Gekkio/gb-schematics/AGS-CPU-11/AGS-CPU-11.jpg

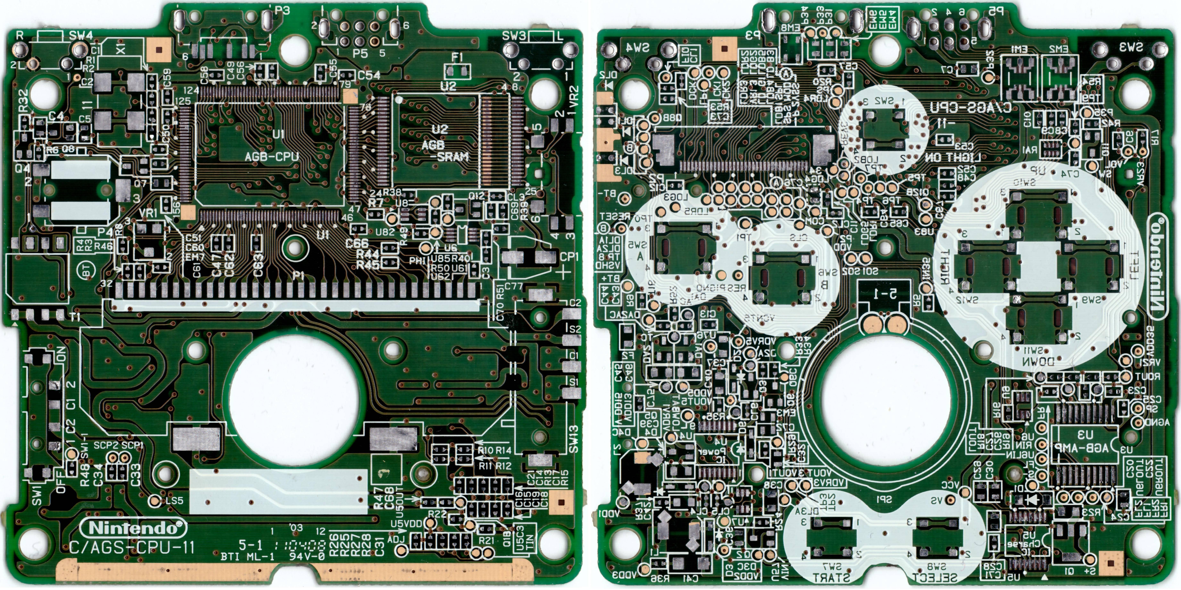
AGS-CPU-11/AGS-CPU-11.jpg
