Gekkio/gb-schematics/DC-CONV-DMG-AB.png

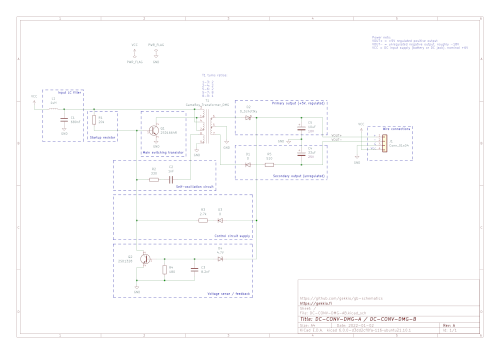
DC-CONV-DMG-AB.png
