Gekkio/gb-schematics/DMG-CPU-06/DMG-CPU-06.jpg

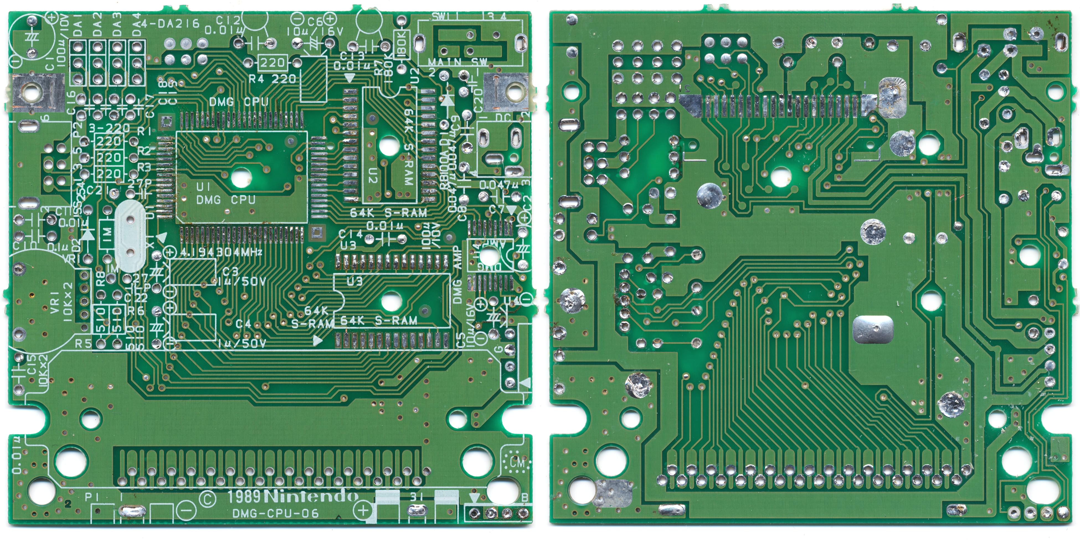
DMG-CPU-06/DMG-CPU-06.jpg
