Gekkio/gb-schematics/DMG-JACK/DMG-JACK-01.jpg

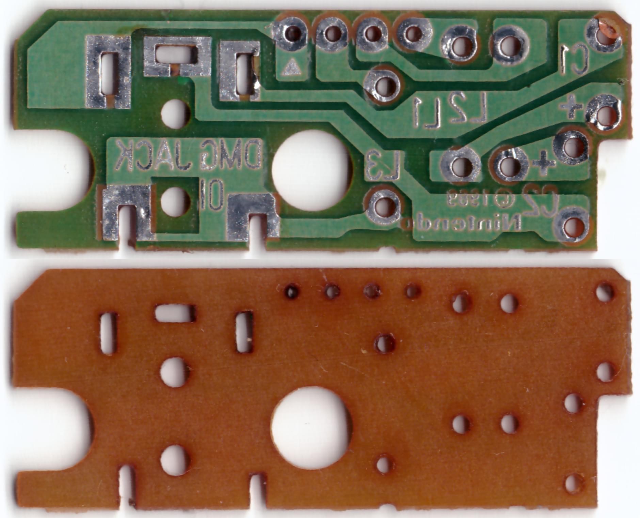
DMG-JACK/DMG-JACK-01.jpg
