Gekkio/gb-schematics/DMG-JACK/DMG-JACK-02.jpg

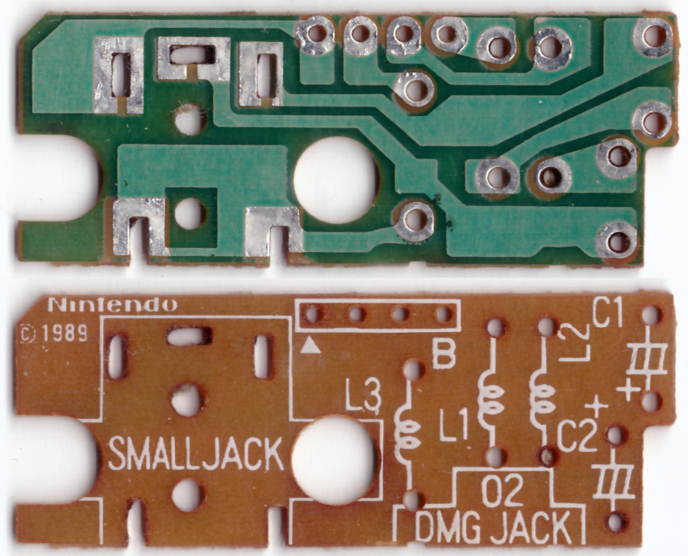
DMG-JACK/DMG-JACK-02.jpg
