Gekkio/gb-schematics/DMG-QLA-01/DMG-QLA-01.back.jpg

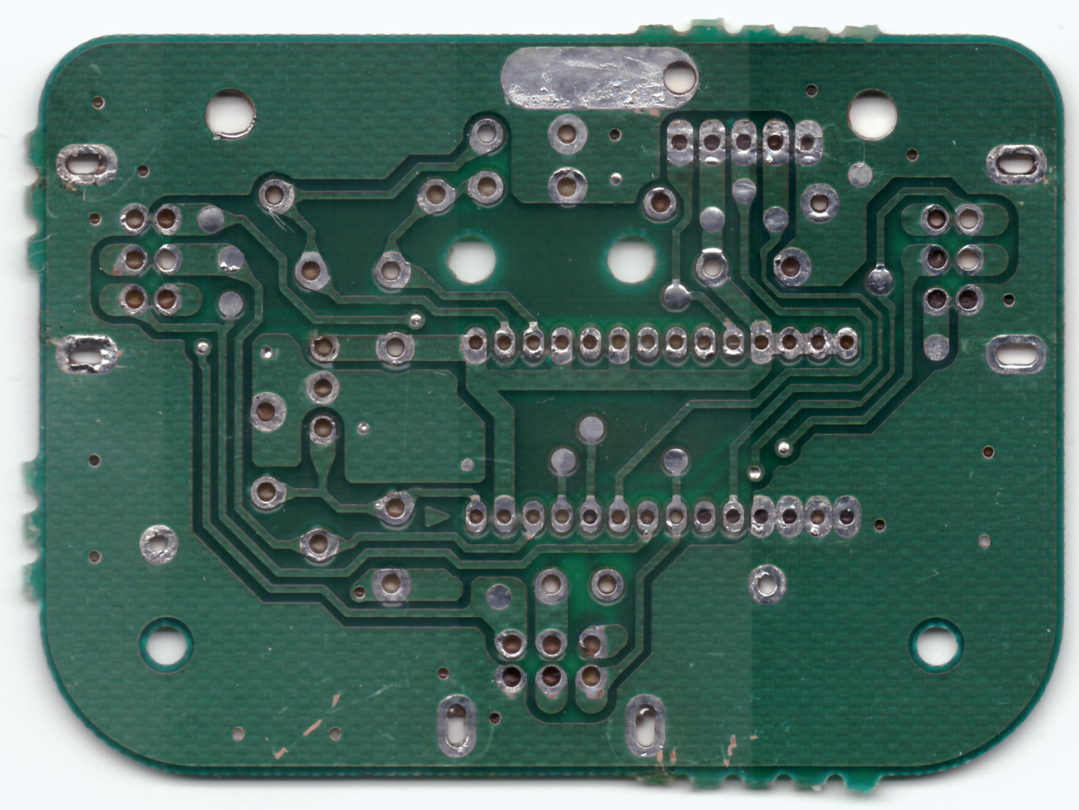
DMG-QLA-01/DMG-QLA-01.back.jpg
