Gekkio/gb-schematics/DMG-QLA-01/DMG-QLA-01.front.jpg

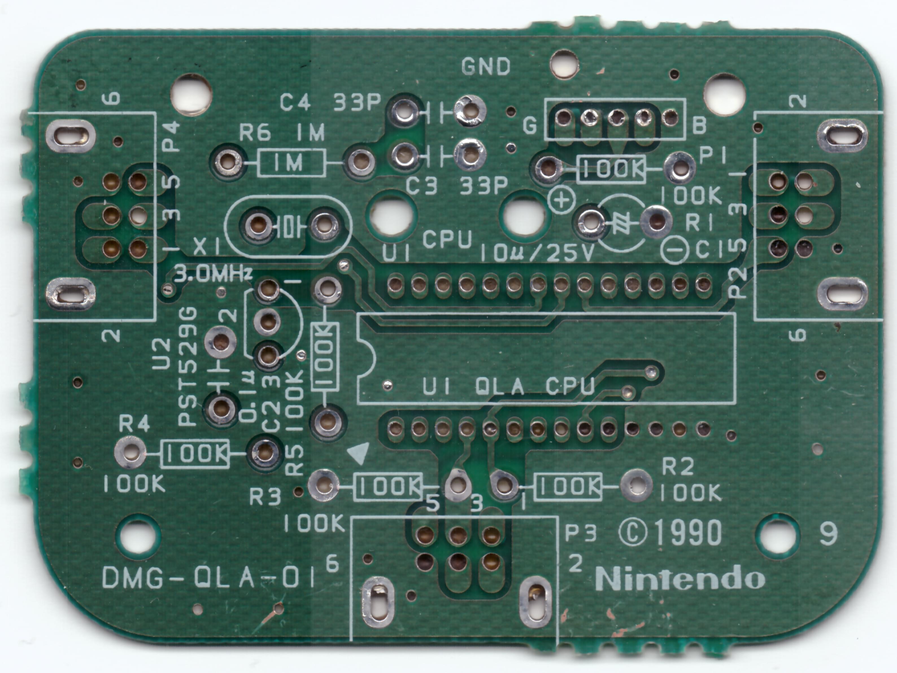
DMG-QLA-01/DMG-QLA-01.front.jpg
