Gekkio/gb-schematics/LSEP01088A1/LSEP01088A1.back_copper.jpg

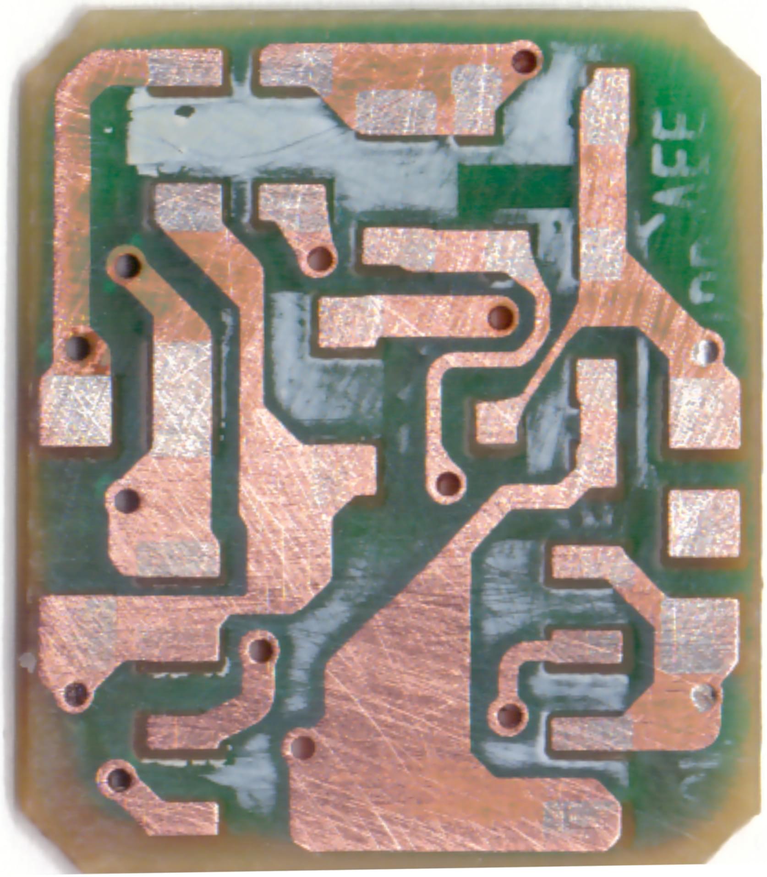
LSEP01088A1/LSEP01088A1.back_copper.jpg
