Gekkio/gb-schematics/LSEP01088A1/LSEP01088A1.front.jpg

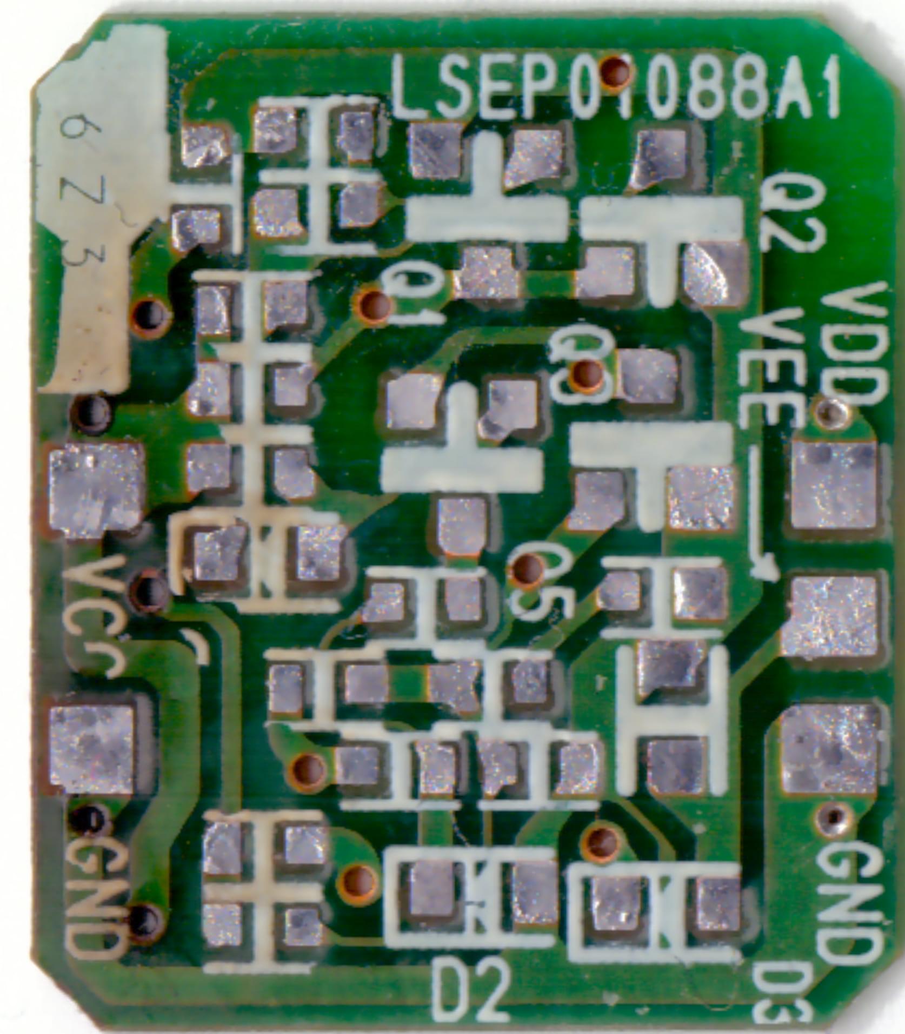
LSEP01088A1/LSEP01088A1.front.jpg
