Gekkio/gb-schematics/LSEP01120A1/LSEP01120A1.back.jpg

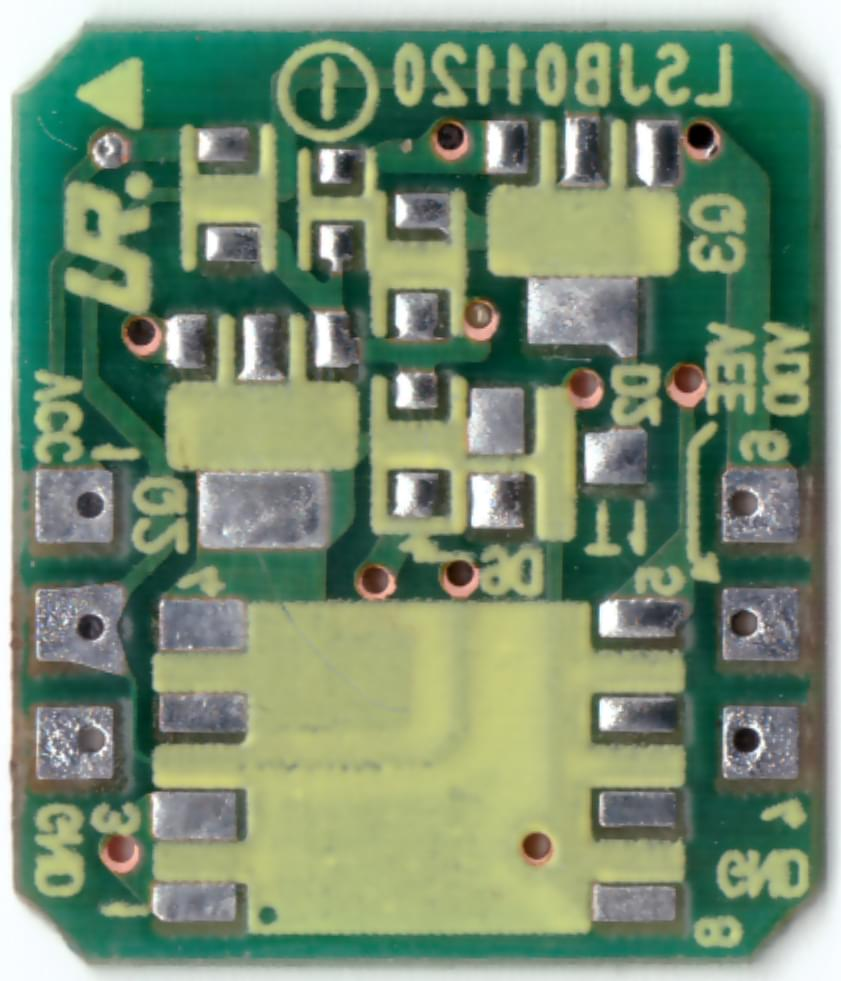
LSEP01120A1/LSEP01120A1.back.jpg
