Gekkio/gb-schematics/LSEP01120A1/LSEP01120A1.back_copper.jpg

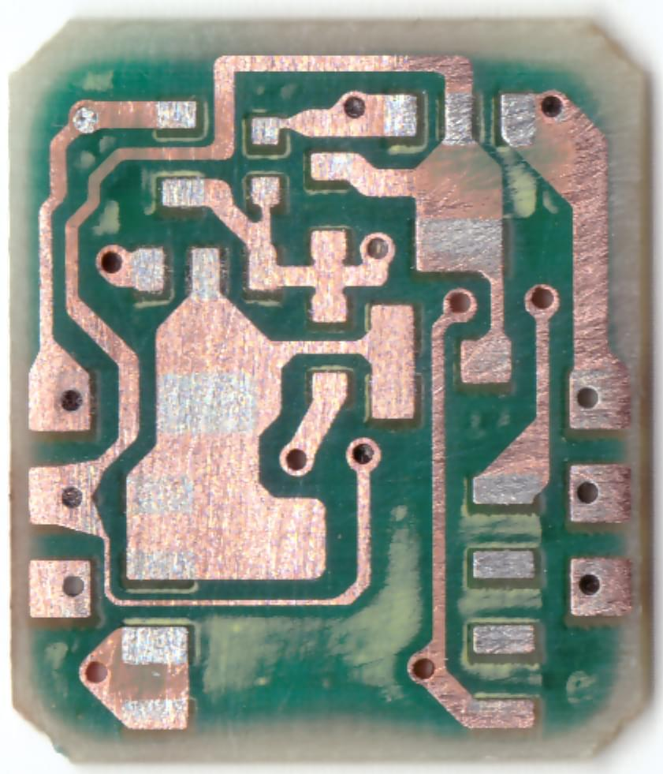
LSEP01120A1/LSEP01120A1.back_copper.jpg
