Gekkio/gb-schematics/LSEP01120A1/LSEP01120A1.front.jpg

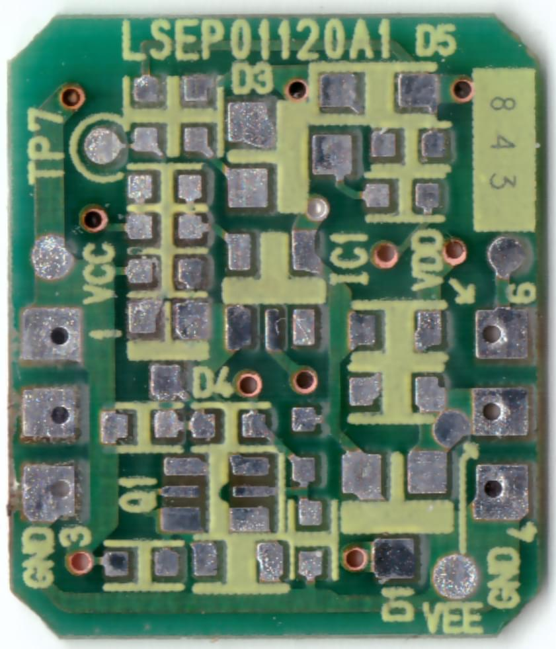
LSEP01120A1/LSEP01120A1.front.jpg
