Gekkio/gb-schematics/LSEP01120A1/LSEP01120A1.front_copper.jpg

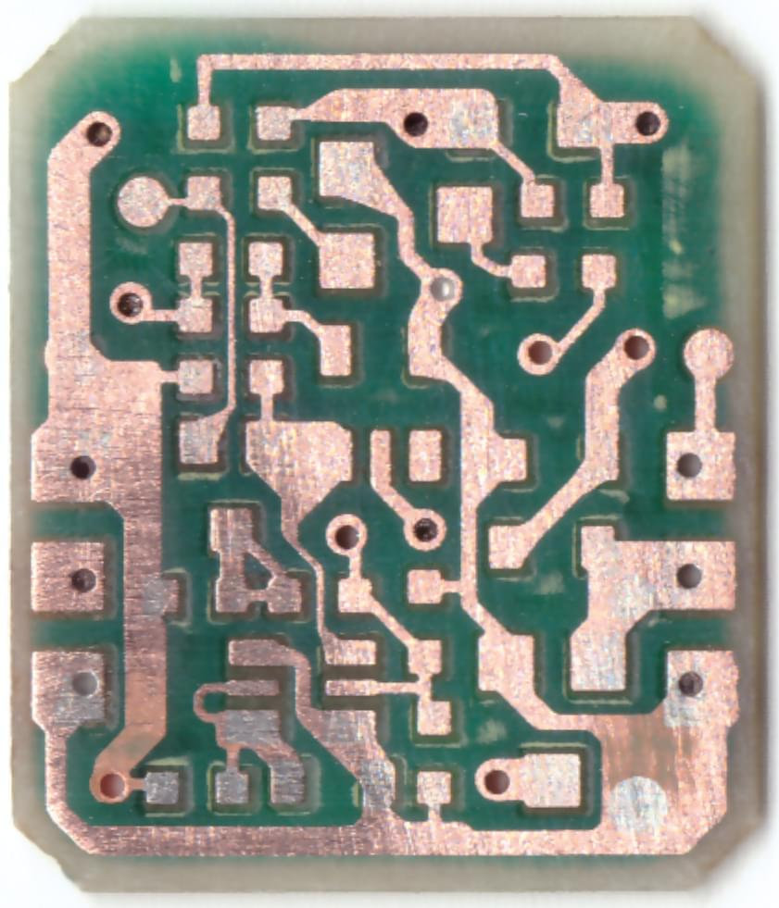
LSEP01120A1/LSEP01120A1.front_copper.jpg
