Gekkio/gb-schematics/MGB-DCDC-B/MGB-DCDC-B.back.jpg

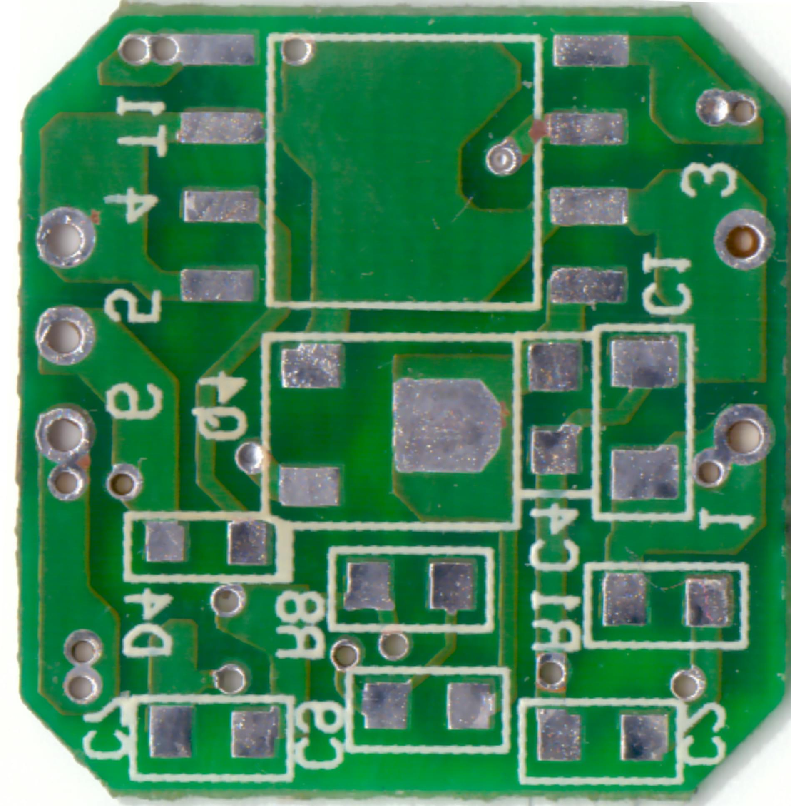
MGB-DCDC-B/MGB-DCDC-B.back.jpg
