Gekkio/gb-schematics/MGB-DCDC-B/MGB-DCDC-B.back_copper.jpg

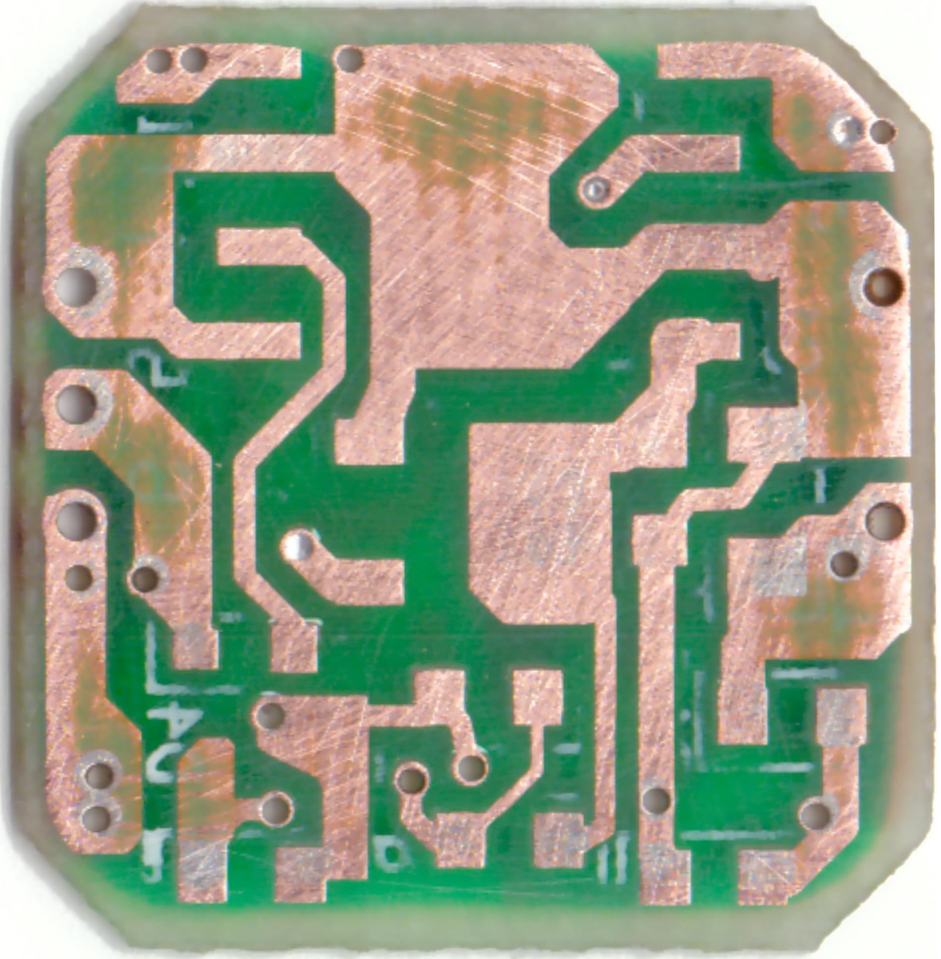
MGB-DCDC-B/MGB-DCDC-B.back_copper.jpg
