Gekkio/gb-schematics/MGB-DCDC-B/MGB-DCDC-B.front.jpg

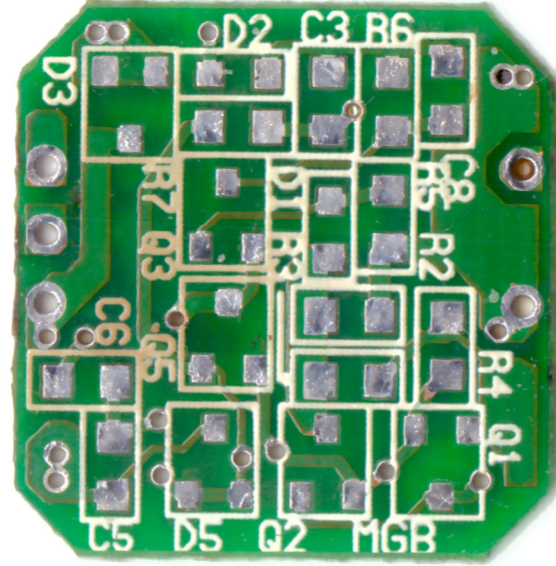
MGB-DCDC-B/MGB-DCDC-B.front.jpg
