Gekkio/gb-schematics/MGB-DCDC-B/MGB-DCDC-B.front_copper.jpg

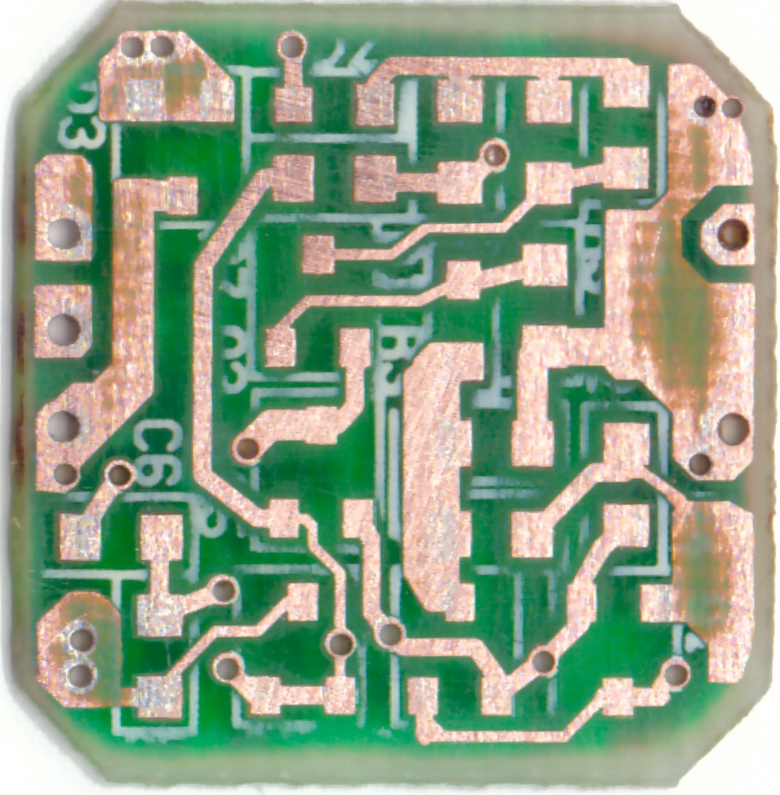
MGB-DCDC-B/MGB-DCDC-B.front_copper.jpg
