Gekkio/gb-schematics/MGB-xCPU/MGB-LCPU-02.jpg

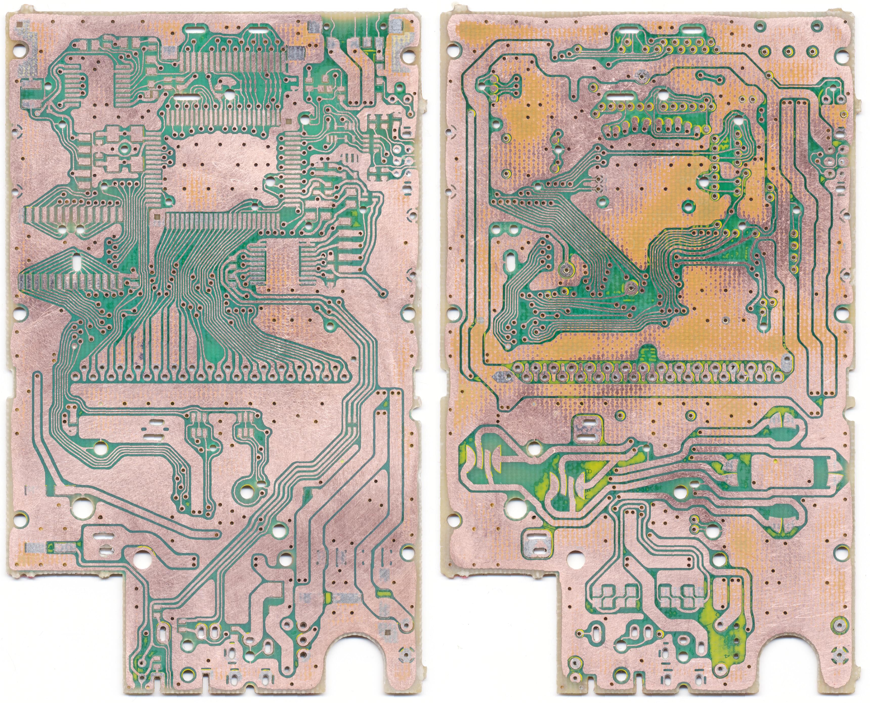
MGB-xCPU/MGB-LCPU-02.jpg
