Gekkio/gb-schematics/MGL-CPU-01/MGL-CPU-01.back.jpg

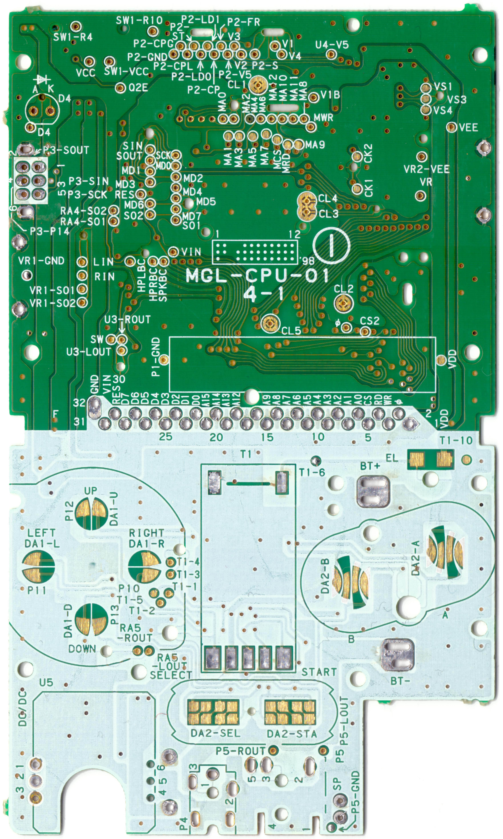
MGL-CPU-01/MGL-CPU-01.back.jpg
