Gekkio/gb-schematics/MGL-CPU-01/MGL-CPU-01.back_copper.jpg

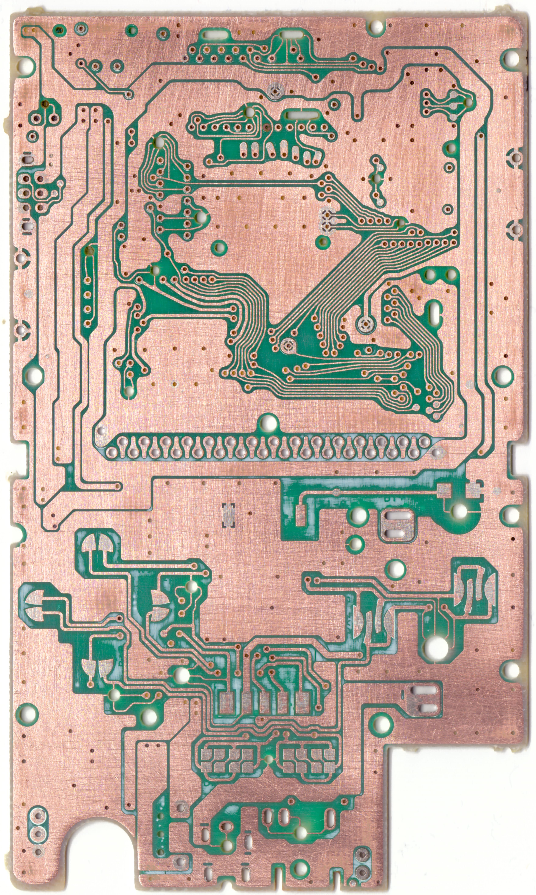
MGL-CPU-01/MGL-CPU-01.back_copper.jpg
