Gekkio/gb-schematics/MGL-CPU-01/MGL-CPU-01.front.jpg

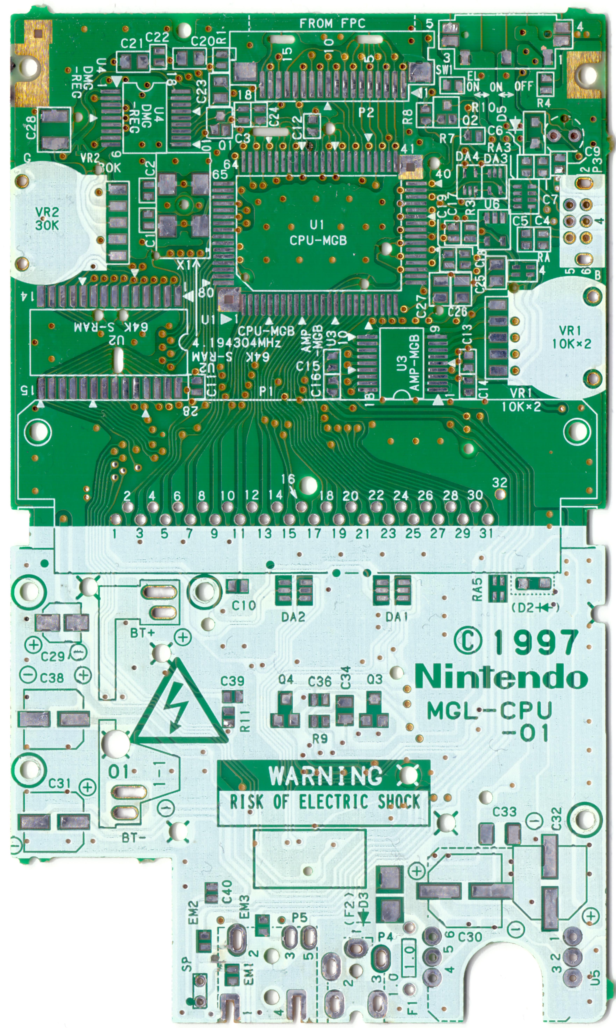
MGL-CPU-01/MGL-CPU-01.front.jpg
