Gekkio/gb-schematics/SGB-R-xx_SGB-N-xx/SGB-R-10.back.jpg

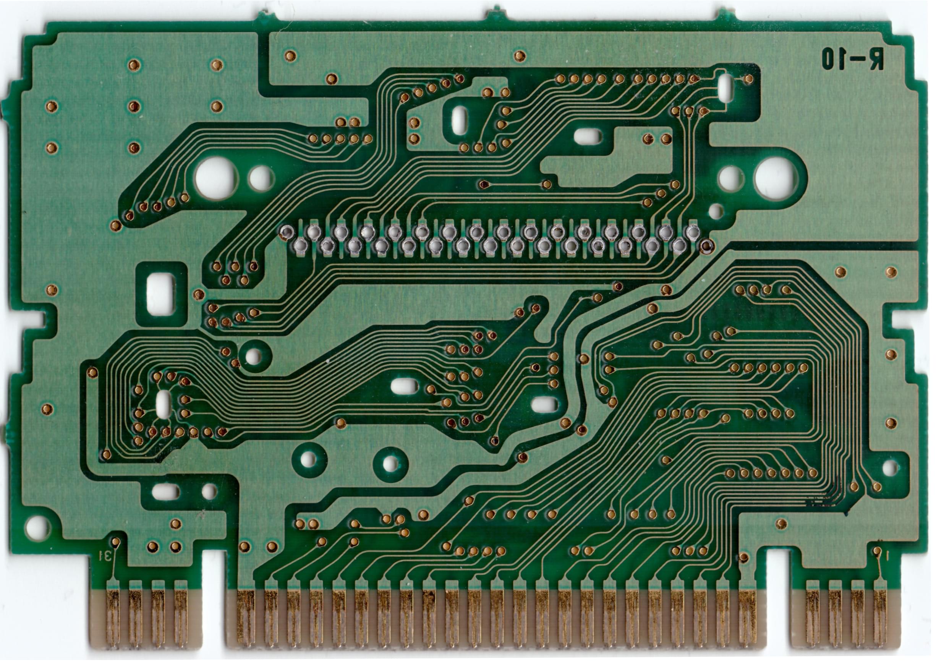
SGB-R-xx_SGB-N-xx/SGB-R-10.back.jpg
