Gekkio/gb-schematics/DC-CONV2-DMG-D/dc_conv2_dmg_d_components.jpg

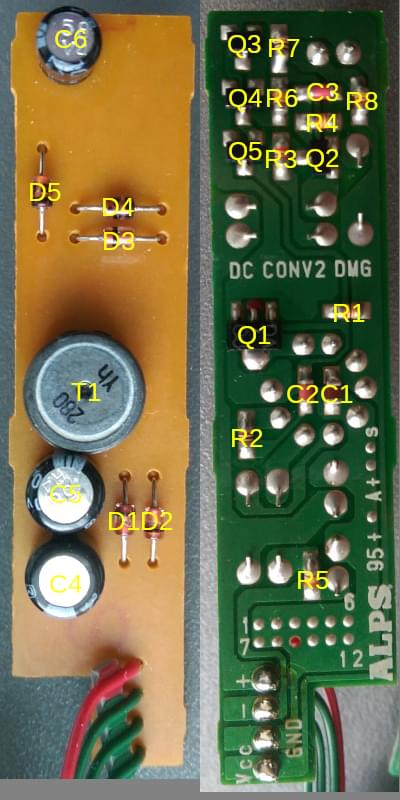
DC-CONV2-DMG-D/dc_conv2_dmg_d_components.jpg
