Gekkio/gb-schematics/DC-CONV-DMG-AB/dc_conv_dmg_b_components.jpg

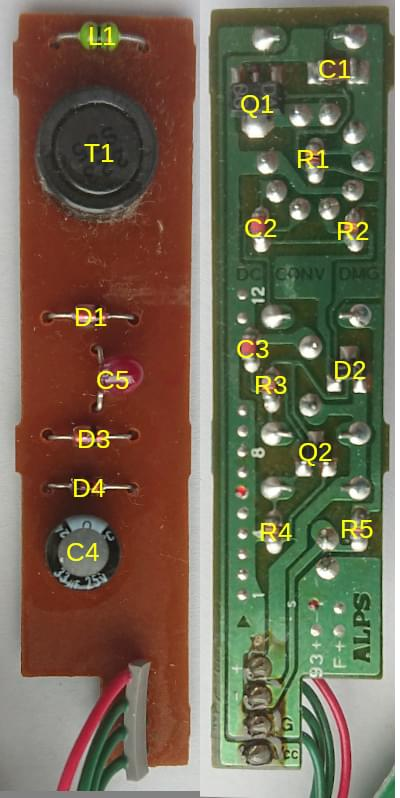
DC-CONV-DMG-AB/dc_conv_dmg_b_components.jpg
