Gekkio/gb-schematics/DC-CONV-DMG-C/dc_conv_dmg_c_components.jpg

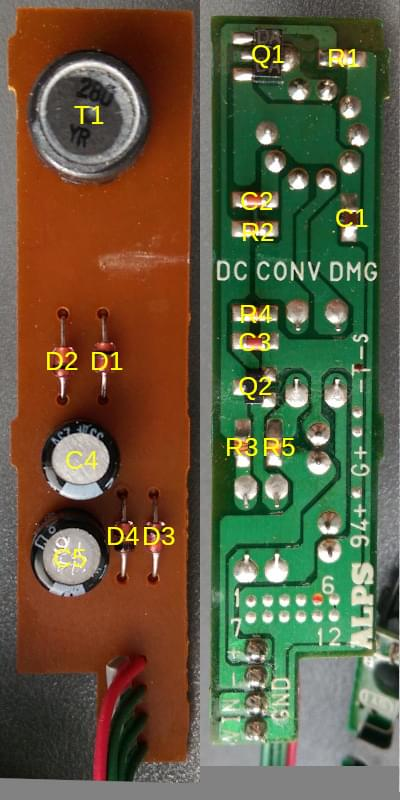
DC-CONV-DMG-C/dc_conv_dmg_c_components.jpg
