Gekkio/gb-schematics/LSEP01088A1/LSEP01088A1_components.jpg

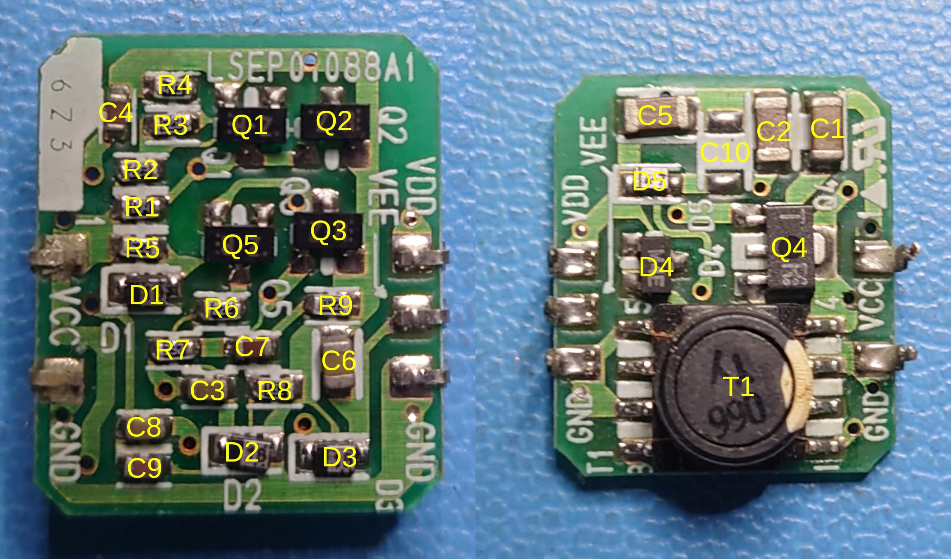
LSEP01088A1/LSEP01088A1_components.jpg
