Gekkio/gb-schematics/MGL-CPU-01/CHANGELOG.markdown

# Change Log

## Unreleased

## Rev B - 2023-08-22

### Changed

- Change power switch symbol slightly to (hopefully) better clarify connection is maintained between the two possible pin 2-3 connection states

## Rev B - 2023-07-18

### Added

- Information about DC jack, input power, battery type
- Proper symbol for VR2

### Changed

- Upgrade to KiCad 7.0 file formats
- Remove Farad units since it's obvious (e.g. 100nF -> 100n)
- Tiny fixes to potentiometer symbols

## Rev A - 2022-03-19

### Added

- Initial release
