Gekkio/gb-schematics/DMG-LCD-06/CHANGELOG.markdown

# Change Log

## [Unreleased]

## Rev C - 2023-07-18

### Added

- Proper symbol for VR1

### Changed

- Upgrade to KiCad 7.0 file formats
- Remove Farad units since it's obvious (e.g. 100nF -> 100n)
- Tiny fixes to potentiometer symbols

## Rev B - 2022-01-02

### Changed

- Upgraded to KiCad 6.0 file formats

## Rev A - 2021-09-01

### Added

- Initial release
