Gekkio/gb-schematics/LSEP01088A1/CHANGELOG.markdown

# Change Log

## [Unreleased]

## Rev B - 2023-07-18

### Changed

- Upgrade to KiCad 7.0 file formats
- Remove Farad units since it's obvious (e.g. 100nF -> 100n)

## Rev A - 2022-05-30

### Added

- Initial release
