Gekkio/gb-schematics/DC-CONV-DMG-AB/CHANGELOG.markdown

# Change Log

## [Unreleased]

## Rev C - 2023-07-18

### Changed

- Upgrade to KiCad 7.0 file formats
- Remove Farad/Henry units since it's obvious (e.g. 100nF -> 100n)

## Rev B - 2022-01-12

### Added

- Added value for transformer T1
- Added value for schottky D2

### Changed

- Tidied up wires around Q2

## Rev A - 2022-01-02

### Added

- Initial release
