Gekkio/gb-schematics/DMG-QLA-01/CHANGELOG.markdown

# Change Log

## Rev A - 2024-05-18

### Added

- Initial release
