Gekkio/gb-schematics/SGB-R-xx_SGB-N-xx/CHANGELOG.markdown

# Change Log

## [Unreleased]

## Rev A - 2023-11-21

### Added

- Initial release
