Gekkio/gb-schematics/DMG-CPU-06/CHANGELOG.markdown

# Change Log

## [Unreleased]

## Rev B - 2023-07-18

### Changed

- Tiny fixes to potentiometer symbols

## Rev A - 2023-07-11

### Added

- Initial release
