Gekkio/gb-schematics/(threads)

Thread 1 (2021-02-02):

Cant view

milo123milo, 2021-02-02:
Hi, when i open AGS-CPU-11.kicad_pcb i cant see anything. It is just blank. I tried opening it into different softwares but nothing. Am i doing smoethign wrong? Thanks!

Gekkio, 2021-02-24:
This repository only has schematics and no board layout files. The file you're trying to open is just a dummy empty board layout file generated by KiCad

Closed 2022-02-20.

Thread 2 (2021-07-18):

AGS-CPU-11 - R7 misplaced in schematic

Zekfoo, 2021-07-18:
On page 5 of the schematic, the R7 pullup resistor is shown to be connected to the SC line between RA1 and EM2.

However, the board scans show that R7 is placed right at the CPU pin.

The schematic should be corrected to have R7 placed on the CPU pin side of the SC line.

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

Closed 2021-07-26.

Thread 3 (2021-07-20):

MGB Contrast Wheel

George304, 2021-07-20:
Gekkio,

I was checking your schematic for the MGB. I’m new to this so I don’t understand that much. I have an MGB and the contrast wheel doesn’t work. It was working before but not anymore. I need your help trying to diagnose what could it be. I change the contrast wheel with a new one but the issue persist.

Respectfully,

George

Gekkio, 2022-02-20:
Hello,

This is not really the best place to ask for repair/modding/diagnostics help. I recommend the [/r/gameboy reddit](https://www.reddit.com/r/Gameboy/), or even better, its Discord server (https://discord.gg/gameboy). There are many knowledgeable people there (including me), and it's much easier to have a discussion there instead of here in a random Github issue very few people will read :slightly_smiling_face:

Closed 2022-02-20.
