Gekkio/gb-schematics/DMG-QLA-01/schematic/DMG-QLA-01.pdf

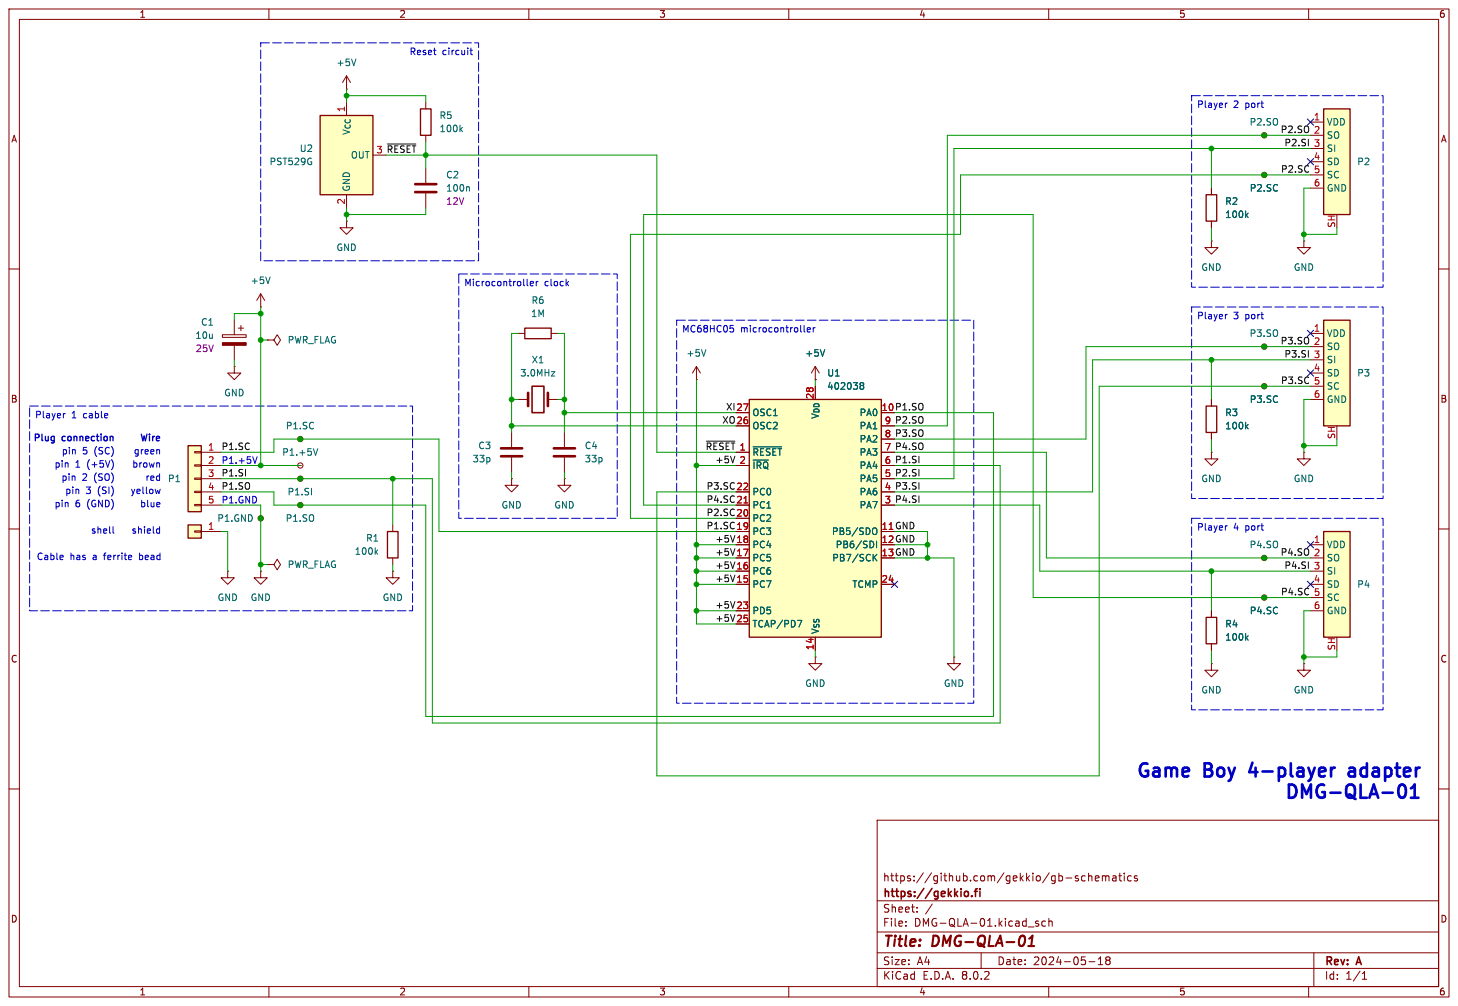
[picture p50: page 1]

shell Cable has a ferrite bead

https://github.com/gekkio/gb-schematics
File: DMG-QLA-01.kicad_sch Sheet: / https://gekkio.fi

Id: 1/1 Title: DMG-QLA-01
