Gekkio/gb-schematics/LSEP01120A1/schematic/LSEP01120A1.pdf

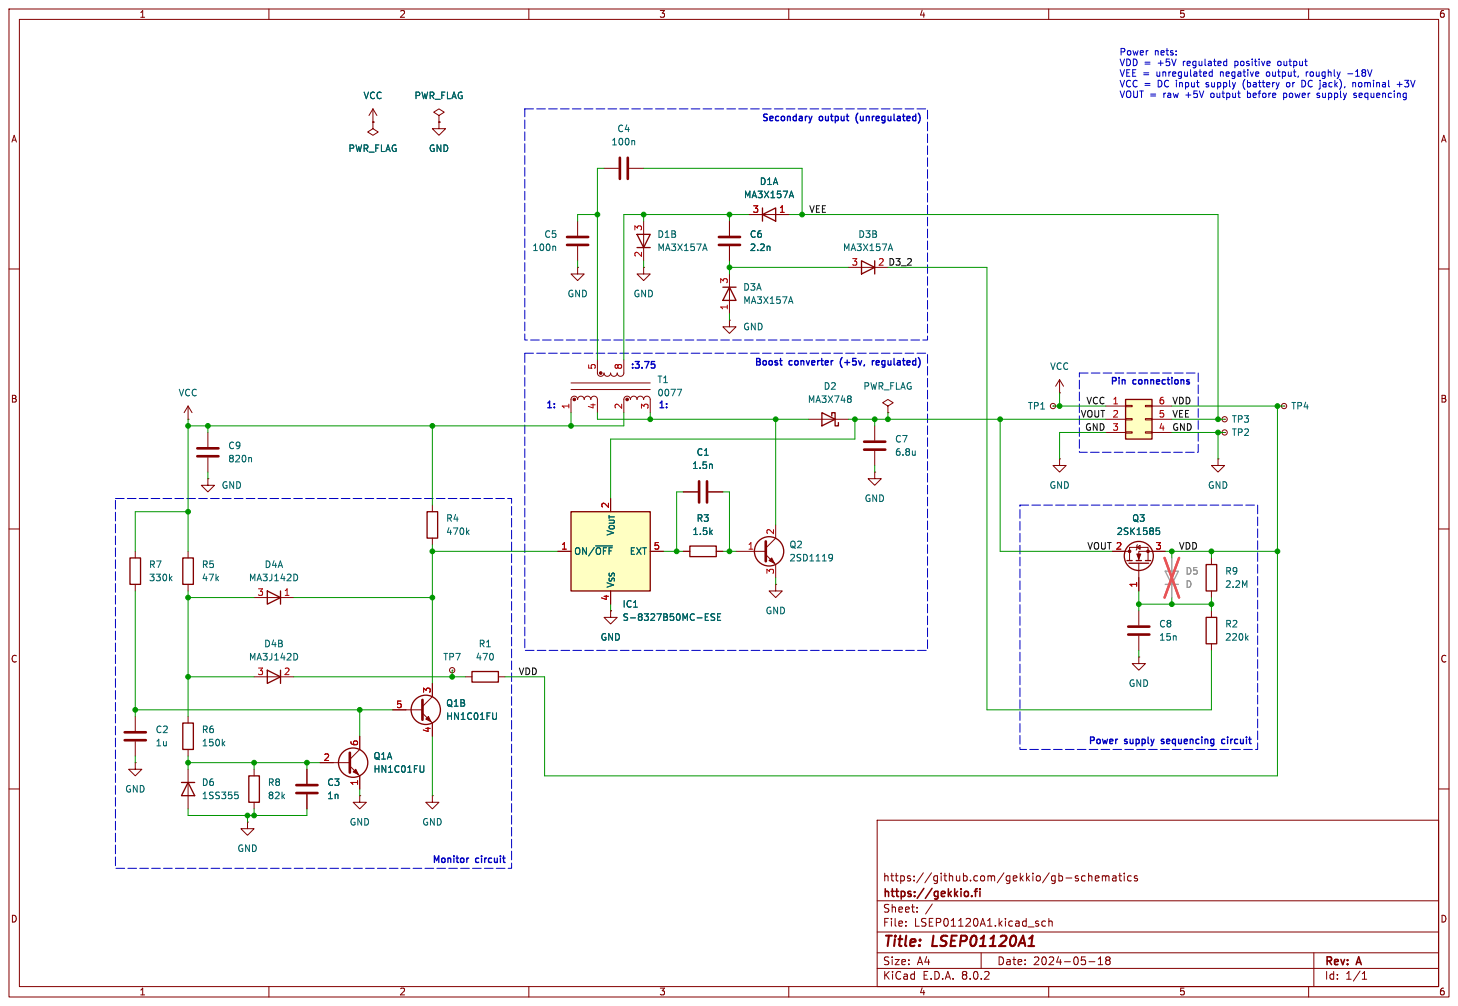
[picture p51: page 1]

VOUT = raw +5V output before power supply sequencing Pin connections

https://github.com/gekkio/gb-schematics R8

File: LSEP01120A1.kicad_sch Sheet: / https://gekkio.fi
