Gekkio/gb-schematics/SGB-R-xx_SGB-N-xx/schematic/SGB-R-xx_SGB-N-xx.pdf

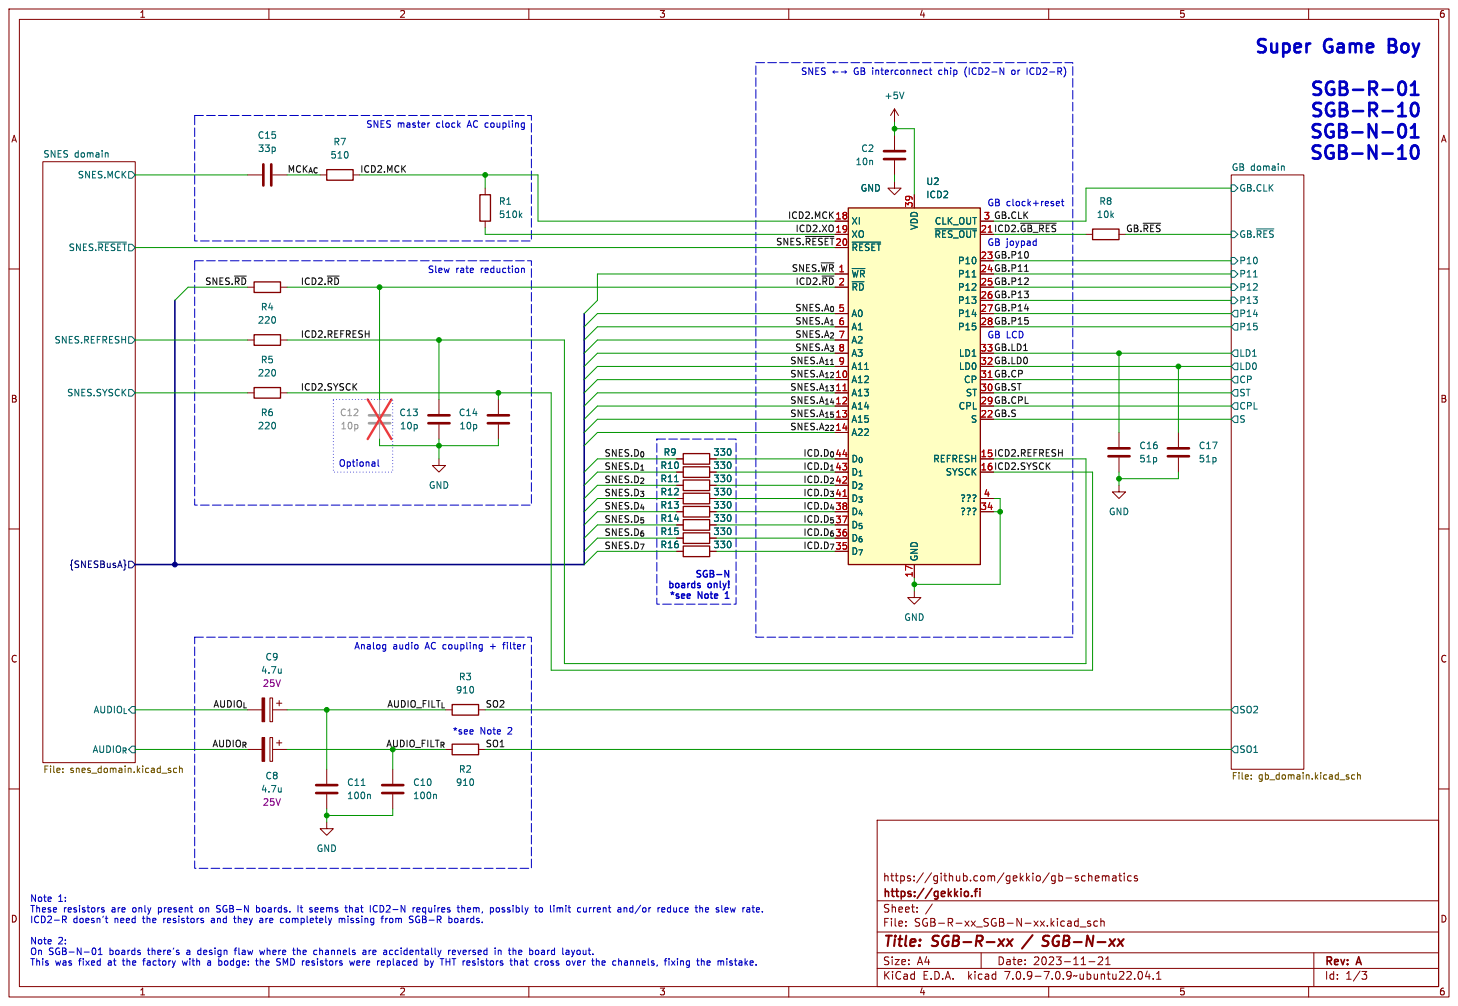
[picture p52: page 1]

{SNESBusA} SNES domain
SNES.~{RESET} SNES.SYSCK

SGB-R-01
SGB-R-10
SGB-N-01
SGB-N-10
GB.CLK GB.~{RES} CPL STCP

GB clock+reset SGB-N

ICD2.SYSCK GB.CP GB.S

boards only! *see Note 1

https://github.com/gekkio/gb-schematics
File: SGB-R-xx_SGB-N-xx.kicad_sch Sheet: / https://gekkio.fi

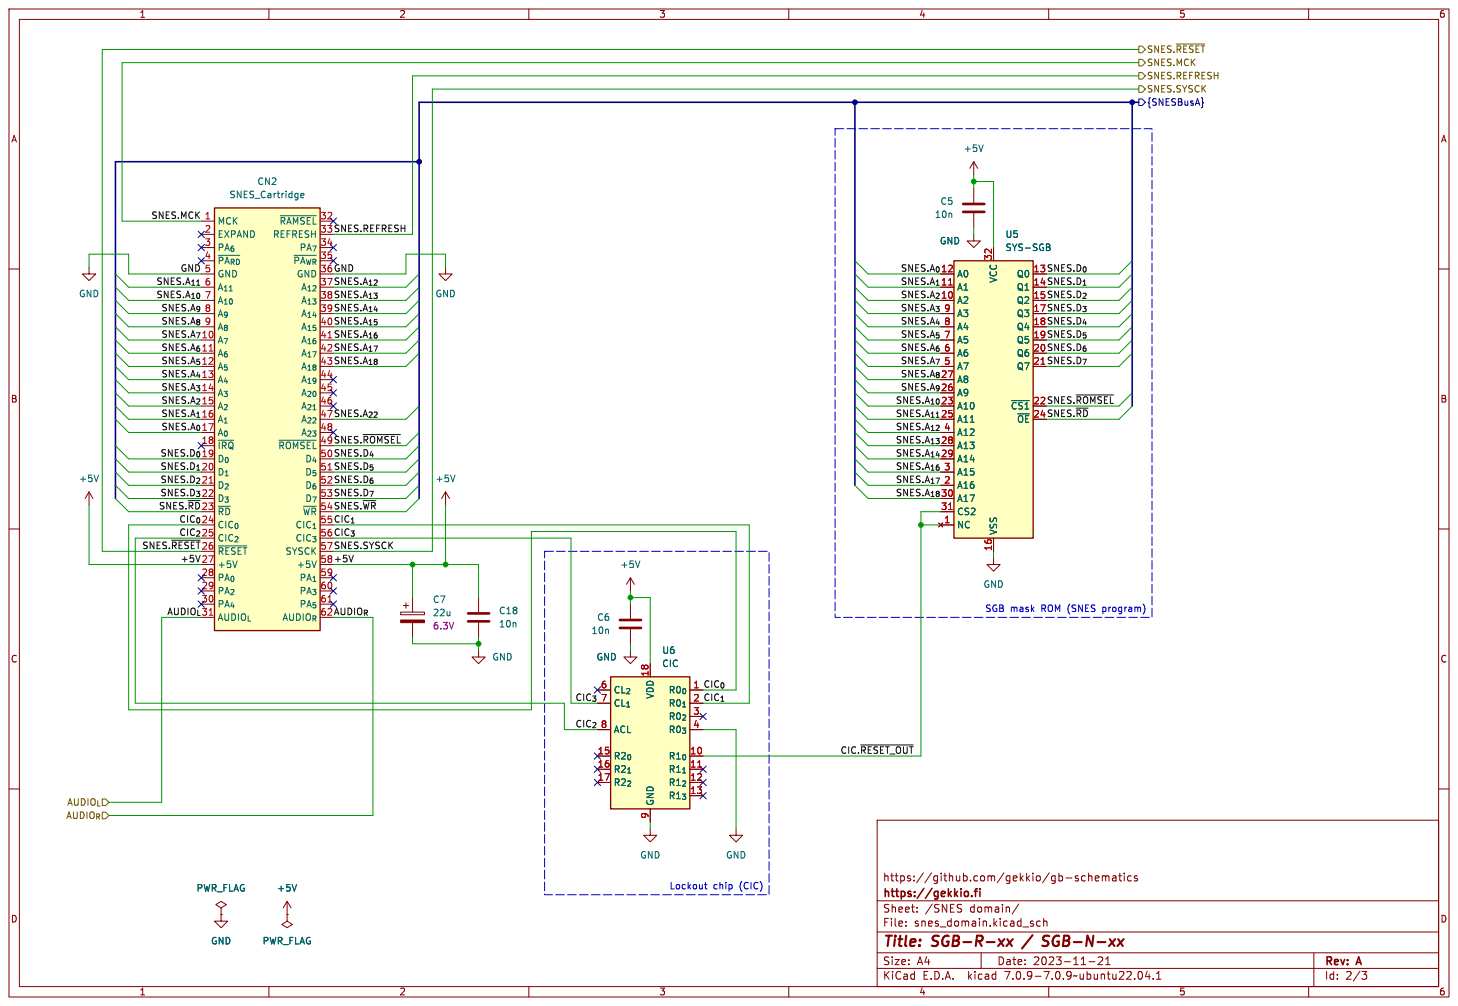
[picture p53: page 2]

https://github.com/gekkio/gb-schematics GND
CIC_{3}

File: snes_domain.kicad_sch Sheet: /SNES domain/ https://gekkio.fi

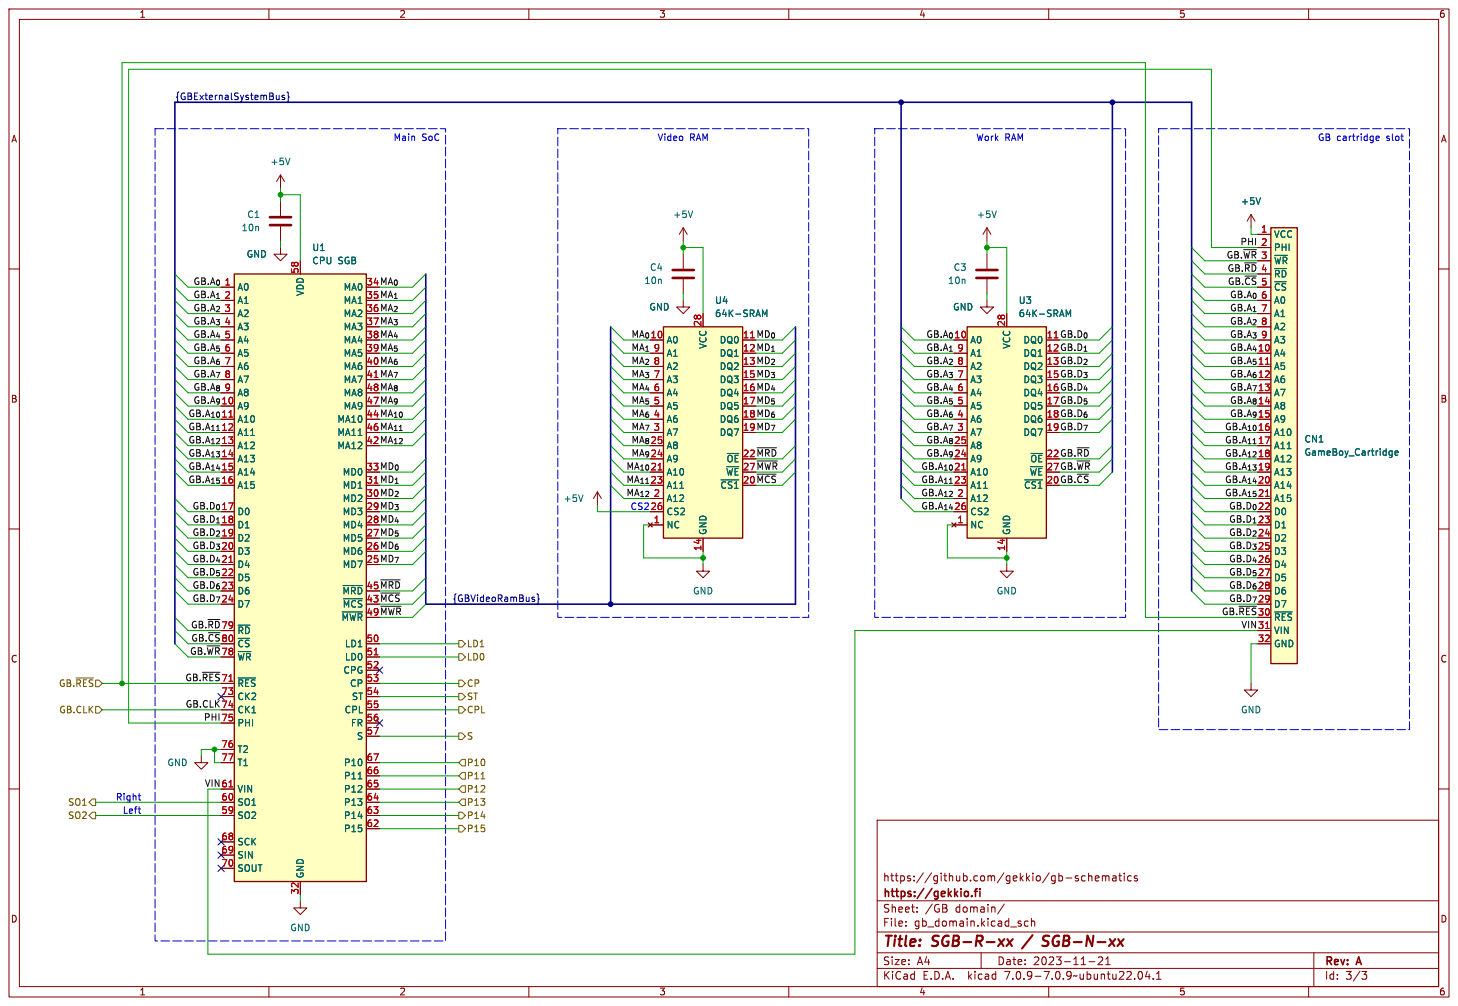
[picture p54: page 3]

GB.D_{3} PHI GB.D_{2}
GB.D_{7} GB.CLK GB.~{RD}

File: gb_domain.kicad_sch Sheet: /GB domain/ https://gekkio.fi
