Gekkio/gb-schematics/MGL-CPU-01/schematic/MGL-CPU-01.pdf

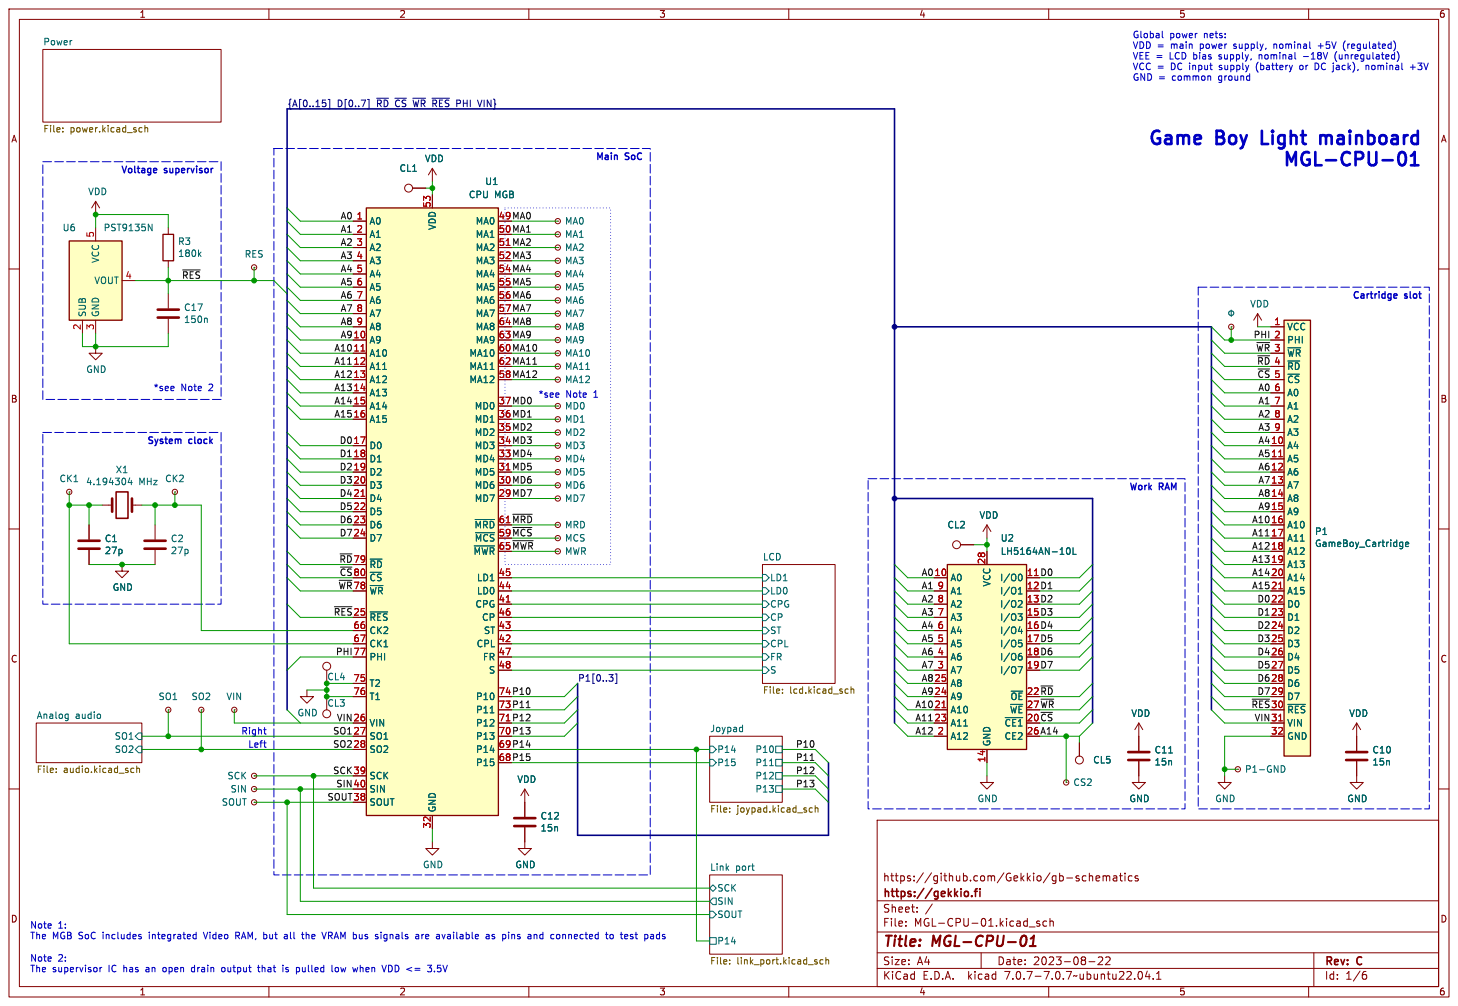
[picture p55: page 1]

Game Boy Light mainboard

P1[0..3] PHI ~{WR} D2 SO1 A15D4 D5 D6 D1 Voltage supervisor

File: MGL-CPU-01.kicad_sch Sheet: / https://gekkio.fi

Id: 1/6 Title: MGL-CPU-01

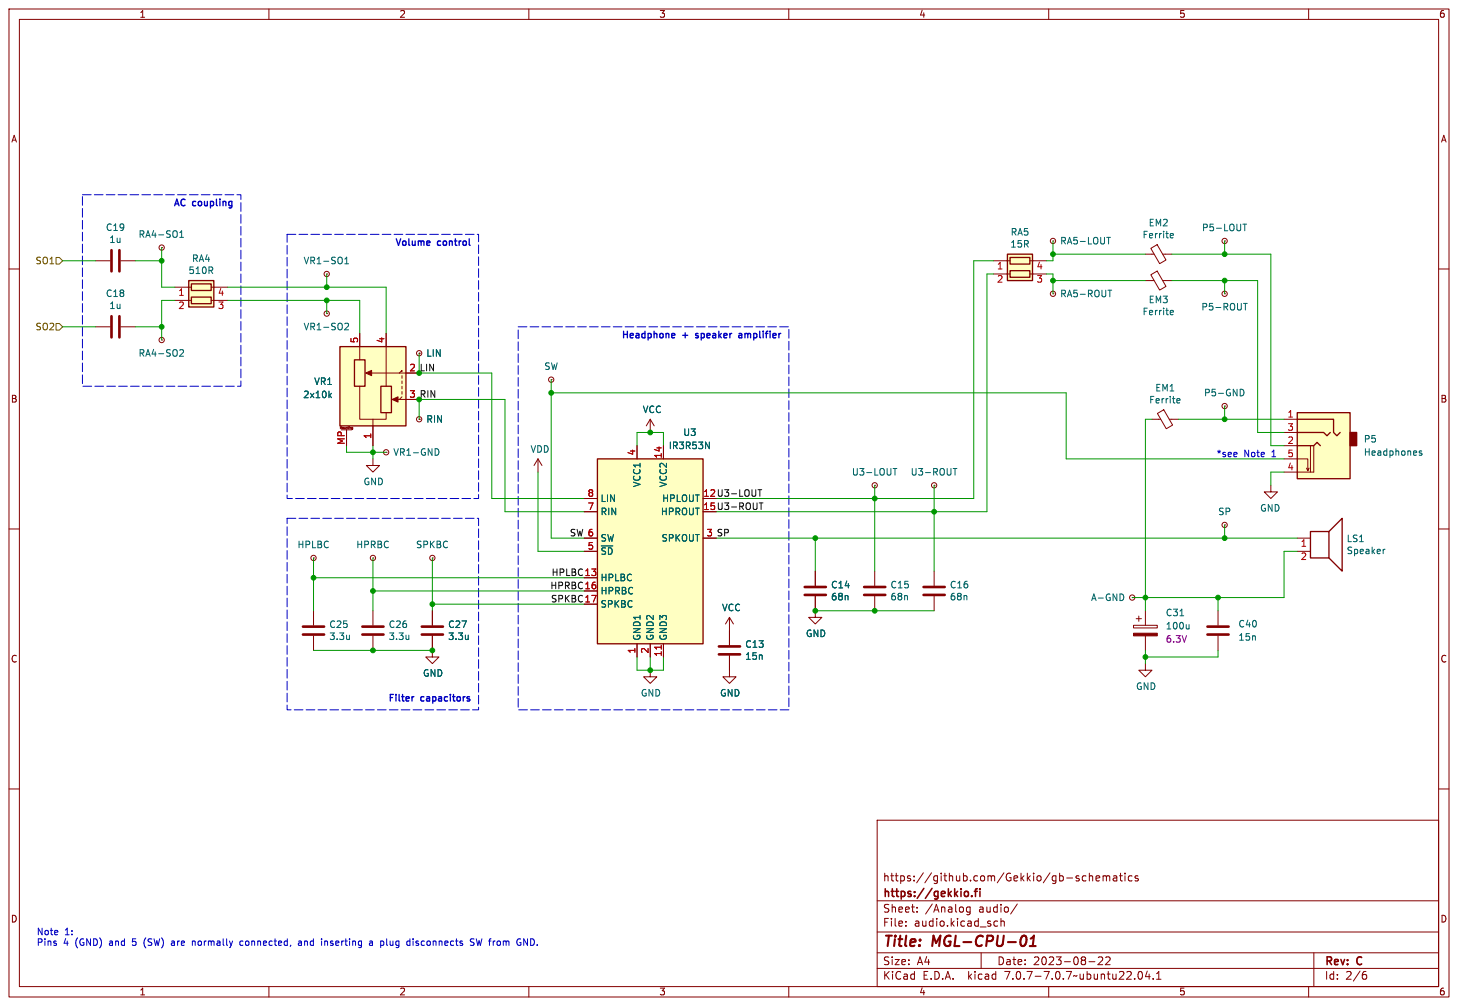
[picture p56: page 2]

AC coupling
Volume control Filter capacitors

1 GND3 11 HPLOUT 12 HPLBC 13 VCC2 14 HPROUT 15 HPRBC 16 SPKBC 17 GND2

Id: 2/6 Title: MGL-CPU-01

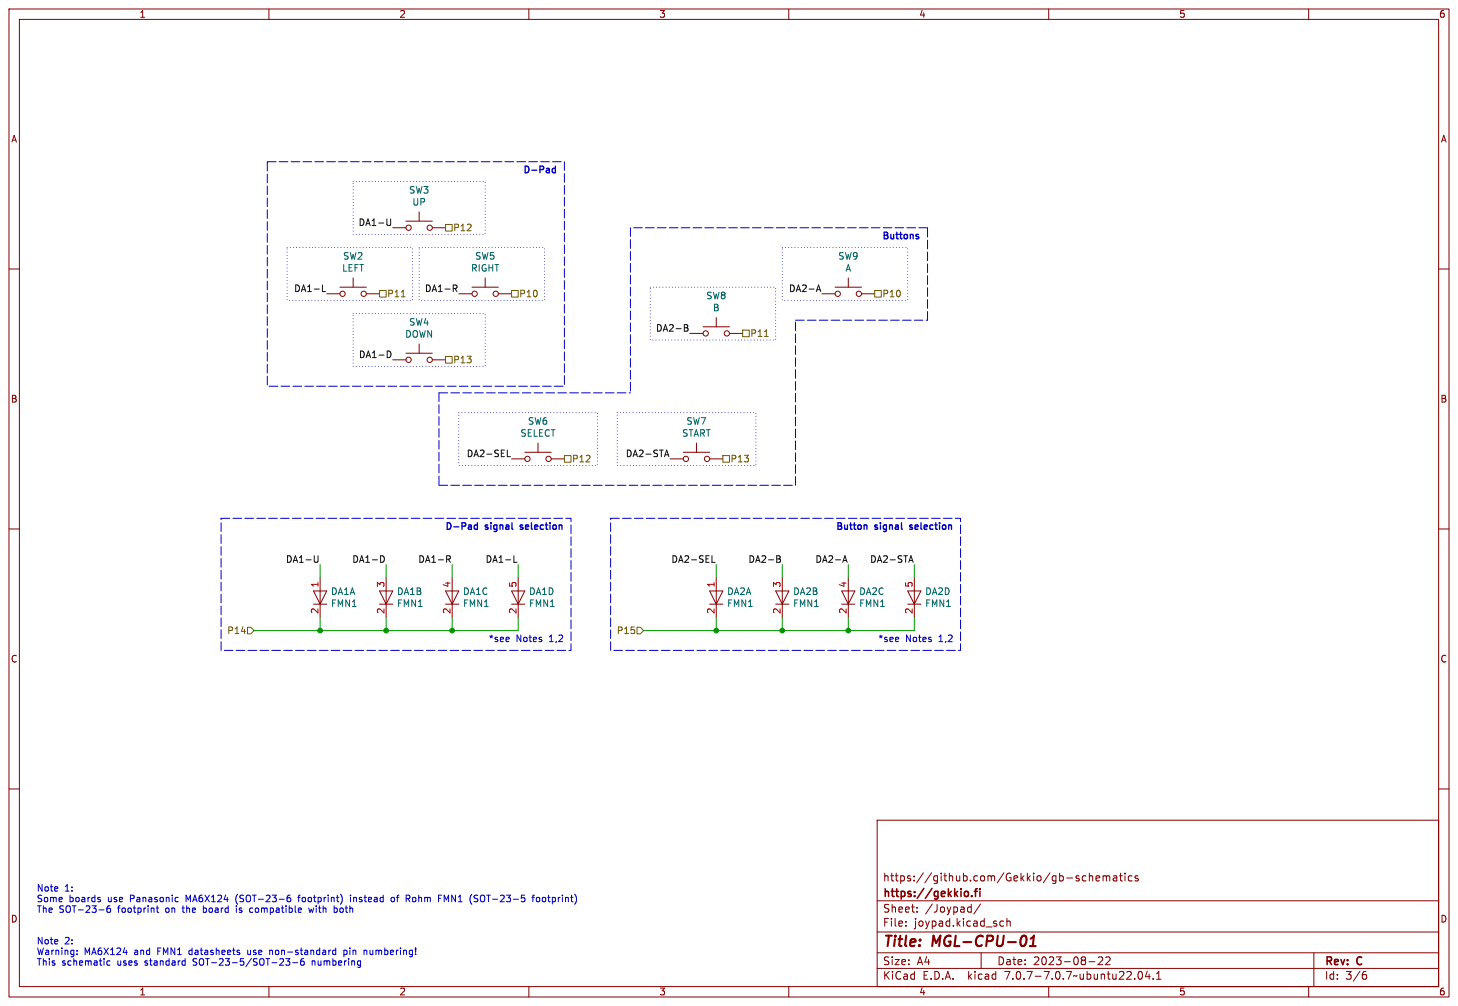
[picture p57: page 3]

*see Notes 1,2 Button signal selection D-Pad

https://github.com/Gekkio/gb-schematics
https://gekkio.fi
File: joypad.kicad_sch Sheet: /Joypad/
Id: 3/6 Title: MGL-CPU-01

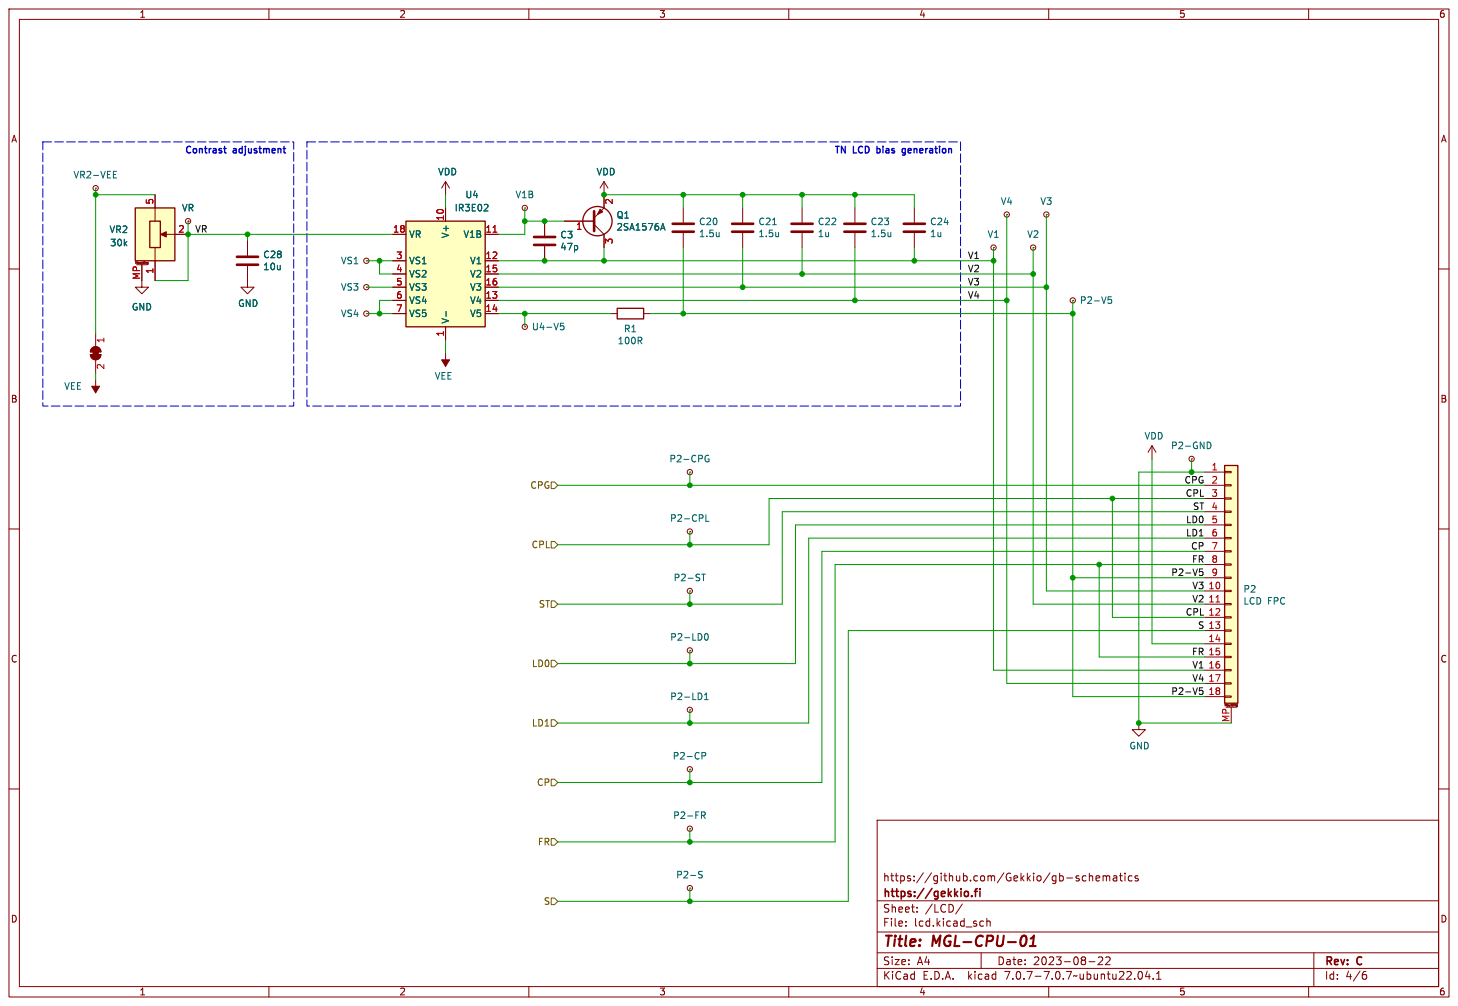
[picture p58: page 4]

V4ST CPG LD1V1 CPLFR 7 | Mounting 1
2 3

10
11
12
13
14

https://github.com/Gekkio/gb-schematics
File: lcd.kicad_sch Sheet: /LCD/ https://gekkio.fi

Id: 4/6 Title: MGL-CPU-01

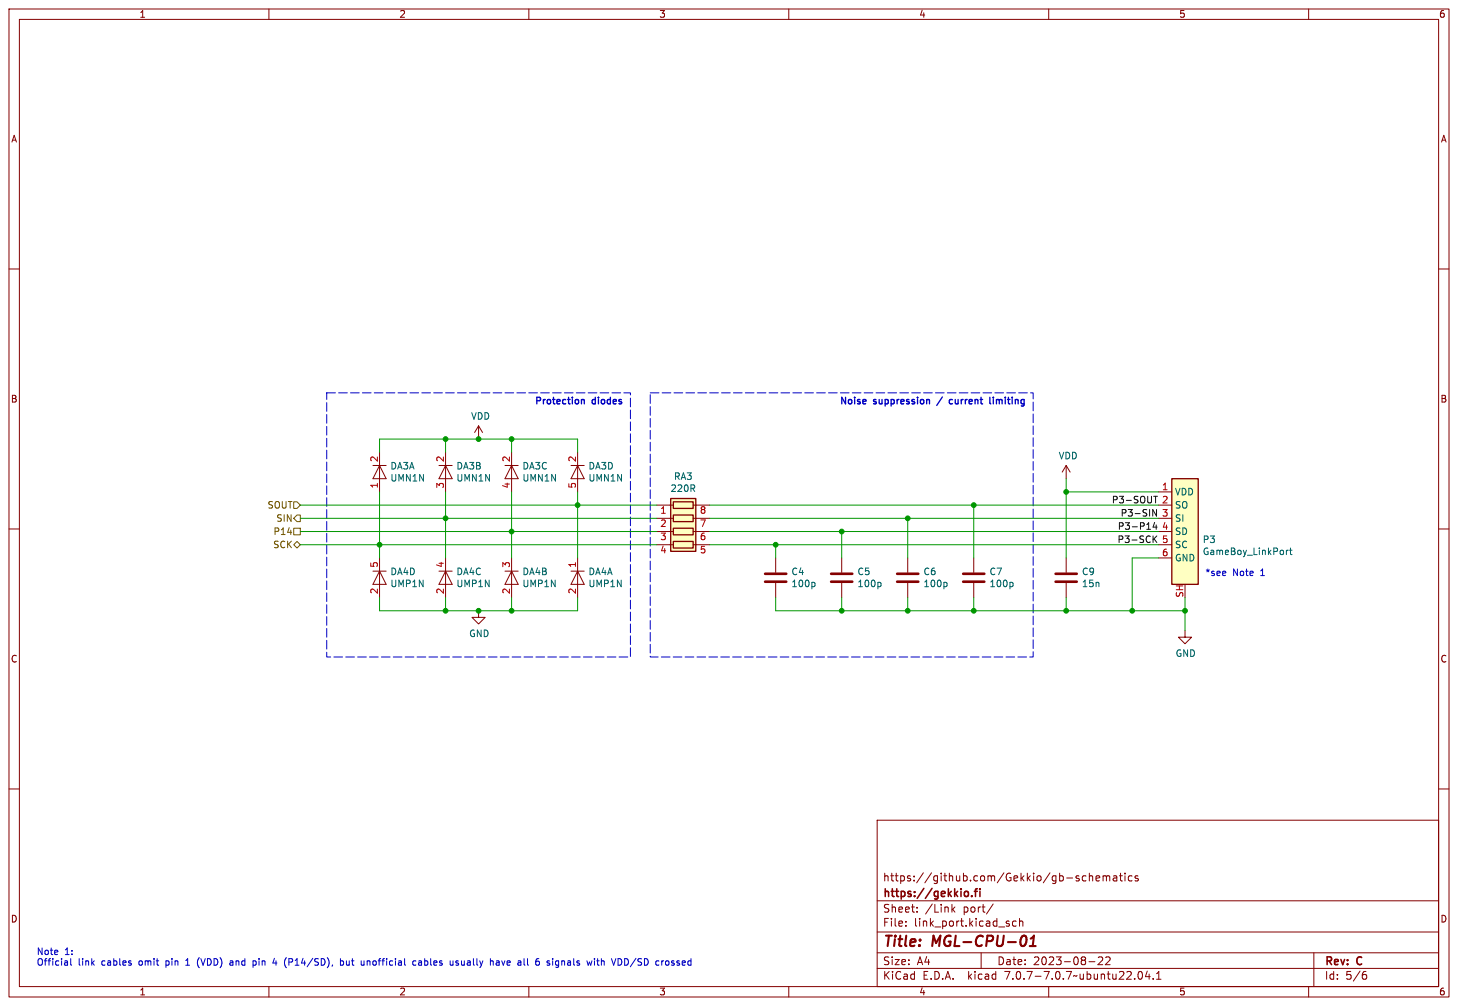
[picture p59: page 5]

*see Note 1 Noise suppression / current limiting

7 | P3GameBoy_LinkPort SIN

https://github.com/Gekkio/gb-schematics GND

https://gekkio.fi
Id: 5/6 Title: MGL-CPU-01

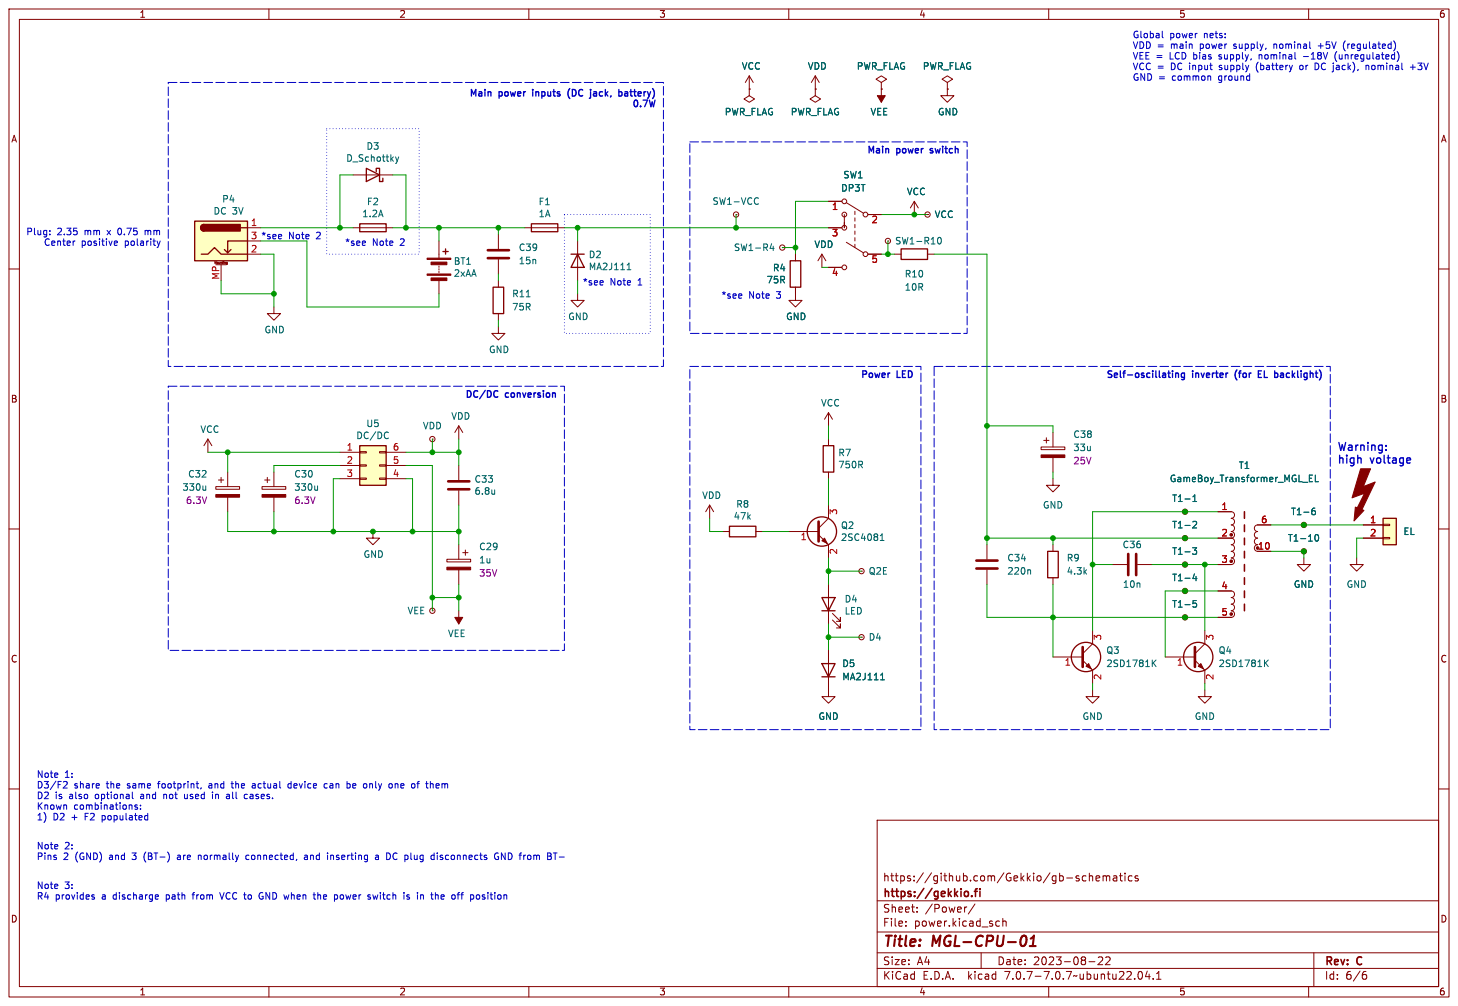
[picture p60: page 6]

https://github.com/Gekkio/gb-schematics
File: power.kicad_sch Sheet: /Power/ https://gekkio.fi

Id: 6/6 Title: MGL-CPU-01
