Gekkio/gb-schematics/MGB-DCDC-B/schematic/MGB-DCDC-B.pdf

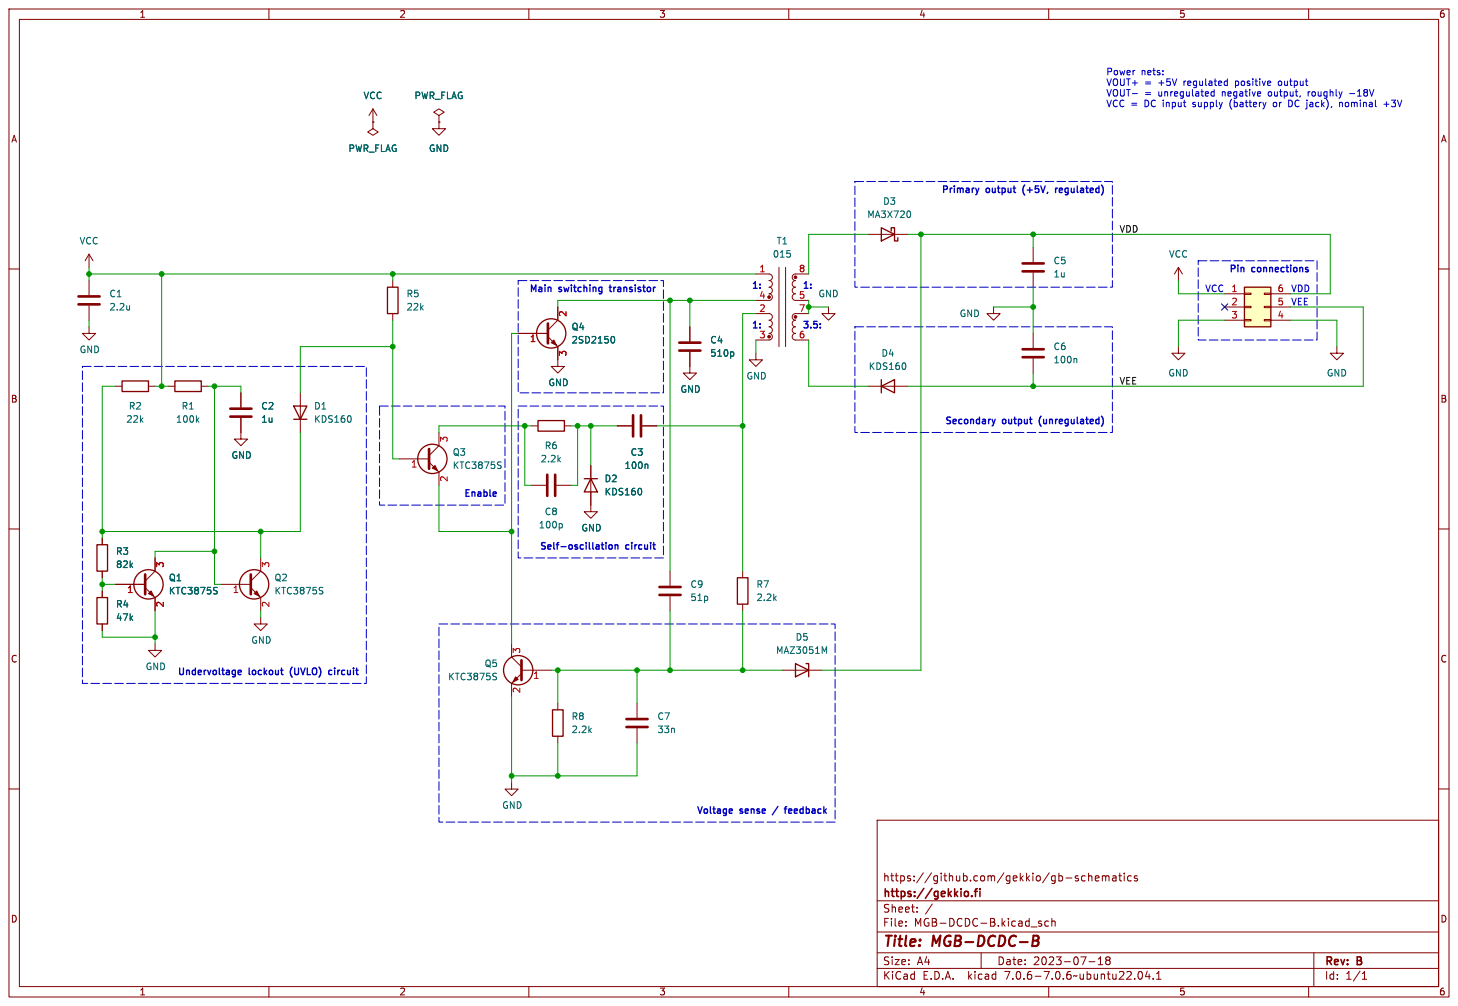
[picture p61: page 1]

https://github.com/gekkio/gb-schematics GND

File: MGB-DCDC-B.kicad_sch Sheet: / https://gekkio.fi

Id: 1/1 Title: MGB-DCDC-B
