Gekkio/gb-schematics/MGB-xCPU/schematic/MGB-xCPU.pdf

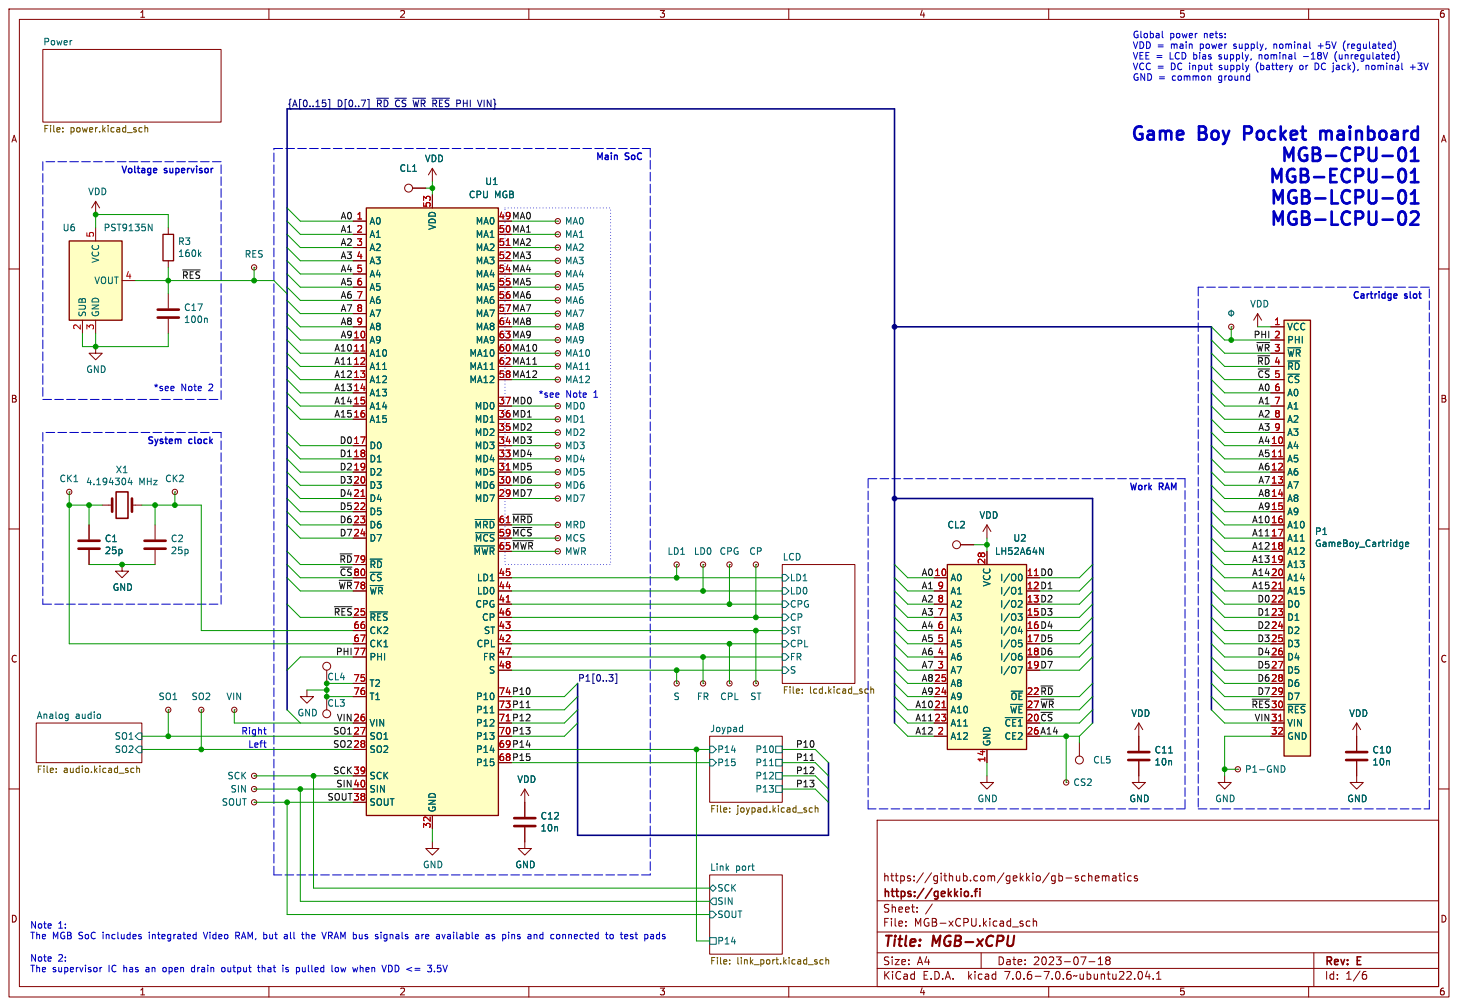
[picture p62: page 1]

Power File: power.kicad_sch SO1 SO2 Analog audio File: audio.kicad_sch

5U6 PST9135N MA7 MD4 MD3 VCC 1 A4 10 A5 11 A6 12 A7 13 A8 14 A9 15 A10 16 A11 17 A12 18 A13 19 PHI 2 A14 20 A15 21 D0 22 D1 23 D2 24 D3 25 D4 26 D5 27 D6 28 D7 29 ~{WR} 3 ~{RES} 30 VIN 31 GND 32 ~{RD} 4 ~{CS} 5 A0 6 A1 7 A2 8 A3 9 P1GameBoy_Cartridge MA2 MA3 MA4 SOUT SCK

FR CPL ST GND GND

https://github.com/gekkio/gb-schematics
File: MGB-xCPU.kicad_sch Sheet: / https://gekkio.fi

Id: 1/6 Title: MGB-xCPU

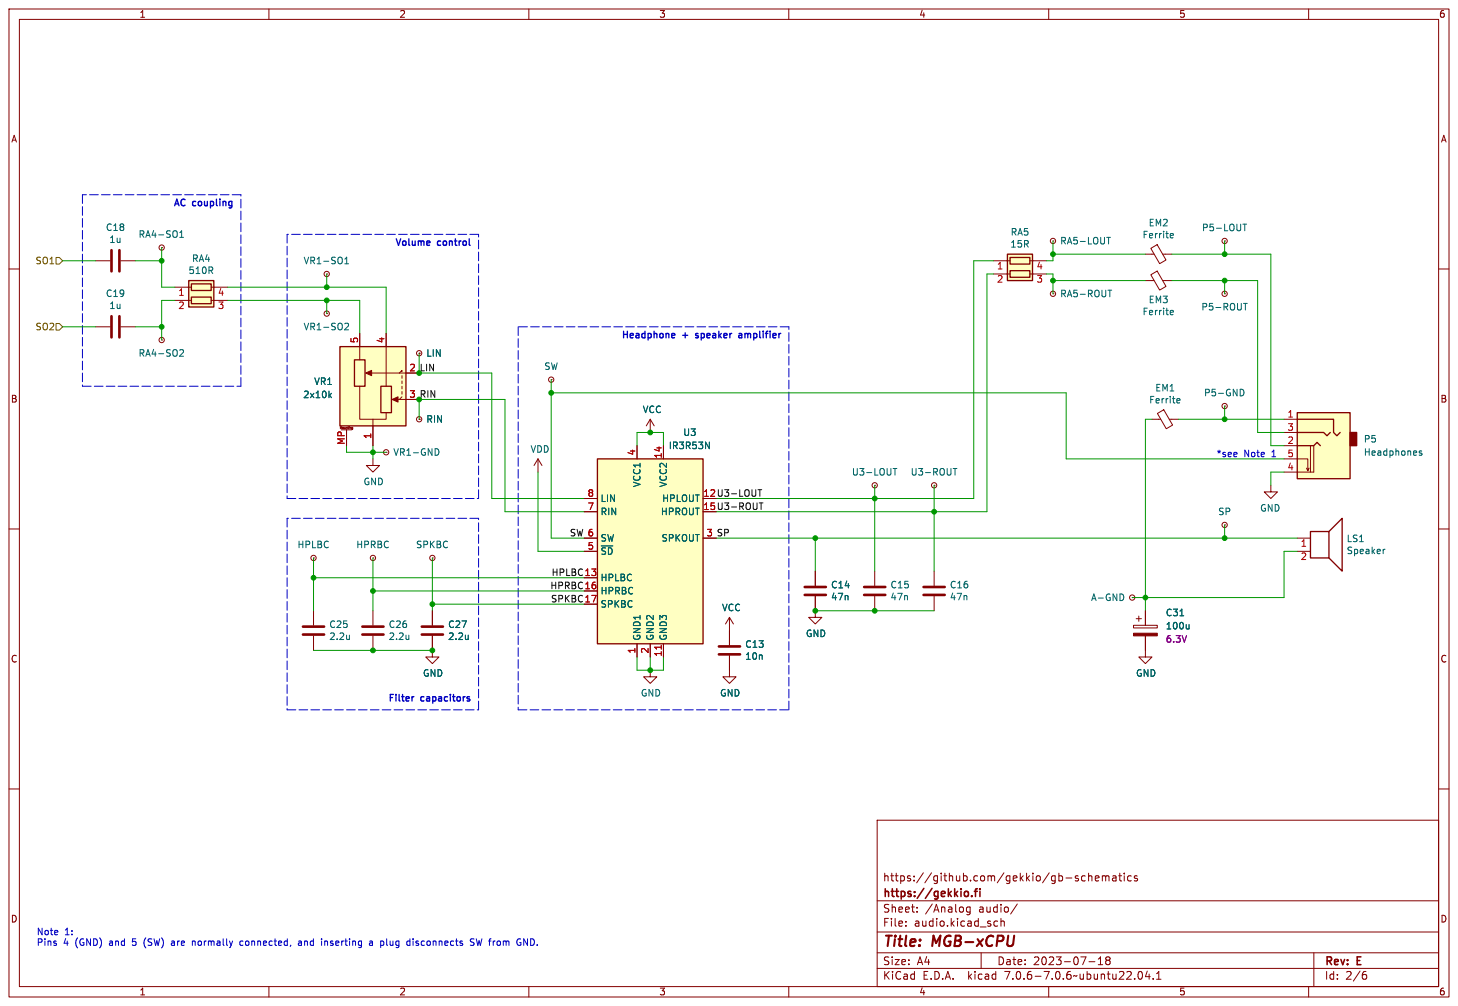
[picture p63: page 2]

1 GND3 11 HPLOUT 12 HPLBC 13 VCC2 14 HPROUT 15 HPRBC 16 SPKBC 17 GND2

https://github.com/gekkio/gb-schematics C13

Id: 2/6 Title: MGB-xCPU

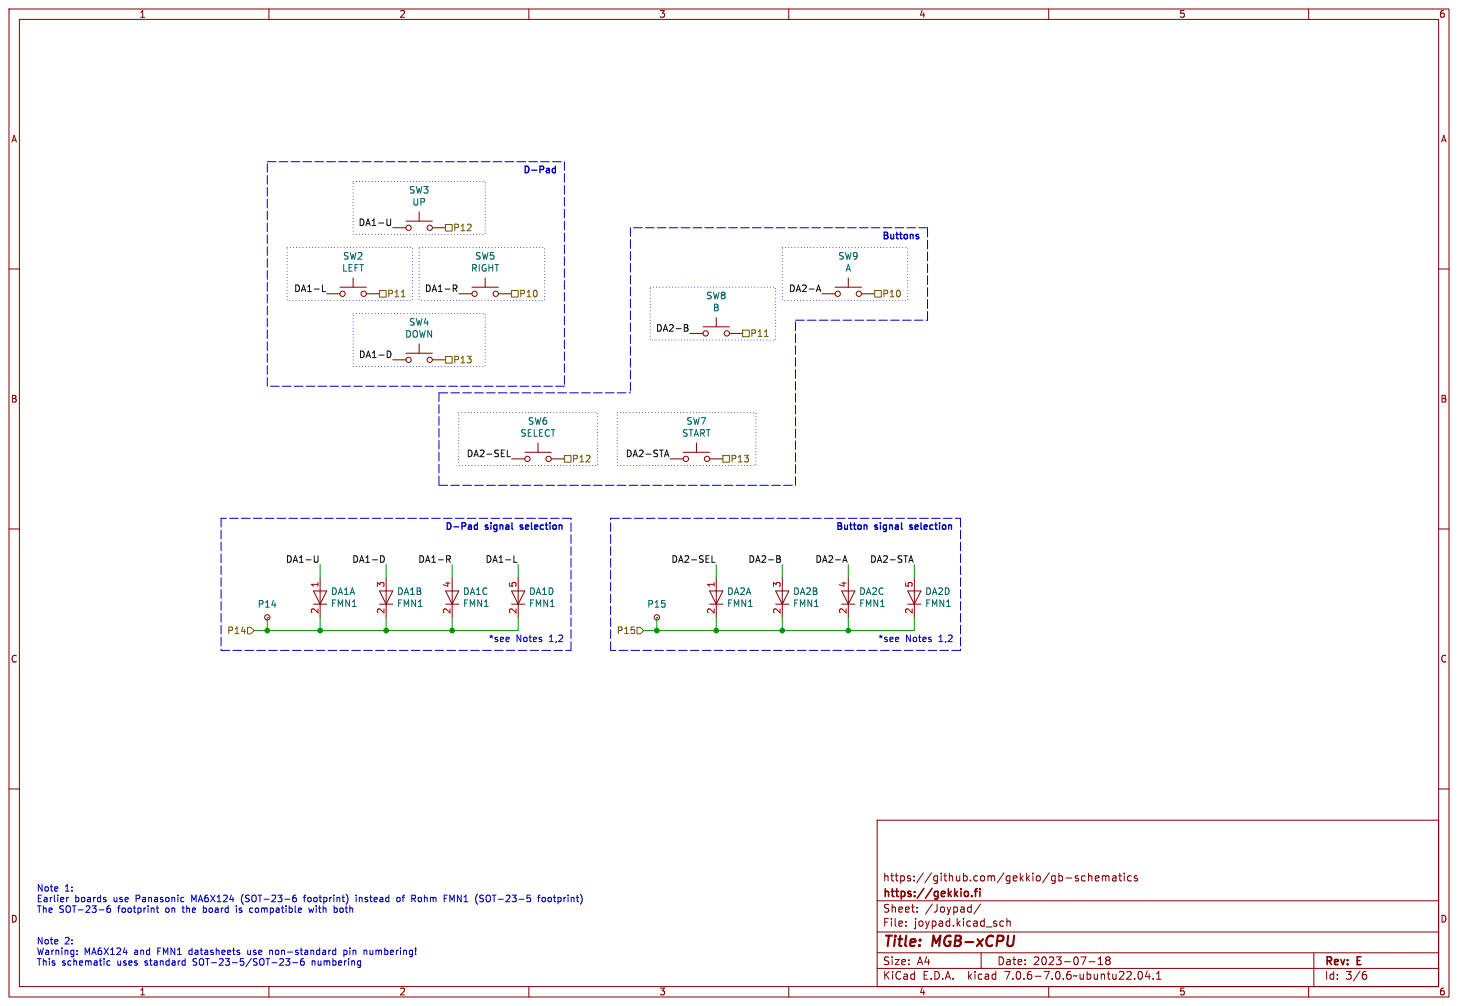
[picture p64: page 3]

https://github.com/gekkio/gb-schematics
https://gekkio.fi
File: joypad.kicad_sch Sheet: /Joypad/
Id: 3/6 Title: MGB-xCPU

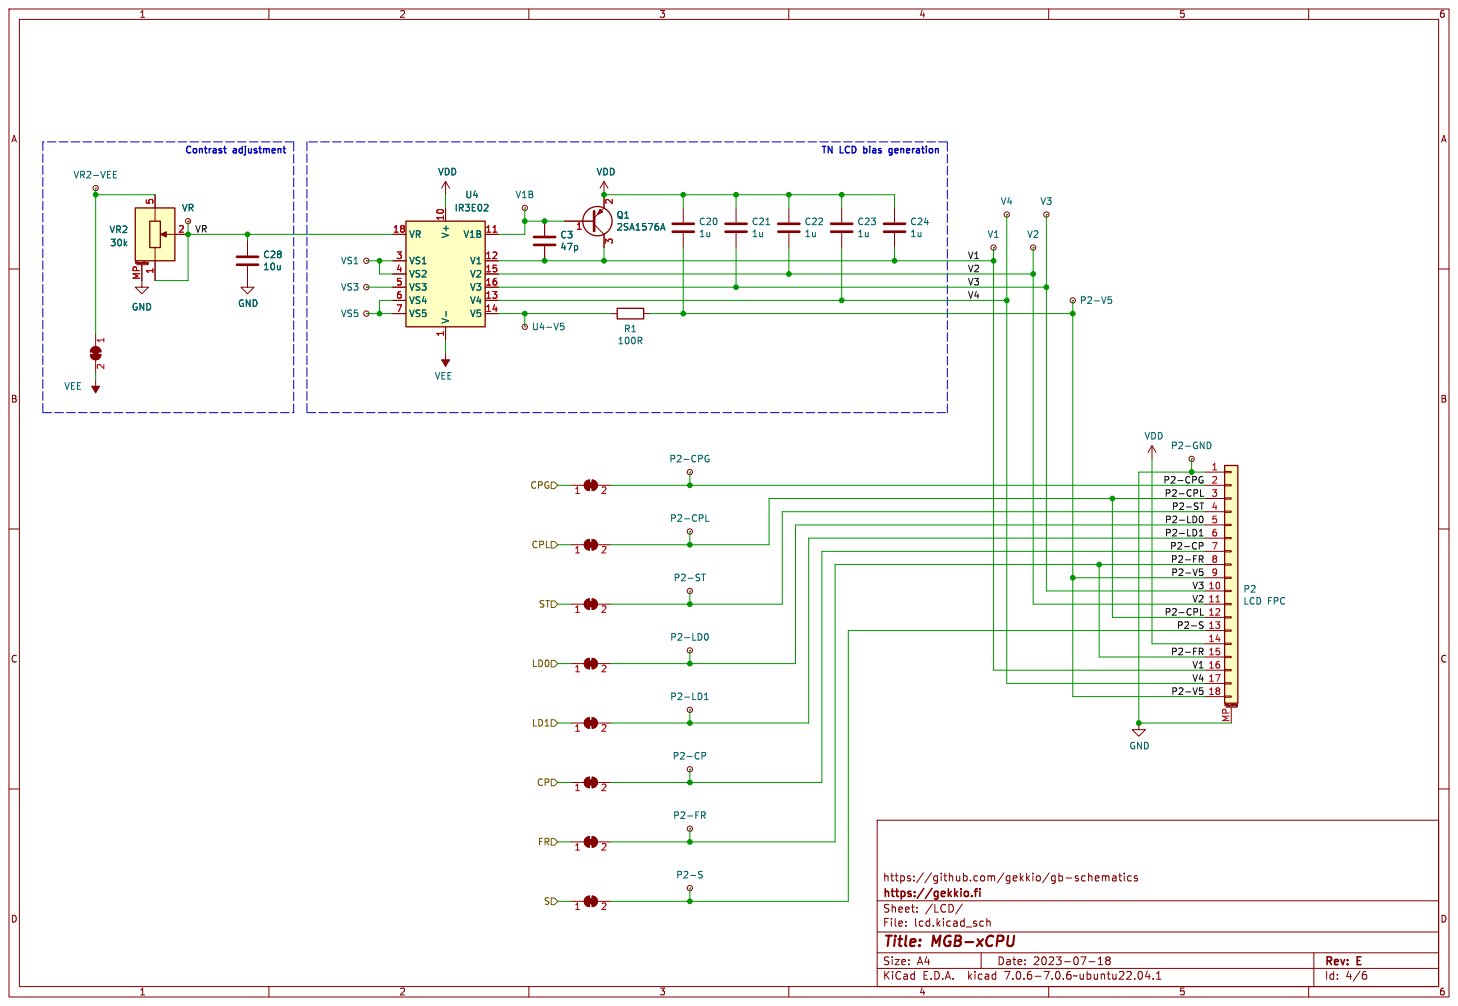
[picture p65: page 4]

https://github.com/gekkio/gb-schematics
File: lcd.kicad_sch Sheet: /LCD/ https://gekkio.fi

Id: 4/6 Title: MGB-xCPU

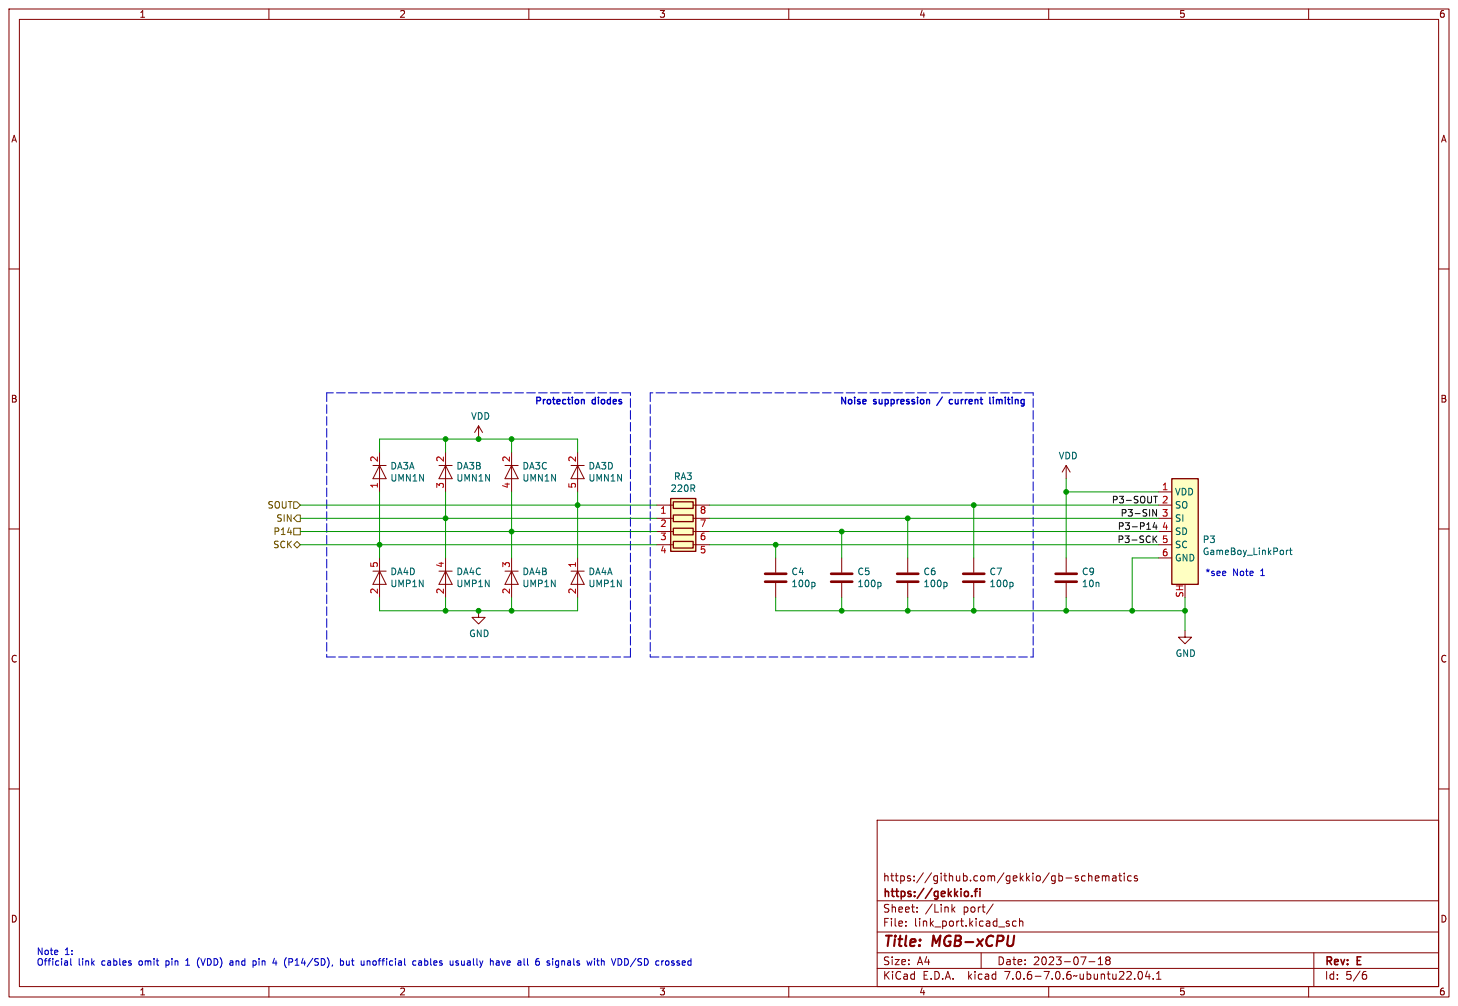
[picture p66: page 5]

P3-P14 P3-SOUT P3-SIN

https://github.com/gekkio/gb-schematics
https://gekkio.fi
Id: 5/6 Title: MGB-xCPU

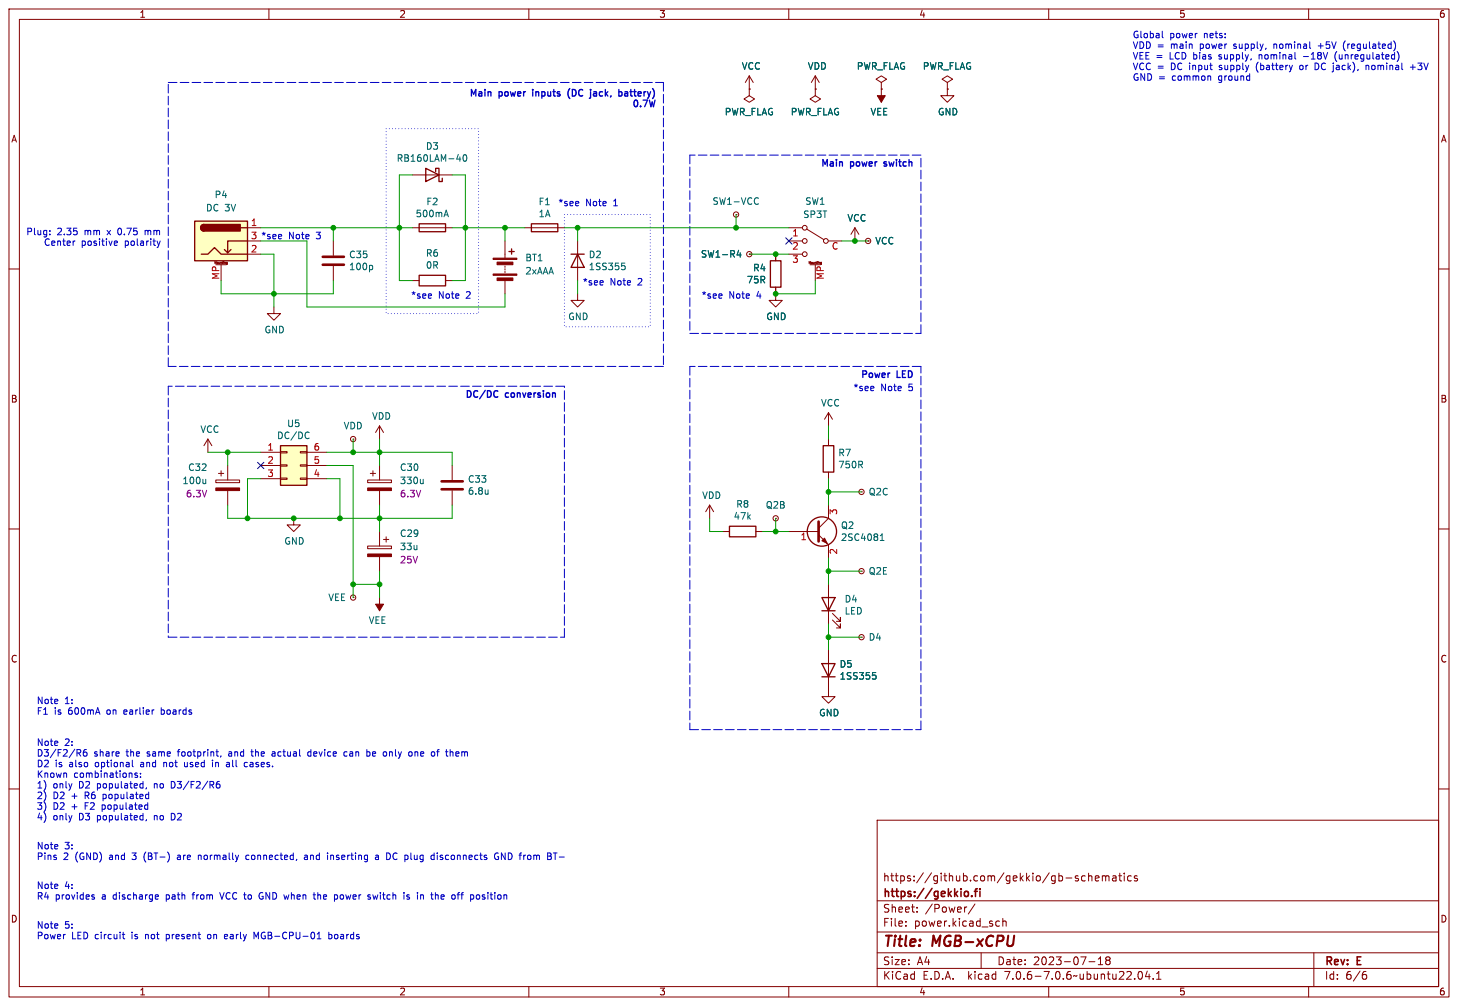
[picture p67: page 6]

*see Note 4 Main power inputs (DC jack, battery) 0.7W

*see Note 2 Plug: 2.35 mm x 0.75 mm

https://github.com/gekkio/gb-schematics R8

File: power.kicad_sch Sheet: /Power/ https://gekkio.fi

Id: 6/6 Title: MGB-xCPU
