Gekkio/gb-schematics/DMG-CPU-06/schematic/DMG-CPU-06.pdf

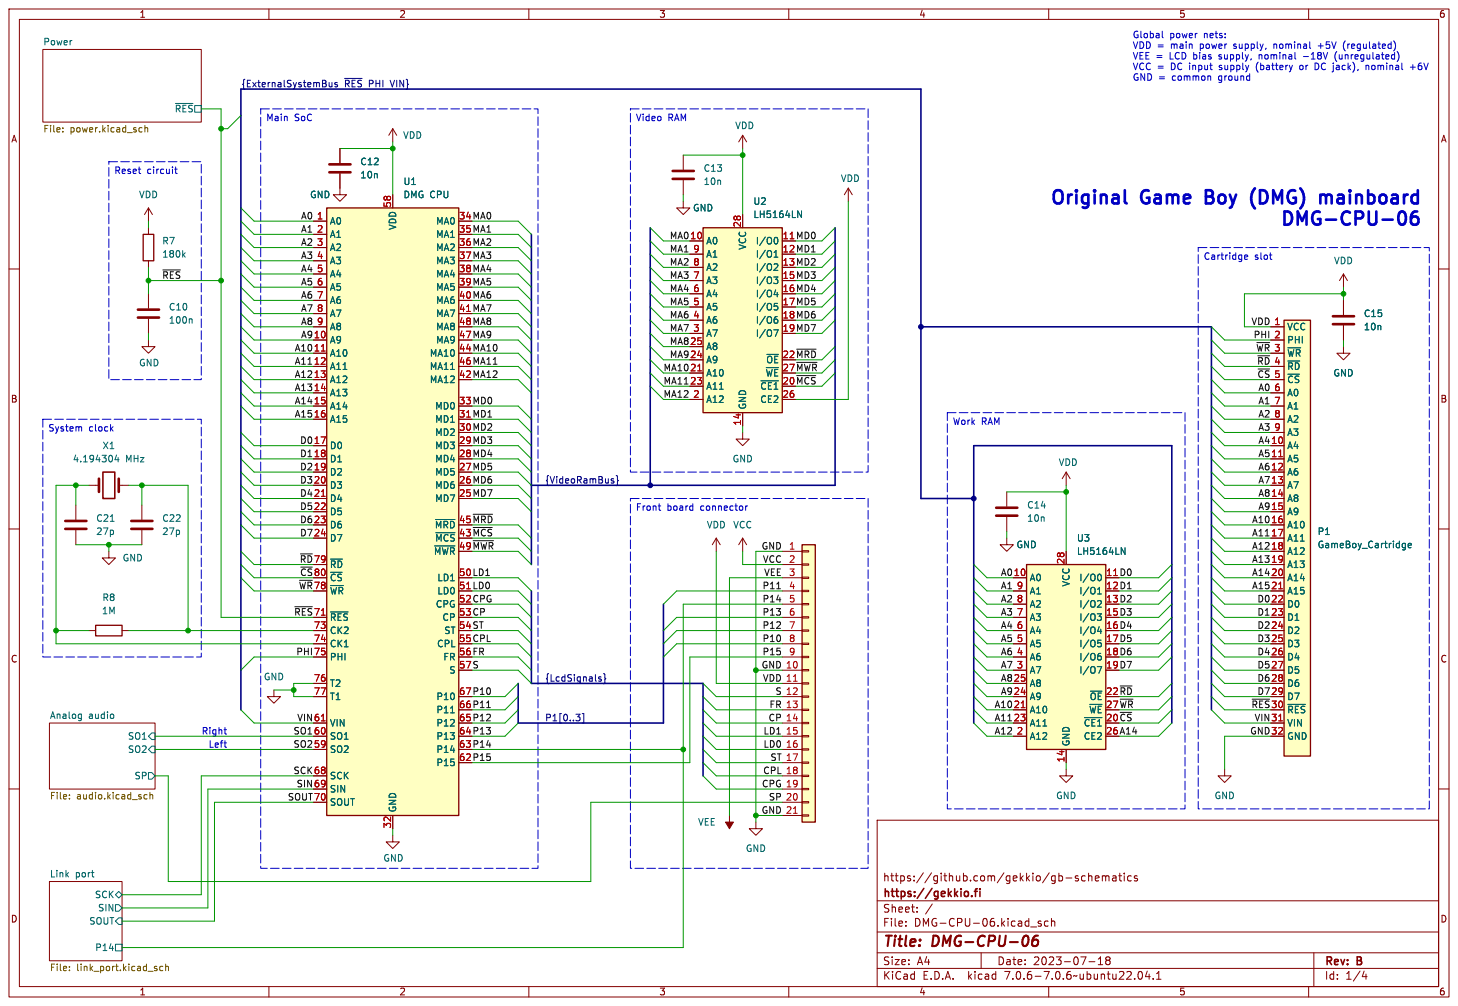
[picture p68: page 1]

9 GND GND
Analog audio File: audio.kicad_sch SCK

https://github.com/gekkio/gb-schematics
File: DMG-CPU-06.kicad_sch Sheet: / https://gekkio.fi

Id: 1/4 Title: DMG-CPU-06

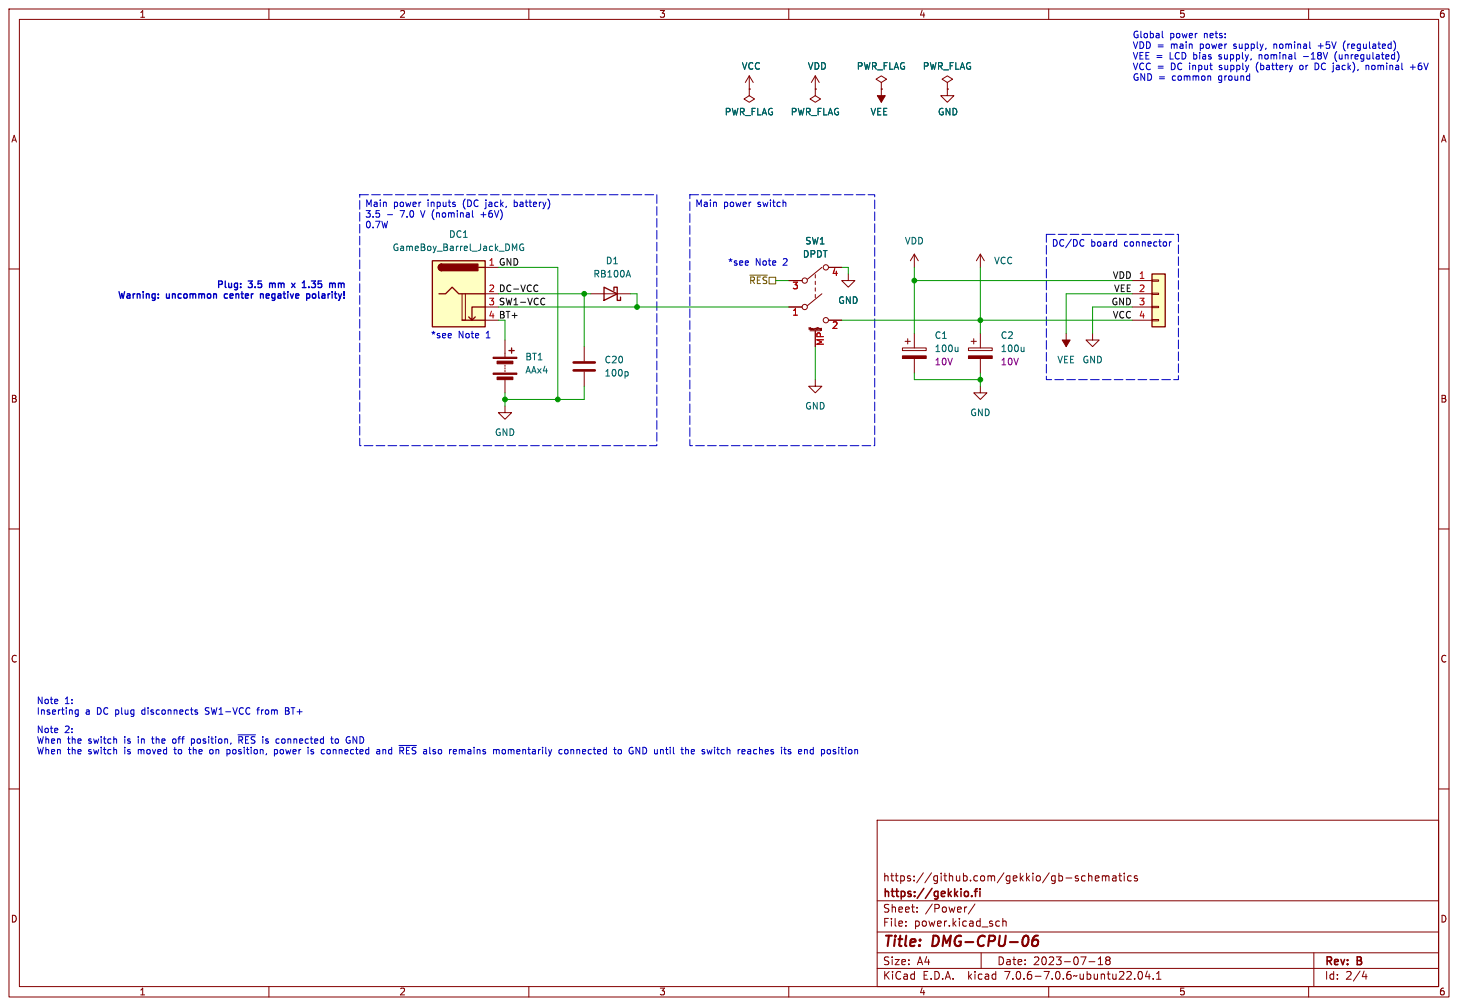
[picture p69: page 2]

https://github.com/gekkio/gb-schematics
File: power.kicad_sch Sheet: /Power/ https://gekkio.fi

Id: 2/4 Title: DMG-CPU-06

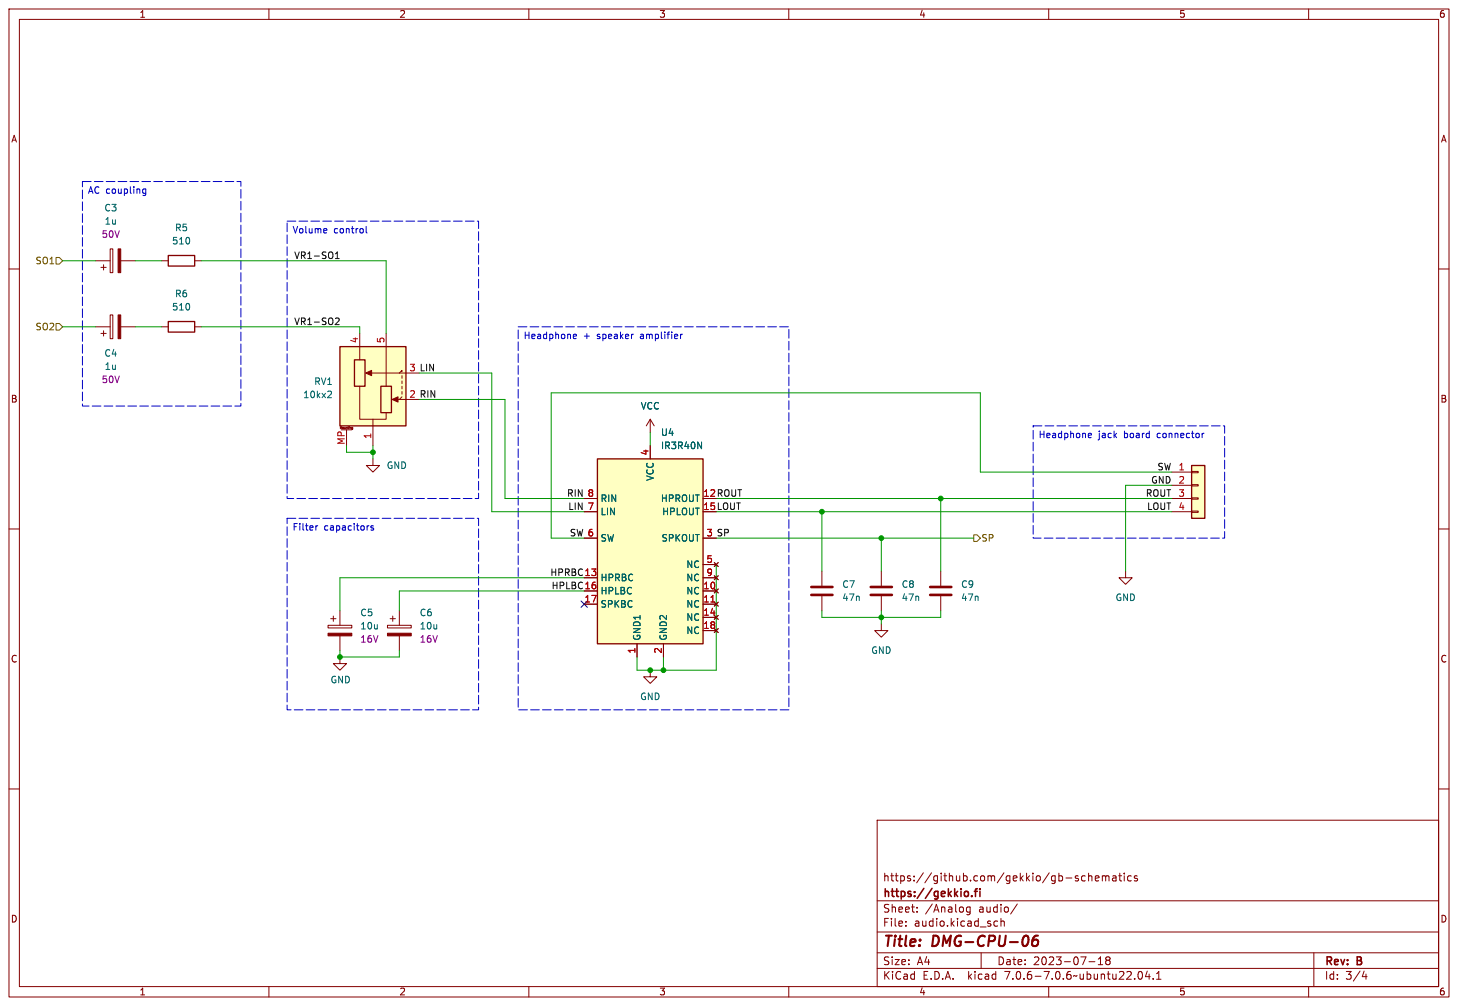
[picture p70: page 3]

1 NC 10 NC 11 HPROUT 12 HPRBC 13 NC 14 HPLOUT 15 HPLBC 16 SPKBC 17 NC 18 GND2

https://github.com/gekkio/gb-schematics C9

10u | HPLBC

Id: 3/4 Title: DMG-CPU-06

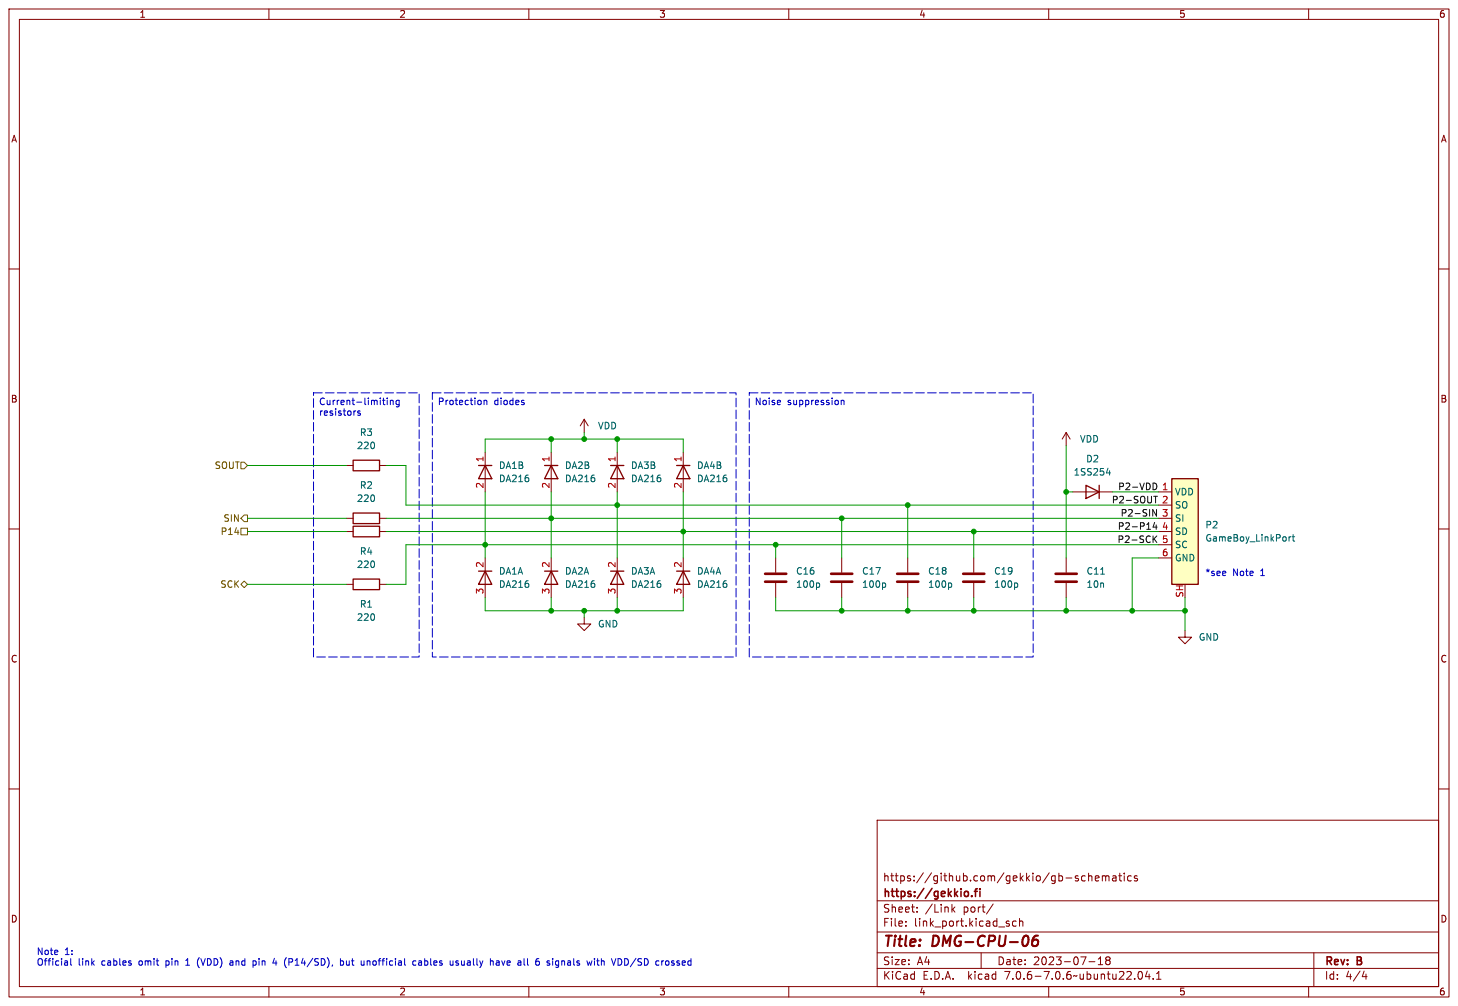
[picture p71: page 4]

https://github.com/gekkio/gb-schematics D2

*see Note 1 Current-limiting

https://gekkio.fi
Id: 4/4 Title: DMG-CPU-06
