Gekkio/gb-schematics/DMG-LCD-06/schematic/DMG-LCD-06.pdf

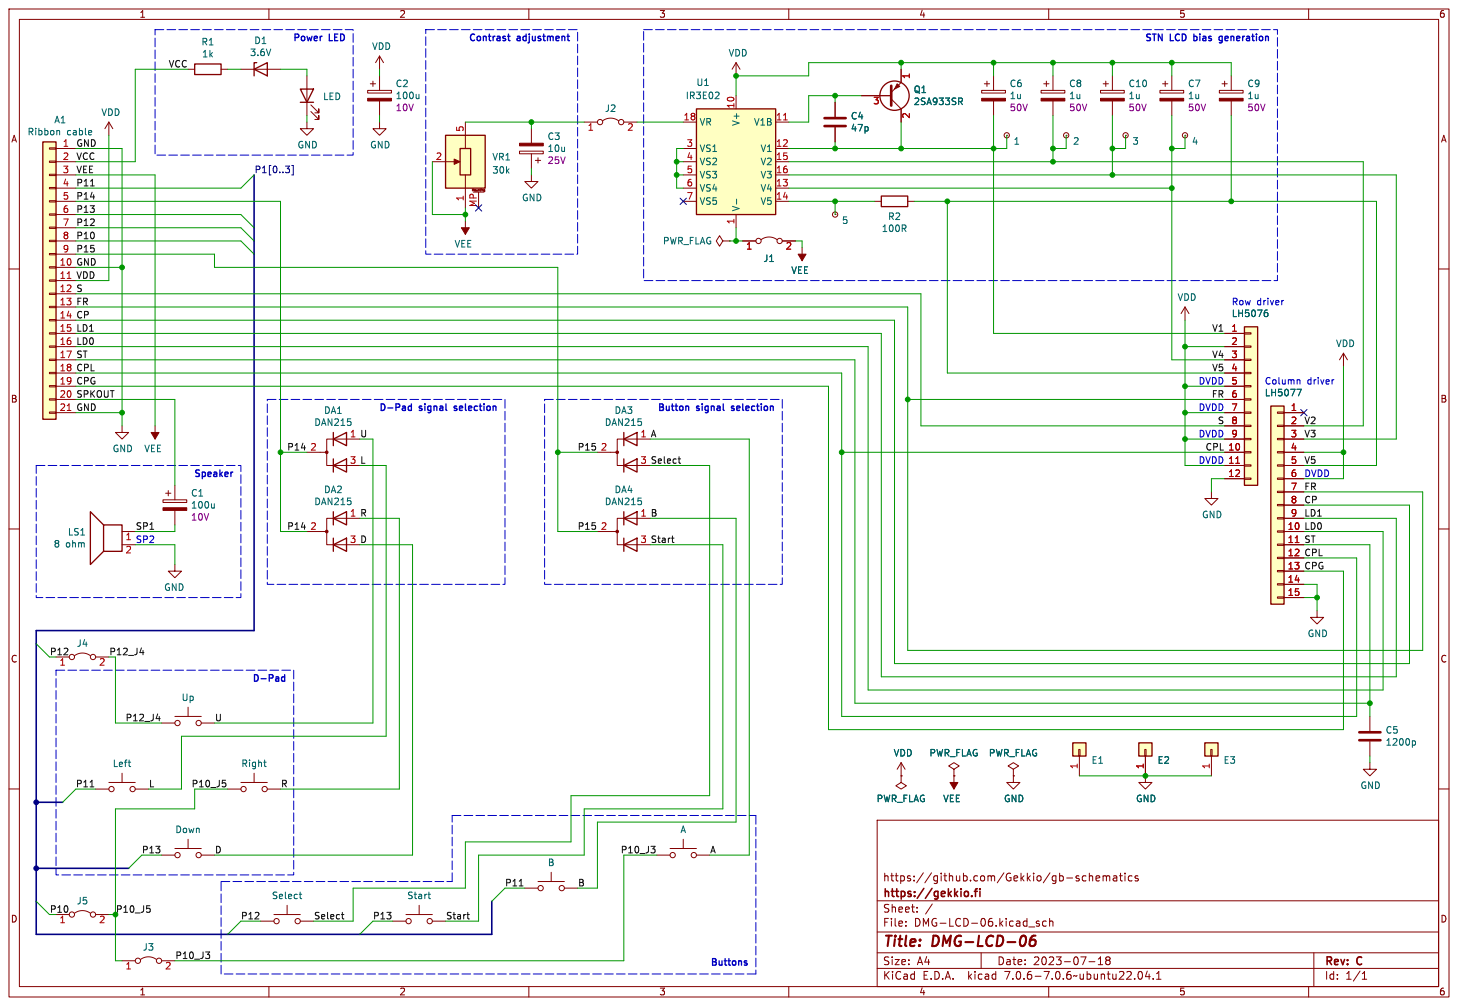
[picture p72: page 1]

Column driver STN LCD bias generation

https://github.com/Gekkio/gb-schematics
File: DMG-LCD-06.kicad_sch Sheet: / https://gekkio.fi

Id: 1/1 Title: DMG-LCD-06
