Gekkio/gb-schematics/LSEP01088A1/schematic/LSEP01088A1.pdf

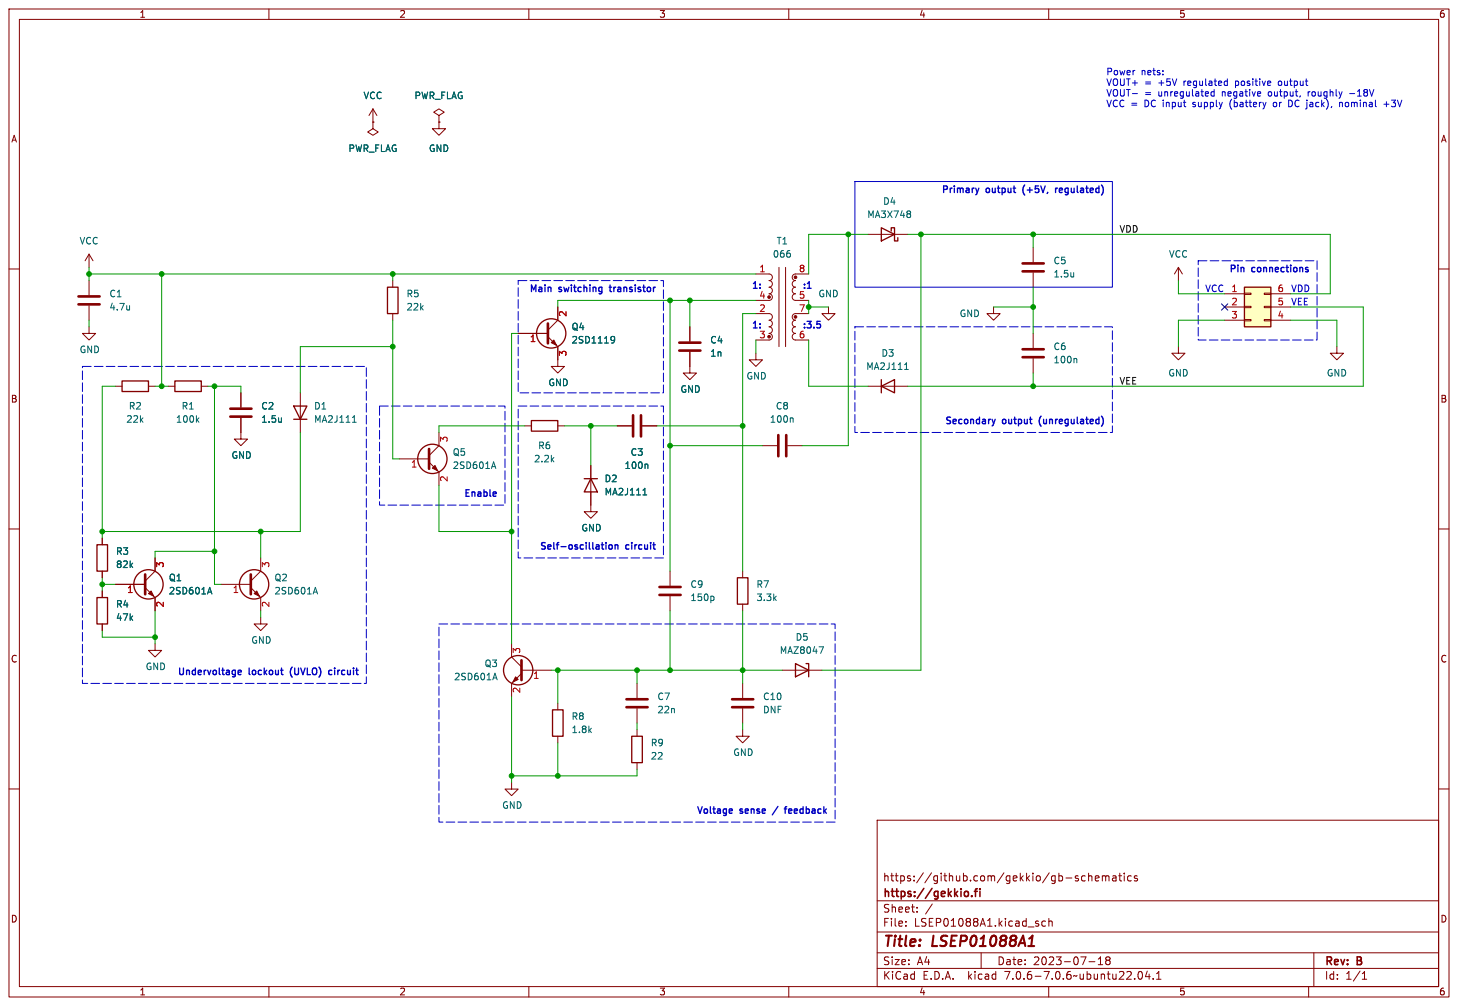
[picture p73: page 1]

https://github.com/gekkio/gb-schematics D5 MAZ8047 GND

File: LSEP01088A1.kicad_sch Sheet: / https://gekkio.fi
