Gekkio/gb-schematics/DC-CONV-DMG-AB/schematic/DC-CONV-DMG-AB.pdf

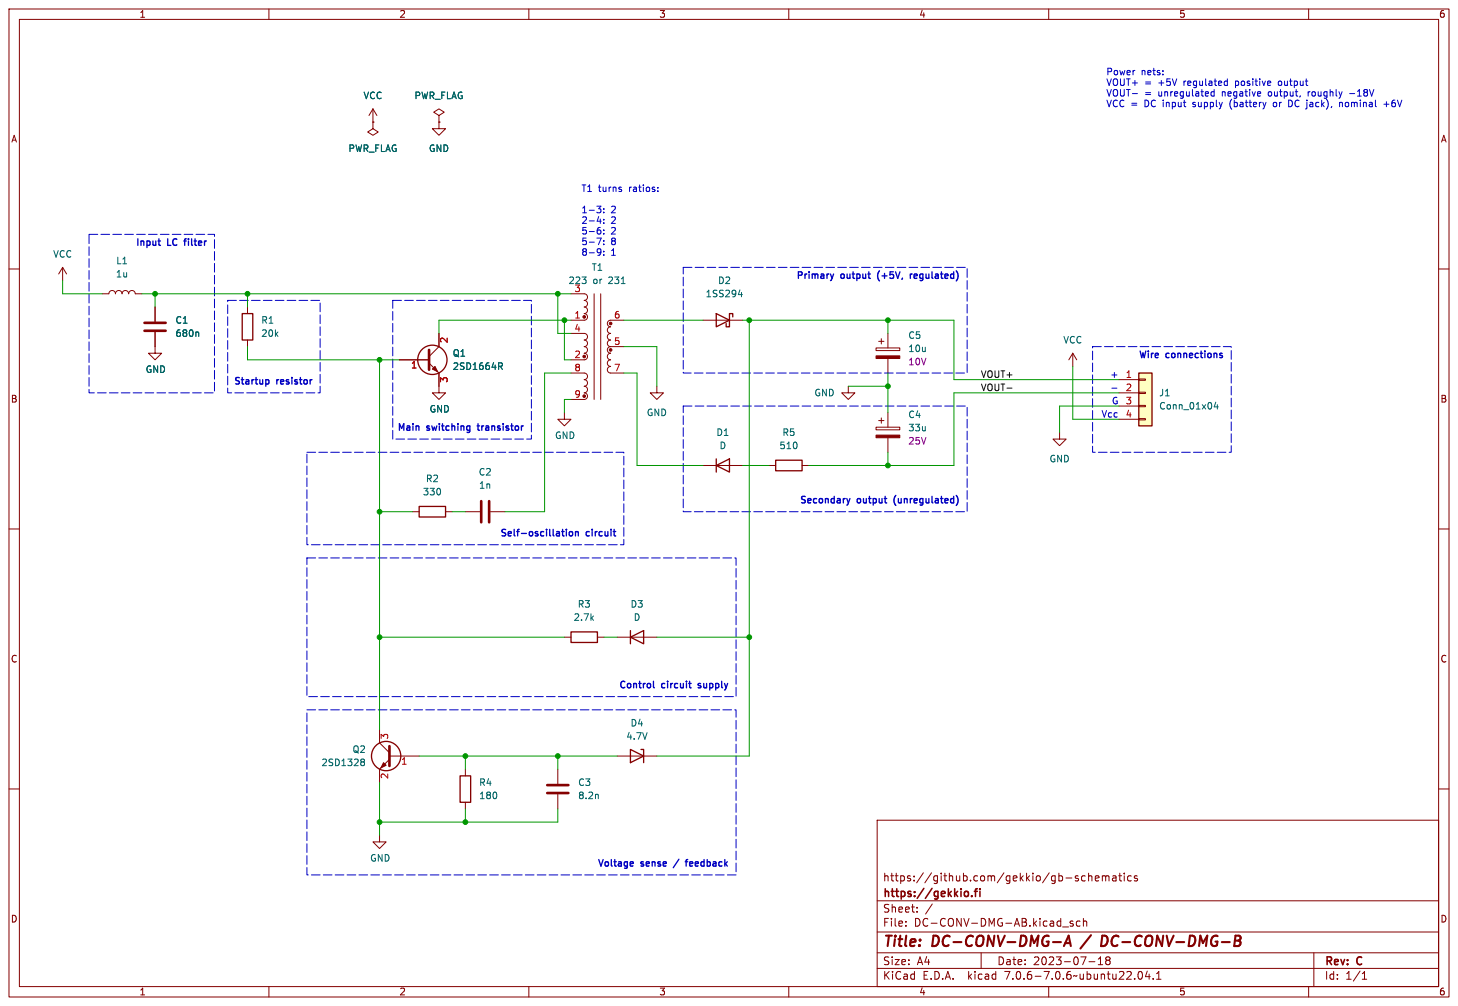
[picture p74: page 1]

https://github.com/gekkio/gb-schematics R2

File: DC-CONV-DMG-AB.kicad_sch Sheet: / https://gekkio.fi
