Gekkio/gb-schematics/DC-CONV-DMG-C/schematic/DC-CONV-DMG-C.pdf

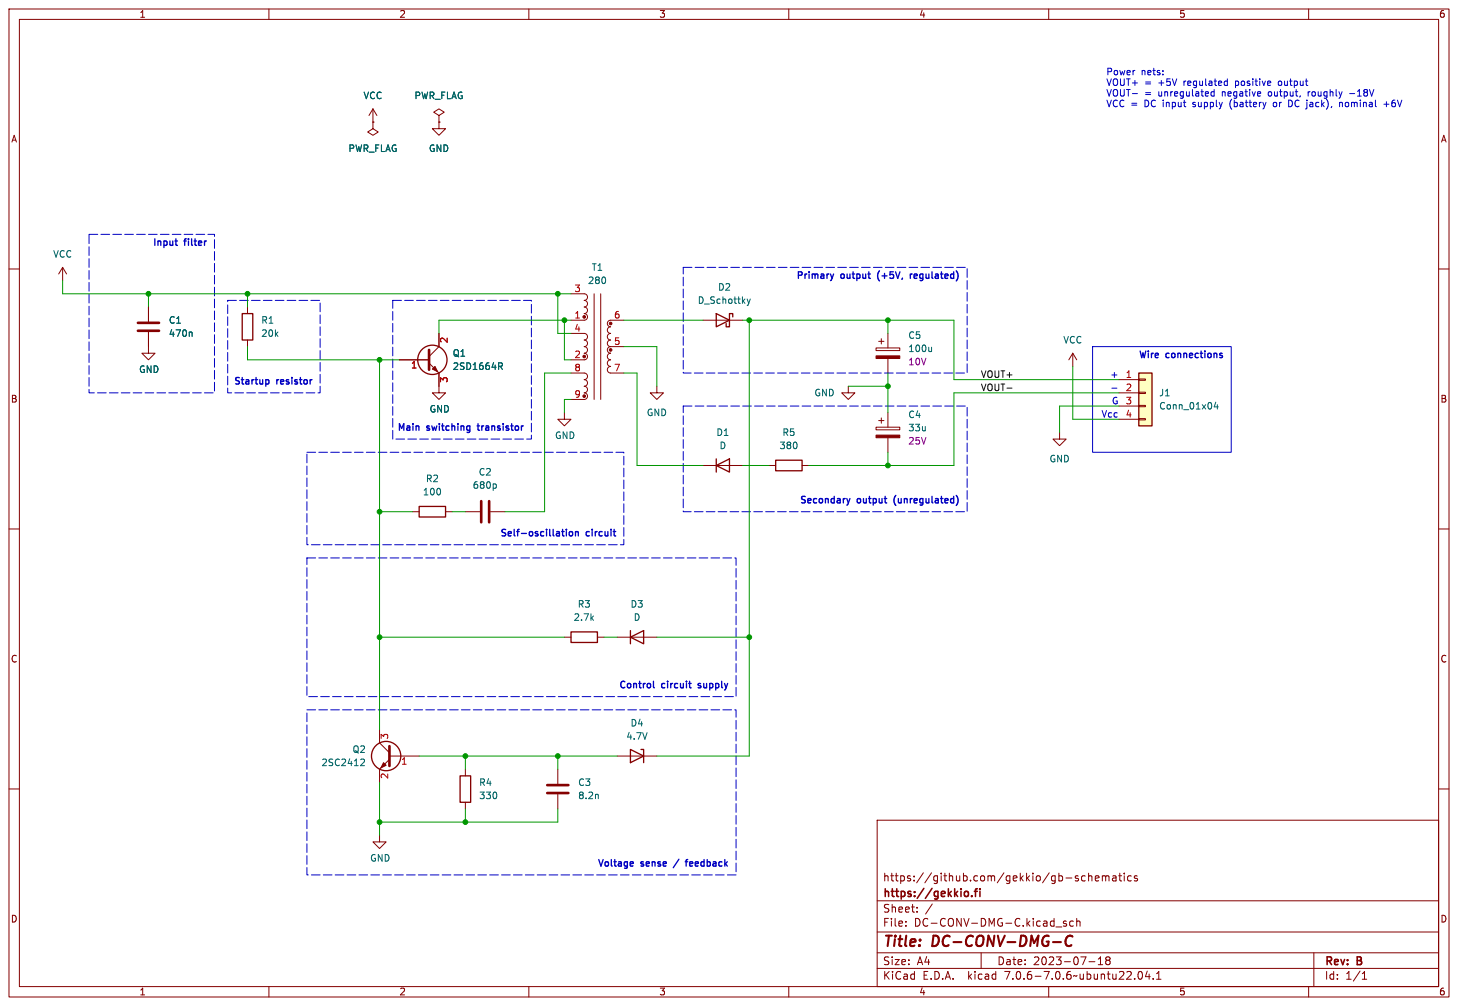
[picture p75: page 1]

https://github.com/gekkio/gb-schematics C3

File: DC-CONV-DMG-C.kicad_sch Sheet: / https://gekkio.fi

Id: 1/1 Title: DC-CONV-DMG-C
