Gekkio/gb-schematics/DC-CONV2-DMG-D/schematic/DC-CONV2-DMG-D.pdf

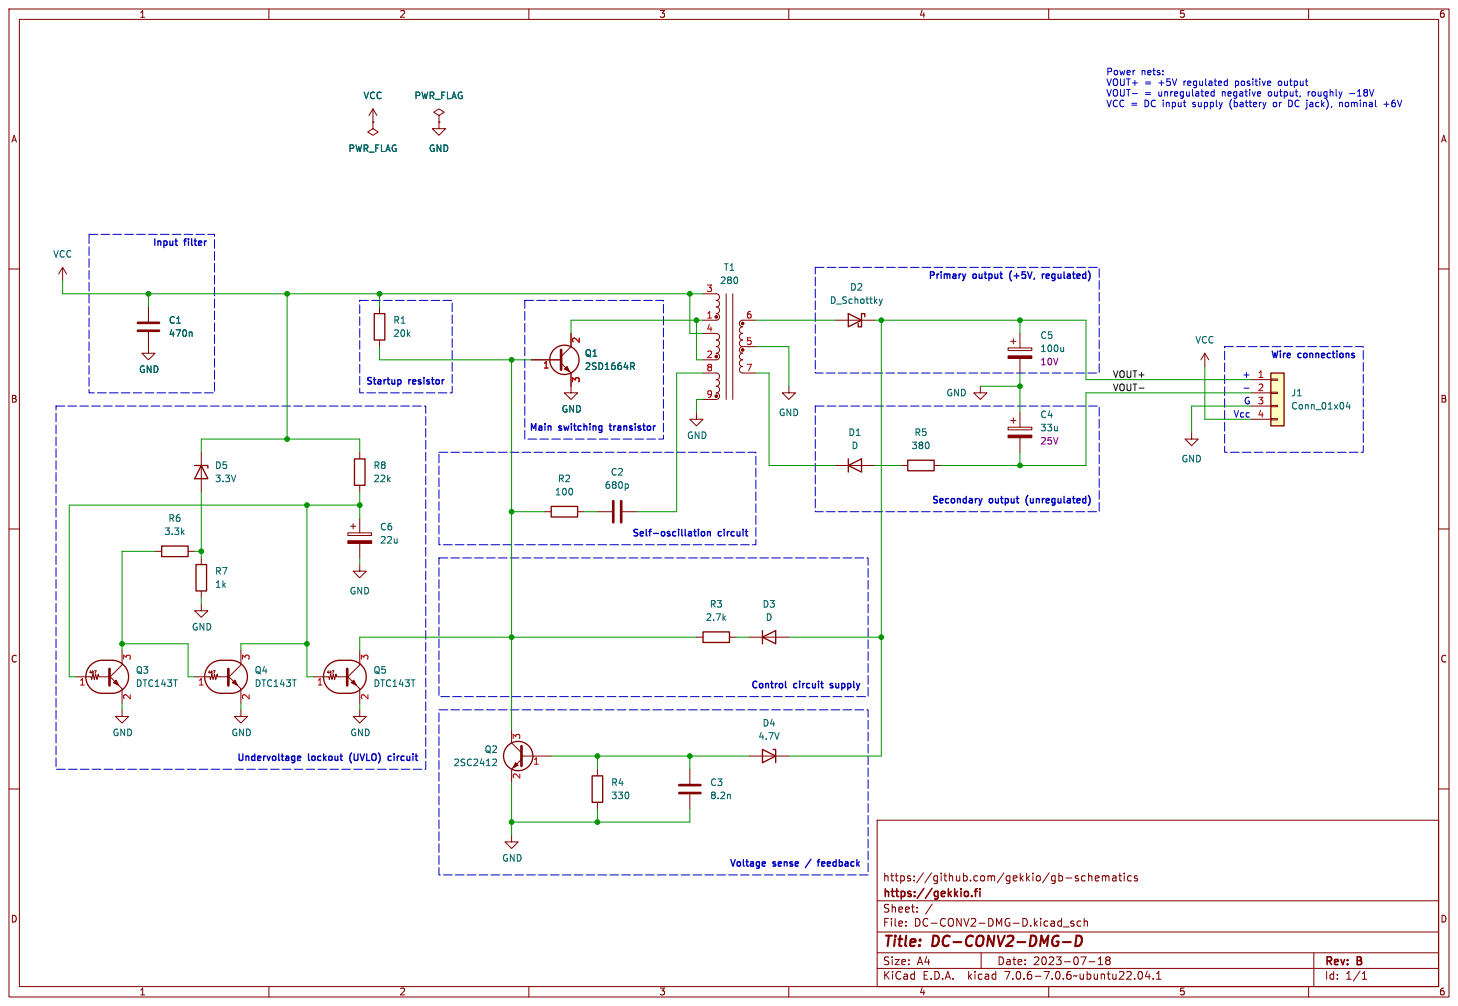
[picture p76: page 1]

- Primary output (+5V, regulated) Control circuit supply

File: DC-CONV2-DMG-D.kicad_sch Sheet: / https://gekkio.fi

Id: 1/1 Title: DC-CONV2-DMG-D
