Gekkio/gb-schematics/AGS-CPU-11/schematic/AGS-CPU-11.pdf

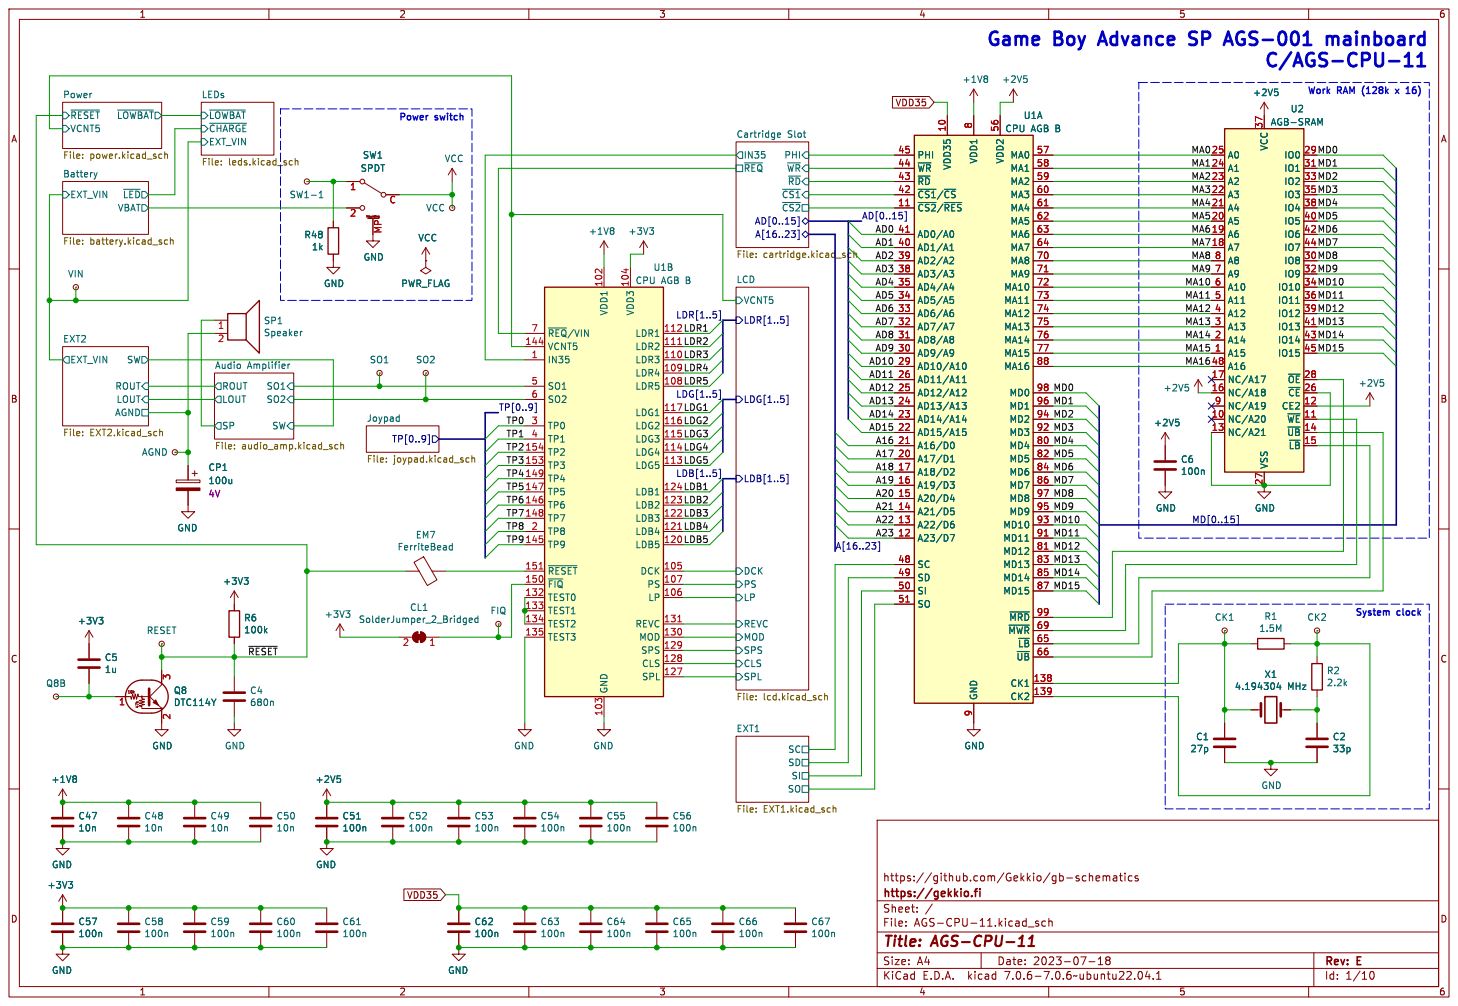
[picture p77: page 1]

Battery File: battery.kicad_sch SW

https://github.com/Gekkio/gb-schematics
File: AGS-CPU-11.kicad_sch Sheet: / https://gekkio.fi

Id: 1/10 Title: AGS-CPU-11

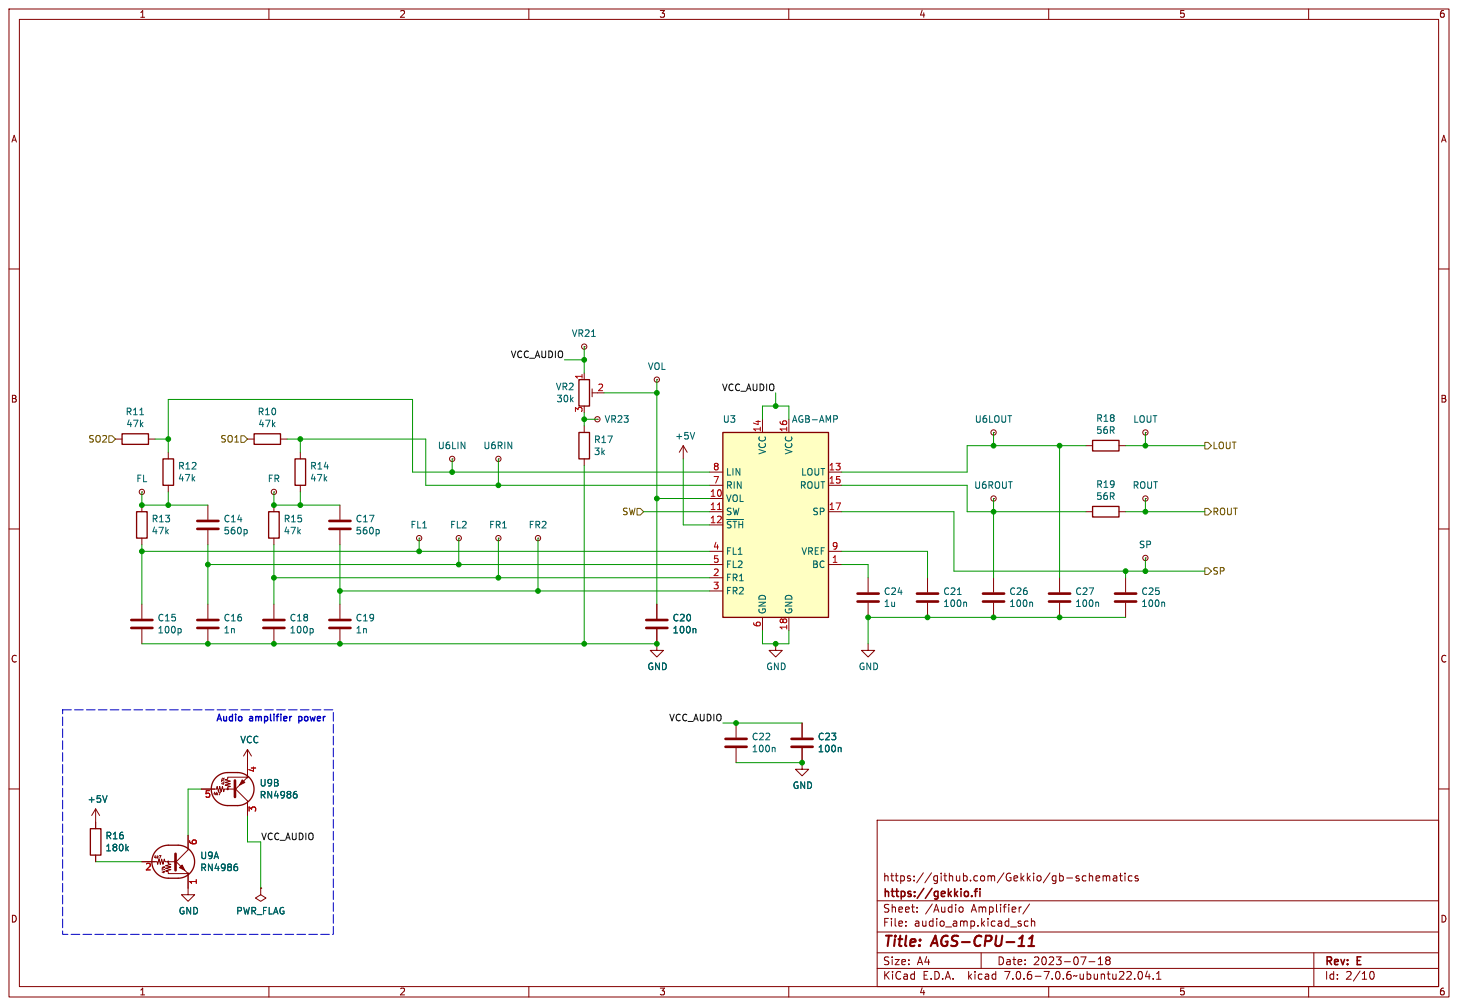
[picture p78: page 2]

https://github.com/Gekkio/gb-schematics C16

https://gekkio.fi
Id: 2/10 Title: AGS-CPU-11

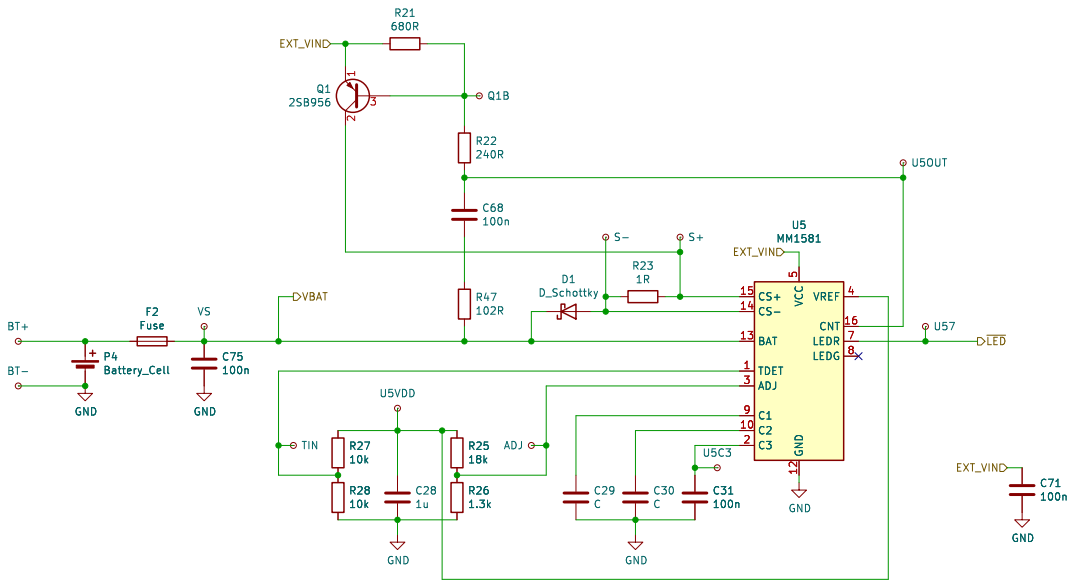
[picture p79: page 3]

https://github.com/Gekkio/gb-schematics R25

https://gekkio.fi
File: battery.kicad_sch Sheet: /Battery/
Id: 3/10 Title: AGS-CPU-11

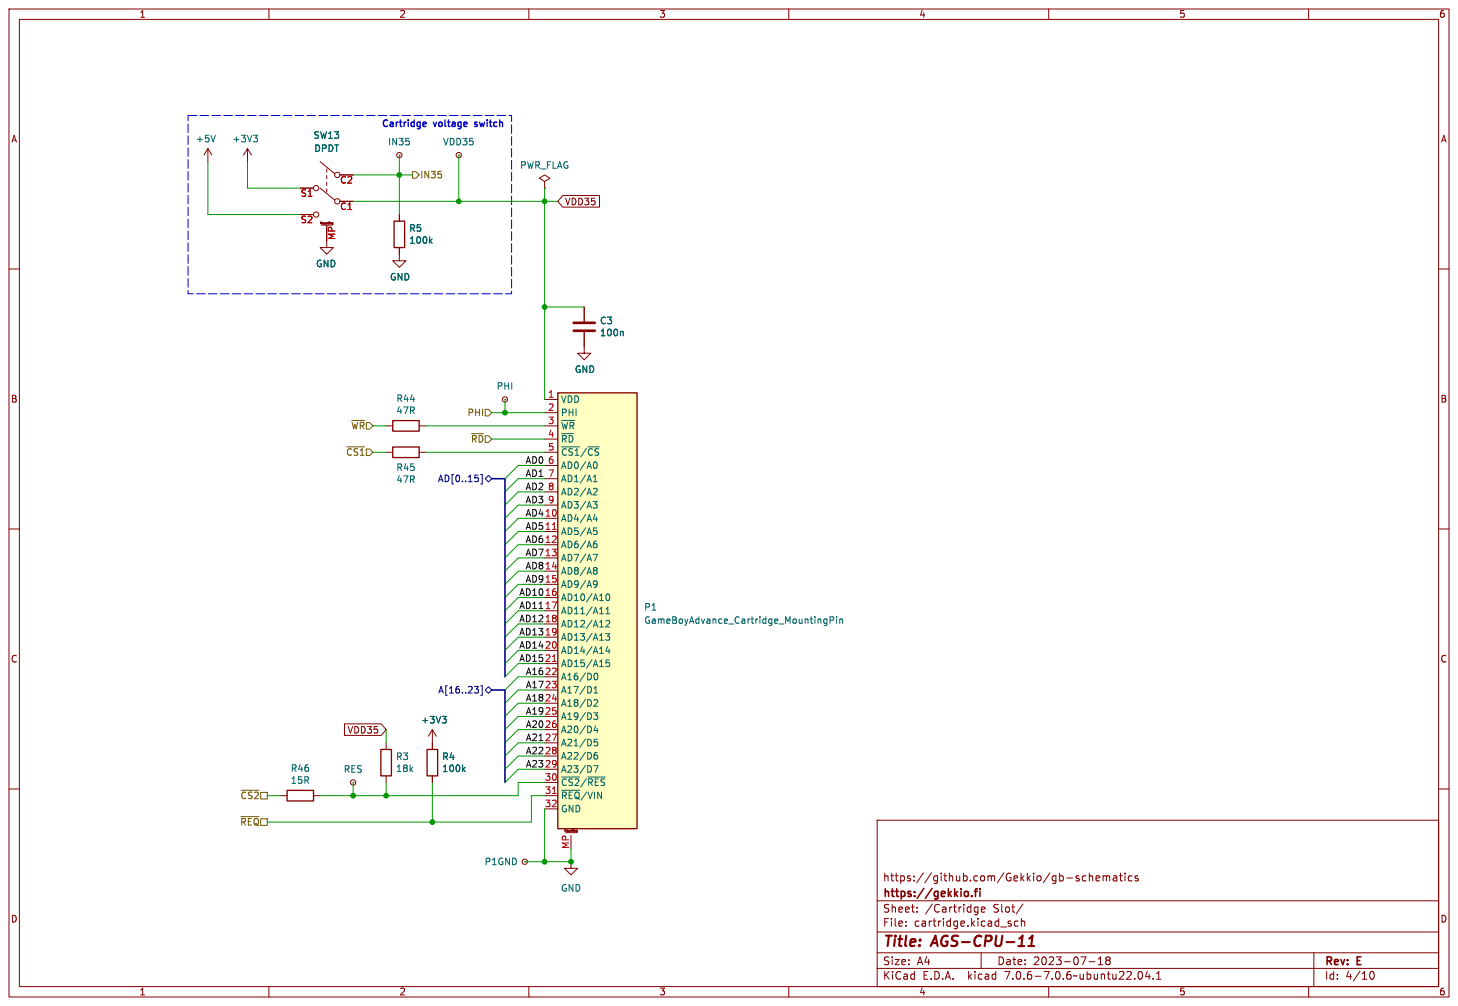
[picture p80: page 4]

https://github.com/Gekkio/gb-schematics

Id: 4/10 Title: AGS-CPU-11

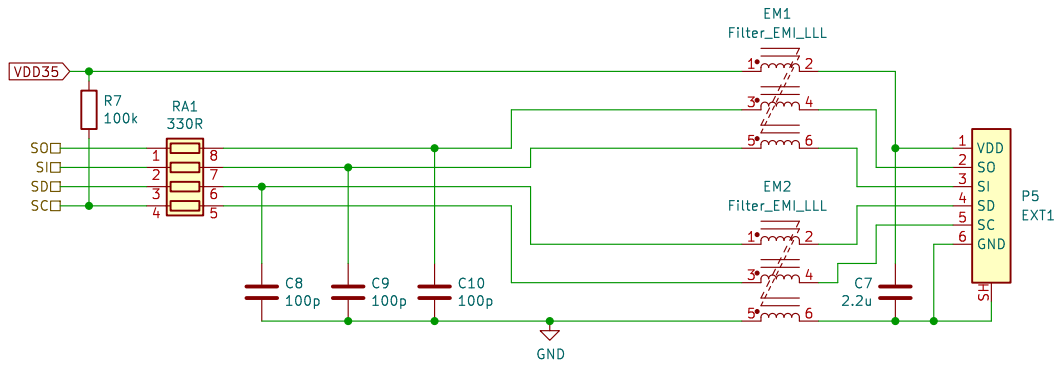
[picture p81: page 5]

https://github.com/Gekkio/gb-schematics
File: EXT1.kicad_sch Sheet: /EXT1/ https://gekkio.fi

Id: 5/10 Title: AGS-CPU-11

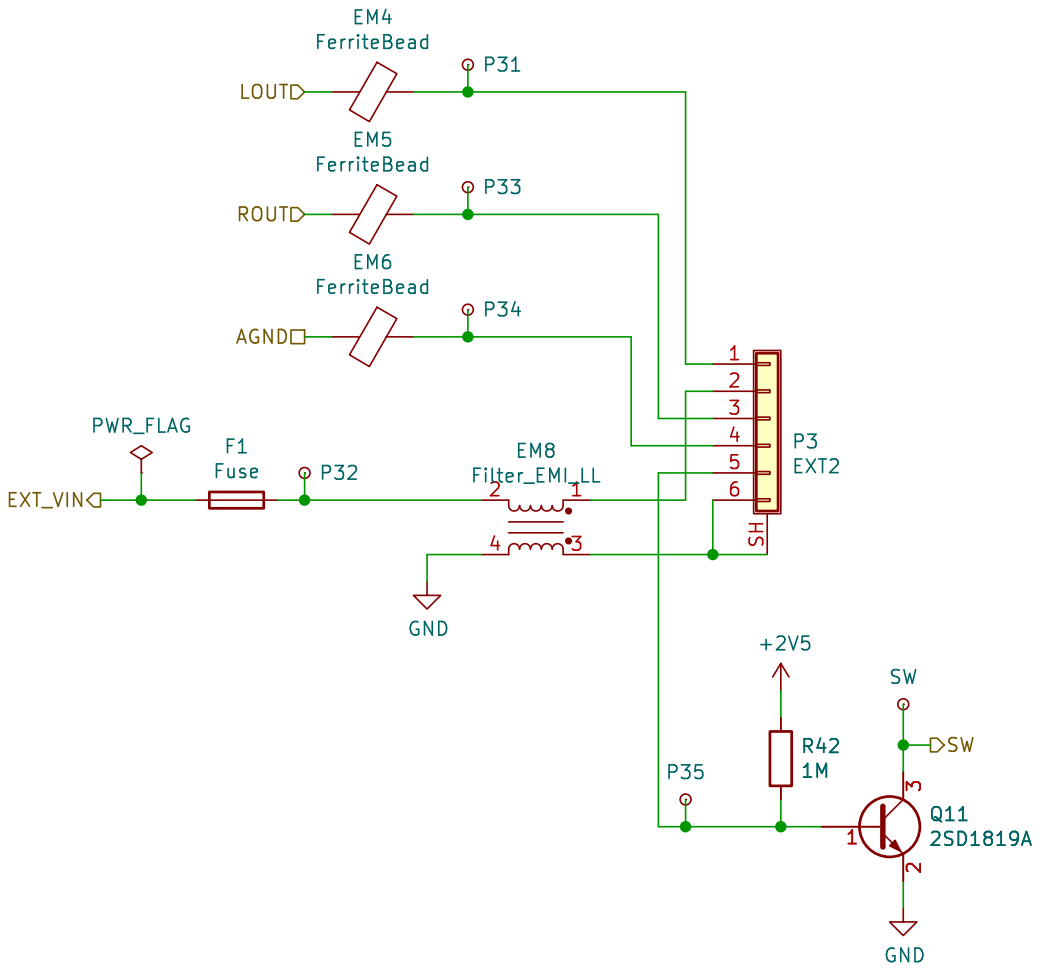
[picture p82: page 6]

https://github.com/Gekkio/gb-schematics GND

File: EXT2.kicad_sch Sheet: /EXT2/ https://gekkio.fi

Id: 6/10 Title: AGS-CPU-11

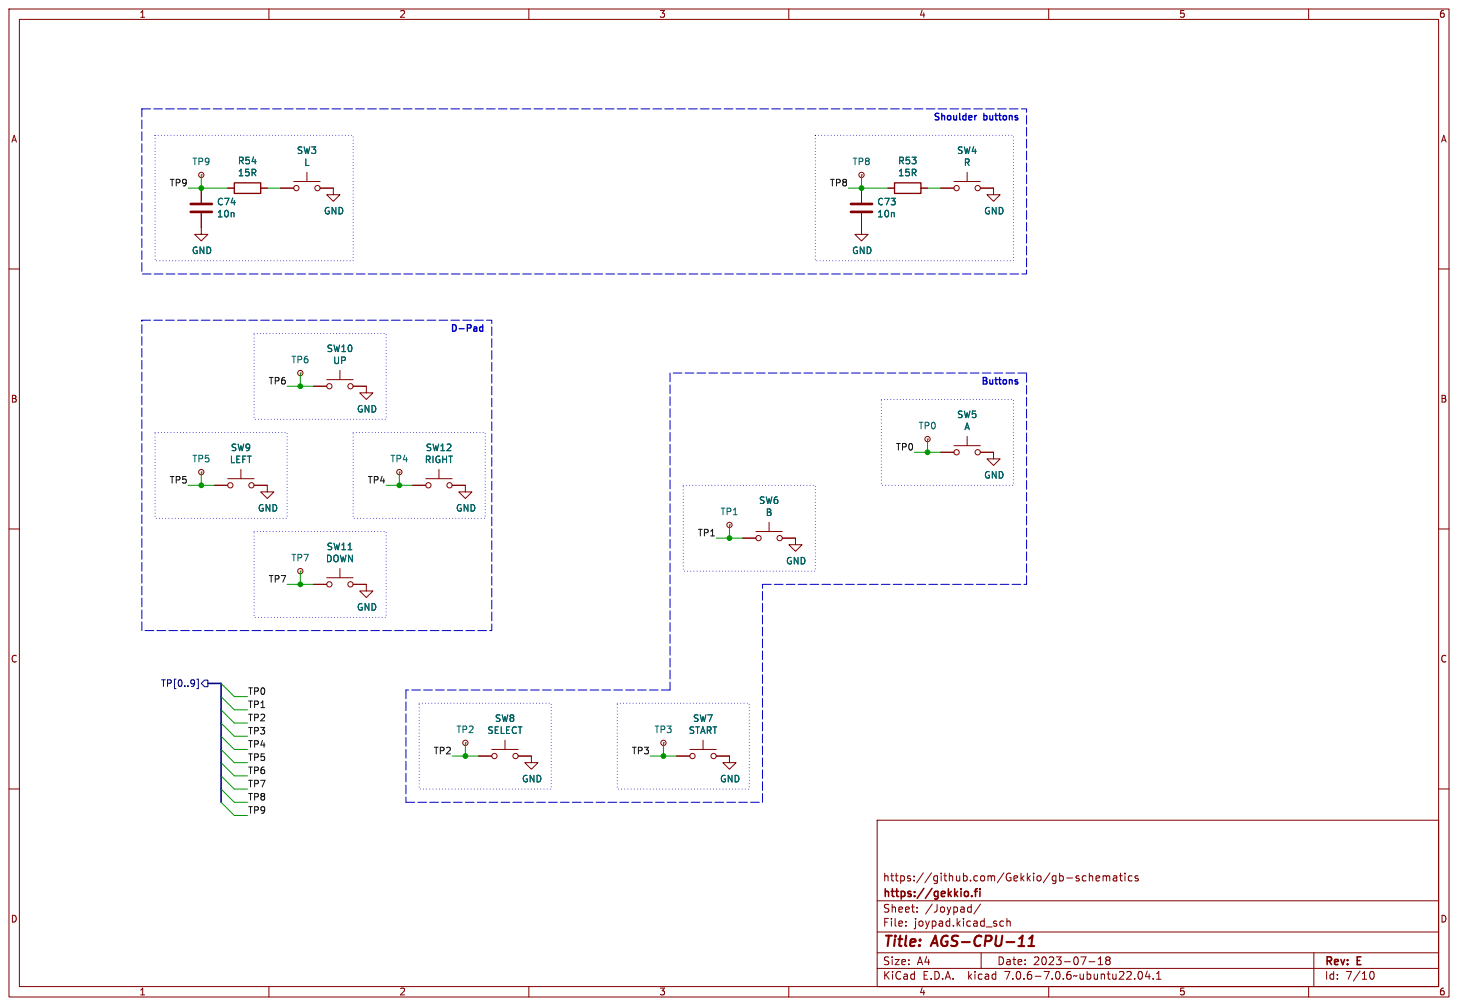
[picture p83: page 7]

https://github.com/Gekkio/gb-schematics
https://gekkio.fi
File: joypad.kicad_sch Sheet: /Joypad/
Id: 7/10 Title: AGS-CPU-11

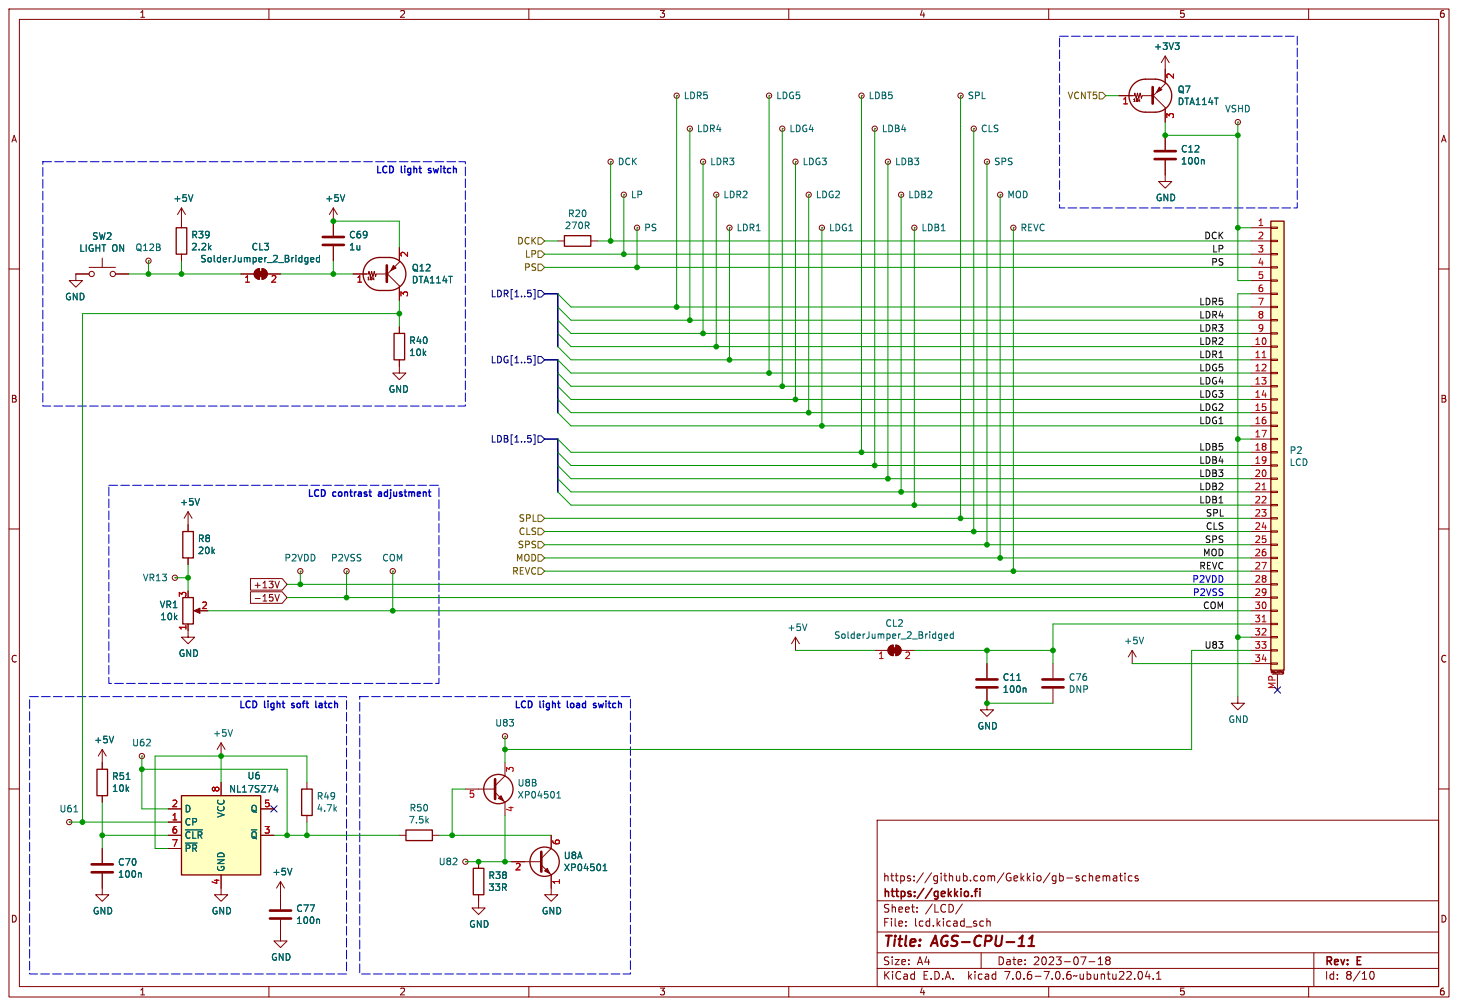
[picture p84: page 8]

LCD light soft latch

Id: 8/10 Title: AGS-CPU-11

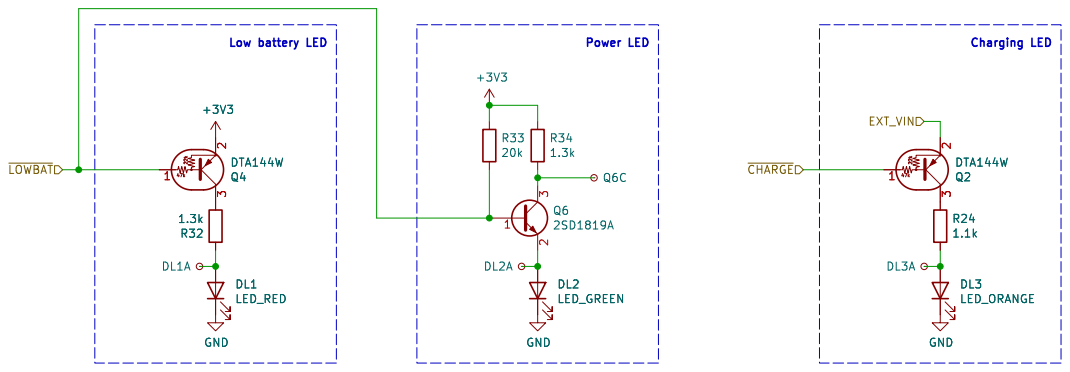
[picture p85: page 9]

https://github.com/Gekkio/gb-schematics DL1
LED_RED

File: leds.kicad_sch Sheet: /LEDs/ https://gekkio.fi

Id: 9/10 Title: AGS-CPU-11

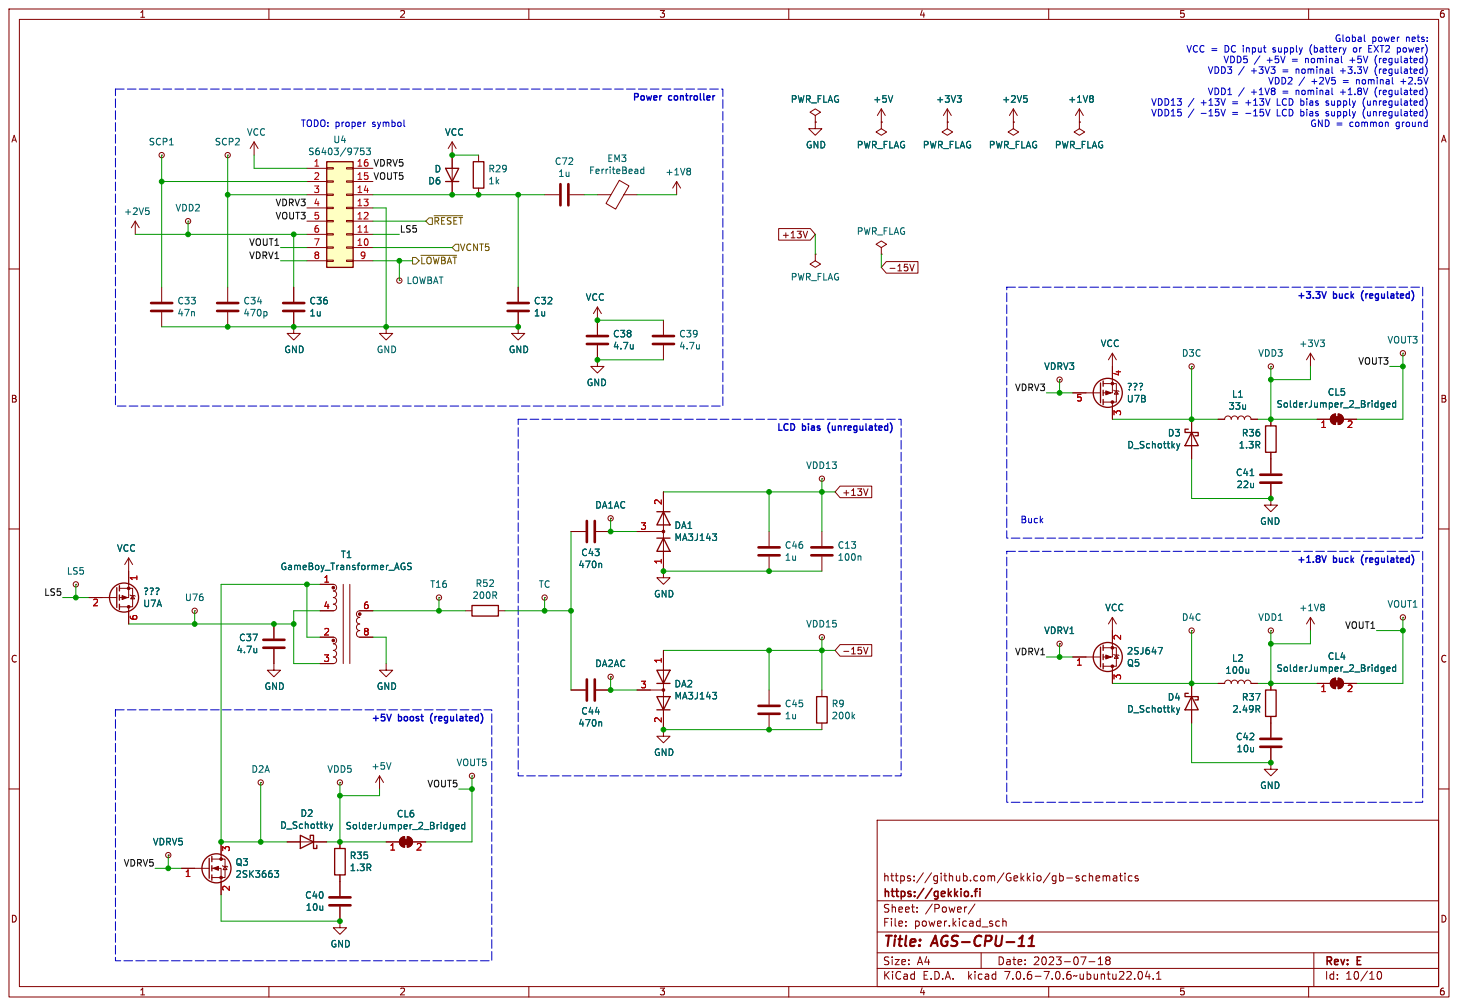
[picture p86: page 10]

https://github.com/Gekkio/gb-schematics GND

File: power.kicad_sch Sheet: /Power/ https://gekkio.fi

Id: 10/10 Title: AGS-CPU-11
