Gekkio/gb-schematics/DMG-JACK/schematic/DMG-JACK.pdf

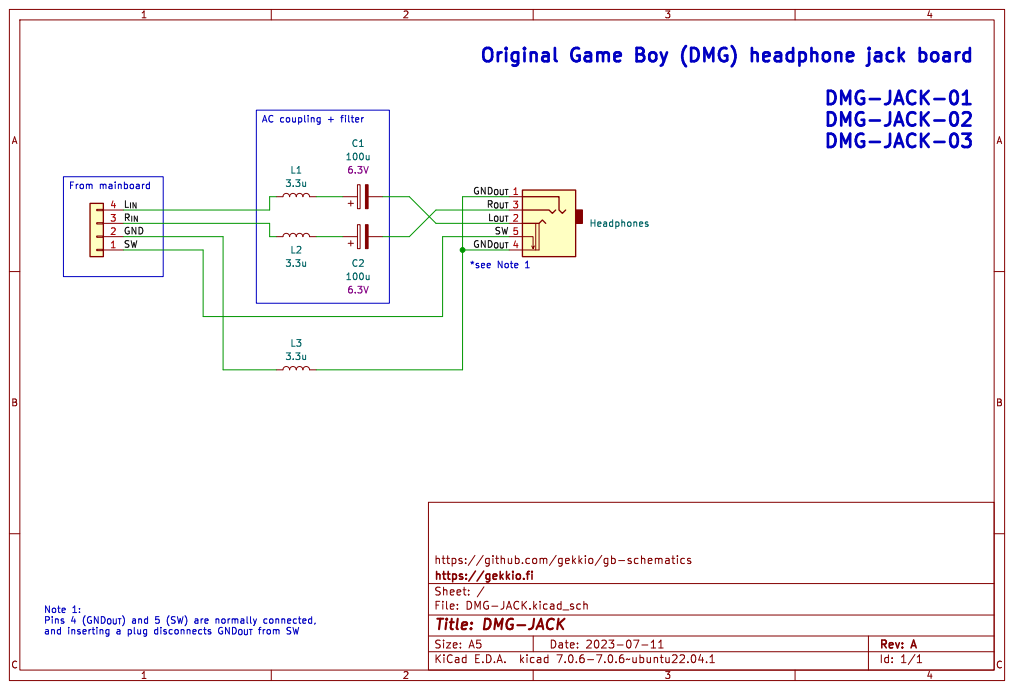
[picture p87: page 1]

https://github.com/gekkio/gb-schematics

Id: 1/1 Title: DMG-JACK
