Gekkio/gb-schematics/AGS-CPU-11/AGS-CPU-11.kicad_sch

## KiCad design AGS-CPU-11/AGS-CPU-11.kicad_sch (2023-07-18)

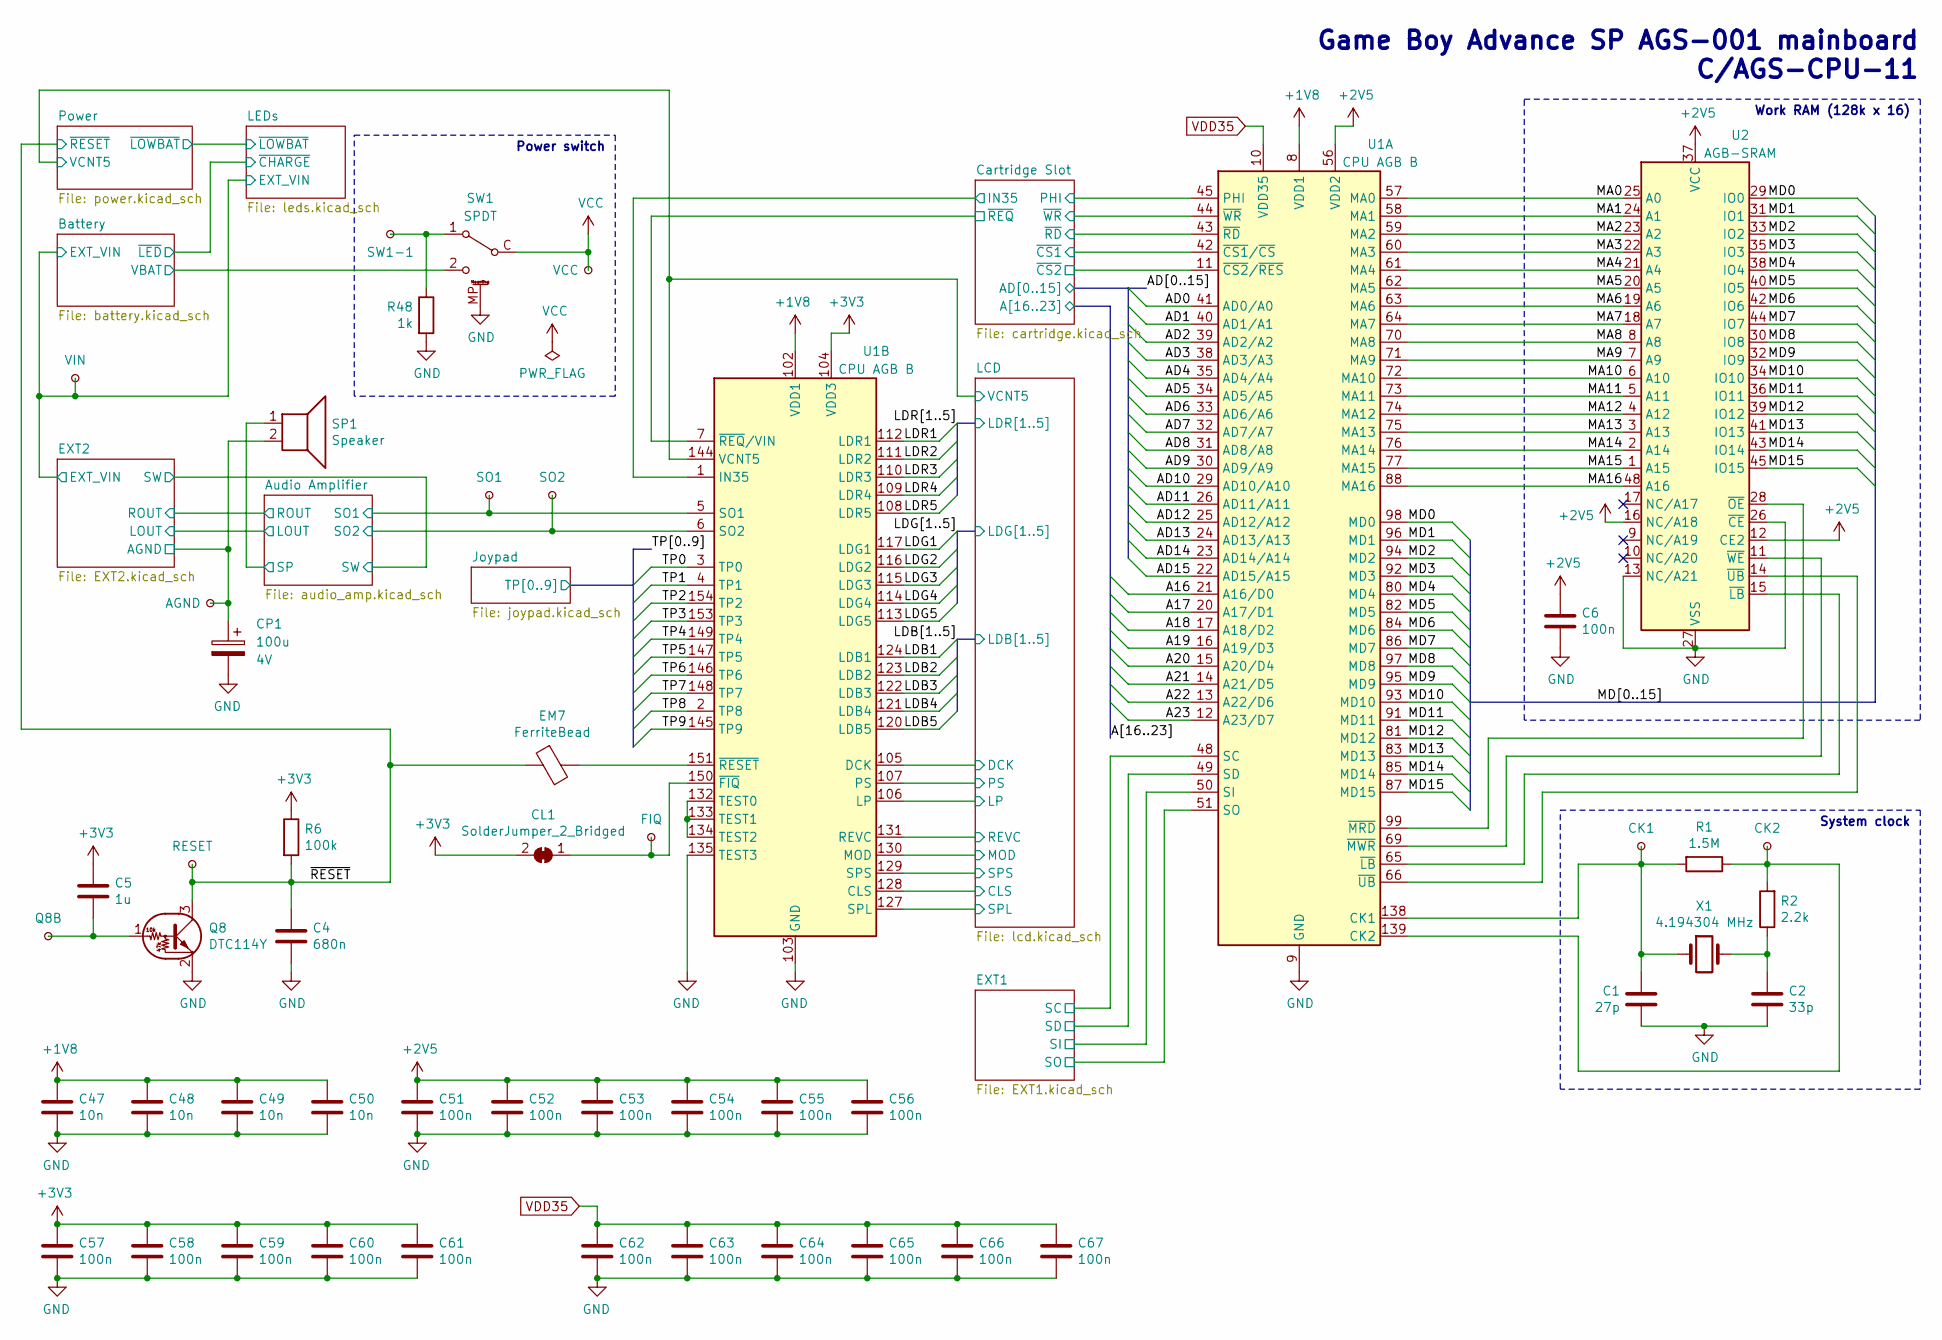
[picture p88: schematic AGS-CPU-11.kicad_sch]

Parts:
C1: 27p
C2: 33p
C4: 680n
C5: 1u
C6, C51, C52, C53, C54, C55, C56, C57, C58, C59, C60, C61, C62, C63, C64, C65, C66, C67: 100n
C47, C48, C49, C50: 10n
CL1: SolderJumper_2_Bridged
CP1: 100u; Rating 4V
EM7: FerriteBead
Q8: DTC114Y
R1: 1.5M
R2: 2.2k
R6: 100k
R48: 1k
SP1: Speaker
SW1: SPDT
TP1: Q8B
TP2: VIN
TP3: RESET
TP4: AGND
TP5: SW1-1
TP6: SO1
TP7: SO2
TP8: VCC
TP9: FIQ
TP10: CK1
TP11: CK2
U1: CPU AGB B; Sharp_QFP-156_14x20mm_P0.4mm
U2: AGB-SRAM
X1: 4.194304 MHz

Connections:
+1V8: C47.1, C48.1, C49.1, C50.1, U1.8 (VDD1), U1.54 (VDD1), U1.102 (VDD1), U1.136 (VDD1)
+2V5: C6.1, C51.1, C52.1, C53.1, C54.1, C55.1, C56.1, U1.56 (VDD2), U1.68 (VDD2), U1.79 (VDD2), U1.89 (VDD2), U1.100 (VDD2), U1.140 (VDD2), U2.12 (CE2), U2.16 (NC/A18), U2.37 (VCC)
+3V3: C5.1, C57.1, C58.1, C59.1, C60.1, C61.1, CL1.2 (B), R6.1, U1.104 (VDD3), U1.119 (VDD3), U1.126 (VDD3), U1.142 (VDD3), U1.155 (VDD3)
A16: U1.21 (A16/D0)
A17: U1.20 (A17/D1)
A18: U1.17 (A18/D2)
A19: U1.16 (A19/D3)
A20: U1.15 (A20/D4)
A21: U1.14 (A21/D5)
A22: U1.13 (A22/D6)
A23: U1.12 (A23/D7)
AD0: U1.41 (AD0/A0)
AD1: U1.40 (AD1/A1)
AD2: U1.39 (AD2/A2)
AD3: U1.38 (AD3/A3)
AD4: U1.35 (AD4/A4)
AD5: U1.34 (AD5/A5)
AD6: U1.33 (AD6/A6)
AD7: U1.32 (AD7/A7)
AD8: U1.31 (AD8/A8)
AD9: U1.30 (AD9/A9)
AD10: U1.29 (AD10/A10)
AD11: U1.26 (AD11/A11)
AD12: U1.25 (AD12/A12)
AD13: U1.24 (AD13/A13)
AD14: U1.23 (AD14/A14)
AD15: U1.22 (AD15/A15)
AGND: CP1.1, SP1.2, TP4.1
CLS: U1.128 (CLS)
DCK: U1.105 (DCK)
EXT_VIN: TP2.1
GND: C1.2, C2.2, C4.2, C6.2, C47.2, C48.2, C49.2, C50.2, C51.2, C52.2, C53.2, C54.2, C55.2, C56.2, C57.2, C58.2, C59.2, C60.2, C61.2, C62.2, C63.2, C64.2, C65.2, C66.2, C67.2, CP1.2, Q8.2 (E), R48.2, SW1.MP, U1.9 (GND), U1.18 (GND), U1.27 (GND), U1.36 (GND), U1.47 (GND), U1.53 (GND), U1.55 (GND), U1.67 (GND), U1.78 (GND), U1.90 (GND), U1.101 (GND), U1.103 (GND), U1.118 (GND), U1.125 (GND), U1.135 (TEST3), U1.137 (GND), U1.141 (GND), U1.143 (GND), U1.156 (GND), U2.13 (NC/A21), U2.26 (~CE), U2.27 (VSS), U2.46 (VSS)
IN35: U1.1 (IN35)
LDB1: U1.124 (LDB1)
LDB2: U1.123 (LDB2)
LDB3: U1.122 (LDB3)
LDB4: U1.121 (LDB4)
LDB5: U1.120 (LDB5)
LDG1: U1.117 (LDG1)
LDG2: U1.116 (LDG2)
LDG3: U1.115 (LDG3)
LDG4: U1.114 (LDG4)
LDG5: U1.113 (LDG5)
LDR1: U1.112 (LDR1)
LDR2: U1.111 (LDR2)
LDR3: U1.110 (LDR3)
LDR4: U1.109 (LDR4)
LDR5: U1.108 (LDR5)
LP: U1.106 (LP)
MA0: U1.57 (MA0), U2.25 (A0)
MA1: U1.58 (MA1), U2.24 (A1)
MA2: U1.59 (MA2), U2.23 (A2)
MA3: U1.60 (MA3), U2.22 (A3)
MA4: U1.61 (MA4), U2.21 (A4)
MA5: U1.62 (MA5), U2.20 (A5)
MA6: U1.63 (MA6), U2.19 (A6)
MA7: U1.64 (MA7), U2.18 (A7)
MA8: U1.70 (MA8), U2.8 (A8)
MA9: U1.71 (MA9), U2.7 (A9)
MA10: U1.72 (MA10), U2.6 (A10)
MA11: U1.73 (MA11), U2.5 (A11)
MA12: U1.74 (MA12), U2.4 (A12)
MA13: U1.75 (MA13), U2.3 (A13)
MA14: U1.76 (MA14), U2.2 (A14)
MA15: U1.77 (MA15), U2.1 (A15)
MA16: U1.88 (MA16), U2.48 (A16)
MD0: U1.98 (MD0), U2.29 (IO0)
MD1: U1.96 (MD1), U2.31 (IO1)
MD2: U1.94 (MD2), U2.33 (IO2)
MD3: U1.92 (MD3), U2.35 (IO3)
MD4: U1.80 (MD4), U2.38 (IO4)
MD5: U1.82 (MD5), U2.40 (IO5)
MD6: U1.84 (MD6), U2.42 (IO6)
MD7: U1.86 (MD7), U2.44 (IO7)
MD8: U1.97 (MD8), U2.30 (IO8)
MD9: U1.95 (MD9), U2.32 (IO9)
MD10: U1.93 (MD10), U2.34 (IO10)
MD11: U1.91 (MD11), U2.36 (IO11)
MD12: U1.81 (MD12), U2.39 (IO12)
MD13: U1.83 (MD13), U2.41 (IO13)
MD14: U1.85 (MD14), U2.43 (IO14)
MD15: U1.87 (MD15), U2.45 (IO15)
MOD: U1.130 (MOD)
unnamed: C1.1, R1.2, TP10.1, U1.138 (CK1), X1.1
unnamed: C2.1, R2.1, X1.2
unnamed: C5.2, Q8.1 (B), TP1.1
unnamed: CL1.1 (A), TP9.1, U1.150 (~FIQ)
unnamed: EM7.2, U1.151 (~RESET)
unnamed: R1.1, R2.2, TP11.1, U1.139 (CK2)
unnamed: R48.1, SW1.1, TP5.1
unnamed: U1.65 (~LB), U2.15 (~LB)
unnamed: U1.66 (~UB), U2.14 (~UB)
unnamed: U1.69 (~MWR), U2.11 (~WE)
unnamed: U1.99 (~MRD), U2.28 (~OE)
unnamed: U1.132 (TEST0), U1.133 (TEST1), U1.134 (TEST2)
PHI: U1.45 (PHI)
PS: U1.107 (PS)
REVC: U1.131 (REVC)
SC: U1.48 (SC)
SD: U1.49 (SD)
SI: U1.50 (SI)
SO: U1.51 (SO)
SO1: TP6.1, U1.5 (SO1)
SO2: TP7.1, U1.6 (SO2)
SP: SP1.1
SPL: U1.127 (SPL)
SPS: U1.129 (SPS)
TP0: U1.3 (TP0)
TP1: U1.4 (TP1)
TP2: U1.154 (TP2)
TP3: U1.153 (TP3)
TP4: U1.149 (TP4)
TP5: U1.147 (TP5)
TP6: U1.146 (TP6)
TP7: U1.148 (TP7)
TP8: U1.2 (TP8)
TP9: U1.145 (TP9)
VBAT: SW1.2
VCC: SW1.C, TP8.1
VCNT5: U1.144 (VCNT5)
VDD35: C62.1, C63.1, C64.1, C65.1, C66.1, C67.1, U1.10 (VDD35), U1.19 (VDD35), U1.28 (VDD35), U1.37 (VDD35), U1.46 (VDD35), U1.52 (VDD35)
~CS1: U1.42 (~CS1/~CS)
~CS2: U1.11 (~CS2/~RES)
~RD: U1.43 (~RD)
~REQ: U1.7 (~REQ/VIN)
~RESET: C4.1, EM7.1, Q8.3 (C), R6.2, TP3.1
~WR: U1.44 (~WR)

Notes on the sheet:
Game Boy Advance SP AGS-001 mainboard C/AGS-CPU-11
Power switch
System clock
Work RAM (128k x 16)
