Gekkio/gb-schematics/AGS-CPU-11/EXT1.kicad_sch

## KiCad design AGS-CPU-11/EXT1.kicad_sch (2023-07-18)

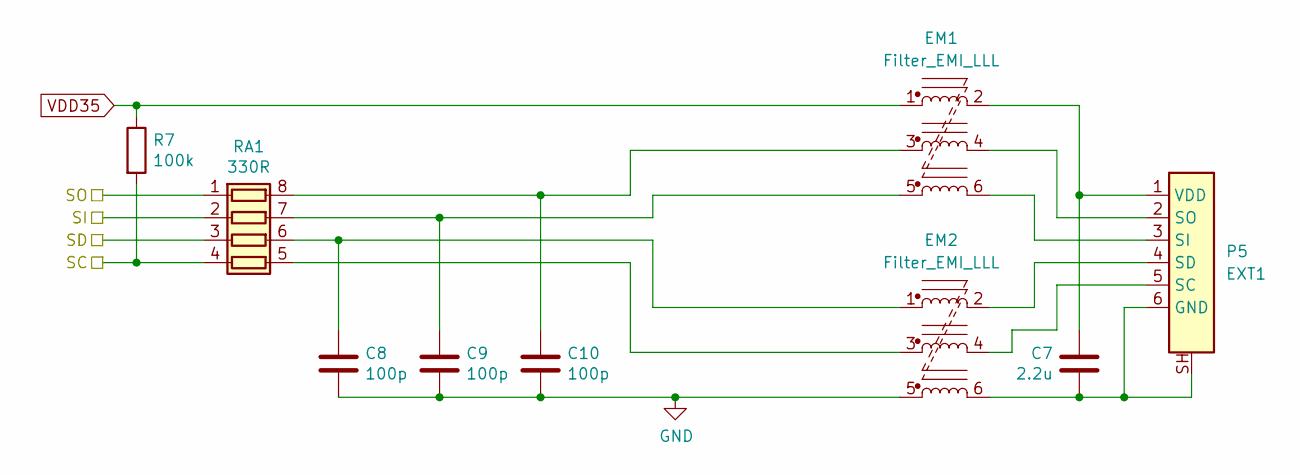
[picture p89: schematic EXT1.kicad_sch]

Parts:
C7: 2.2u
C8, C9, C10: 100p
EM1, EM2: Filter_EMI_LLL
P5: EXT1
R7: 100k
RA1: 330R

Connections:
GND: C8.2, C9.2, C10.2, EM2.5
unnamed: C7.1, EM1.2, P5.1 (VDD)
unnamed: C7.2, EM2.6, P5.6 (GND), P5.SH
unnamed: C8.1, EM2.1, RA1.6 (R3.2)
unnamed: C9.1, EM1.5, RA1.7 (R2.2)
unnamed: C10.1, EM1.3, RA1.8 (R1.2)
unnamed: EM1.4, P5.2 (SO)
unnamed: EM1.6, P5.3 (SI)
unnamed: EM2.2, P5.4 (SD)
unnamed: EM2.3, RA1.5 (R4.2)
unnamed: EM2.4, P5.5 (SC)
SC: R7.2, RA1.4 (R4.1)
SD: RA1.3 (R3.1)
SI: RA1.2 (R2.1)
SO: RA1.1 (R1.1)
VDD35: EM1.1, R7.1
