Gekkio/gb-schematics/AGS-CPU-11/EXT2.kicad_sch

## KiCad design AGS-CPU-11/EXT2.kicad_sch (2023-07-18)

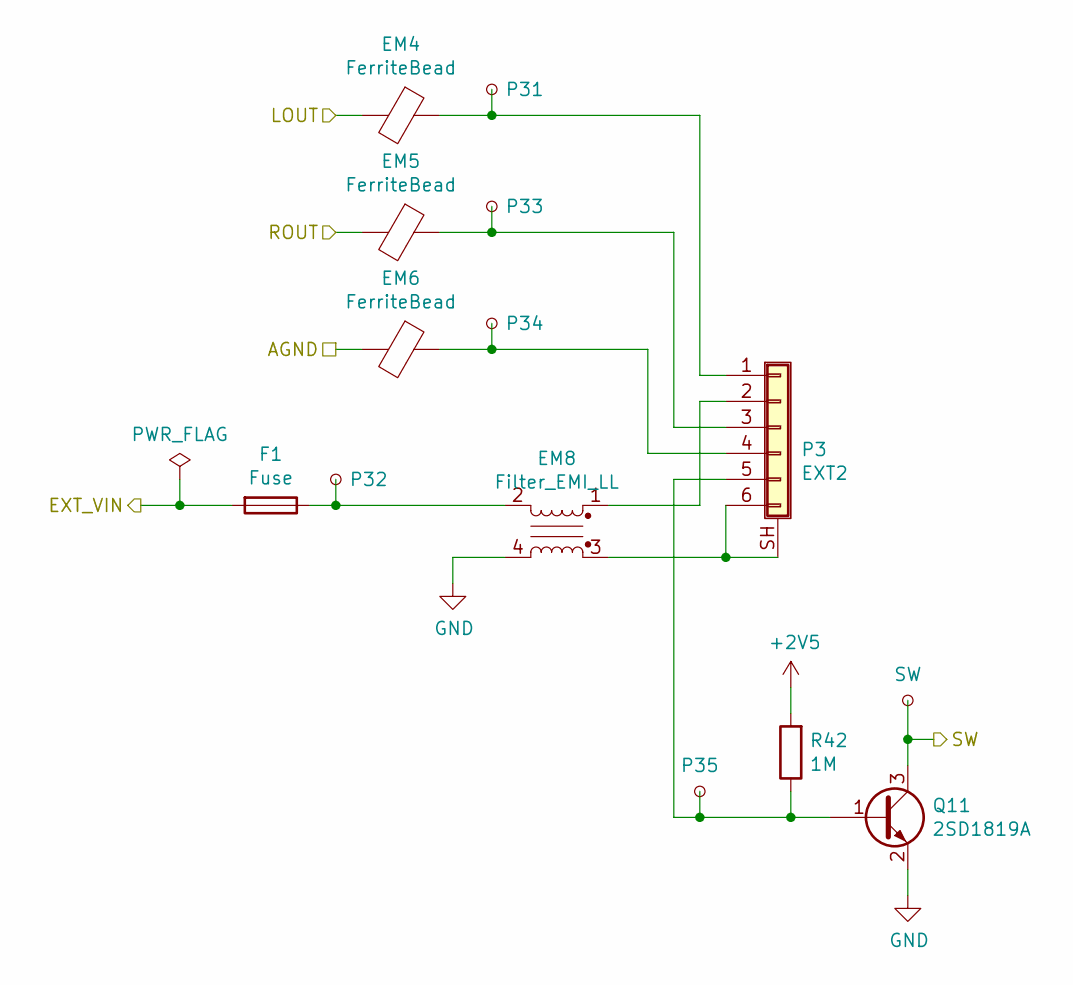
[picture p90: schematic EXT2.kicad_sch]

Parts:
EM4, EM5, EM6: FerriteBead
EM8: Filter_EMI_LL
F1: Fuse
P3: EXT2
Q11: 2SD1819A
R42: 1M
TP104: P32
TP105: P31
TP106: P33
TP107: P34
TP108: P35
TP109: SW

Connections:
+2V5: R42.2
AGND: EM6.2
EXT_VIN: F1.2
GND: EM8.4, Q11.2 (E)
LOUT: EM4.2
unnamed: EM4.1, P3.1, TP105.1
unnamed: EM5.1, P3.3, TP106.1
unnamed: EM6.1, P3.4, TP107.1
unnamed: EM8.1, P3.2
unnamed: EM8.2, F1.1, TP104.1
unnamed: EM8.3, P3.6, P3.SH (Shield)
unnamed: P3.5, Q11.1 (B), R42.1, TP108.1
ROUT: EM5.2
SW: Q11.3 (C), TP109.1
