Gekkio/gb-schematics/AGS-CPU-11/audio_amp.kicad_sch

## KiCad design AGS-CPU-11/audio_amp.kicad_sch (2023-07-18)

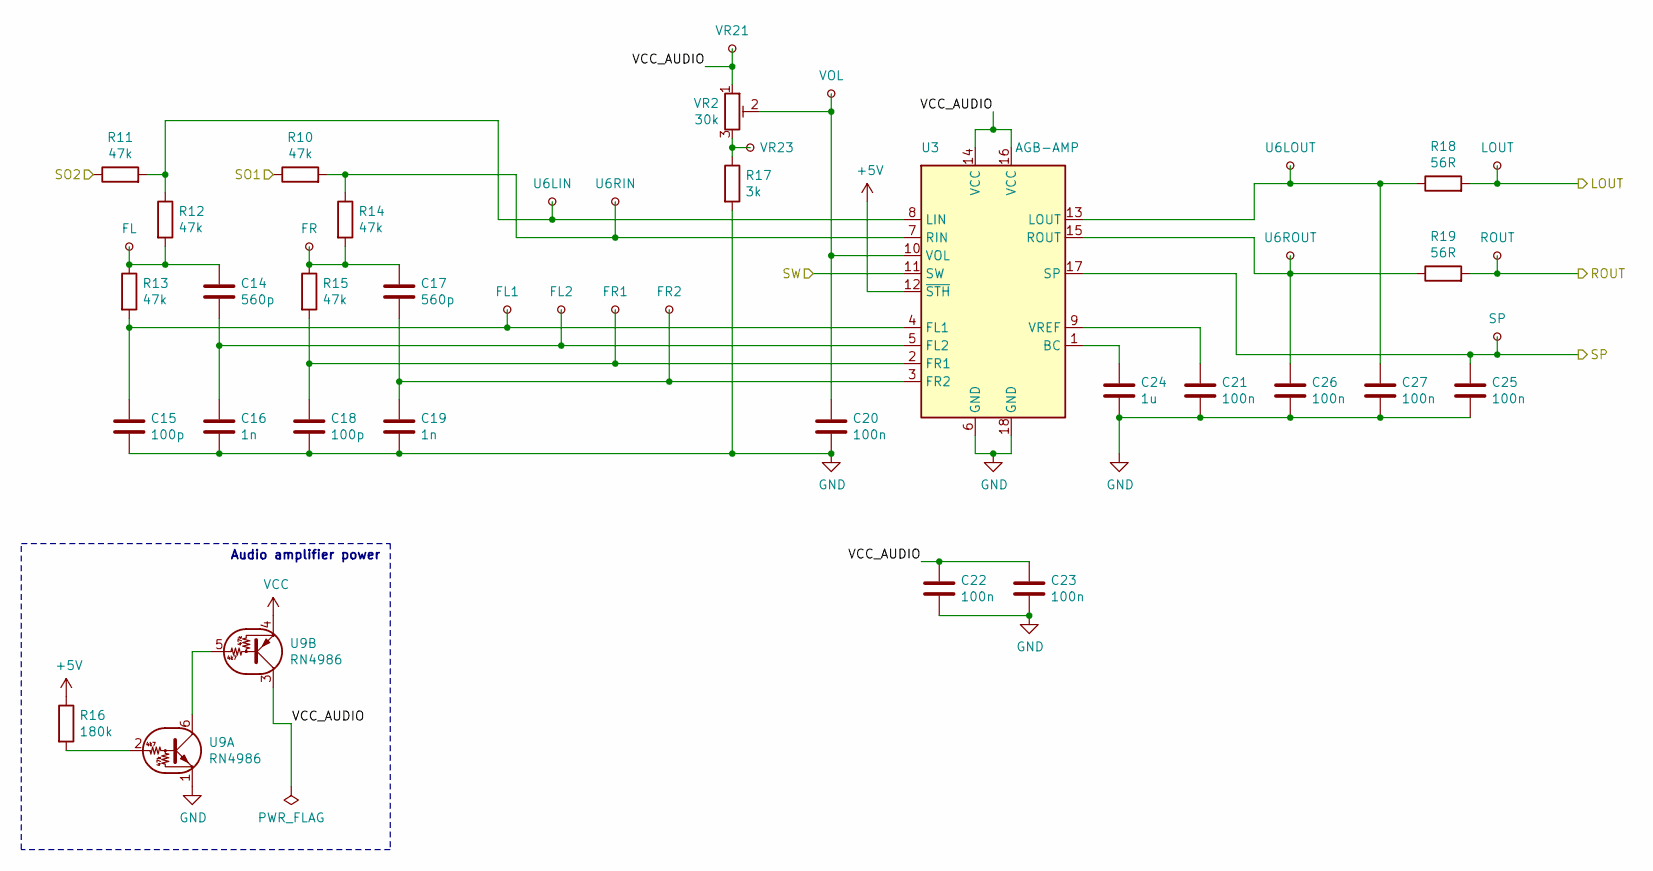
[picture p91: schematic audio_amp.kicad_sch]

Parts:
C14, C17: 560p
C15, C18: 100p
C16, C19: 1n
C20, C21, C22, C23, C25, C26, C27: 100n
C24: 1u
R10, R11, R12, R13, R14, R15: 47k
R16: 180k
R17: 3k
R18, R19: 56R
TP51: FL
TP52: FR
TP53: FL1
TP54: U6LIN
TP55: FL2
TP56: U6RIN
TP57: FR1
TP58: FR2
TP59: VR21
TP60: VR23
TP61: VOL
TP62: U6LOUT
TP63: U6ROUT
TP64: LOUT
TP65: ROUT
TP66: SP
U3: AGB-AMP; Sharp_SSOP-18_6x7.4mm_P0.8mm
U9: RN4986; SOT-363_SC-70-6
VR2: 30k

Connections:
+5V: R16.1, U3.12 (~STH)
GND: C15.2, C16.2, C18.2, C19.2, C20.2, C21.2, C22.2, C23.2, C24.2, C25.2, C26.2, C27.2, R17.2, U3.6 (GND), U3.18 (GND), U9.1 (E)
LOUT: R18.2, TP64.1
unnamed: C14.1, R12.2, R13.1, TP51.1
unnamed: C14.2, C16.1, TP55.1, U3.5 (FL2)
unnamed: C15.1, R13.2, TP53.1, U3.4 (FL1)
unnamed: C17.1, R14.2, R15.1, TP52.1
unnamed: C17.2, C19.1, TP58.1, U3.3 (FR2)
unnamed: C18.1, R15.2, TP57.1, U3.2 (FR1)
unnamed: C20.1, TP61.1, U3.10 (VOL), VR2.2
unnamed: C21.1, U3.9 (VREF)
unnamed: C24.1, U3.1 (BC)
unnamed: C26.1, R19.1, TP63.1, U3.15 (ROUT)
unnamed: C27.1, R18.1, TP62.1, U3.13 (LOUT)
unnamed: R10.2, R14.1, TP56.1, U3.7 (RIN)
unnamed: R11.2, R12.1, TP54.1, U3.8 (LIN)
unnamed: R16.2, U9.2 (B)
unnamed: R17.1, TP60.1, VR2.3
unnamed: U9.5 (B), U9.6 (C)
ROUT: R19.2, TP65.1
SO1: R10.1
SO2: R11.1
SP: C25.1, TP66.1, U3.17 (SP)
SW: U3.11 (SW)
VCC: U9.4 (E)
VCC_AUDIO: C22.1, C23.1, TP59.1, U3.14 (VCC), U3.16 (VCC), U9.3 (C), VR2.1

Notes on the sheet:
Audio amplifier power
