Gekkio/gb-schematics/AGS-CPU-11/battery.kicad_sch

## KiCad design AGS-CPU-11/battery.kicad_sch (2023-07-18)

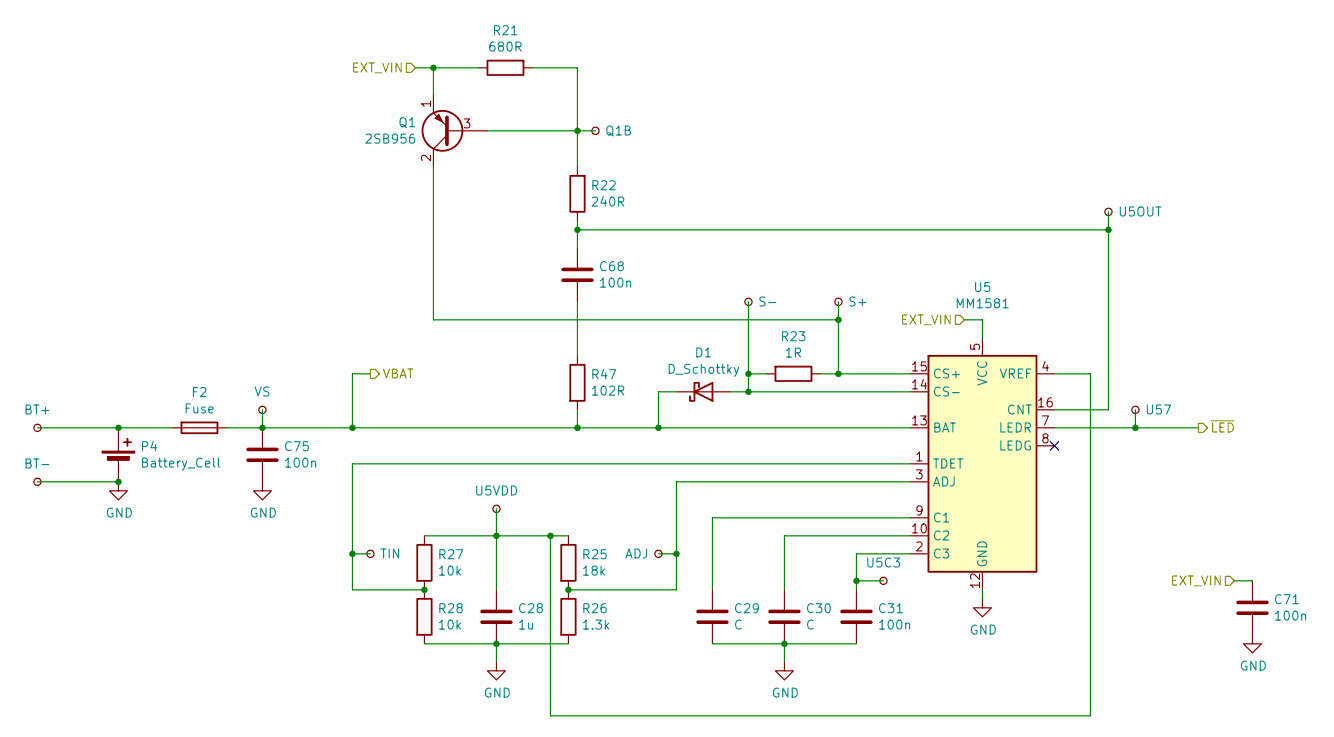
[picture p92: schematic battery.kicad_sch]

Parts:
C28: 1u
C29, C30: C
C31, C68, C71, C75: 100n
D1: D_Schottky
F2: Fuse
P4: Battery_Cell
Q1: 2SB956
R21: 680R
R22: 240R
R23: 1R
R25: 18k
R26: 1.3k
R27, R28: 10k
R47: 102R
TP110: BT+
TP111: BT-
TP112: VS
TP113: TIN
TP114: U5VDD
TP115: Q1B
TP116: ADJ
TP117: S-
TP118: S+
TP119: U5C3
TP120: U5OUT
TP121: U57
U5: MM1581; TSSOP-16_4.4x5mm_P0.65mm

Connections:
EXT_VIN: C71.1, Q1.1 (E), R21.1, U5.5 (VCC)
GND: C28.2, C29.2, C30.2, C31.2, C71.2, C75.2, P4.2 (-), R26.2, R28.2, TP111.1, U5.12 (GND)
unnamed: C28.1, R25.1, R27.1, TP114.1, U5.4 (VREF)
unnamed: C29.1, U5.9 (C1)
unnamed: C30.1, U5.10 (C2)
unnamed: C31.1, TP119.1, U5.2 (C3)
unnamed: C68.1, R22.1, TP120.1, U5.16 (CNT)
unnamed: C68.2, R47.1
unnamed: D1.2 (A), R23.2, TP117.1, U5.14 (CS-)
unnamed: F2.2, P4.1 (+), TP110.1
unnamed: Q1.2 (C), R23.1, TP118.1, U5.15 (CS+)
unnamed: Q1.3 (B), R21.2, R22.2, TP115.1
unnamed: R25.2, R26.1, TP116.1, U5.3 (ADJ)
unnamed: R27.2, R28.1, TP113.1, U5.1 (TDET)
VBAT: C75.1, D1.1 (K), F2.1, R47.2, TP112.1, U5.13 (BAT)
~LED: TP121.1, U5.7 (LEDR)
