Gekkio/gb-schematics/AGS-CPU-11/cartridge.kicad_sch

## KiCad design AGS-CPU-11/cartridge.kicad_sch (2023-07-18)

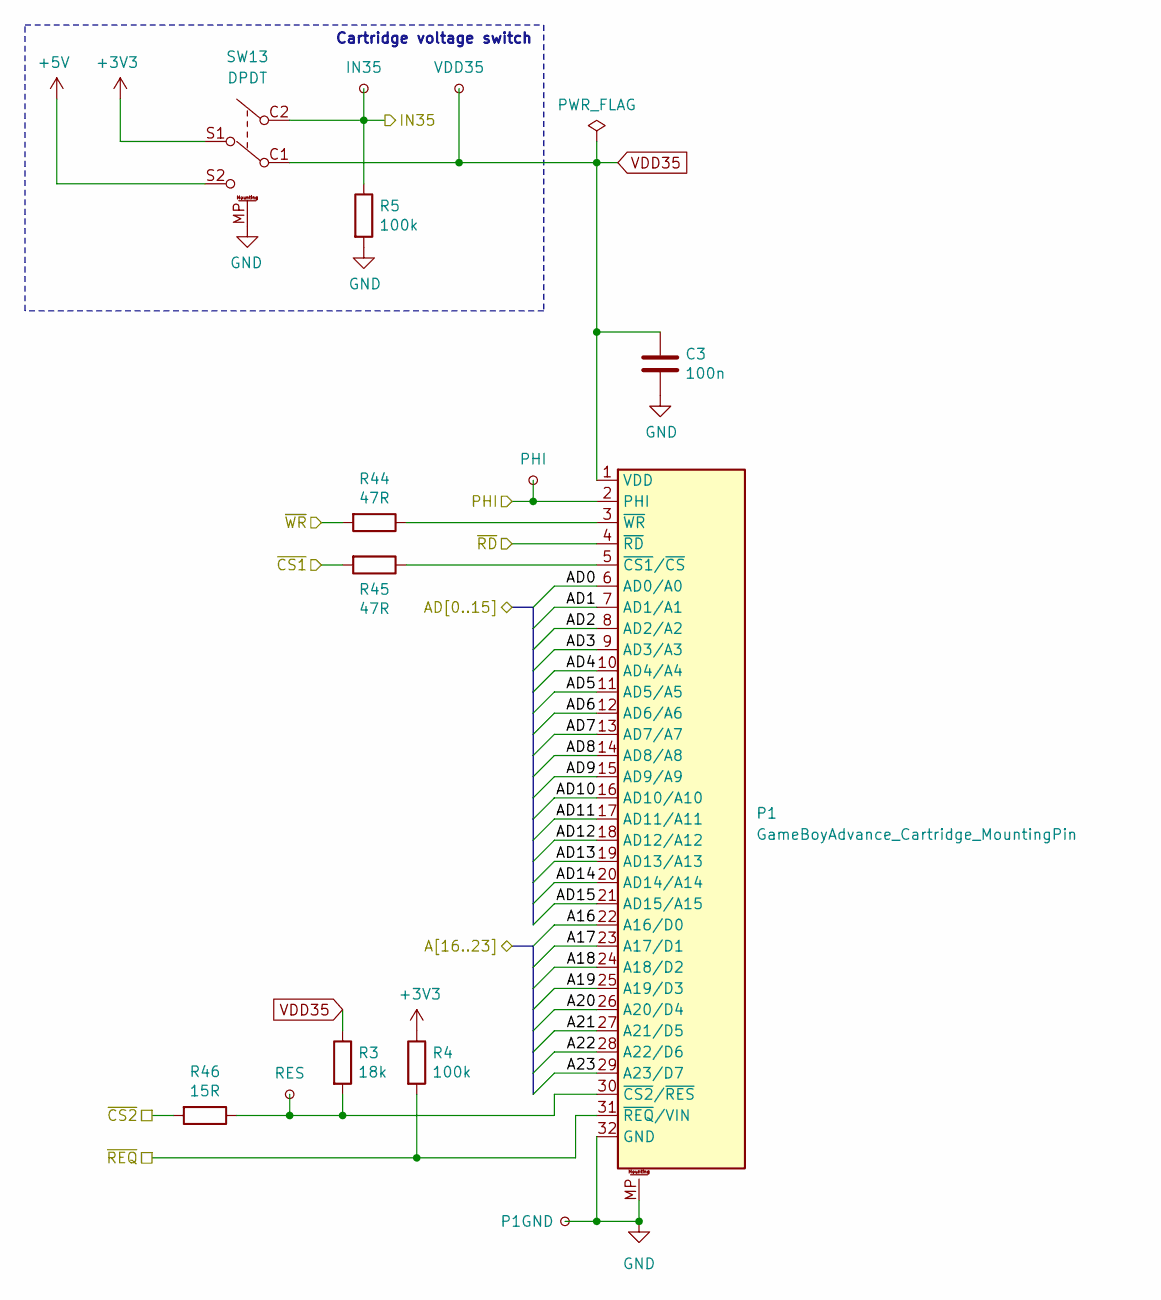
[picture p93: schematic cartridge.kicad_sch]

Parts:
C3: 100n
P1: GameBoyAdvance_Cartridge_MountingPin
R3: 18k
R4, R5: 100k
R44, R45: 47R
R46: 15R
SW13: DPDT
TP46: RES
TP47: IN35
TP48: VDD35
TP49: PHI
TP50: P1GND

Connections:
+3V3: R4.1, SW13.S1
+5V: SW13.S2
A16: P1.22 (A16/D0)
A17: P1.23 (A17/D1)
A18: P1.24 (A18/D2)
A19: P1.25 (A19/D3)
A20: P1.26 (A20/D4)
A21: P1.27 (A21/D5)
A22: P1.28 (A22/D6)
A23: P1.29 (A23/D7)
AD0: P1.6 (AD0/A0)
AD1: P1.7 (AD1/A1)
AD2: P1.8 (AD2/A2)
AD3: P1.9 (AD3/A3)
AD4: P1.10 (AD4/A4)
AD5: P1.11 (AD5/A5)
AD6: P1.12 (AD6/A6)
AD7: P1.13 (AD7/A7)
AD8: P1.14 (AD8/A8)
AD9: P1.15 (AD9/A9)
AD10: P1.16 (AD10/A10)
AD11: P1.17 (AD11/A11)
AD12: P1.18 (AD12/A12)
AD13: P1.19 (AD13/A13)
AD14: P1.20 (AD14/A14)
AD15: P1.21 (AD15/A15)
GND: C3.2, P1.32 (GND), P1.MP, R5.2, SW13.MP, TP50.1
IN35: R5.1, SW13.C2, TP47.1
unnamed: P1.3 (~WR), R44.1
unnamed: P1.5 (~CS1/~CS), R45.1
unnamed: P1.30 (~CS2/~RES), R3.2, R46.1, TP46.1
PHI: P1.2 (PHI), TP49.1
VDD35: C3.1, P1.1 (VDD), R3.1, SW13.C1, TP48.1
~CS1: R45.2
~CS2: R46.2
~RD: P1.4 (~RD)
~REQ: P1.31 (~REQ/VIN), R4.2
~WR: R44.2

Notes on the sheet:
Cartridge voltage switch
