Gekkio/gb-schematics/AGS-CPU-11/joypad.kicad_sch

## KiCad design AGS-CPU-11/joypad.kicad_sch (2023-07-18)

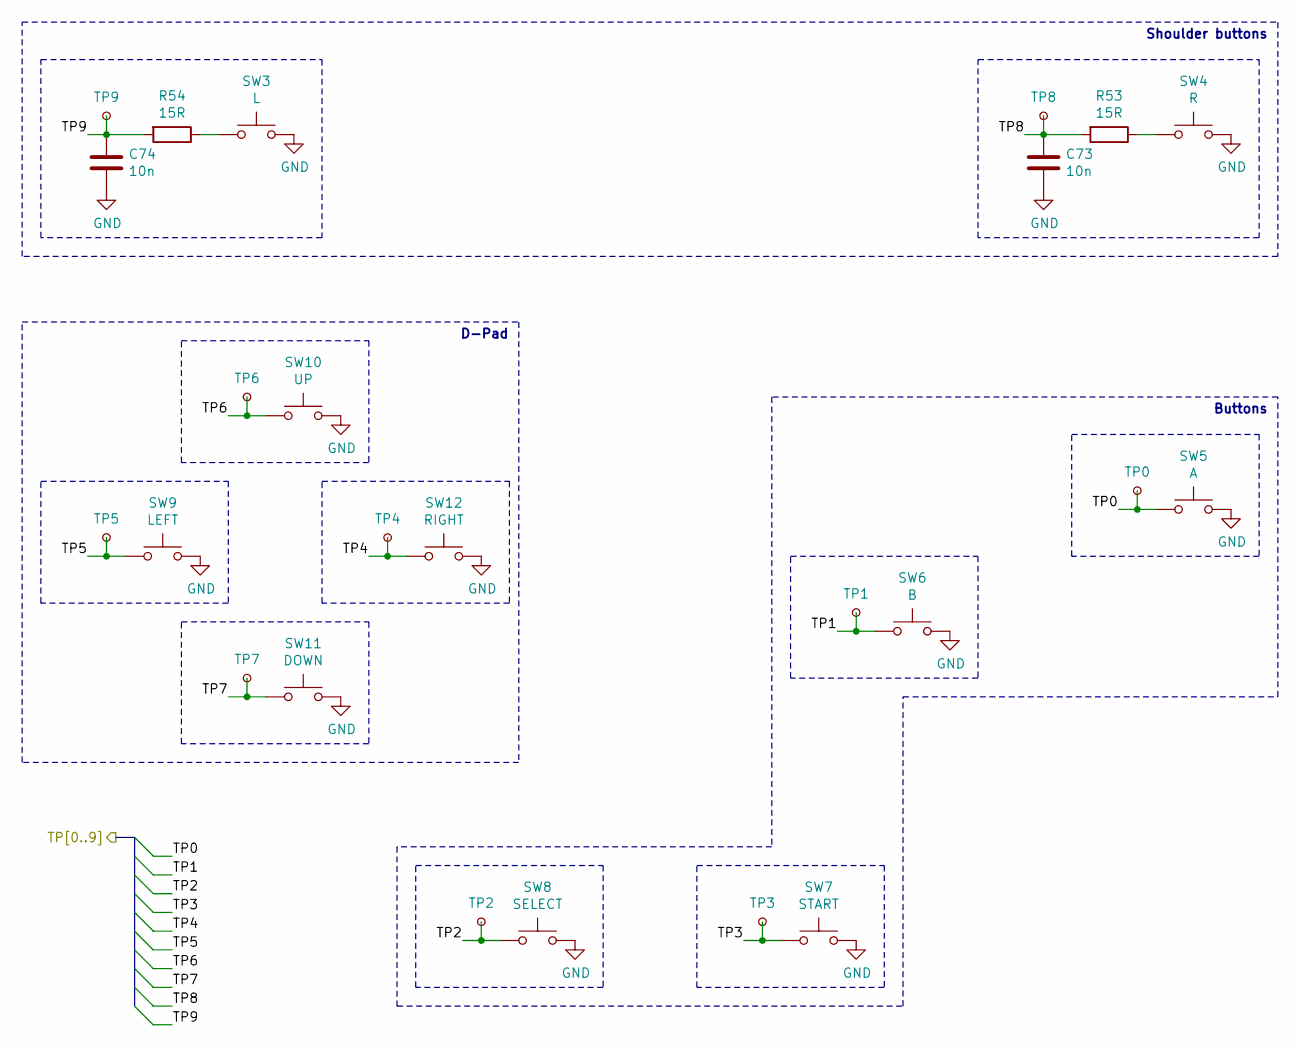
[picture p94: schematic joypad.kicad_sch]

Parts:
C73, C74: 10n
R53, R54: 15R
SW3: L
SW4: R
SW5: A
SW6: B
SW7: START
SW8: SELECT
SW9: LEFT
SW10: UP
SW11: DOWN
SW12: RIGHT
TP36: TP9
TP37: TP5
TP38: TP6
TP39: TP7
TP40: TP4
TP41: TP2
TP42: TP3
TP43: TP1
TP44: TP8
TP45: TP0

Connections:
GND: C73.2, C74.2, SW3.2, SW4.2, SW5.2, SW6.2, SW7.2, SW8.2, SW9.2, SW10.2, SW11.2, SW12.2
unnamed: R53.1, SW4.1
unnamed: R54.1, SW3.1
TP0: SW5.1, TP45.1
TP1: SW6.1, TP43.1
TP2: SW8.1, TP41.1
TP3: SW7.1, TP42.1
TP4: SW12.1, TP40.1
TP5: SW9.1, TP37.1
TP6: SW10.1, TP38.1
TP7: SW11.1, TP39.1
TP8: C73.1, R53.2, TP44.1
TP9: C74.1, R54.2, TP36.1

Notes on the sheet:
D-Pad
Shoulder buttons
Buttons
