Gekkio/gb-schematics/AGS-CPU-11/lcd.kicad_sch

## KiCad design AGS-CPU-11/lcd.kicad_sch (2023-07-18)

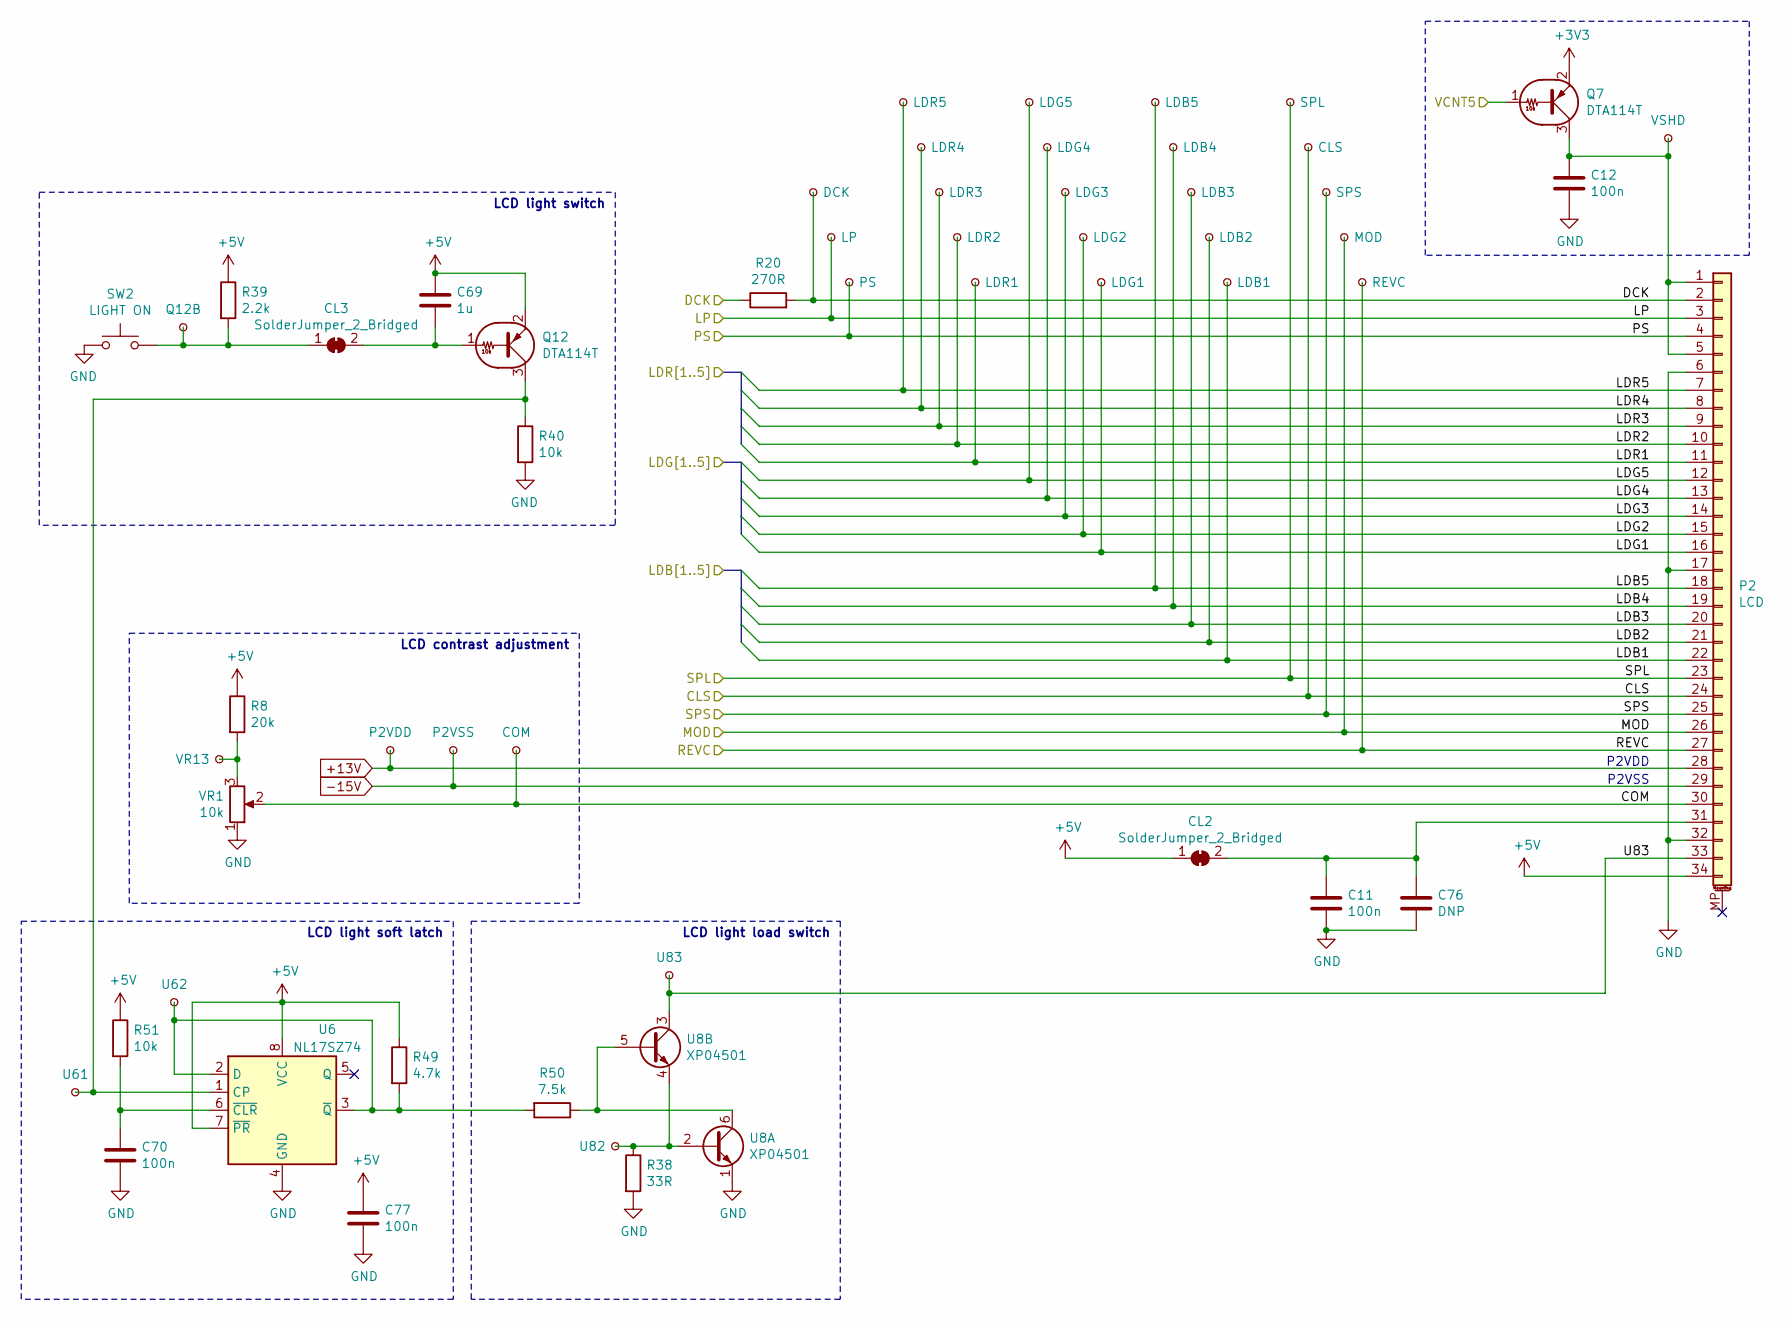
[picture p95: schematic lcd.kicad_sch]

Parts:
C11, C12, C70, C77: 100n
C69: 1u
C76: DNP
CL2, CL3: SolderJumper_2_Bridged
P2: LCD
Q7, Q12: DTA114T
R8: 20k
R20: 270R
R38: 33R
R39: 2.2k
R40, R51: 10k
R49: 4.7k
R50: 7.5k
SW2: LIGHT ON
TP67: U61
TP68: U62
TP69: Q12B
TP70: VR13
TP71: P2VDD
TP72: P2VSS
TP73: COM
TP74: U82
TP75: U83
TP76: DCK
TP77: LP
TP78: PS
TP79: LDR5
TP80: LDR4
TP81: LDR3
TP82: LDR2
TP83: LDR1
TP84: LDG5
TP85: LDG4
TP86: LDG3
TP87: LDG2
TP88: LDG1
TP89: LDB5
TP90: LDB4
TP91: LDB3
TP92: LDB2
TP93: LDB1
TP94: SPL
TP95: CLS
TP96: SPS
TP97: MOD
TP98: REVC
TP99: VSHD
U6: NL17SZ74
U8: XP04501
VR1: 10k

Connections:
+3V3: Q7.2 (E)
+5V: C69.1, C77.1, CL2.1 (A), P2.34, Q12.2 (E), R8.1, R39.1, R49.1, R51.1, U6.7 (~PR), U6.8 (VCC)
+13V: P2.28, TP71.1
-15V: P2.29, TP72.1
CLS: P2.24, TP95.1
COM: P2.30, TP73.1, VR1.2
DCK: P2.2, R20.1, R20.2, TP76.1
GND: C11.2, C12.2, C70.2, C76.2, C77.2, P2.6, P2.17, P2.32, R38.2, R40.2, SW2.2, U6.4 (GND), U8.1 (E1), VR1.1
LDB1: P2.22, TP93.1
LDB2: P2.21, TP92.1
LDB3: P2.20, TP91.1
LDB4: P2.19, TP90.1
LDB5: P2.18, TP89.1
LDG1: P2.16, TP88.1
LDG2: P2.15, TP87.1
LDG3: P2.14, TP86.1
LDG4: P2.13, TP85.1
LDG5: P2.12, TP84.1
LDR1: P2.11, TP83.1
LDR2: P2.10, TP82.1
LDR3: P2.9, TP81.1
LDR4: P2.8, TP80.1
LDR5: P2.7, TP79.1
LP: P2.3, TP77.1
MOD: P2.26, TP97.1
unnamed: C11.1, C76.1, CL2.2 (B), P2.31
unnamed: C12.1, P2.1, P2.5, Q7.3 (C), TP99.1
unnamed: C69.2, CL3.2 (B), Q12.1 (B)
unnamed: C70.1, R51.2, U6.6 (~CLR)
unnamed: CL3.1 (A), R39.2, SW2.1, TP69.1
unnamed: Q12.3 (C), R40.1, TP67.1, U6.1 (CP)
unnamed: R8.2, TP70.1, VR1.3
unnamed: R38.1, TP74.1, U8.2 (B1), U8.4 (E2)
unnamed: R49.2, R50.2, TP68.1, U6.2 (D), U6.3 (~Q)
unnamed: R50.1, U8.5 (B2), U8.6 (C1)
PS: P2.4, TP78.1
REVC: P2.27, TP98.1
SPL: P2.23, TP94.1
SPS: P2.25, TP96.1
U83: P2.33, TP75.1, U8.3 (C2)
VCNT5: Q7.1 (B)

Notes on the sheet:
LCD light switch
P2VDD
LCD light load switch
P2VSS
LCD contrast adjustment
LCD light soft latch
