Gekkio/gb-schematics/AGS-CPU-11/leds.kicad_sch

## KiCad design AGS-CPU-11/leds.kicad_sch (2023-07-18)

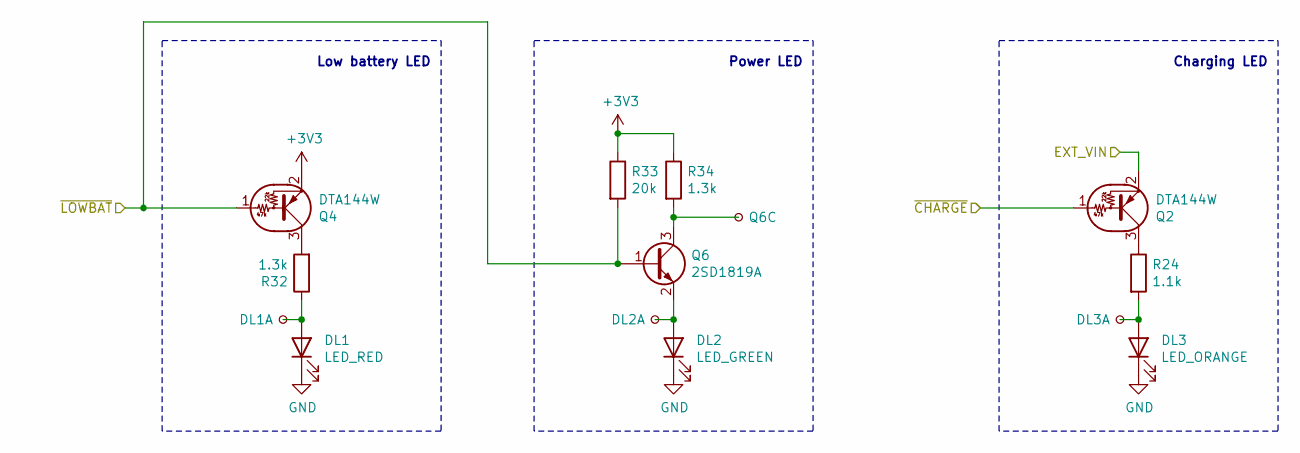
[picture p96: schematic leds.kicad_sch]

Parts:
DL1: LED_RED
DL2: LED_GREEN
DL3: LED_ORANGE
Q2, Q4: DTA144W
Q6: 2SD1819A
R24: 1.1k
R32, R34: 1.3k
R33: 20k
TP100: DL1A
TP101: DL2A
TP102: Q6C
TP103: DL3A

Connections:
+3V3: Q4.2 (E), R33.1, R34.1
EXT_VIN: Q2.2 (E)
GND: DL1.1 (K), DL2.1 (K), DL3.1 (K)
unnamed: DL1.2 (A), R32.1, TP100.1
unnamed: DL2.2 (A), Q6.2 (E), TP101.1
unnamed: DL3.2 (A), R24.2, TP103.1
unnamed: Q2.3 (C), R24.1
unnamed: Q4.3 (C), R32.2
unnamed: Q6.3 (C), R34.2, TP102.1
~CHARGE: Q2.1 (B)
~LOWBAT: Q4.1 (B), Q6.1 (B), R33.2

Notes on the sheet:
Charging LED
Power LED
Low battery LED
