Gekkio/gb-schematics/AGS-CPU-11/power.kicad_sch

## KiCad design AGS-CPU-11/power.kicad_sch (2023-07-18)

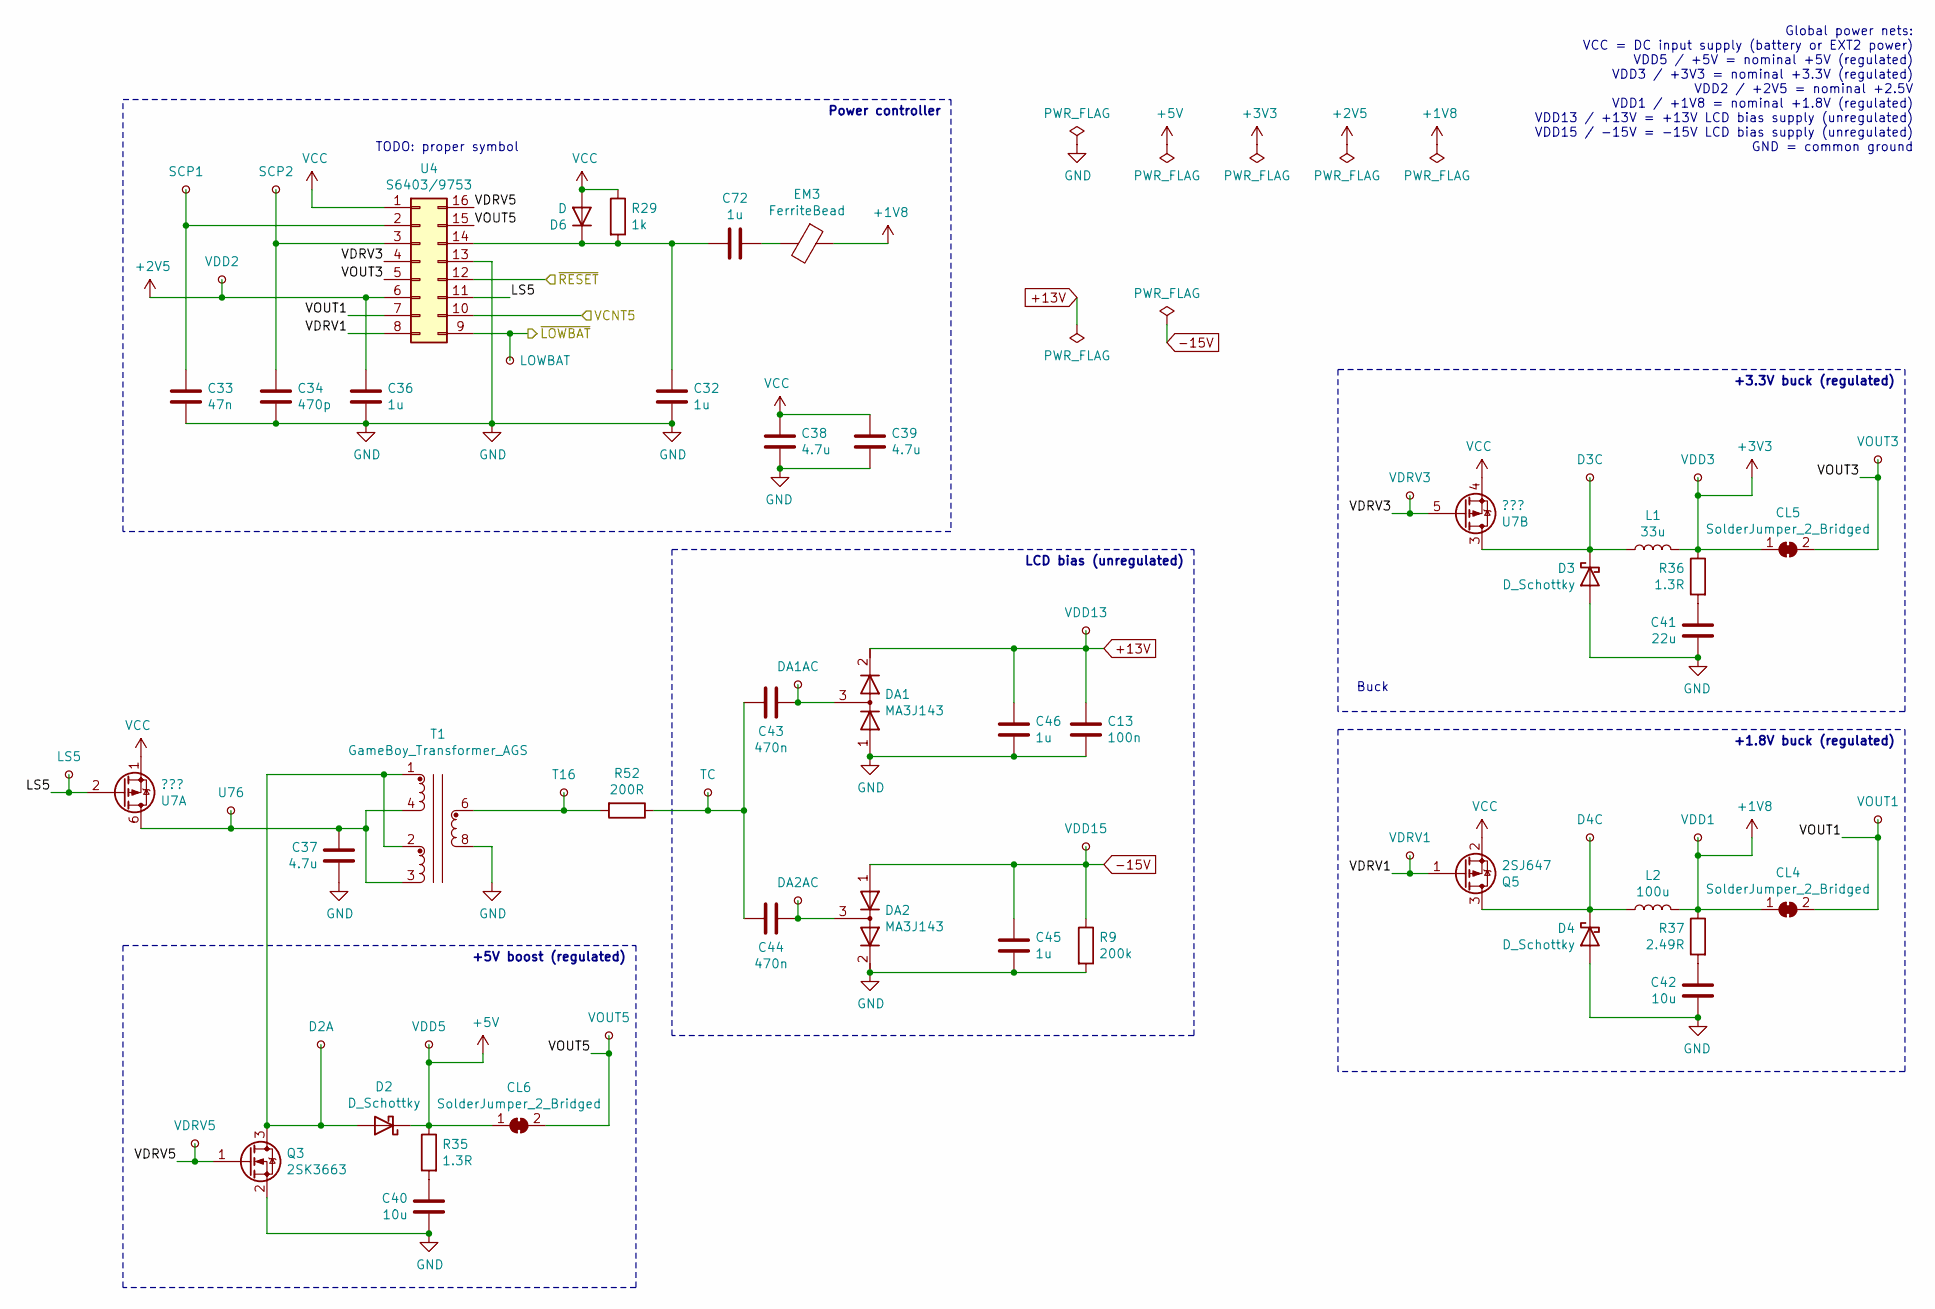
[picture p97: schematic power.kicad_sch]

Parts:
C13: 100n
C32, C36, C45, C46, C72: 1u
C33: 47n
C34: 470p
C37, C38, C39: 4.7u
C40, C42: 10u
C41: 22u
C43, C44: 470n
CL4, CL5, CL6: SolderJumper_2_Bridged
D2, D3, D4: D_Schottky
D6: D
DA1, DA2: MA3J143
EM3: FerriteBead
L1: 33u
L2: 100u
Q3: 2SK3663
Q5: 2SJ647
R9: 200k
R29: 1k
R35, R36: 1.3R
R37: 2.49R
R52: 200R
T1: GameBoy_Transformer_AGS
TP12: LS5
TP13: SCP1
TP14: VDRV5
TP15: VDD2
TP16: U76
TP17: SCP2
TP18: D2A
TP19: VDD5
TP20: LOWBAT
TP21: T16
TP22: VOUT5
TP23: TC
TP24: DA1AC
TP25: DA2AC
TP26: VDD13
TP27: VDD15
TP28: VDRV3
TP29: VDRV1
TP30: D3C
TP31: D4C
TP32: VDD3
TP33: VDD1
TP34: VOUT3
TP35: VOUT1
U4: S6403/9753
U7: ???

Connections:
+1V8: CL4.1 (A), EM3.1, L2.1, R37.1, TP33.1
+2V5: C36.1, TP15.1, U4.6
+3V3: CL5.1 (A), L1.1, R36.1, TP32.1
+5V: CL6.1 (A), D2.1 (K), R35.1, TP19.1
+13V: C13.1, C46.1, DA1.2 (K), TP26.1
-15V: C45.1, DA2.1 (A), R9.1, TP27.1
GND: C13.2, C32.2, C33.2, C34.2, C36.2, C37.2, C38.2, C39.2, C40.2, C41.2, C42.2, C45.2, C46.2, D3.2 (A), D4.2 (A), DA1.1 (A), DA2.2 (K), Q3.2 (S), R9.2, T1.8, U4.13
LS5: TP12.1, U4.11, U7.2 (G)
unnamed: C32.1, C72.2, D6.1 (K), R29.2, U4.14
unnamed: C33.1, TP13.1, U4.2
unnamed: C34.1, TP17.1, U4.3
unnamed: C37.1, T1.3, T1.4, TP16.1, U7.6 (D)
unnamed: C40.1, R35.2
unnamed: C41.1, R36.2
unnamed: C42.1, R37.2
unnamed: C43.1, DA1.3 (common), TP24.1
unnamed: C43.2, C44.2, R52.1, TP23.1
unnamed: C44.1, DA2.3 (common), TP25.1
unnamed: C72.1, EM3.2
unnamed: D2.2 (A), Q3.3 (D), T1.1, T1.2, TP18.1
unnamed: D3.1 (K), L1.2, TP30.1, U7.3 (D)
unnamed: D4.1 (K), L2.2, Q5.3 (D), TP31.1
unnamed: R52.2, T1.6, TP21.1
VCC: C38.1, C39.1, D6.2 (A), Q5.2 (S), R29.1, U4.1, U7.1 (S), U7.4 (S)
VCNT5: U4.10
VDRV1: Q5.1 (G), TP29.1, U4.8
VDRV3: TP28.1, U4.4, U7.5 (G)
VDRV5: Q3.1 (G), TP14.1, U4.16
VOUT1: CL4.2 (B), TP35.1, U4.7
VOUT3: CL5.2 (B), TP34.1, U4.5
VOUT5: CL6.2 (B), TP22.1, U4.15
~LOWBAT: TP20.1, U4.9
~RESET: U4.12

Notes on the sheet:
+3.3V buck (regulated)
+1.8V buck (regulated)
Buck
Power controller
+5V boost (regulated)
LCD bias (unregulated)
Global power nets: VCC = DC input supply (battery or EXT2 power) VDD5 / +5V = nominal +5V (regulated) VDD3 / +3V3 = nominal +3.3V (regulated) VDD2 / +2V5 = nominal +2.5V VDD1 / +1V8 = nominal +1.8V (regulated) VDD13 / +13V = +13V LCD bias supply (unregulated) VDD15 / -15V = -15V LCD bias supply (un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
TODO: proper symbol
