Gekkio/gb-schematics/DC-CONV-DMG-C/DC-CONV-DMG-C.kicad_sch

## KiCad design DC-CONV-DMG-C/DC-CONV-DMG-C.kicad_sch (2023-07-18)

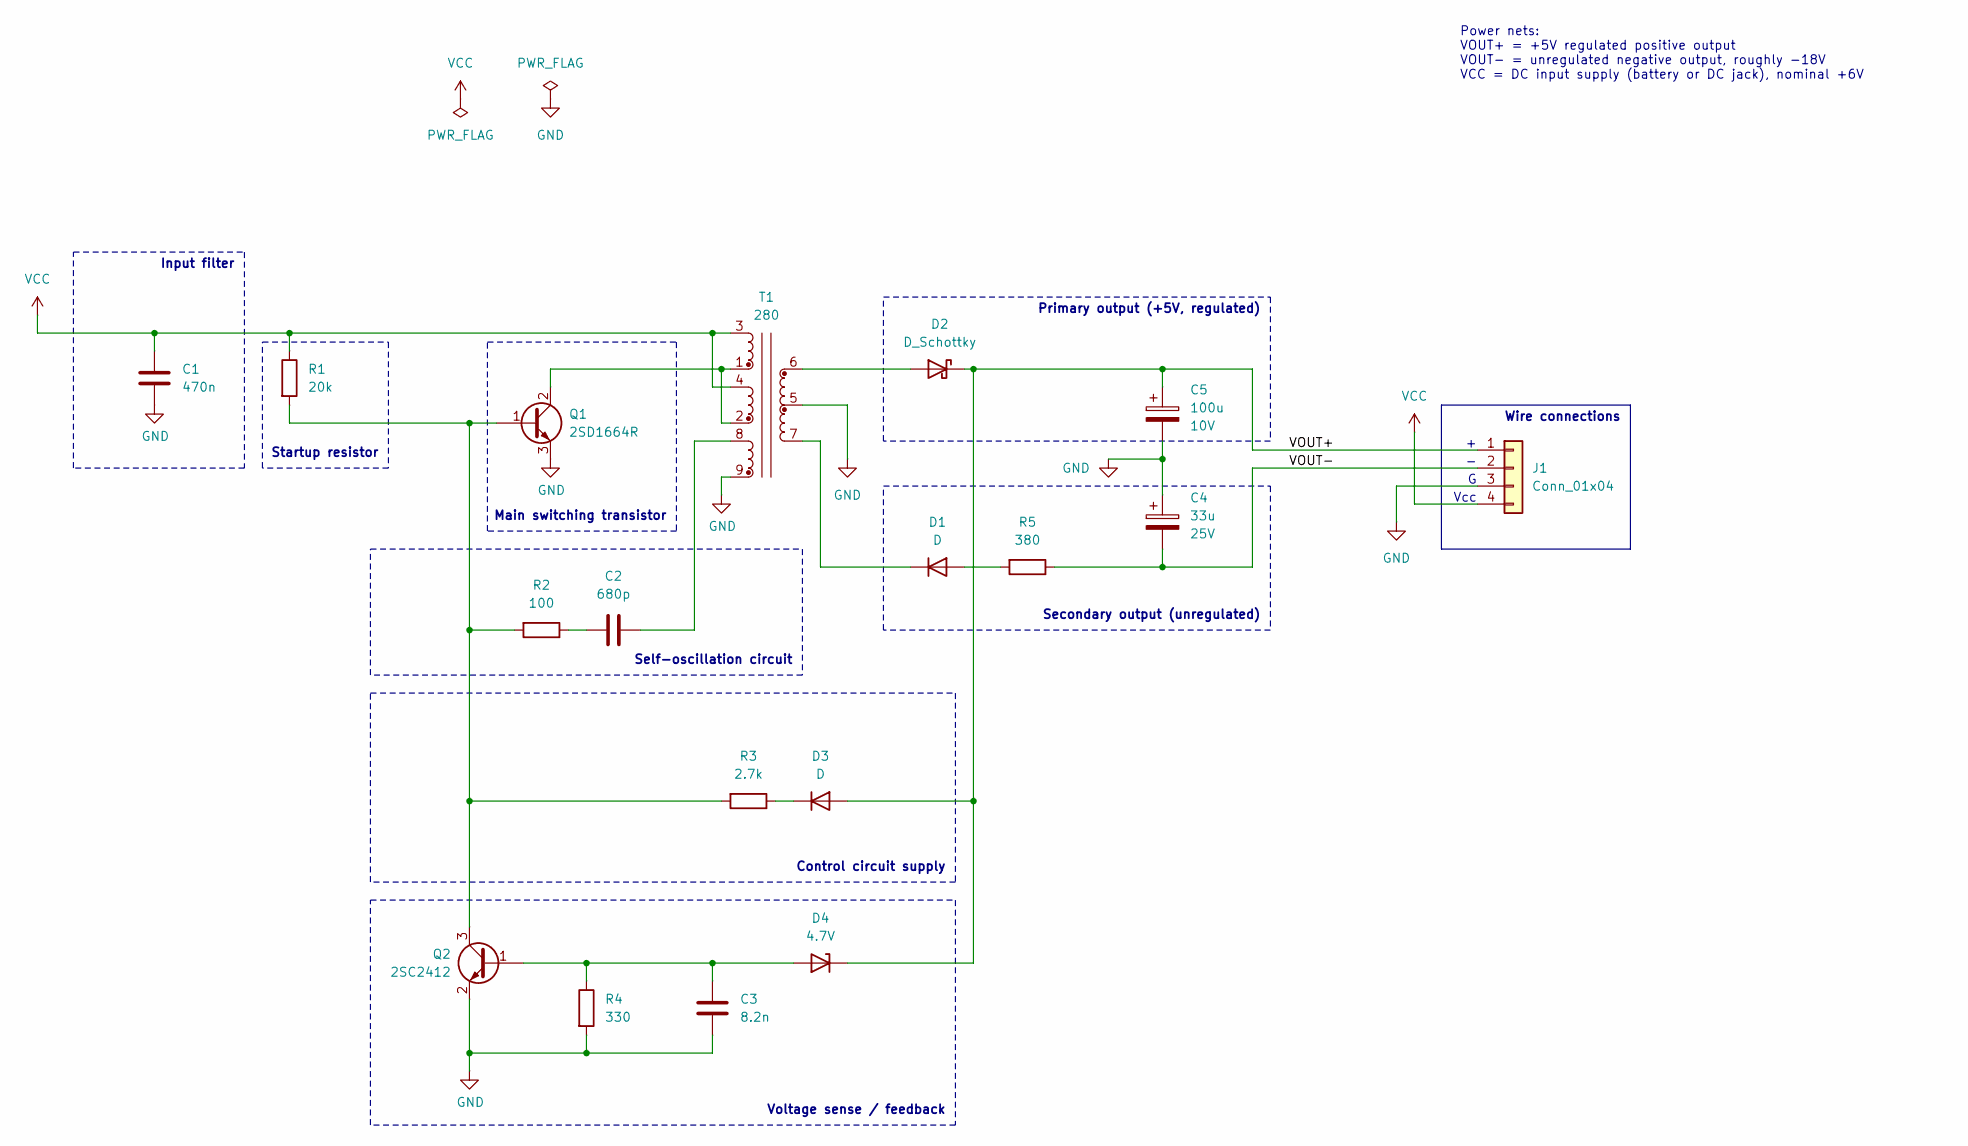
[picture p100: schematic DC-CONV-DMG-C.kicad_sch]

Parts:
C1: 470n
C2: 680p
C3: 8.2n
C4: 33u; Rating 25V
C5: 100u; Rating 10V
D1, D3: D
D2: D_Schottky; SOT-23
D4: 4.7V
J1: Conn_01x04
Q1: 2SD1664R
Q2: 2SC2412
R1: 20k
R2: 100
R3: 2.7k
R4: 330
R5: 380
T1: 280; Transformer_GameBoy_DMG

Connections:
GND: C1.2, C3.2, C4.1, C5.2, J1.3, Q1.3 (E), Q2.2 (E), R4.2, T1.5, T1.9
unnamed: C2.1, T1.8
unnamed: C2.2, R2.1
unnamed: C3.1, D4.2 (A), Q2.1 (B), R4.1
unnamed: D1.1 (K), T1.7
unnamed: D1.2 (A), R5.2
unnamed: D2.2 (A), T1.6
unnamed: D3.1 (K), R3.1
unnamed: Q1.1 (B), Q2.3 (C), R1.2, R2.2, R3.2
unnamed: Q1.2 (C), T1.1, T1.2
VCC: C1.1, J1.4, R1.1, T1.3, T1.4
VOUT+: C5.1, D2.1 (K), D3.2 (A), D4.1 (K), J1.1
VOUT-: C4.2, J1.2, R5.1

Notes on the sheet:
Wire connections
Power nets: VOUT+ = +5V regulated positive output VOUT- = unregulated negative output, roughly -18V VCC = DC input supply (battery or DC jack), nominal +6V
Input filter
Startup resistor
Self-oscillation circuit
Secondary output (unregulated)
Main switching transistor
Voltage sense / feedback
Primary output (+5V, regulated)
Control circuit supply
Vcc
