Gekkio/gb-schematics/DMG-CPU-06/DMG-CPU-06.kicad_sch

## KiCad design DMG-CPU-06/DMG-CPU-06.kicad_sch (2023-07-18)

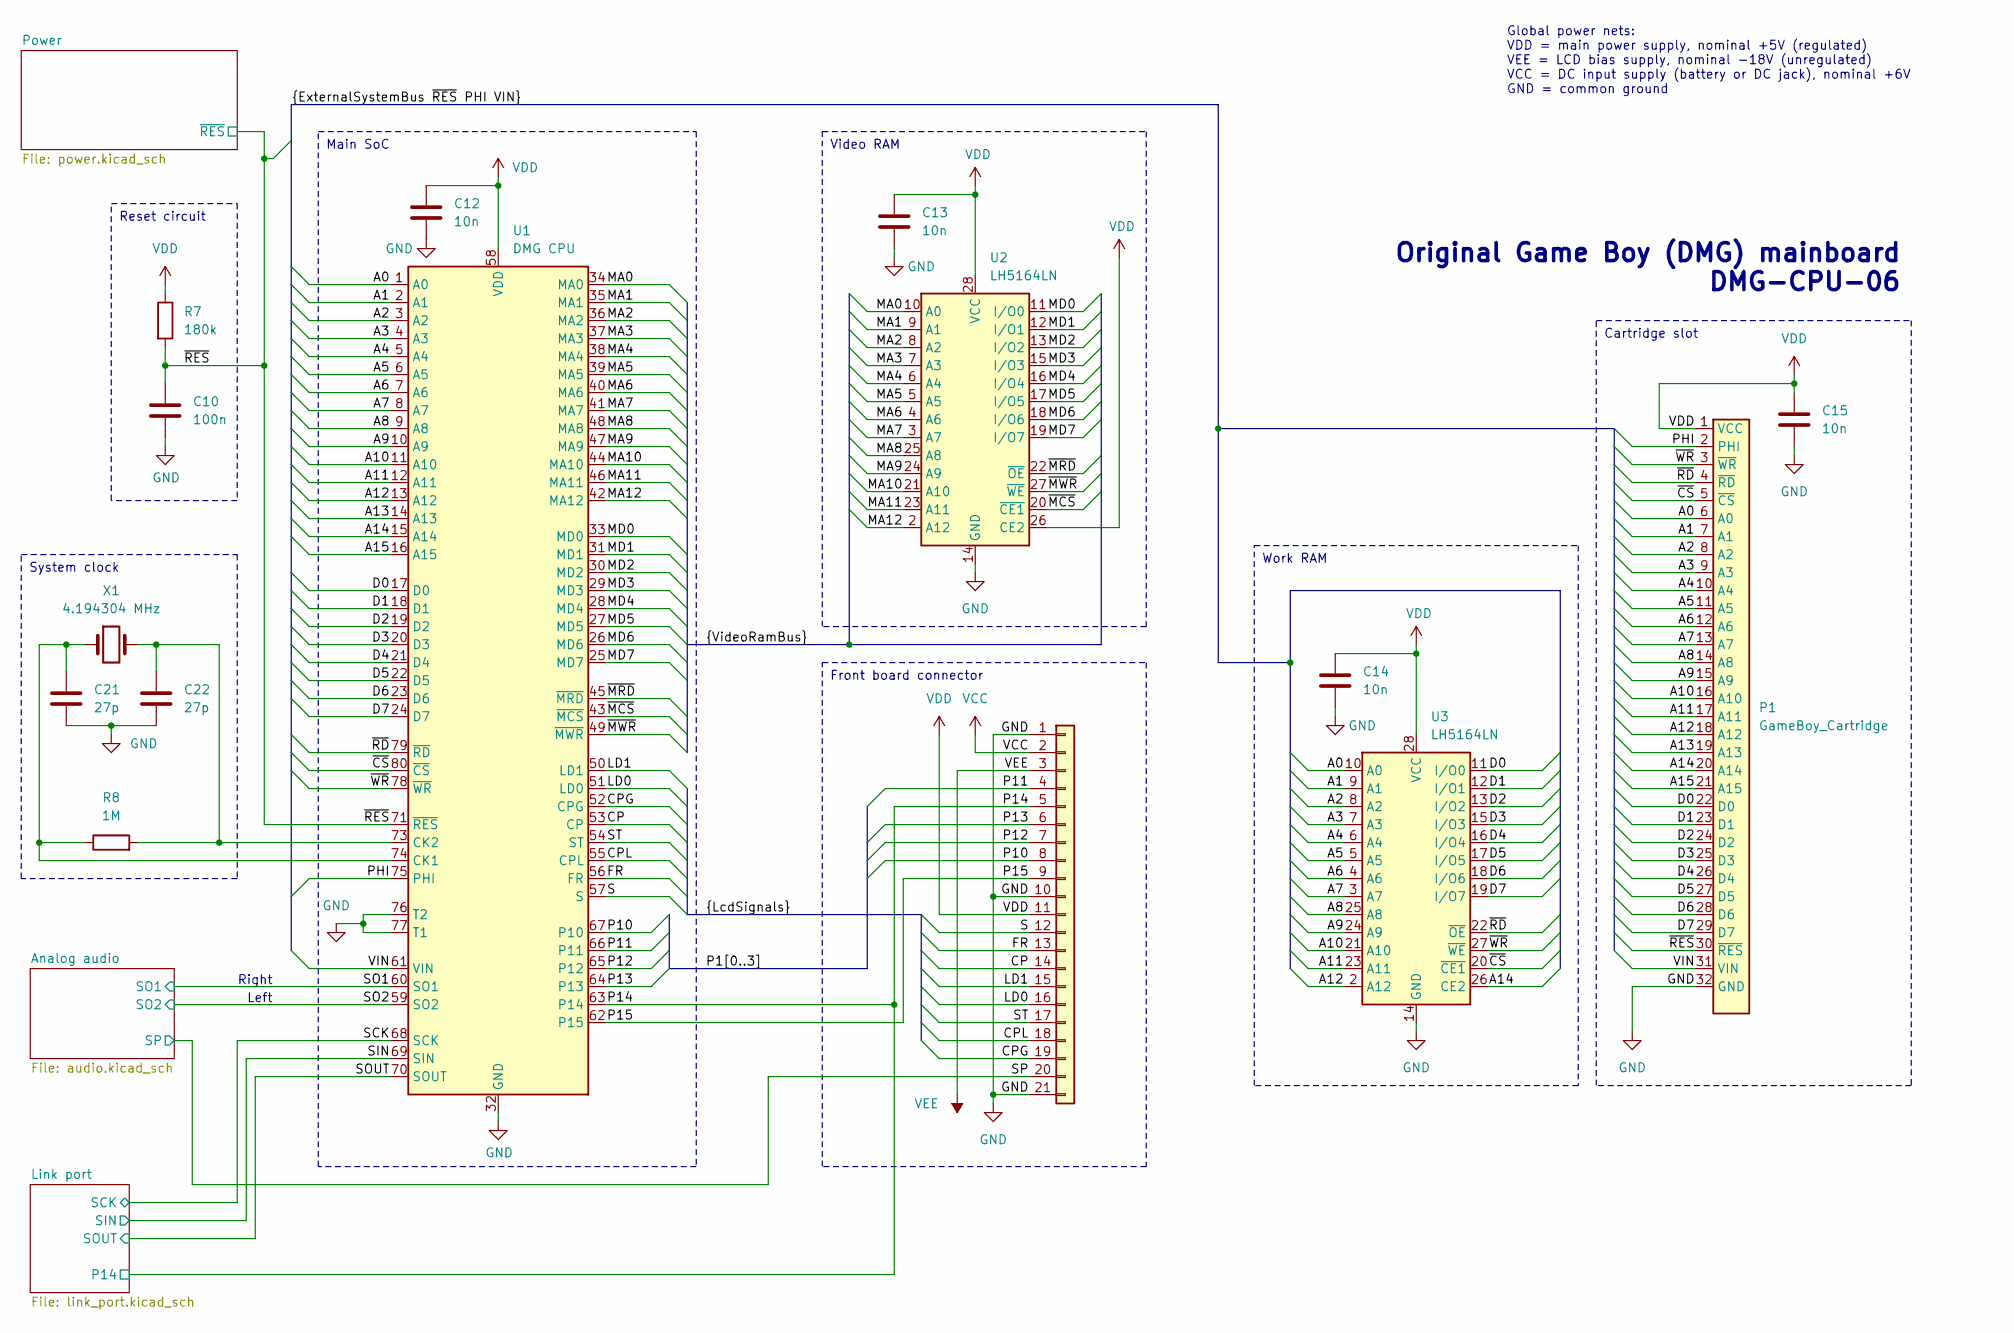
[picture p101: schematic DMG-CPU-06.kicad_sch]

Parts:
C10: 100n
C12, C13, C14, C15: 10n
C21, C22: 27p
J2: Conn_01x21
P1: GameBoy_Cartridge
R7: 180k
R8: 1M
U1: DMG CPU; Sharp_QFP-80_14x20mm_P0.8mm
U2, U3: LH5164LN; SOIC-28W_7.5x17.9mm_P1.27mm
X1: 4.194304 MHz

Connections:
A0: P1.6 (A0), U1.1 (A0), U3.10 (A0)
A1: P1.7 (A1), U1.2 (A1), U3.9 (A1)
A2: P1.8 (A2), U1.3 (A2), U3.8 (A2)
A3: P1.9 (A3), U1.4 (A3), U3.7 (A3)
A4: P1.10 (A4), U1.5 (A4), U3.6 (A4)
A5: P1.11 (A5), U1.6 (A5), U3.5 (A5)
A6: P1.12 (A6), U1.7 (A6), U3.4 (A6)
A7: P1.13 (A7), U1.8 (A7), U3.3 (A7)
A8: P1.14 (A8), U1.9 (A8), U3.25 (A8)
A9: P1.15 (A9), U1.10 (A9), U3.24 (A9)
A10: P1.16 (A10), U1.11 (A10), U3.21 (A10)
A11: P1.17 (A11), U1.12 (A11), U3.23 (A11)
A12: P1.18 (A12), U1.13 (A12), U3.2 (A12)
A13: P1.19 (A13), U1.14 (A13)
A14: P1.20 (A14), U1.15 (A14), U3.26 (CE2)
A15: P1.21 (A15), U1.16 (A15)
CP: J2.14, U1.53 (CP)
CPG: J2.19, U1.52 (CPG)
CPL: J2.18, U1.55 (CPL)
D0: P1.22 (D0), U1.17 (D0), U3.11 (I/O0)
D1: P1.23 (D1), U1.18 (D1), U3.12 (I/O1)
D2: P1.24 (D2), U1.19 (D2), U3.13 (I/O2)
D3: P1.25 (D3), U1.20 (D3), U3.15 (I/O3)
D4: P1.26 (D4), U1.21 (D4), U3.16 (I/O4)
D5: P1.27 (D5), U1.22 (D5), U3.17 (I/O5)
D6: P1.28 (D6), U1.23 (D6), U3.18 (I/O6)
D7: P1.29 (D7), U1.24 (D7), U3.19 (I/O7)
FR: J2.13, U1.56 (FR)
GND: C10.2, C12.2, C13.2, C14.2, C15.2, C21.2, C22.2, J2.1, J2.10, J2.21, P1.32 (GND), U1.32 (GND), U1.72 (GND), U1.76 (T2), U1.77 (T1), U2.14 (GND), U3.14 (GND)
LD0: J2.16, U1.51 (LD0)
LD1: J2.15, U1.50 (LD1)
MA0: U1.34 (MA0), U2.10 (A0)
MA1: U1.35 (MA1), U2.9 (A1)
MA2: U1.36 (MA2), U2.8 (A2)
MA3: U1.37 (MA3), U2.7 (A3)
MA4: U1.38 (MA4), U2.6 (A4)
MA5: U1.39 (MA5), U2.5 (A5)
MA6: U1.40 (MA6), U2.4 (A6)
MA7: U1.41 (MA7), U2.3 (A7)
MA8: U1.48 (MA8), U2.25 (A8)
MA9: U1.47 (MA9), U2.24 (A9)
MA10: U1.44 (MA10), U2.21 (A10)
MA11: U1.46 (MA11), U2.23 (A11)
MA12: U1.42 (MA12), U2.2 (A12)
MD0: U1.33 (MD0), U2.11 (I/O0)
MD1: U1.31 (MD1), U2.12 (I/O1)
MD2: U1.30 (MD2), U2.13 (I/O2)
MD3: U1.29 (MD3), U2.15 (I/O3)
MD4: U1.28 (MD4), U2.16 (I/O4)
MD5: U1.27 (MD5), U2.17 (I/O5)
MD6: U1.26 (MD6), U2.18 (I/O6)
MD7: U1.25 (MD7), U2.19 (I/O7)
unnamed: C21.1, R8.1, U1.74 (CK1), X1.1
unnamed: C22.1, R8.2, U1.73 (CK2), X1.2
P10: J2.8, U1.67 (P10)
P11: J2.4, U1.66 (P11)
P12: J2.7, U1.65 (P12)
P13: J2.6, U1.64 (P13)
P14: J2.5, U1.63 (P14)
P15: J2.9, U1.62 (P15)
PHI: P1.2 (PHI), U1.75 (PHI)
S: J2.12, U1.57 (S)
SCK: U1.68 (SCK)
SIN: U1.69 (SIN)
SO1: U1.60 (SO1)
SO2: U1.59 (SO2)
SOUT: U1.70 (SOUT)
SP: J2.20
ST: J2.17, U1.54 (ST)
VCC: J2.2
VDD: C12.1, C13.1, C14.1, C15.1, J2.11, P1.1 (VCC), R7.1, U1.58 (VDD), U2.26 (CE2), U2.28 (VCC), U3.28 (VCC)
VEE: J2.3
VIN: P1.31 (VIN), U1.61 (VIN)
~CS: P1.5 (~CS), U1.80 (~CS), U3.20 (~CE1)
~MCS: U1.43 (~MCS), U2.20 (~CE1)
~MRD: U1.45 (~MRD), U2.22 (~OE)
~MWR: U1.49 (~MWR), U2.27 (~WE)
~RD: P1.4 (~RD), U1.79 (~RD), U3.22 (~OE)
~RES: C10.1, P1.30 (~RES), R7.2, U1.71 (~RES)
~WR: P1.3 (~WR), U1.78 (~WR), U3.27 (~WE)

Notes on the sheet:
Front board connector
Cartridge slot
Reset circuit
System clock
Main SoC
Work RAM
Video RAM
Original Game Boy (DMG) mainboard DMG-CPU-06
Right
Global power nets: VDD = main power supply, nominal +5V (regulated) VEE = LCD bias supply, nominal -18V (unregulated) VCC = DC input supply (battery or DC jack), nominal +6V GND = common ground
Left
