Gekkio/gb-schematics/DMG-CPU-06/audio.kicad_sch

## KiCad design DMG-CPU-06/audio.kicad_sch (2023-07-18)

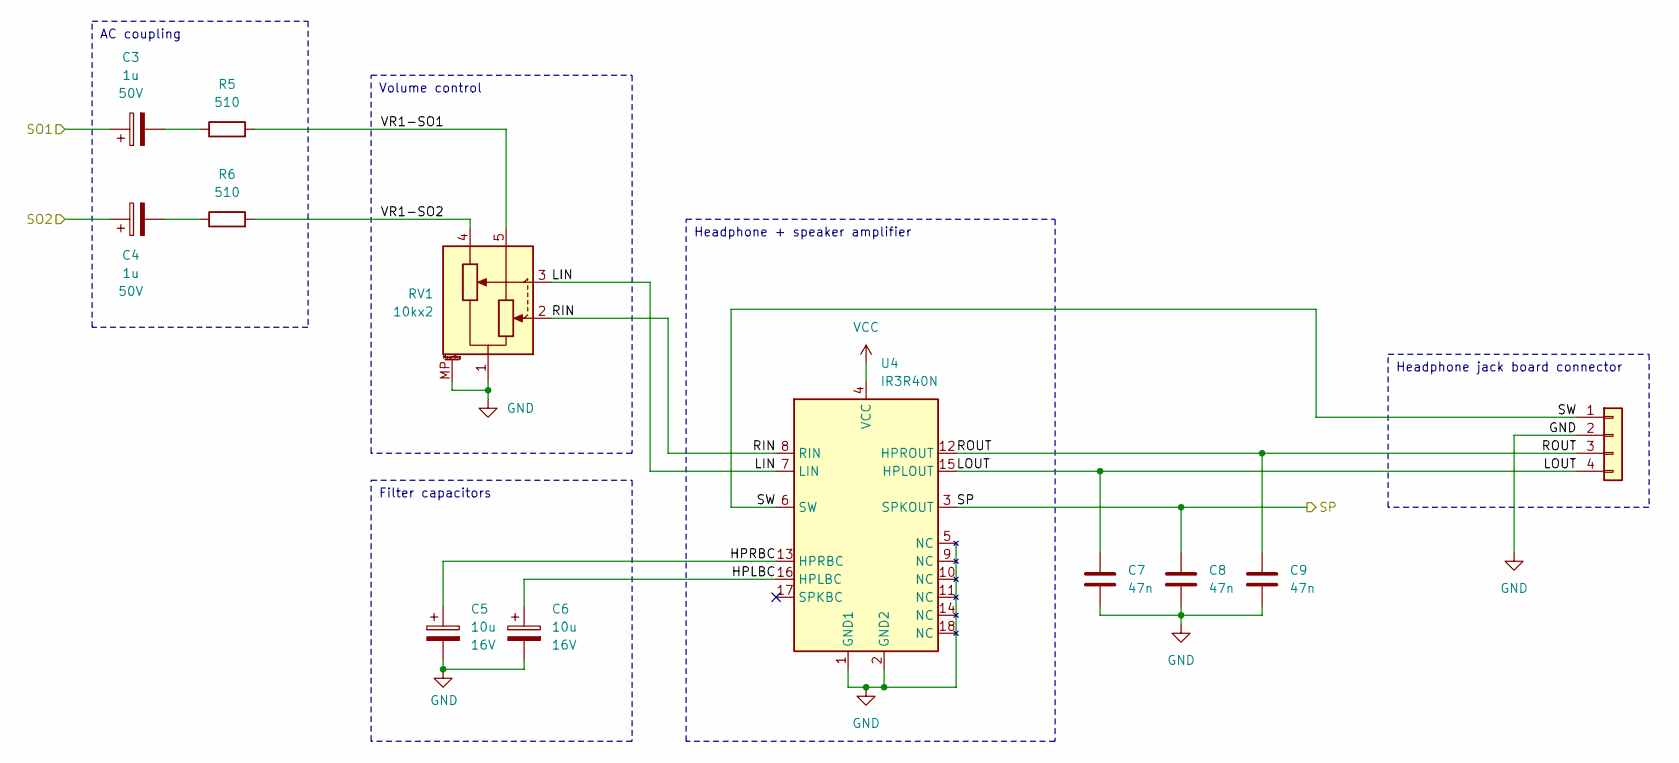
[picture p102: schematic audio.kicad_sch]

Parts:
C3, C4: 1u; Rating 50V
C5, C6: 10u; Rating 16V
C7, C8, C9: 47n
J3: Conn_01x04
R5, R6: 510
RV1: 10kx2
U4: IR3R40N; Sharp_SSOP-18_6x7.4mm_P0.8mm

Connections:
GND: C5.2, C6.2, C7.2, C8.2, C9.2, J3.2, RV1.1 (4), RV1.MP (MountPin), U4.1 (GND1), U4.2 (GND2), U4.5 (NC)
HPLBC: C6.1, U4.16 (HPLBC)
HPRBC: C5.1, U4.13 (HPRBC)
LIN: RV1.3, U4.7 (LIN)
LOUT: C7.1, J3.4, U4.15 (HPLOUT)
unnamed: C3.2, R5.1
unnamed: C4.2, R6.1
RIN: RV1.2, U4.8 (RIN)
ROUT: C9.1, J3.3, U4.12 (HPROUT)
SO1: C3.1
SO2: C4.1
SP: C8.1, U4.3 (SPKOUT)
SW: J3.1, U4.6 (SW)
VCC: U4.4 (VCC)
VR1-SO1: R5.2, RV1.5
VR1-SO2: R6.2, RV1.4

Notes on the sheet:
Filter capacitors
Headphone + speaker amplifier
Volume control
AC coupling
Headphone jack board connector
