Gekkio/gb-schematics/DMG-CPU-06/link_port.kicad_sch

## KiCad design DMG-CPU-06/link_port.kicad_sch (2023-07-18)

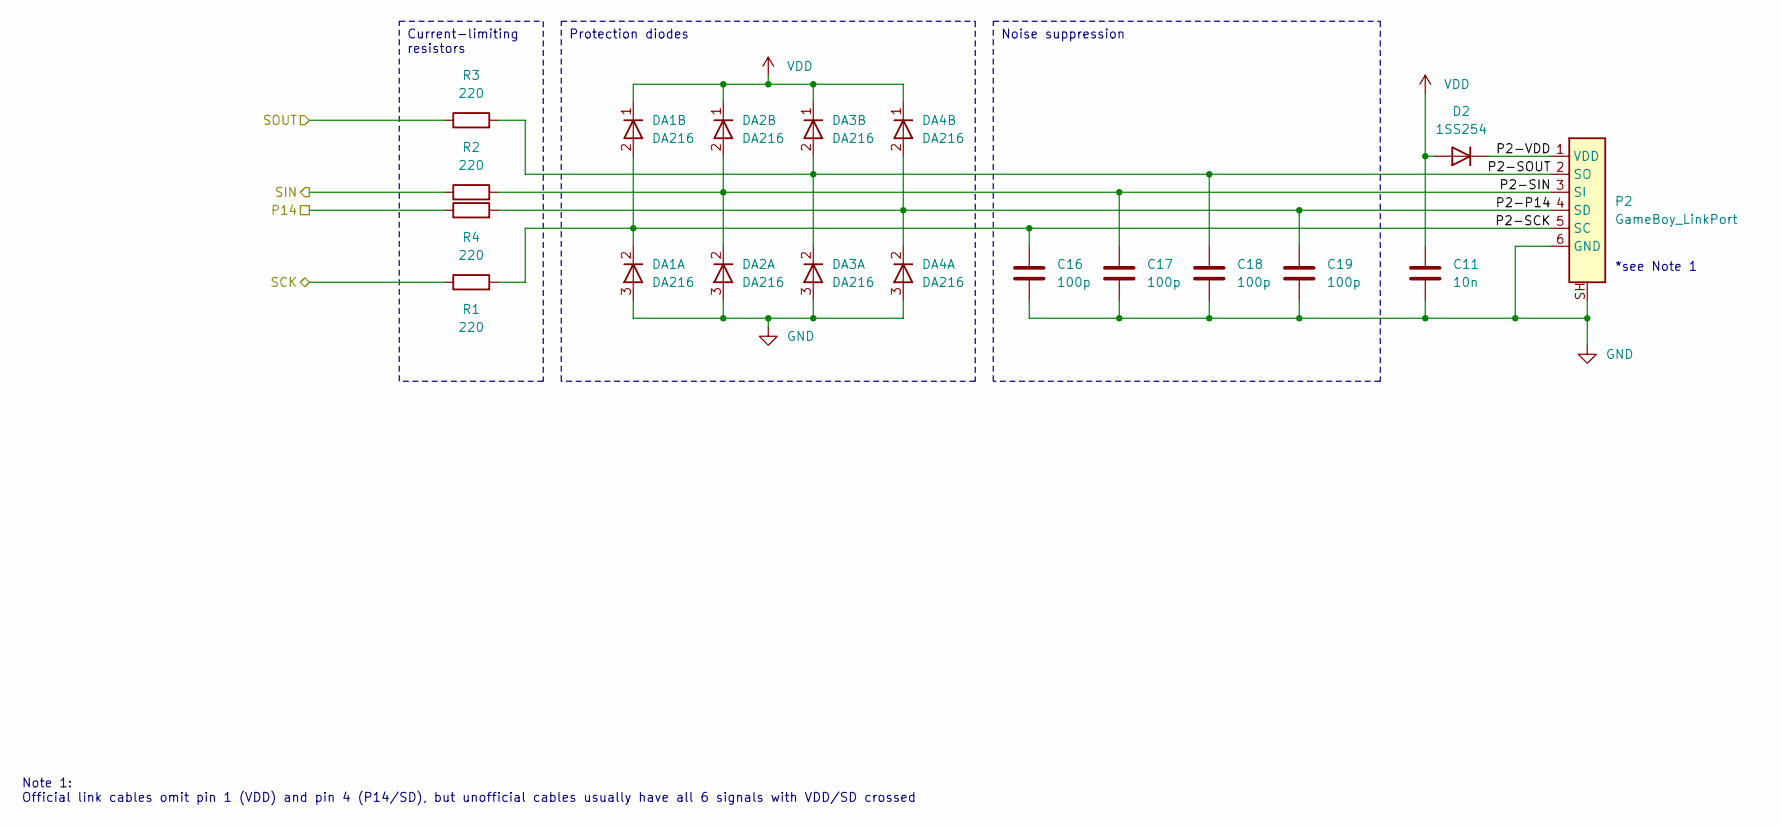
[picture p103: schematic link_port.kicad_sch]

Parts:
C11: 10n
C16, C17, C18, C19: 100p
D2: 1SS254
DA1, DA2, DA3, DA4: DA216
P2: GameBoy_LinkPort
R1, R2, R3, R4: 220

Connections:
GND: C11.2, C16.2, C17.2, C18.2, C19.2, DA1.3 (A), DA2.3 (A), DA3.3 (A), DA4.3 (A), P2.6 (GND), P2.SH
P2-P14: C19.1, DA4.2 (K), P2.4 (SD), R4.2
P2-SCK: C16.1, DA1.2 (K), P2.5 (SC), R1.2
P2-SIN: C17.1, DA2.2 (K), P2.3 (SI), R2.2
P2-SOUT: C18.1, DA3.2 (K), P2.2 (SO), R3.2
P2-VDD: D2.1 (K), P2.1 (VDD)
P14: R4.1
SCK: R1.1
SIN: R2.1
SOUT: R3.1
VDD: C11.1, D2.2 (A), DA1.1 (K), DA2.1 (K), DA3.1 (K), DA4.1 (K)

Notes on the sheet:
Current-limiting resistors
Noise suppression
Protection diodes
Note 1: Official link cables omit pin 1 (VDD) and pin 4 (P14/SD), but unofficial cables usually have all 6 signals with VDD/SD crossed
*see Note 1
