Gekkio/gb-schematics/DMG-CPU-06/power.kicad_sch

## KiCad design DMG-CPU-06/power.kicad_sch (2023-07-18)

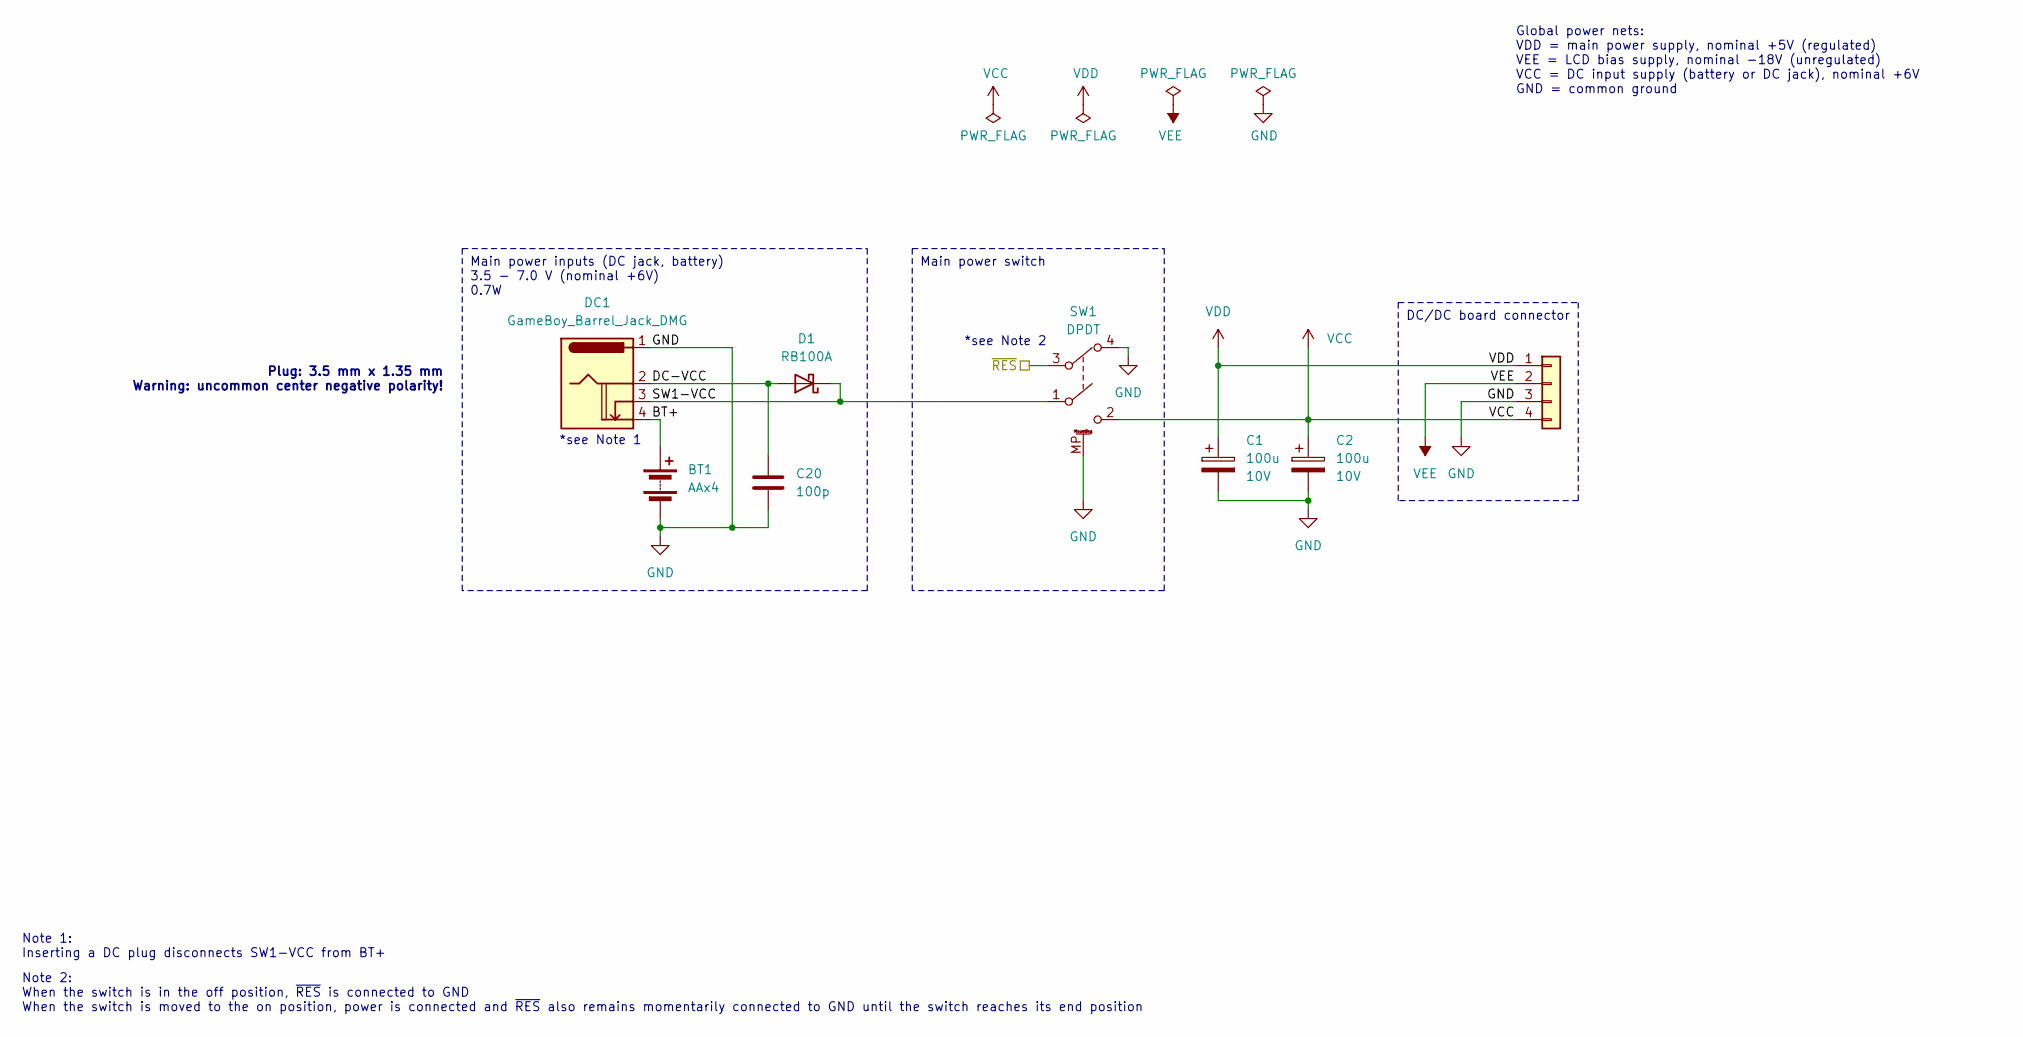
[picture p104: schematic power.kicad_sch]

Parts:
BT1: AAx4
C1, C2: 100u; Rating 10V
C20: 100p
D1: RB100A
DC1: GameBoy_Barrel_Jack_DMG
J1: Conn_01x04
SW1: DPDT

Connections:
BT+: BT1.1 (+), DC1.4
DC-VCC: C20.1, D1.2 (A), DC1.2
GND: BT1.2 (-), C1.2, C2.2, C20.2, DC1.1, J1.3, SW1.4, SW1.MP
SW1-VCC: D1.1 (K), DC1.3, SW1.1
VCC: C2.1, J1.4, SW1.2
VDD: C1.1, J1.1
VEE: J1.2
~RES: SW1.3

Notes on the sheet:
Main power switch
Main power inputs (DC jack, battery) 3.5 - 7.0 V (nominal +6V) 0.7W
DC/DC board connector
Note 2: When the switch is in the off position, ~{RES} is connected to GND When the switch is moved to the on position, power is connected and ~{RES} also remains momentarily connected to GND until the switch reaches its end position
*see Note 2
Global power nets: VDD = main power supply, nominal +5V (regulated) VEE = LCD bias supply, nominal -18V (unregulated) VCC = DC input supply (battery or DC jack), nominal +6V GND = common ground
Note 1: Inserting a DC plug disconnects SW1-VCC from BT+
Plug: 3.5 mm x 1.35 mm Warning: uncommon center negative polarity!
*see Note 1
