Gekkio/gb-schematics/DMG-JACK/DMG-JACK.kicad_sch

## KiCad design DMG-JACK/DMG-JACK.kicad_sch (2023-07-11)

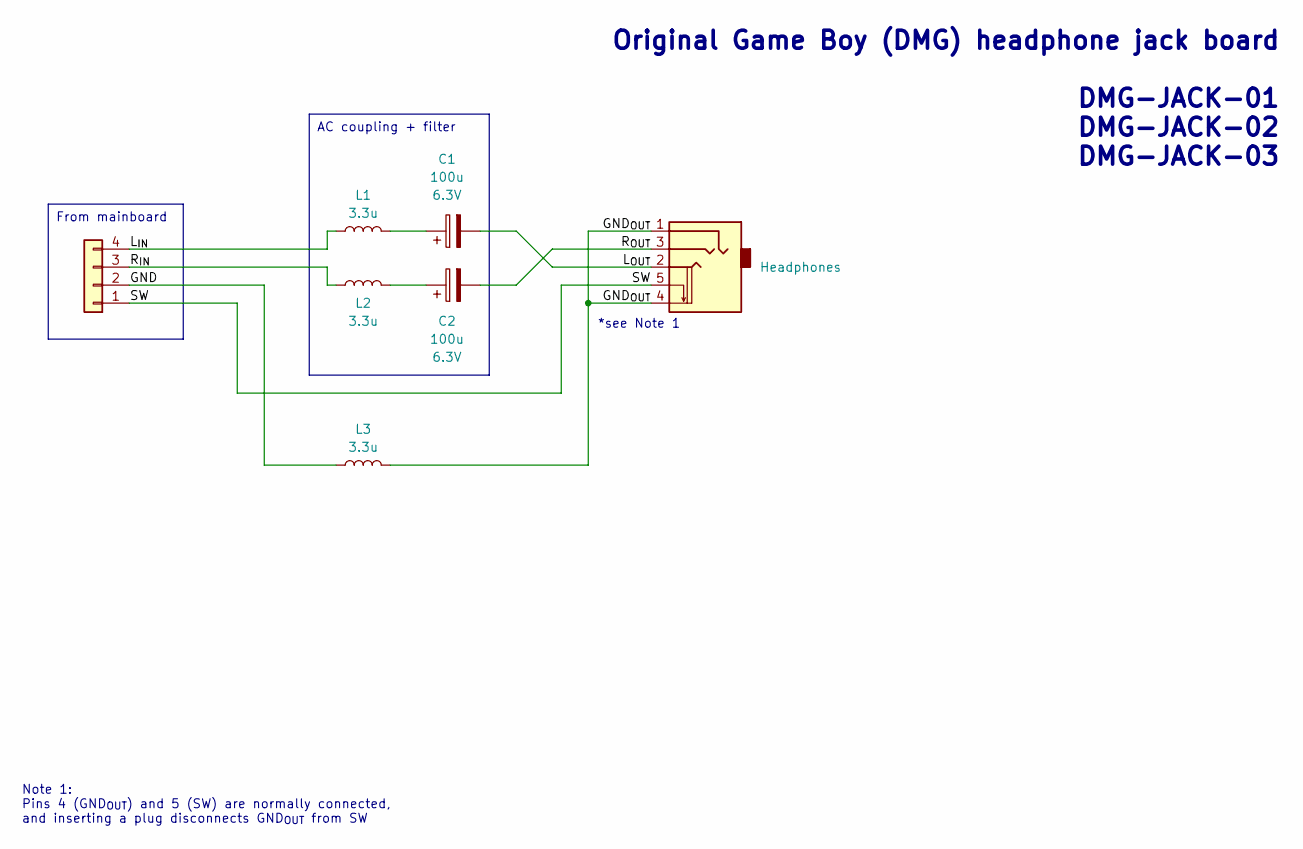
[picture p105: schematic DMG-JACK.kicad_sch]

Parts:
C1, C2: 100u; Rating 6.3V
J1: Conn_01x04
J2: Headphones
L1, L2, L3: 3.3u

Connections:
GND: J1.2, L3.1
GND_{OUT}: J2.1, J2.4, L3.2
L_{IN}: J1.4, L1.1
L_{OUT}: C1.2, J2.2
unnamed: C1.1, L1.2
unnamed: C2.1, L2.2
R_{IN}: J1.3, L2.1
R_{OUT}: C2.2, J2.3
SW: J1.1, J2.5

Notes on the sheet:
From mainboard
AC coupling + filter
*see Note 1
Note 1: Pins 4 (GND_{OUT}) and 5 (SW) are normally connected, and inserting a plug disconnects GND_{OUT} from SW
Original Game Boy (DMG) headphone jack board DMG-JACK-01 DMG-JACK-02 DMG-JACK-03
