Gekkio/gb-schematics/DMG-LCD-06/DMG-LCD-06.kicad_sch

## KiCad design DMG-LCD-06/DMG-LCD-06.kicad_sch (2023-07-18)

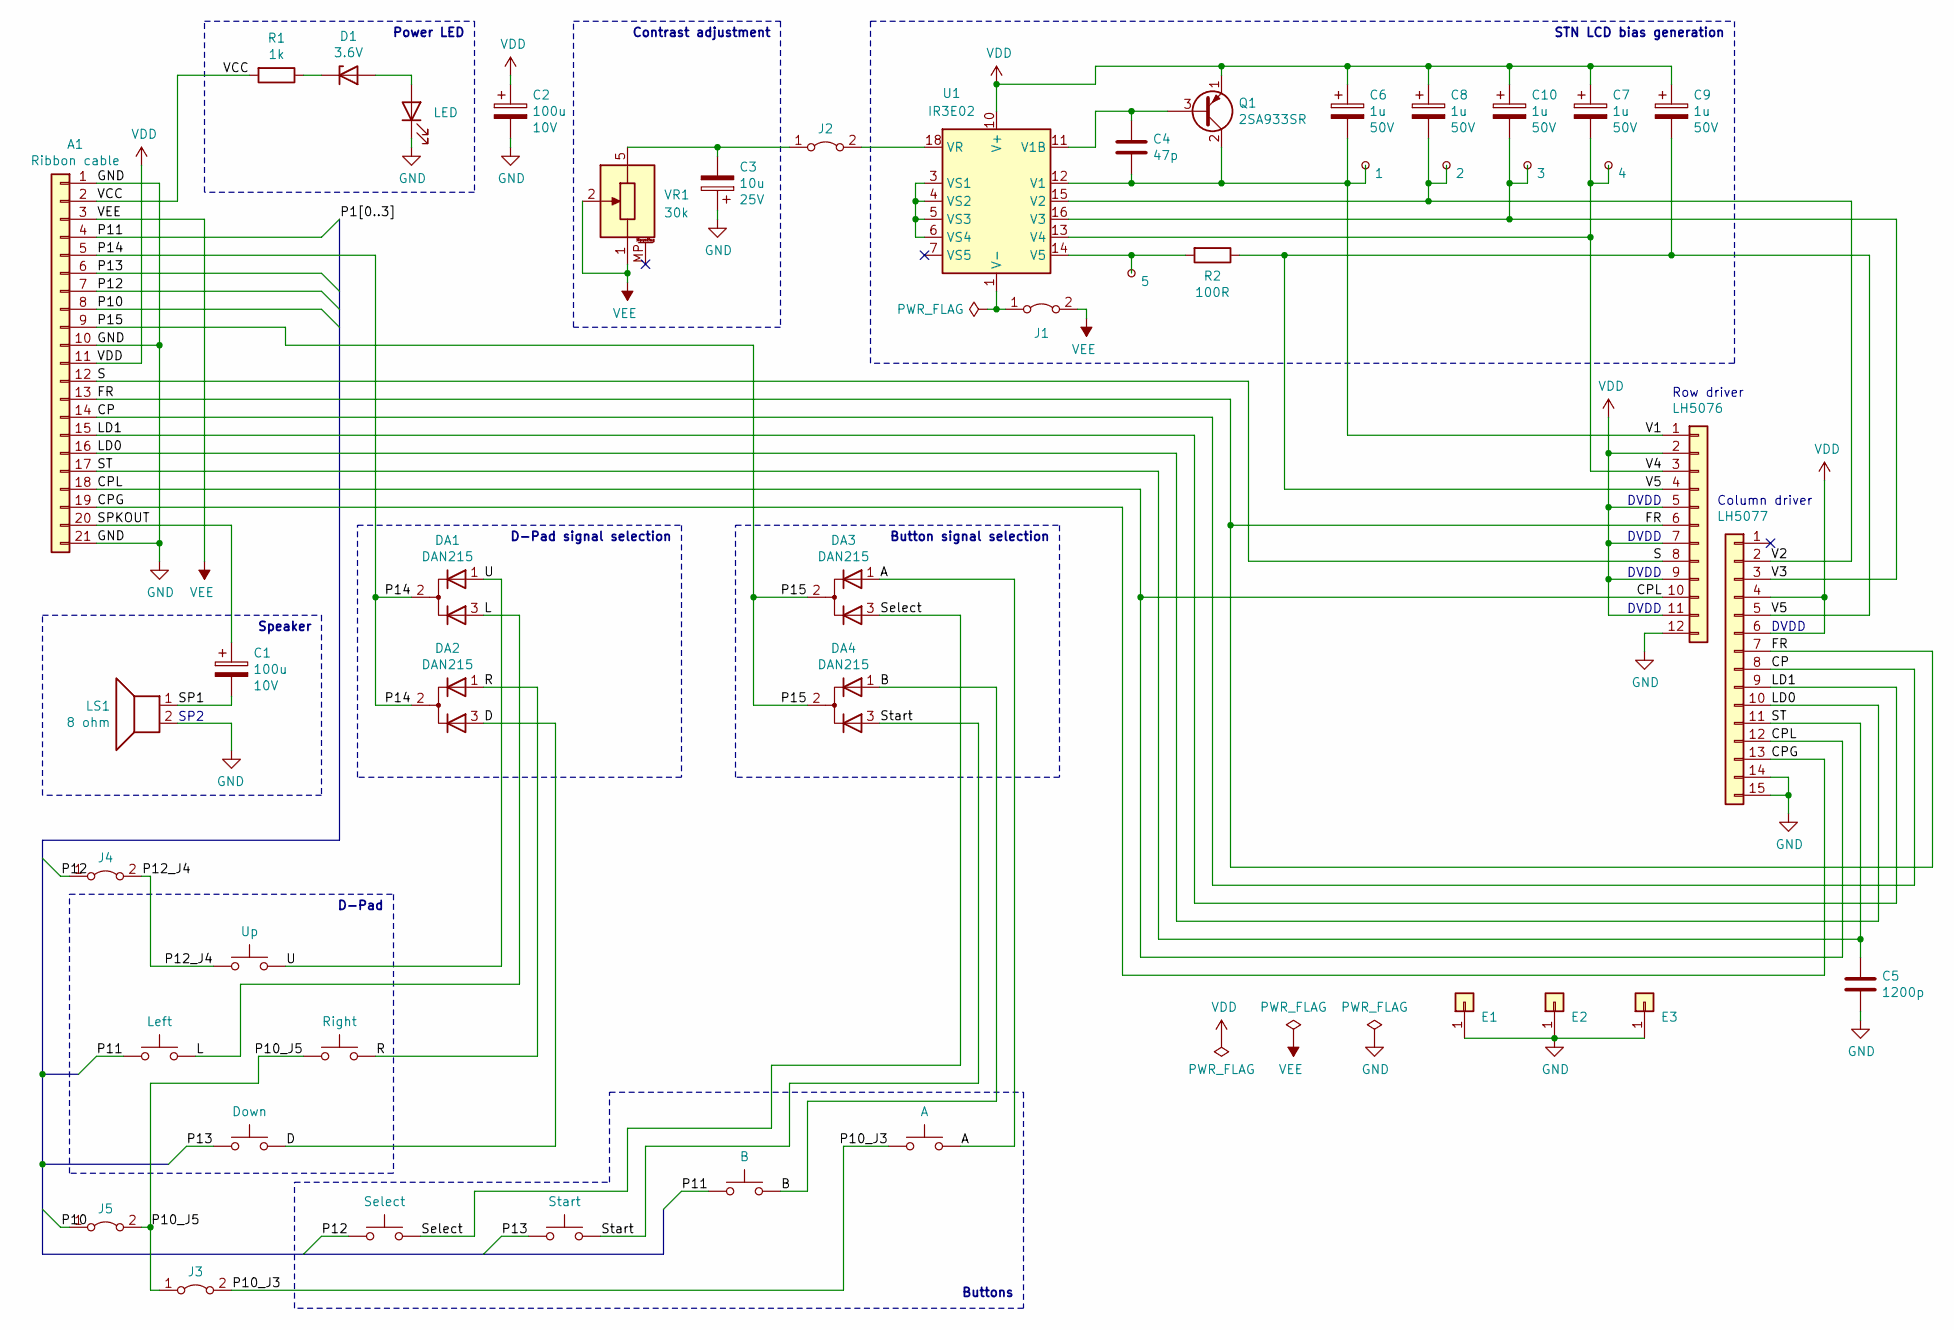
[picture p106: schematic DMG-LCD-06.kicad_sch]

Parts:
A1: Ribbon cable
C1, C2: 100u; Rating 10V
C3: 10u; Rating 25V
C4: 47p
C5: 1200p
C6, C7, C8, C9, C10: 1u; Rating 50V
D1: 3.6V
D2: LED
DA1, DA2, DA3, DA4: DAN215
E1, E2, E3: Ground clip
J1, J2, J3, J4, J5: Wire
LS1: 8 ohm
Q1: 2SA933SR
R1: 1k
R2: 100R
SW1: Left
SW2: Up
SW3: Down
SW4: Right
SW5: Select
SW6: Start
SW7: B
SW8: A
TP1: 1
TP2: 2
TP3: 3
TP4: 4
TP5: 5
U1: IR3E02
U2: LH5076
U3: LH5077
VR1: 30k

Connections:
A: DA3.1 (K), SW8.2
B: DA4.1 (K), SW7.2
CP: A1.14, U3.8
CPG: A1.19, U3.13
CPL: A1.18, U2.10, U3.12
D: DA2.3 (K), SW3.2
FR: A1.13, U2.6, U3.7
GND: A1.1, A1.10, A1.21, C2.2, C3.1, C5.2, D2.1 (K), E1.1, E2.1, E3.1, LS1.2, U2.12, U3.14, U3.15
L: DA1.3 (K), SW1.2
LD0: A1.16, U3.10
LD1: A1.15, U3.9
unnamed: C3.2, J2.1 (A), VR1.5
unnamed: C4.1, Q1.3 (B), U1.11 (V1B)
unnamed: D1.1 (K), R1.1
unnamed: D1.2 (A), D2.2 (A)
unnamed: J1.1 (A), U1.1 (V-), U1.9 (V-)
unnamed: J2.2 (B), U1.18 (VR)
unnamed: R2.2, TP5.1, U1.14 (V5)
unnamed: U1.3 (VS1), U1.4 (VS2), U1.5 (VS3), U1.6 (VS4)
P10: A1.8, J5.1 (A)
P10_J3: J3.2 (B), SW8.1
P10_J5: J3.1 (A), J5.2 (B), SW4.1
P11: A1.4, SW1.1, SW7.1
P12: A1.7, J4.1 (A), SW5.1
P12_J4: J4.2 (B), SW2.1
P13: A1.6, SW3.1, SW6.1
P14: A1.5, DA1.2 (A), DA2.2 (A)
P15: A1.9, DA3.2 (A), DA4.2 (A)
R: DA2.1 (K), SW4.2
S: A1.12, U2.8
SP1: C1.2, LS1.1
SPKOUT: A1.20, C1.1
ST: A1.17, C5.1, U3.11
Select: DA3.3 (K), SW5.2
Start: DA4.3 (K), SW6.2
U: DA1.1 (K), SW2.2
V1: C4.2, C6.2, Q1.2 (C), TP1.1, U1.12 (V1), U2.1
V2: C8.2, TP2.1, U1.15 (V2), U3.2
V3: C10.2, TP3.1, U1.16 (V3), U3.3
V4: C7.2, TP4.1, U1.13 (V4), U2.3
V5: C9.2, R2.1, U2.4, U3.5
VCC: A1.2, R1.2
VDD: A1.11, C2.1, C6.1, C7.1, C8.1, C9.1, C10.1, Q1.1 (E), U1.10 (V+), U2.2, U2.5, U2.7, U2.9, U2.11, U3.4, U3.6
VEE: A1.3, J1.2 (B), VR1.1 (4), VR1.2

Notes on the sheet:
DVDD
Contrast adjustment
Row driver
STN LCD bias generation
Column driver
Speaker
Buttons
D-Pad signal selection
SP2
Power LED
D-Pad
Button signal selection
