Gekkio/gb-schematics/DMG-QLA-01/DMG-QLA-01.kicad_sch

## KiCad design DMG-QLA-01/DMG-QLA-01.kicad_sch (2024-05-18)

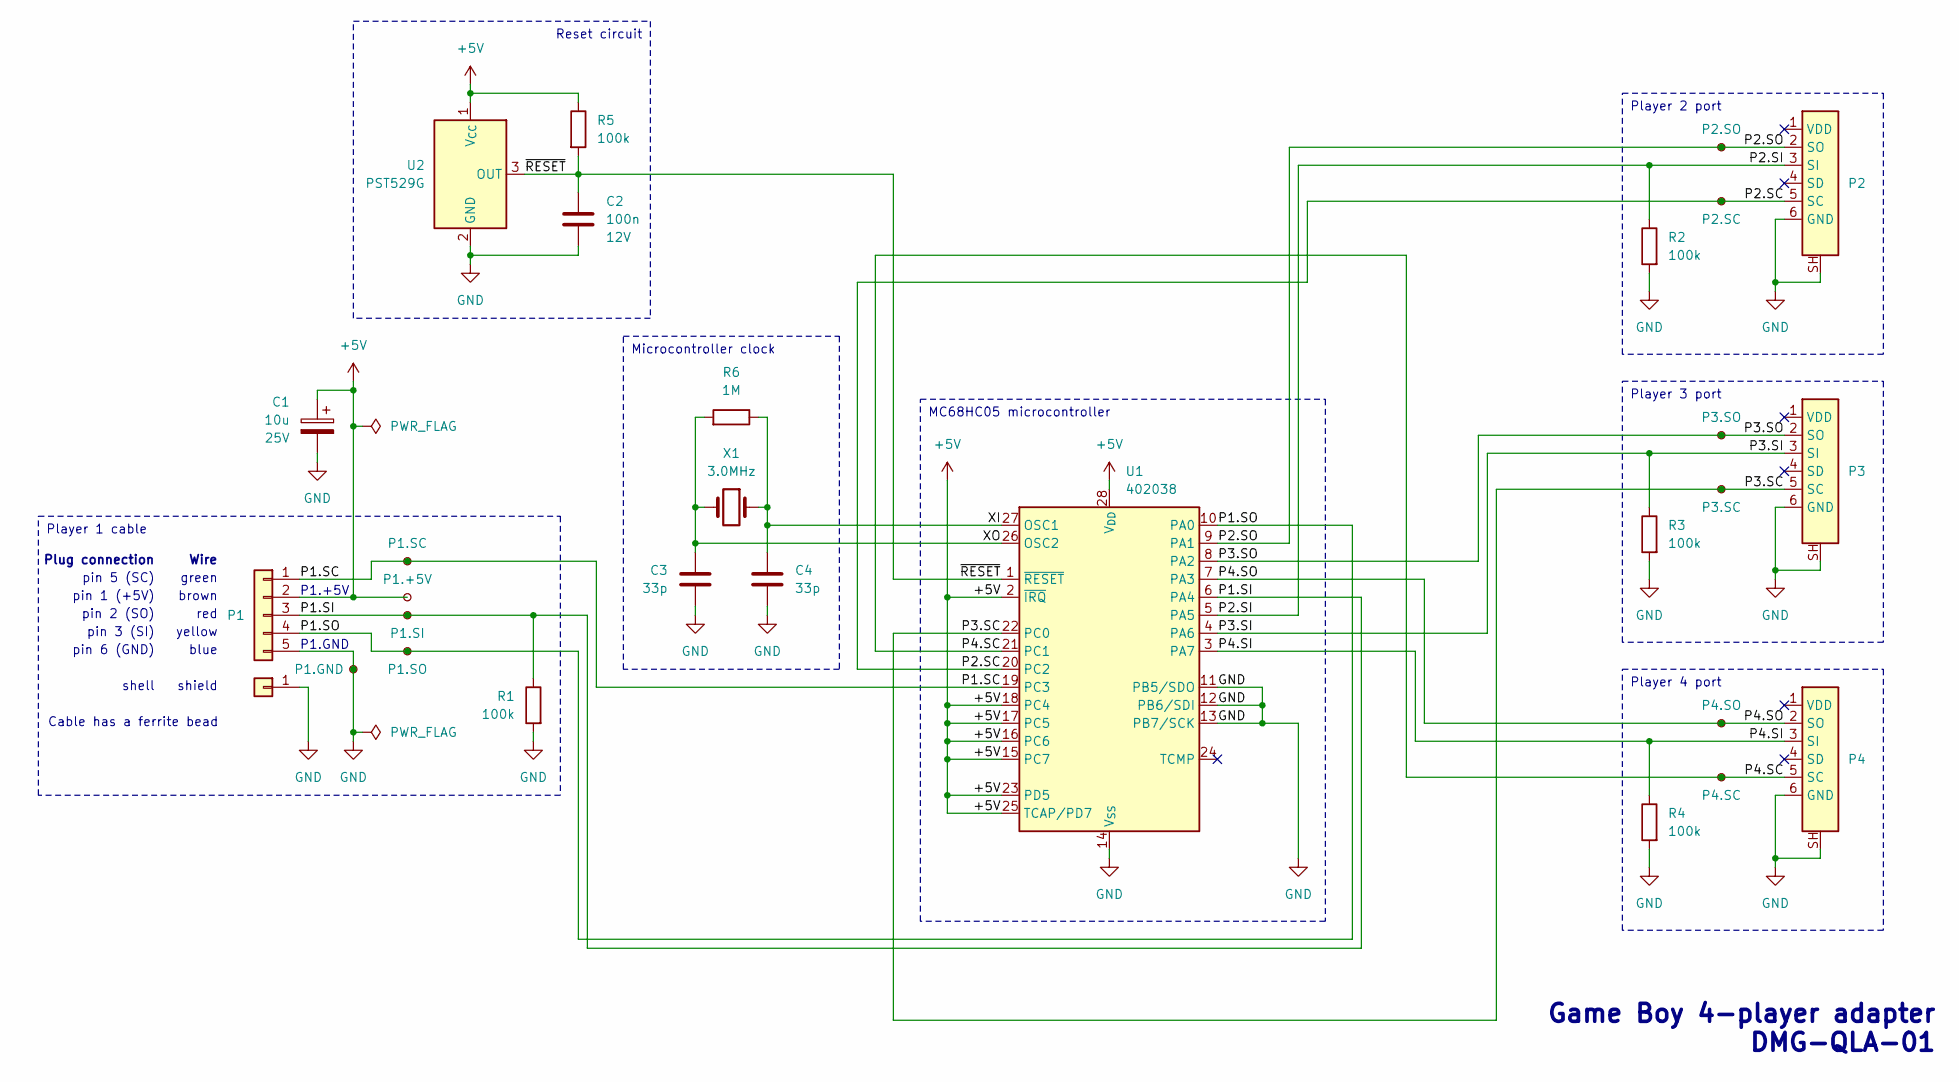
[picture p107: schematic DMG-QLA-01.kicad_sch]

Parts:
C1: 10u; Rating 25V
C2: 100n; Rating 12V
C3, C4: 33p
J1: Conn_01x01
P1: Conn_01x05
P2, P3, P4: GameBoy_LinkPort
R1, R2, R3, R4, R5: 100k
R6: 1M
TP1: P1.+5V
TP2: P1.SC
TP3: P1.SI
TP4: P1.SO
TP5: P1.GND
TP6: P2.SC
TP7: P2.SO
TP8: P3.SO
TP9: P3.SC
TP10: P4.SO
TP11: P4.SC
U1: 402038
U2: PST529G; TO-92_Inline
X1: 3.0MHz

Connections:
+5V: C1.1, P1.2, R5.1, TP1.1, U1.2 (~IRQ), U1.15 (PC7), U1.16 (PC6), U1.17 (PC5), U1.18 (PC4), U1.23 (PD5), U1.25 (TCAP/PD7), U1.28 (V_{DD}), U2.1 (V_{CC})
GND: C1.2, C2.2, C3.2, C4.2, J1.1, P1.5, P2.6 (GND), P2.SH, P3.6 (GND), P3.SH, P4.6 (GND), P4.SH, R1.2, R2.2, R3.2, R4.2, TP5.1, U1.11 (PB5/SDO), U1.12 (PB6/SDI), U1.13 (PB7/SCK), U1.14 (V_{SS}), U2.2 (GND)
P1.SC: P1.1, TP2.1, U1.19 (PC3)
P1.SI: P1.3, R1.1, TP3.1, U1.6 (PA4)
P1.SO: P1.4, TP4.1, U1.10 (PA0)
P2.SC: P2.5 (SC), TP6.1, U1.20 (PC2)
P2.SI: P2.3 (SI), R2.1, U1.5 (PA5)
P2.SO: P2.2 (SO), TP7.1, U1.9 (PA1)
P3.SC: P3.5 (SC), TP9.1, U1.22 (PC0)
P3.SI: P3.3 (SI), R3.1, U1.4 (PA6)
P3.SO: P3.2 (SO), TP8.1, U1.8 (PA2)
P4.SC: P4.5 (SC), TP11.1, U1.21 (PC1)
P4.SI: P4.3 (SI), R4.1, U1.3 (PA7)
P4.SO: P4.2 (SO), TP10.1, U1.7 (PA3)
XI: C4.1, R6.1, U1.27 (OSC1), X1.1
XO: C3.1, R6.2, U1.26 (OSC2), X1.2
~RESET: C2.1, R5.2, U1.1 (~RESET), U2.3 (OUT)

Notes on the sheet:
MC68HC05 microcontroller
Reset circuit
Player 1 cable
Player 4 port
Player 2 port
Microcontroller clock
Player 3 port
pin 2 (SO)
pin 3 (SI)
shield
Cable has a ferrite bead
pin 1 (+5V)
green
P1.GND
shell
blue
brown
pin 5 (SC)
Game Boy 4-player adapter DMG-QLA-01
pin 6 (GND)
yellow
P1.+5V
Plug connection
red
Wire
