Gekkio/gb-schematics/LSEP01088A1/LSEP01088A1.kicad_sch

## KiCad design LSEP01088A1/LSEP01088A1.kicad_sch (2023-07-18)

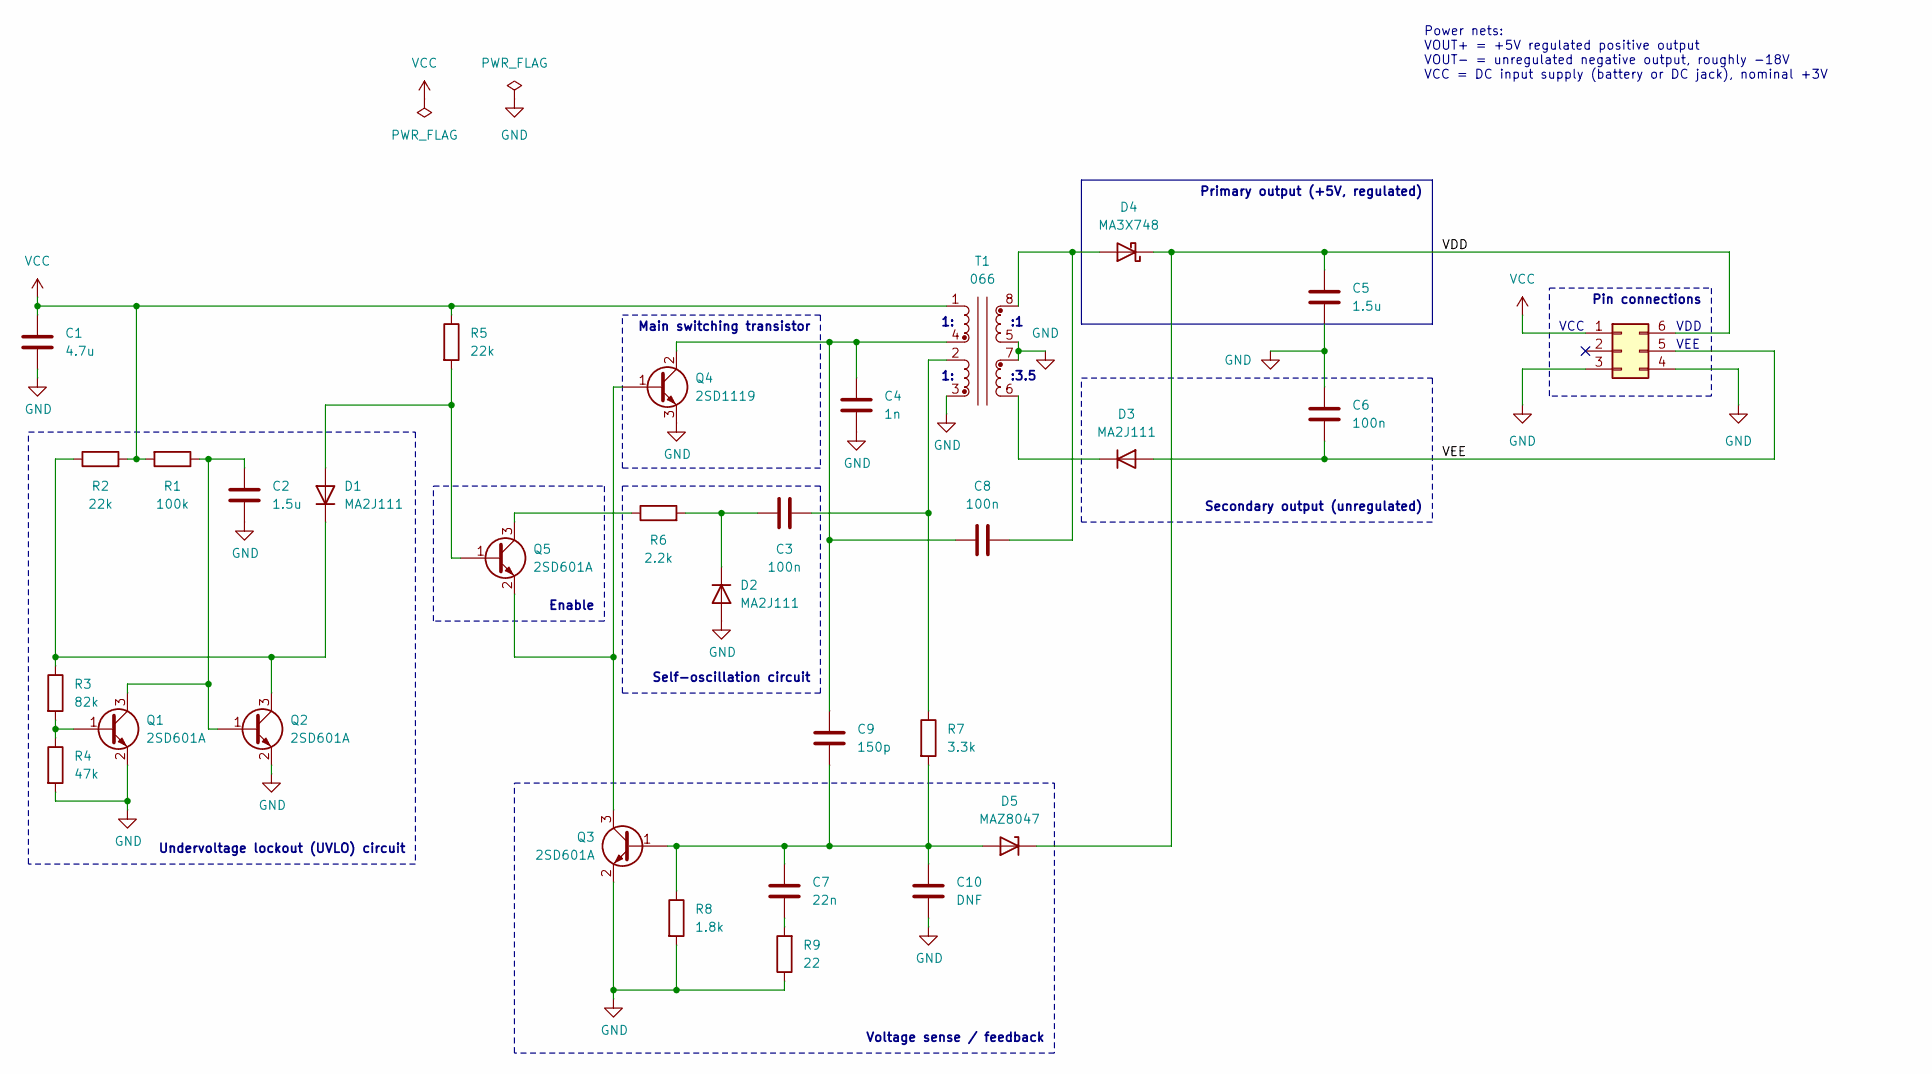
[picture p108: schematic LSEP01088A1.kicad_sch]

Parts:
C1: 4.7u
C2, C5: 1.5u
C3, C6, C8: 100n
C4: 1n
C7: 22n
C9: 150p
C10: DNF
D1, D2, D3: MA2J111
D4: MA3X748; SOT-23
D5: MAZ8047
J1: Conn_02x03_Counter_Clockwise
Q1, Q2, Q3, Q5: 2SD601A
Q4: 2SD1119
R1: 100k
R2, R5: 22k
R3: 82k
R4: 47k
R6: 2.2k
R7: 3.3k
R8: 1.8k
R9: 22
T1: 066

Connections:
GND: C1.2, C2.1, C4.2, C5.2, C6.1, C10.2, D2.2 (A), J1.3, J1.4, Q1.2 (E), Q2.2 (E), Q3.2 (E), Q4.3 (E), R4.2, R8.2, R9.1, T1.3, T1.5, T1.7
unnamed: C2.2, Q1.3 (C), Q2.1 (B), R1.1
unnamed: C3.1, D2.1 (K), R6.2
unnamed: C3.2, R7.1, T1.2
unnamed: C4.1, C8.1, C9.2, Q4.2 (C), T1.4
unnamed: C7.1, R9.2
unnamed: C8.2, D4.1 (A), T1.8
unnamed: C7.2, C9.1, C10.1, D5.2 (A), Q3.1 (B), R7.2, R8.1
unnamed: D1.1 (K), Q2.3 (C), R2.1, R3.1
unnamed: D1.2 (A), Q5.1 (B), R5.2
unnamed: D3.1 (K), T1.6
unnamed: Q1.1 (B), R3.2, R4.1
unnamed: Q3.3 (C), Q4.1 (B), Q5.2 (E)
unnamed: Q5.3 (C), R6.1
VCC: C1.1, J1.1, R1.2, R2.2, R5.1, T1.1
VDD: C5.1, D4.3 (K), D5.1 (K), J1.6
VEE: C6.2, D3.2 (A), J1.5

Notes on the sheet:
:3.5
Pin connections
Self-oscillation circuit
VEE
Power nets: VOUT+ = +5V regulated positive output VOUT- = unregulated negative output, roughly -18V VCC = DC input supply (battery or DC jack), nominal +3V
Enable
Main switching transistor
Undervoltage lockout (UVLO) circuit
Secondary output (unregulated)
Voltage sense / feedback
Primary output (+5V, regulated)
VDD
VCC
