Gekkio/gb-schematics/LSEP01120A1/LSEP01120A1.kicad_sch

## KiCad design LSEP01120A1/LSEP01120A1.kicad_sch (2024-05-18)

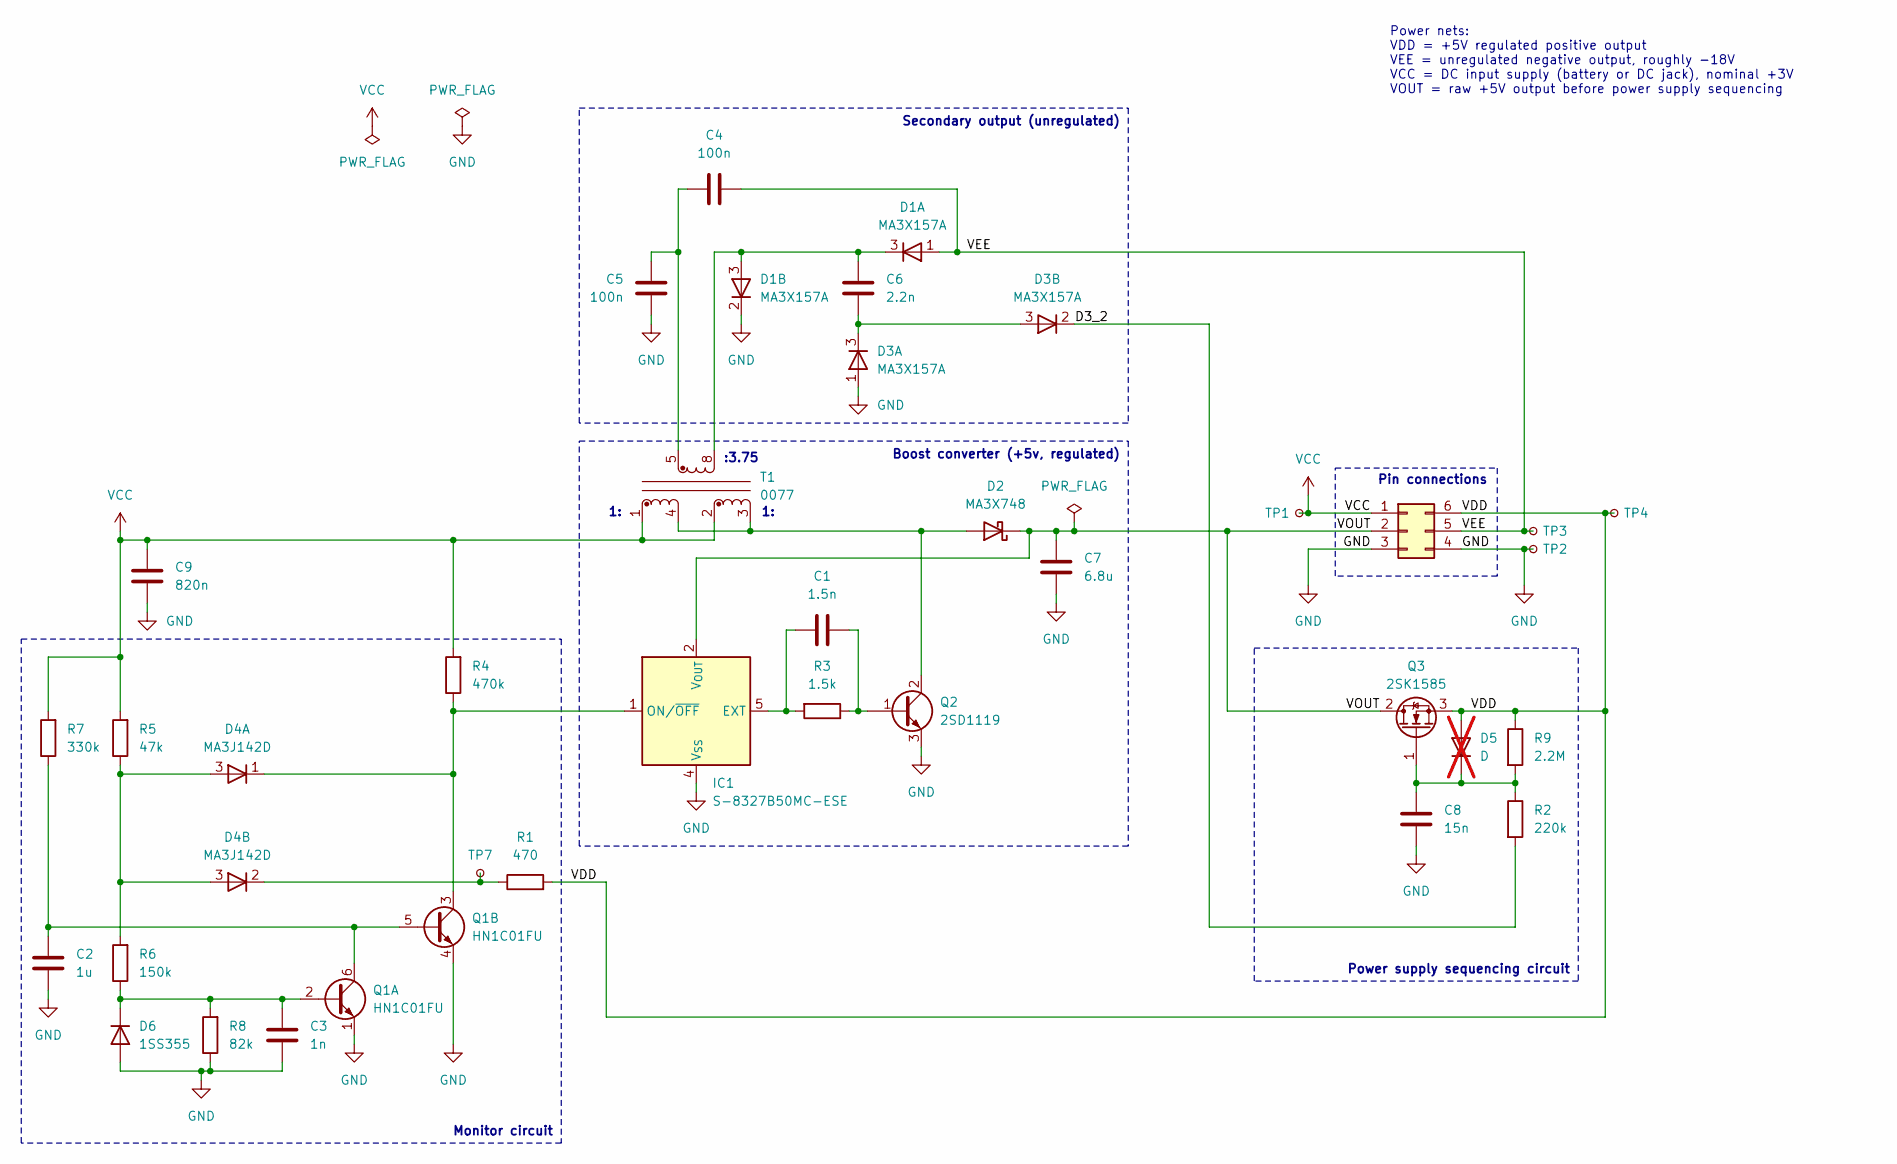
[picture p109: schematic LSEP01120A1.kicad_sch]

Parts:
C1: 1.5n
C2: 1u
C3: 1n
C4, C5: 100n
C6: 2.2n
C7: 6.8u
C8: 15n
C9: 820n
D1, D3: MA3X157A
D2: MA3X748; SOT-23
D4: MA3J142D
D5: D; not fitted
D6: 1SS355
IC1: S-8327B50MC-ESE
J1: Conn_02x03_Counter_Clockwise
Q1: HN1C01FU
Q2: 2SD1119
Q3: 2SK1585
R1: 470
R2: 220k
R3: 1.5k
R4: 470k
R5: 47k
R6: 150k
R7: 330k
R8: 82k
R9: 2.2M
T1: 0077
TP1, TP2, TP3, TP4, TP7: TestPoint_Small

Connections:
D3_2: D3.2 (K), R2.2
GND: C2.2, C3.2, C5.2, C7.2, C8.2, C9.2, D1.2 (K), D3.1 (A), D6.2 (A), IC1.4 (V_{SS}), J1.3, J1.4, Q1.1 (E1), Q1.4 (E2), Q2.3 (E), R8.1, TP2.1
unnamed: C1.1, IC1.5 (EXT), R3.2
unnamed: C1.2, Q2.1 (B), R3.1
unnamed: C2.1, Q1.5 (B2), Q1.6 (C1), R7.1
unnamed: C3.1, D6.1 (K), Q1.2 (B1), R6.1, R8.2
unnamed: C4.1, C5.1, T1.5
unnamed: C6.1, D3.3 (K)
unnamed: C6.2, D1.3 (K), T1.8
unnamed: C8.1, D5.1 (K), Q3.1 (G), R2.1, R9.2
unnamed: D2.1 (A), Q2.2 (C), T1.3, T1.4
unnamed: D4.1 (K), IC1.1 (ON/~OFF), Q1.3 (C2), R4.1
unnamed: D4.2 (K), R1.1, TP7.1
unnamed: D4.3 (A), R5.1, R6.2
VCC: C9.1, J1.1, R4.2, R5.2, R7.2, T1.1, T1.2, TP1.1
VDD: D5.2 (A), J1.6, Q3.3 (S), R1.2, R9.1, TP4.1
VEE: C4.2, D1.1 (A), J1.5, TP3.1
VOUT: C7.1, D2.3 (K), IC1.2 (V_{OUT}), J1.2, Q3.2 (D)

Notes on the sheet:
Secondary output (unregulated)
Power supply sequencing circuit
Monitor circuit
Boost converter (+5v, regulated)
Power nets: VDD = +5V regulated positive output VEE = unregulated negative output, roughly -18V VCC = DC input supply (battery or DC jack), nominal +3V VOUT = raw +5V output before power supply sequencing
:3.75
Pin connections
