Gekkio/gb-schematics/MGB-DCDC-B/MGB-DCDC-B.kicad_sch

## KiCad design MGB-DCDC-B/MGB-DCDC-B.kicad_sch (2023-07-18)

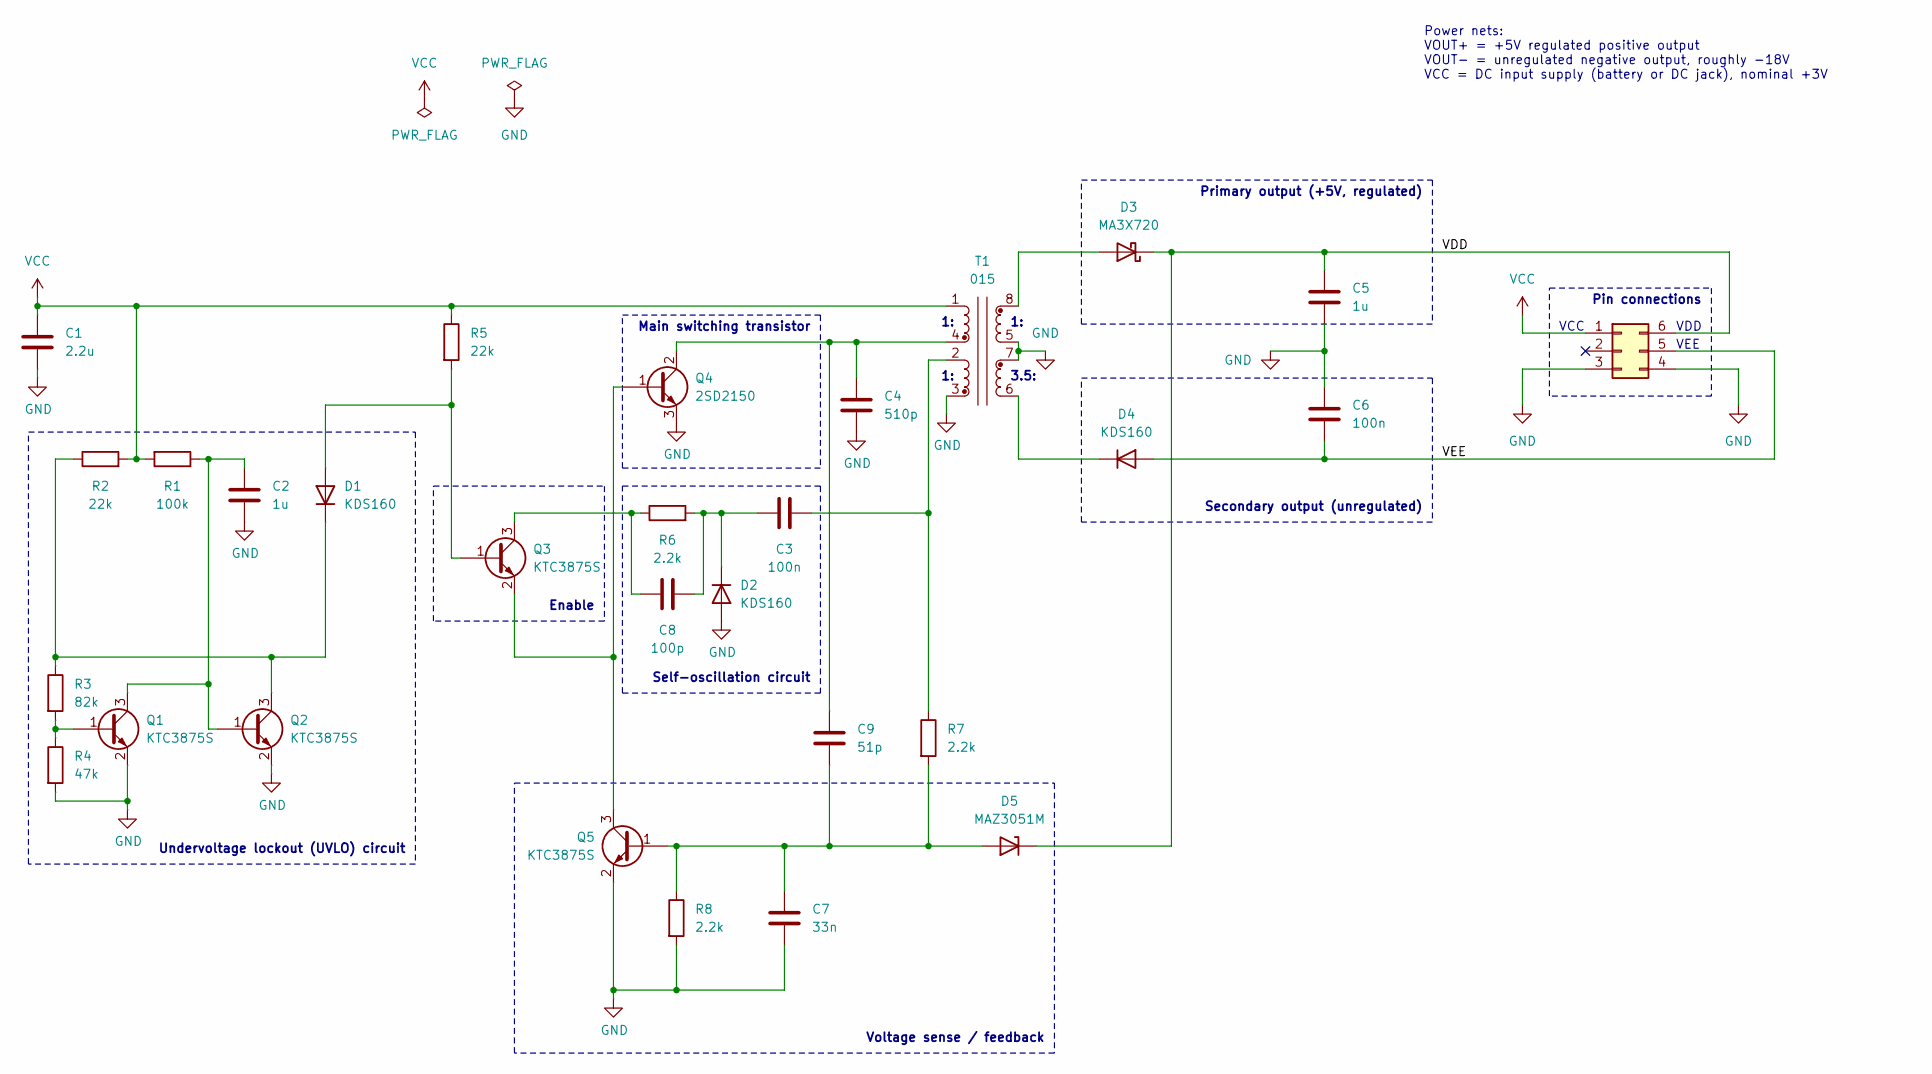
[picture p110: schematic MGB-DCDC-B.kicad_sch]

Parts:
C1: 2.2u
C2, C5: 1u
C3, C6: 100n
C4: 510p
C7: 33n
C8: 100p
C9: 51p
D1, D2, D4: KDS160
D3: MA3X720; SOT-23
D5: MAZ3051M
J1: Conn_02x03_Counter_Clockwise
Q1, Q2, Q3, Q5: KTC3875S
Q4: 2SD2150
R1: 100k
R2, R5: 22k
R3: 82k
R4: 47k
R6, R7, R8: 2.2k
T1: 015

Connections:
GND: C1.2, C2.1, C4.2, C5.2, C6.1, C7.1, D2.2 (A), J1.3, J1.4, Q1.2 (E), Q2.2 (E), Q4.3 (E), Q5.2 (E), R4.2, R8.2, T1.3, T1.5, T1.7
unnamed: C2.2, Q1.3 (C), Q2.1 (B), R1.1
unnamed: C3.1, C8.2, D2.1 (K), R6.2
unnamed: C3.2, R7.1, T1.2
unnamed: C4.1, C9.2, Q4.2 (C), T1.4
unnamed: C7.2, C9.1, D5.2 (A), Q5.1 (B), R7.2, R8.1
unnamed: C8.1, Q3.3 (C), R6.1
unnamed: D1.1 (K), Q2.3 (C), R2.1, R3.1
unnamed: D1.2 (A), Q3.1 (B), R5.2
unnamed: D3.1 (A), T1.8
unnamed: D4.1 (K), T1.6
unnamed: Q1.1 (B), R3.2, R4.1
unnamed: Q3.2 (E), Q4.1 (B), Q5.3 (C)
VCC: C1.1, J1.1, R1.2, R2.2, R5.1, T1.1
VDD: C5.1, D3.3 (K), D5.1 (K), J1.6
VEE: C6.2, D4.2 (A), J1.5

Notes on the sheet:
3.5:
Pin connections
Self-oscillation circuit
VEE
Power nets: VOUT+ = +5V regulated positive output VOUT- = unregulated negative output, roughly -18V VCC = DC input supply (battery or DC jack), nominal +3V
Enable
Main switching transistor
Undervoltage lockout (UVLO) circuit
Secondary output (unregulated)
Voltage sense / feedback
Primary output (+5V, regulated)
VDD
VCC
