Gekkio/gb-schematics/MGB-xCPU/MGB-xCPU.kicad_sch

## KiCad design MGB-xCPU/MGB-xCPU.kicad_sch (2023-07-18)

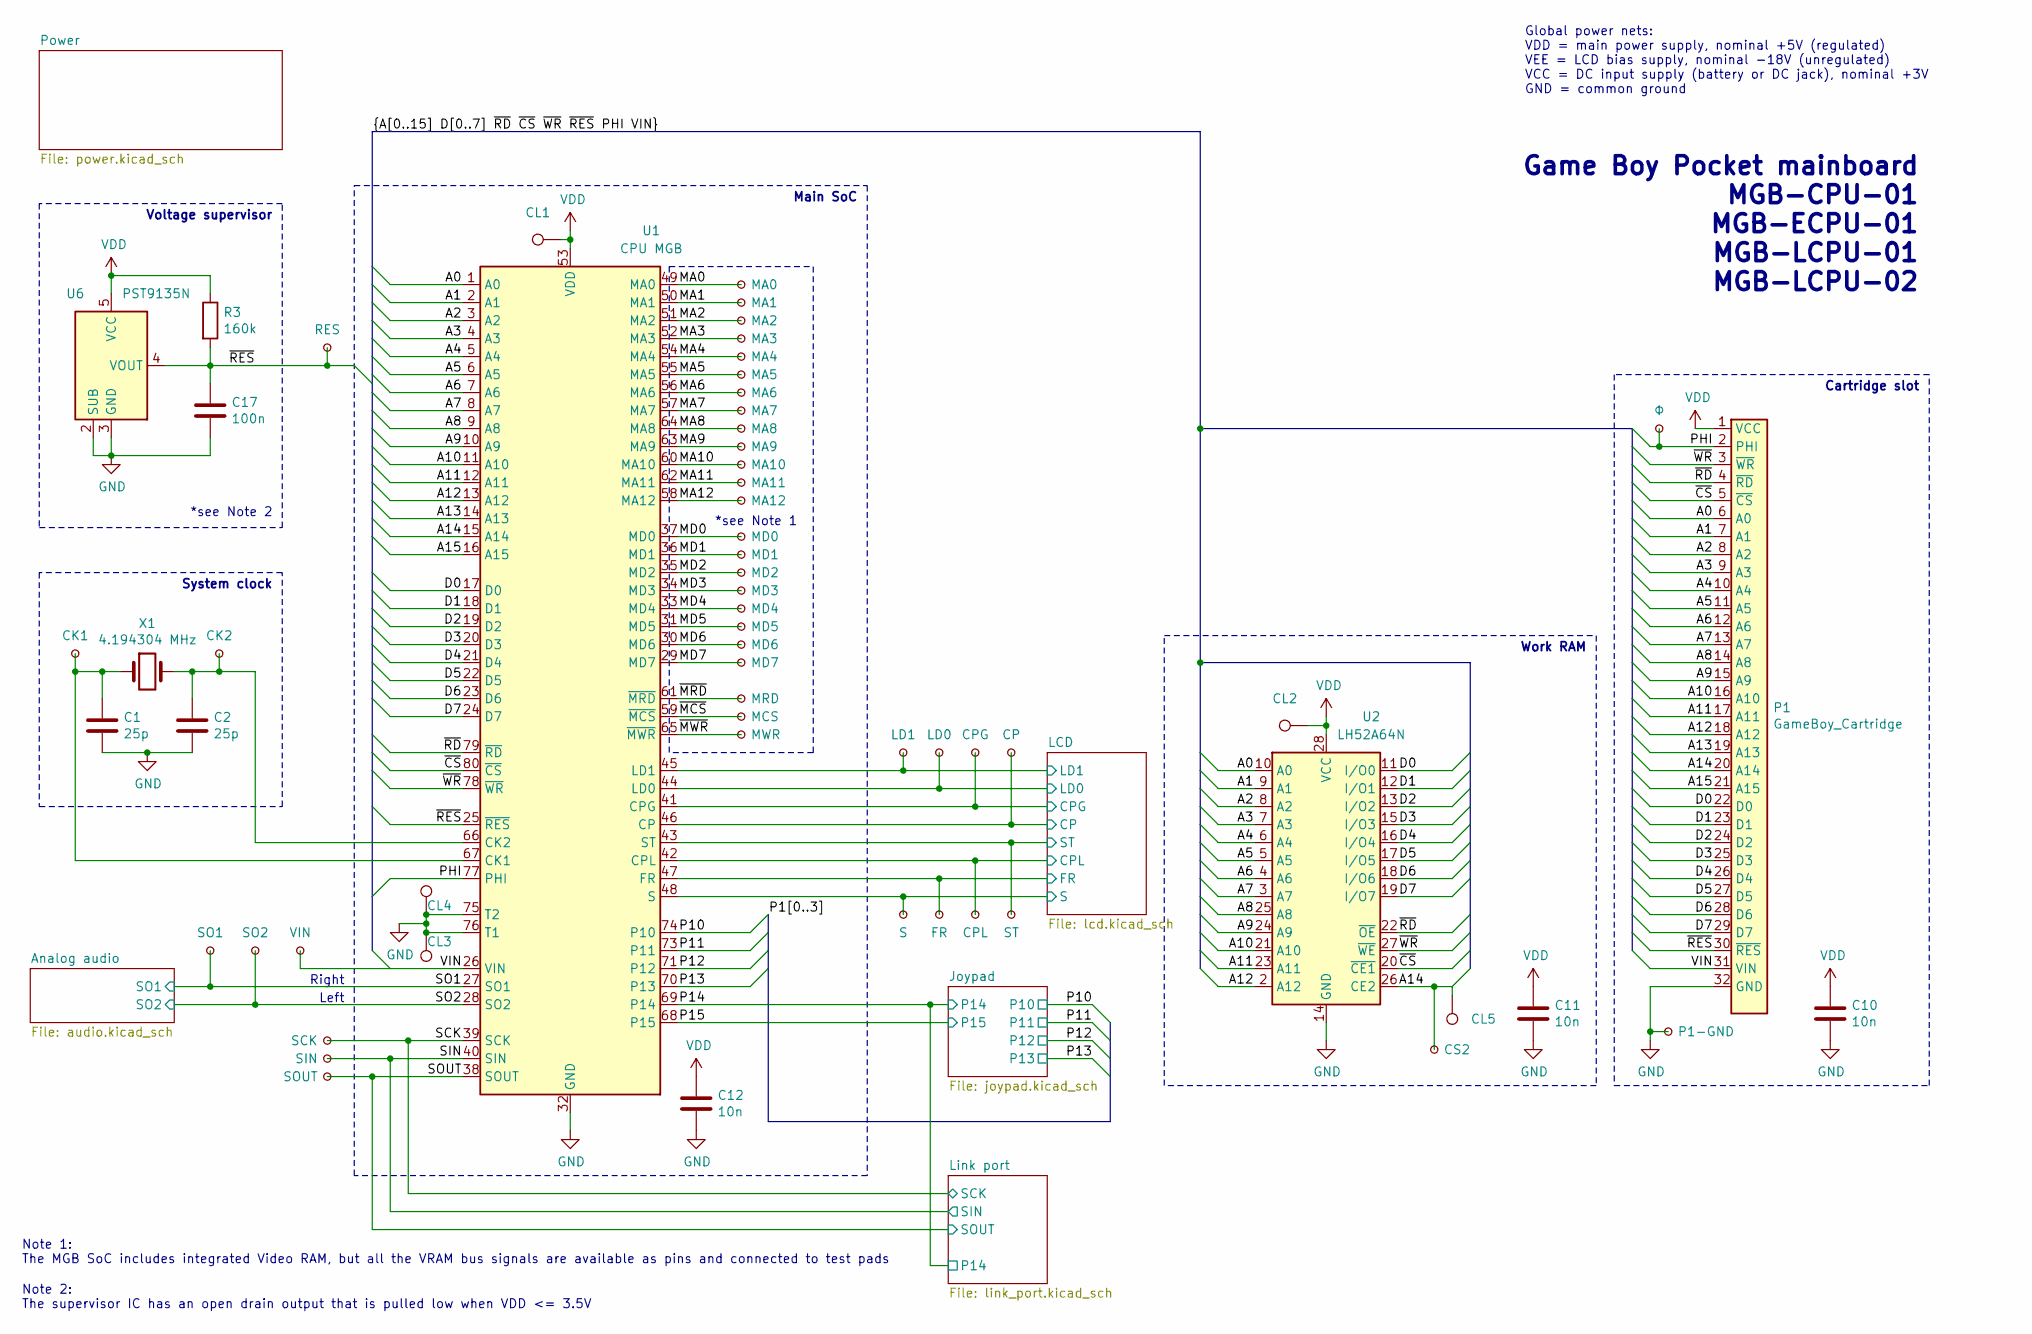
[picture p111: schematic MGB-xCPU.kicad_sch]

Parts:
C1, C2: 25p
C10, C11, C12: 10n
C17: 100n
CL1, CL2, CL3, CL4, CL5: TestPoint
P1: GameBoy_Cartridge
R3: 160k
TP1: CK1
TP2: SO1
TP3: CK2
TP4: SO2
TP5: VIN
TP6: RES
TP7: SCK
TP8: SIN
TP9: SOUT
TP10: MA0
TP11: MA1
TP12: MA2
TP13: MA3
TP14: MA4
TP15: MA5
TP16: MA6
TP17: MA7
TP18: MA8
TP19: MA9
TP20: MA10
TP21: MA11
TP22: MA12
TP23: MD0
TP24: MD1
TP25: MD2
TP26: MD3
TP27: MD4
TP28: MD5
TP29: MD6
TP30: MD7
TP31: MRD
TP32: MCS
TP33: MWR
TP34: LD1
TP35: S
TP36: LD0
TP37: FR
TP38: CPG
TP39: CPL
TP40: CP
TP41: ST
TP42: CS2
TP43: Φ
TP44: P1-GND
U1: CPU MGB; Sharp_QFP-80_14x20mm_P0.8mm
U2: LH52A64N; SOIC-28W_7.5x17.9mm_P1.27mm
U6: PST9135N; SOT-23-5
X1: 4.194304 MHz

Connections:
A0: P1.6 (A0), U1.1 (A0), U2.10 (A0)
A1: P1.7 (A1), U1.2 (A1), U2.9 (A1)
A2: P1.8 (A2), U1.3 (A2), U2.8 (A2)
A3: P1.9 (A3), U1.4 (A3), U2.7 (A3)
A4: P1.10 (A4), U1.5 (A4), U2.6 (A4)
A5: P1.11 (A5), U1.6 (A5), U2.5 (A5)
A6: P1.12 (A6), U1.7 (A6), U2.4 (A6)
A7: P1.13 (A7), U1.8 (A7), U2.3 (A7)
A8: P1.14 (A8), U1.9 (A8), U2.25 (A8)
A9: P1.15 (A9), U1.10 (A9), U2.24 (A9)
A10: P1.16 (A10), U1.11 (A10), U2.21 (A10)
A11: P1.17 (A11), U1.12 (A11), U2.23 (A11)
A12: P1.18 (A12), U1.13 (A12), U2.2 (A12)
A13: P1.19 (A13), U1.14 (A13)
A14: CL5.1, P1.20 (A14), TP42.1, U1.15 (A14), U2.26 (CE2)
A15: P1.21 (A15), U1.16 (A15)
CP: TP40.1, U1.46 (CP)
CPG: TP38.1, U1.41 (CPG)
CPL: TP39.1, U1.42 (CPL)
D0: P1.22 (D0), U1.17 (D0), U2.11 (I/O0)
D1: P1.23 (D1), U1.18 (D1), U2.12 (I/O1)
D2: P1.24 (D2), U1.19 (D2), U2.13 (I/O2)
D3: P1.25 (D3), U1.20 (D3), U2.15 (I/O3)
D4: P1.26 (D4), U1.21 (D4), U2.16 (I/O4)
D5: P1.27 (D5), U1.22 (D5), U2.17 (I/O5)
D6: P1.28 (D6), U1.23 (D6), U2.18 (I/O6)
D7: P1.29 (D7), U1.24 (D7), U2.19 (I/O7)
FR: TP37.1, U1.47 (FR)
GND: C1.2, C2.2, C10.2, C11.2, C12.2, C17.2, CL3.1, CL4.1, P1.32 (GND), TP44.1, U1.32 (GND), U1.72 (GND), U1.75 (T2), U1.76 (T1), U2.14 (GND), U6.2 (SUB), U6.3 (GND)
LD0: TP36.1, U1.44 (LD0)
LD1: TP34.1, U1.45 (LD1)
MA0: TP10.1, U1.49 (MA0)
MA1: TP11.1, U1.50 (MA1)
MA2: TP12.1, U1.51 (MA2)
MA3: TP13.1, U1.52 (MA3)
MA4: TP14.1, U1.54 (MA4)
MA5: TP15.1, U1.55 (MA5)
MA6: TP16.1, U1.56 (MA6)
MA7: TP17.1, U1.57 (MA7)
MA8: TP18.1, U1.64 (MA8)
MA9: TP19.1, U1.63 (MA9)
MA10: TP20.1, U1.60 (MA10)
MA11: TP21.1, U1.62 (MA11)
MA12: TP22.1, U1.58 (MA12)
MD0: TP23.1, U1.37 (MD0)
MD1: TP24.1, U1.36 (MD1)
MD2: TP25.1, U1.35 (MD2)
MD3: TP26.1, U1.34 (MD3)
MD4: TP27.1, U1.33 (MD4)
MD5: TP28.1, U1.31 (MD5)
MD6: TP29.1, U1.30 (MD6)
MD7: TP30.1, U1.29 (MD7)
unnamed: C1.1, TP1.1, U1.67 (CK1), X1.1
unnamed: C2.1, TP3.1, U1.66 (CK2), X1.2
P10: U1.74 (P10)
P11: U1.73 (P11)
P12: U1.71 (P12)
P13: U1.70 (P13)
P14: U1.69 (P14)
P15: U1.68 (P15)
PHI: P1.2 (PHI), TP43.1, U1.77 (PHI)
S: TP35.1, U1.48 (S)
SCK: TP7.1, U1.39 (SCK)
SIN: TP8.1, U1.40 (SIN)
SO1: TP2.1, U1.27 (SO1)
SO2: TP4.1, U1.28 (SO2)
SOUT: TP9.1, U1.38 (SOUT)
ST: TP41.1, U1.43 (ST)
VDD: C10.1, C11.1, C12.1, CL1.1, CL2.1, P1.1 (VCC), R3.1, U1.53 (VDD), U2.28 (VCC), U6.5 (VCC)
VIN: P1.31 (VIN), TP5.1, U1.26 (VIN)
~CS: P1.5 (~CS), U1.80 (~CS), U2.20 (~CE1)
~MCS: TP32.1, U1.59 (~MCS)
~MRD: TP31.1, U1.61 (~MRD)
~MWR: TP33.1, U1.65 (~MWR)
~RD: P1.4 (~RD), U1.79 (~RD), U2.22 (~OE)
~RES: C17.1, P1.30 (~RES), R3.2, TP6.1, U1.25 (~RES), U6.4 (VOUT)
~WR: P1.3 (~WR), U1.78 (~WR), U2.27 (~WE)

Notes on the sheet:
System clock
Cartridge slot
Main SoC
Note 1: The MGB SoC includes integrated Video RAM, but all the VRAM bus signals are available as pins and connected to test pads
Game Boy Pocket mainboard MGB-CPU-01 MGB-ECPU-01 MGB-LCPU-01 MGB-LCPU-02
Right
Global power nets: VDD = main power supply, nominal +5V (regulated) VEE = LCD bias supply, nominal -18V (unregulated) VCC = DC input supply (battery or DC jack), nominal +3V GND = common ground
Note 2: The supervisor IC has an open drain output that is pulled low when VDD <= 3.5V
Work RAM
*see Note 1
Left
*see Note 2
Voltage supervisor
