Gekkio/gb-schematics/MGB-xCPU/joypad.kicad_sch

## KiCad design MGB-xCPU/joypad.kicad_sch (2023-07-18)

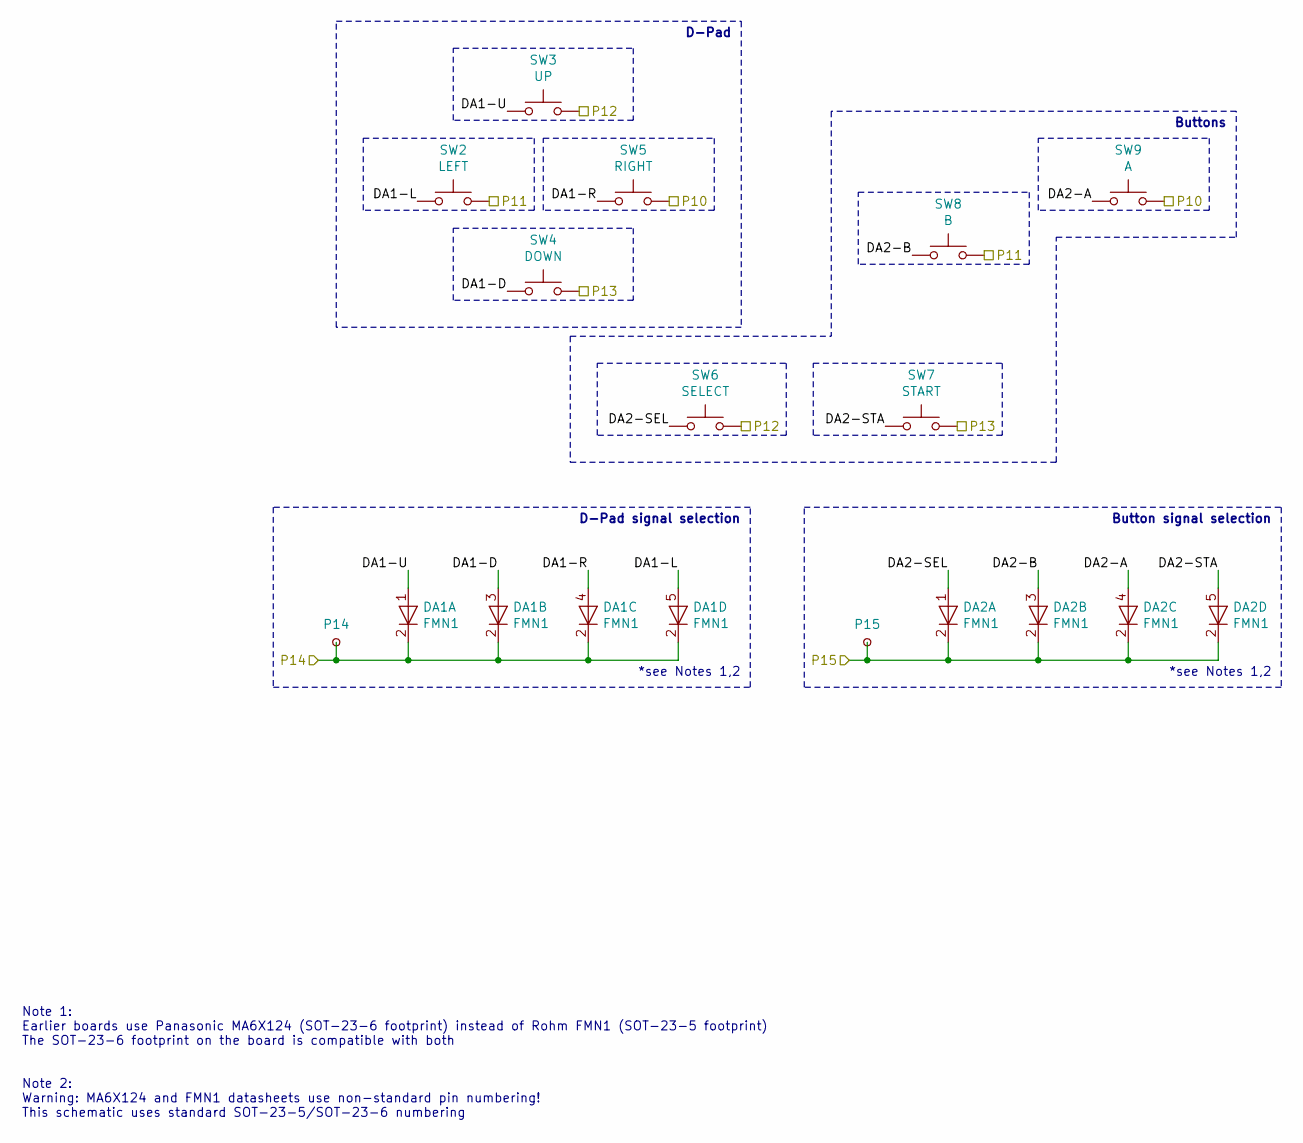
[picture p113: schematic joypad.kicad_sch]

Parts:
DA1, DA2: FMN1; SOT-23-5
SW2: LEFT
SW3: UP
SW4: DOWN
SW5: RIGHT
SW6: SELECT
SW7: START
SW8: B
SW9: A
TP45: P14
TP46: P15

Connections:
DA1-D: DA1.3 (A), SW4.1
DA1-L: DA1.5 (A), SW2.2
DA1-R: DA1.4 (A), SW5.1
DA1-U: DA1.1 (A), SW3.1
DA2-A: DA2.4 (A), SW9.1
DA2-B: DA2.3 (A), SW8.2
DA2-SEL: DA2.1 (A), SW6.1
DA2-STA: DA2.5 (A), SW7.1
P10: SW5.2, SW9.2
P11: SW2.1, SW8.1
P12: SW3.2, SW6.2
P13: SW4.2, SW7.2
P14: DA1.2 (K), TP45.1
P15: DA2.2 (K), TP46.1

Notes on the sheet:
*see Notes 1,2
Note 2: Warning: MA6X124 and FMN1 datasheets use non-standard pin numbering! This schematic uses standard SOT-23-5/SOT-23-6 numbering
D-Pad
Note 1: Earlier boards use Panasonic MA6X124 (SOT-23-6 footprint) instead of Rohm FMN1 (SOT-23-5 footprint) The SOT-23-6 footprint on the board is compatible with both
D-Pad signal selection
Button signal selection
Buttons
