Gekkio/gb-schematics/MGB-xCPU/link_port.kicad_sch

## KiCad design MGB-xCPU/link_port.kicad_sch (2023-07-18)

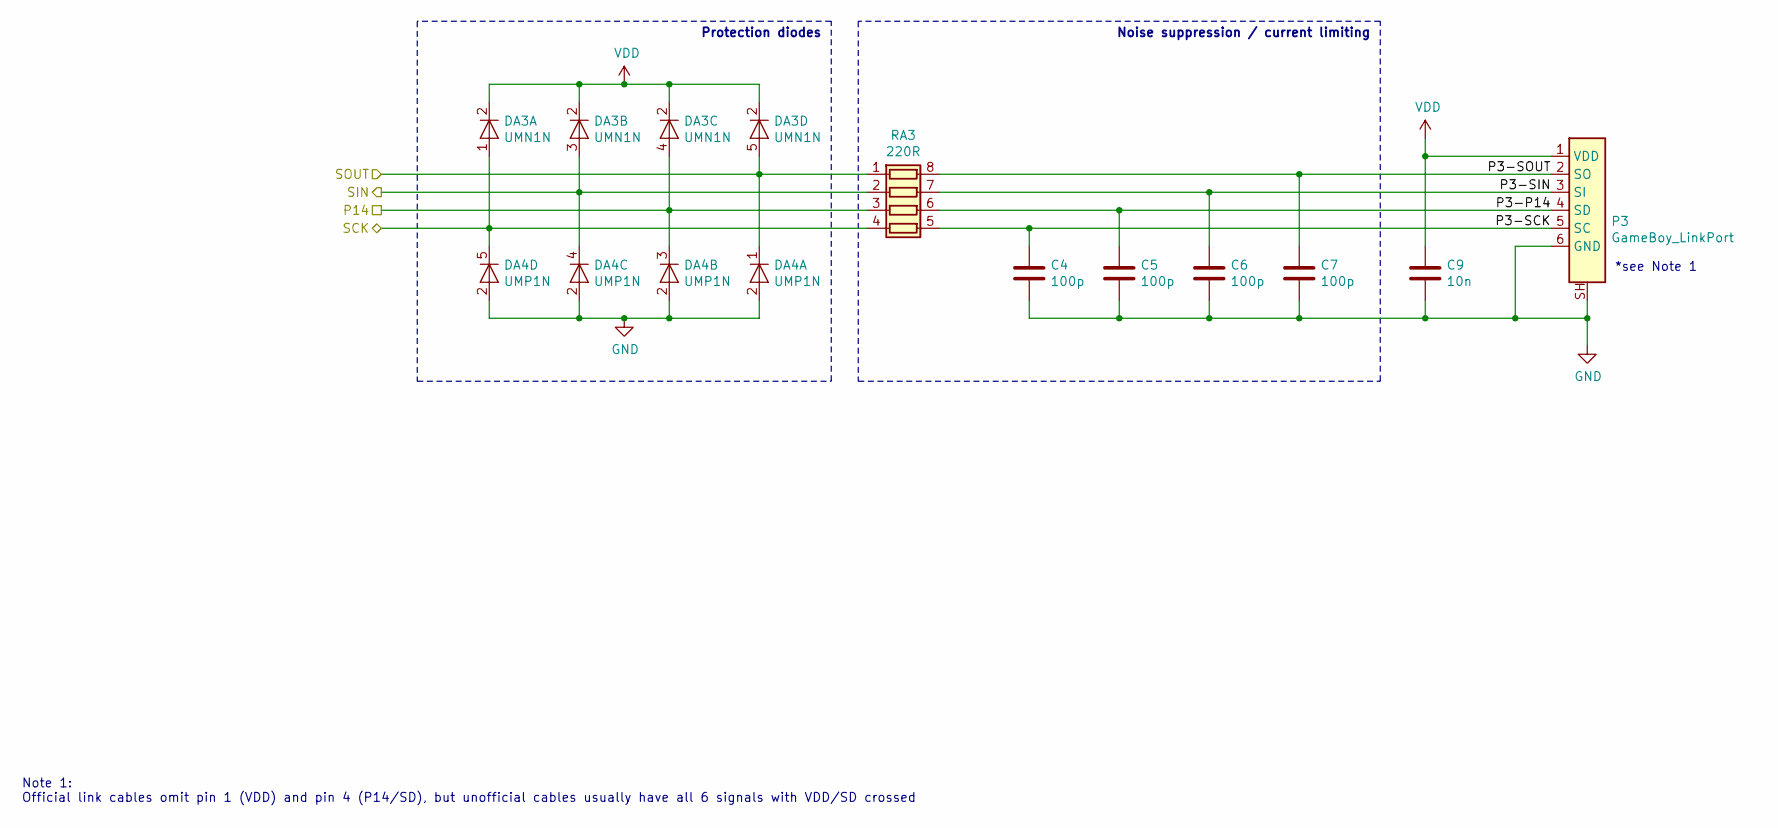
[picture p115: schematic link_port.kicad_sch]

Parts:
C4, C5, C6, C7: 100p
C9: 10n
DA3: UMN1N; SOT-353_SC-70-5
DA4: UMP1N; SOT-353_SC-70-5
P3: GameBoy_LinkPort
RA3: 220R

Connections:
GND: C4.2, C5.2, C6.2, C7.2, C9.2, DA4.2 (A), P3.6 (GND), P3.SH
P3-P14: C5.1, P3.4 (SD), RA3.6 (R3.2)
P3-SCK: C4.1, P3.5 (SC), RA3.5 (R4.2)
P3-SIN: C6.1, P3.3 (SI), RA3.7 (R2.2)
P3-SOUT: C7.1, P3.2 (SO), RA3.8 (R1.2)
P14: DA3.4 (A), DA4.3 (K), RA3.3 (R3.1)
SCK: DA3.1 (A), DA4.5 (K), RA3.4 (R4.1)
SIN: DA3.3 (A), DA4.4 (K), RA3.2 (R2.1)
SOUT: DA3.5 (A), DA4.1 (K), RA3.1 (R1.1)
VDD: C9.1, DA3.2 (K), P3.1 (VDD)

Notes on the sheet:
Note 1: Official link cables omit pin 1 (VDD) and pin 4 (P14/SD), but unofficial cables usually have all 6 signals with VDD/SD crossed
*see Note 1
Protection diodes
Noise suppression / current limiting
