Gekkio/gb-schematics/MGB-xCPU/power.kicad_sch

## KiCad design MGB-xCPU/power.kicad_sch (2023-07-18)

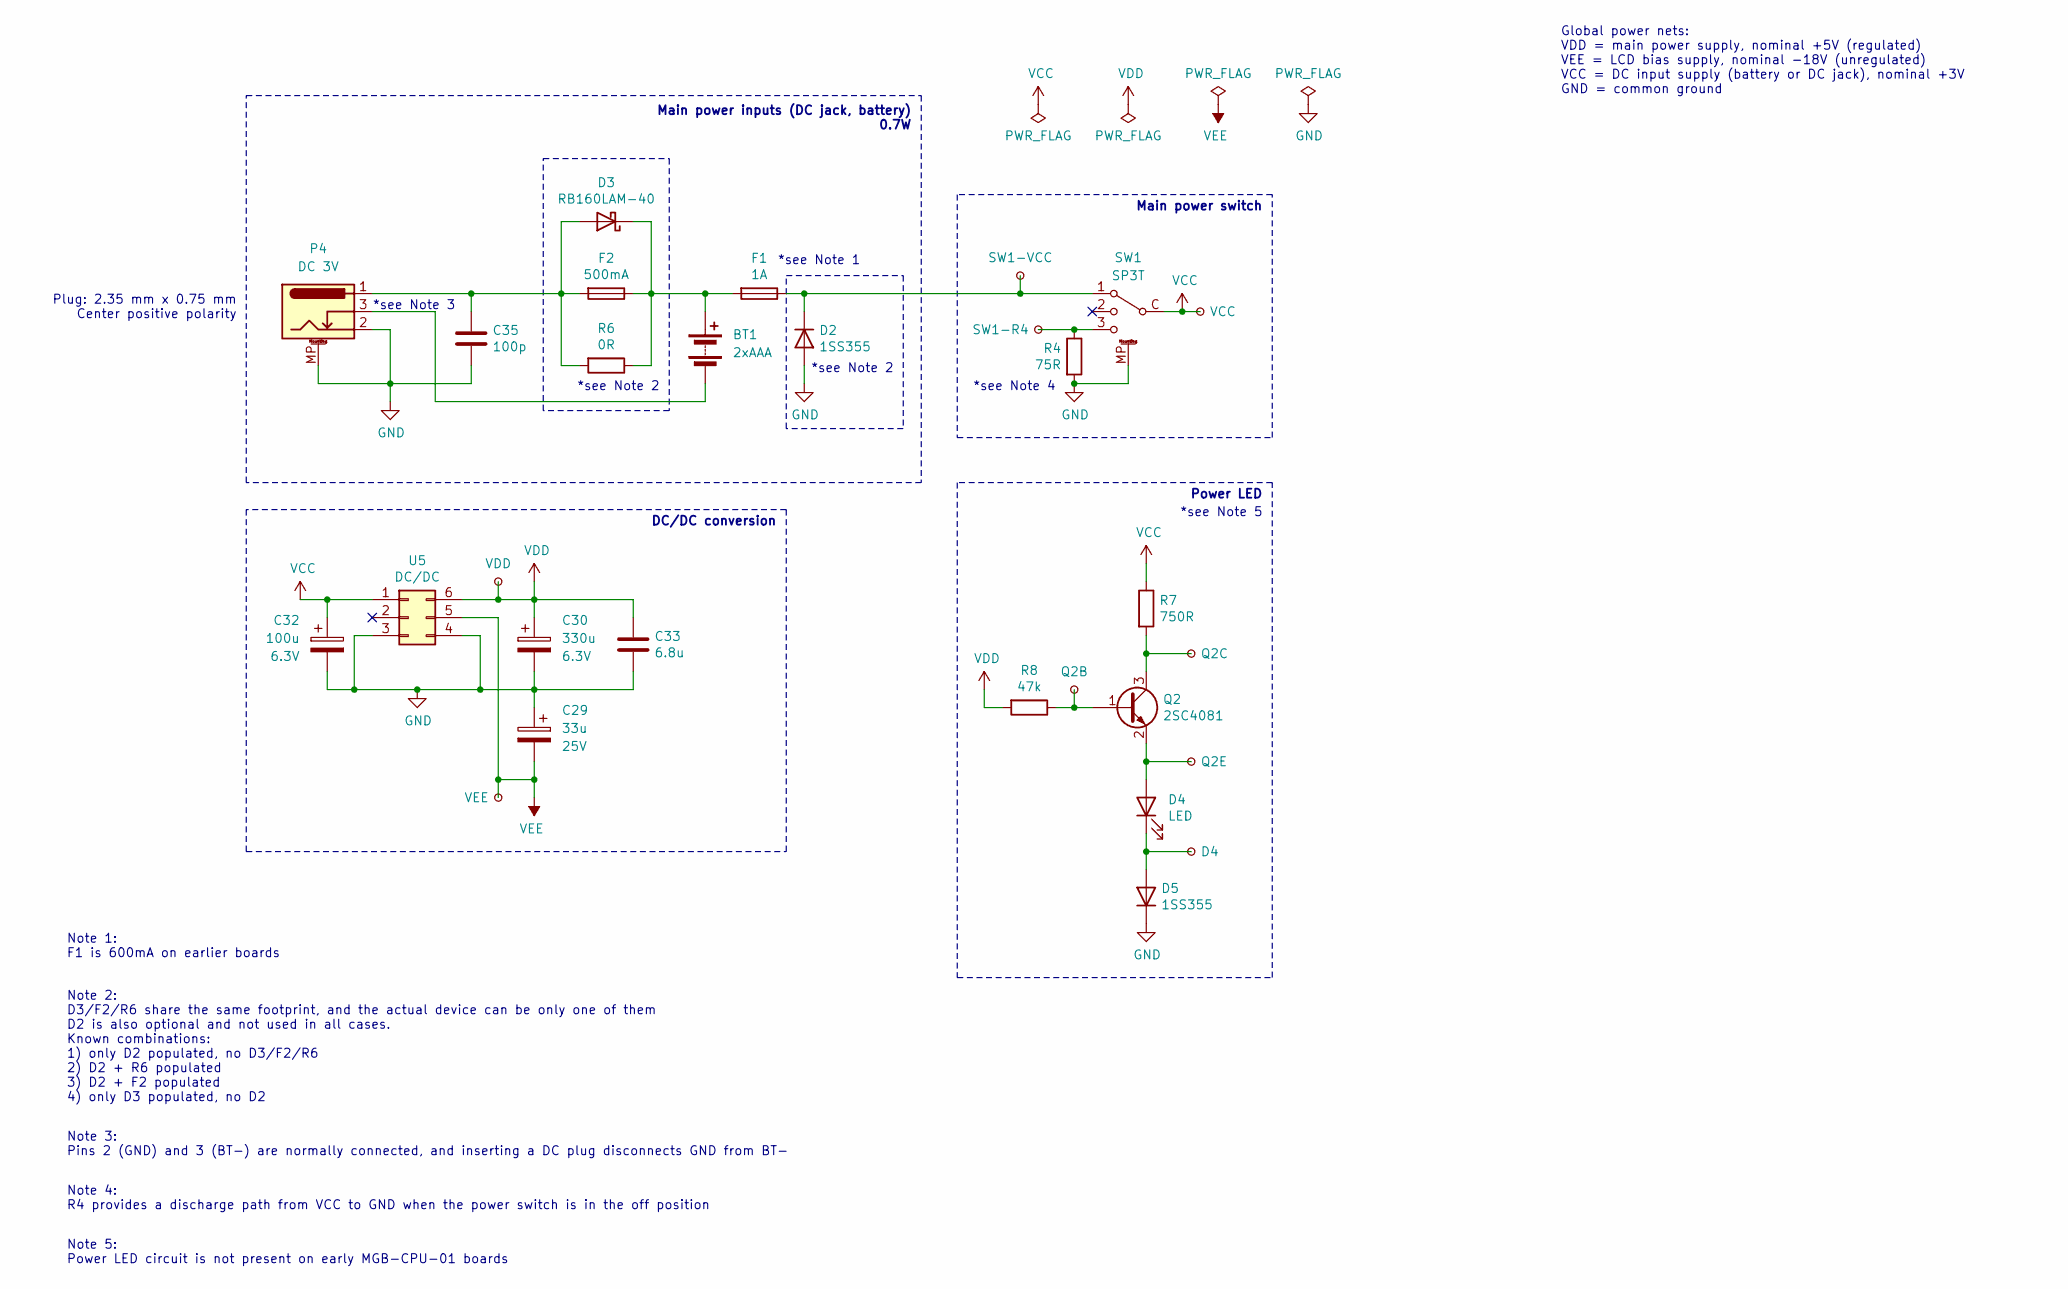
[picture p116: schematic power.kicad_sch]

Parts:
BT1: 2xAAA
C29: 33u; Rating 25V
C30: 330u; Rating 6.3V
C32: 100u; Rating 6.3V
C33: 6.8u
C35: 100p
D2, D5: 1SS355
D3: RB160LAM-40
D4: LED
F1: 1A
F2: 500mA
P4: DC 3V
Q2: 2SC4081
R4: 75R
R6: 0R
R7: 750R
R8: 47k
SW1: SP3T
TP55: VDD
TP56: VEE
TP57: SW1-VCC
TP58: SW1-R4
TP59: Q2B
TP60: VCC
TP61: Q2C
TP62: Q2E
TP63: D4
U5: DC/DC

Connections:
GND: C29.1, C30.2, C32.2, C33.2, C35.2, D2.2 (A), D5.1 (K), P4.2, P4.MP (MountPin), R4.2, SW1.MP, U5.3, U5.4
unnamed: BT1.1 (+), D3.1 (K), F1.2, F2.1, R6.1
unnamed: BT1.2 (-), P4.3
unnamed: C35.1, D3.2 (A), F2.2, P4.1, R6.2
unnamed: D2.1 (K), F1.1, SW1.1, TP57.1
unnamed: D4.1 (K), D5.2 (A), TP63.1
unnamed: D4.2 (A), Q2.2 (E), TP62.1
unnamed: Q2.1 (B), R8.1, TP59.1
unnamed: Q2.3 (C), R7.2, TP61.1
unnamed: R4.1, SW1.3, TP58.1
VCC: C32.1, R7.1, SW1.C, TP60.1, U5.1
VDD: C30.1, C33.1, R8.2, TP55.1, U5.6
VEE: C29.2, TP56.1, U5.5

Notes on the sheet:
Note 5: Power LED circuit is not present on early MGB-CPU-01 boards
*see Note 2
Main power switch
Note 2: D3/F2/R6 share the same footprint, and the actual device can be only one of them D2 is also optional and not used in all cases. Known combinations: 1) only D2 populated, no D3/F2/R6 2) D2 + R6 populated 3) D2 + F2 populated 4) only D3 populated, no D2
Plug: 2.35 mm x 0.75 mm Center positive polarity
*see Note 4
Main power inputs (DC jack, battery) 0.7W
Global power nets: VDD = main power supply, nominal +5V (regulated) VEE = LCD bias supply, nominal -18V (unregulated) VCC = DC input supply (battery or DC jack), nominal +3V GND = common ground
Note 1: F1 is 600mA on earlier boards
Note 3: Pins 2 (GND) and 3 (BT-) are normally connected, and inserting a DC plug disconnects GND from BT-
Power LED
*see Note 5
*see Note 1
DC/DC conversion
Note 4: R4 provides a discharge path from VCC to GND when the power switch is in the off position
*see Note 3
