Gekkio/gb-schematics/MGL-CPU-01/audio.kicad_sch

## KiCad design MGL-CPU-01/audio.kicad_sch (2023-08-22)

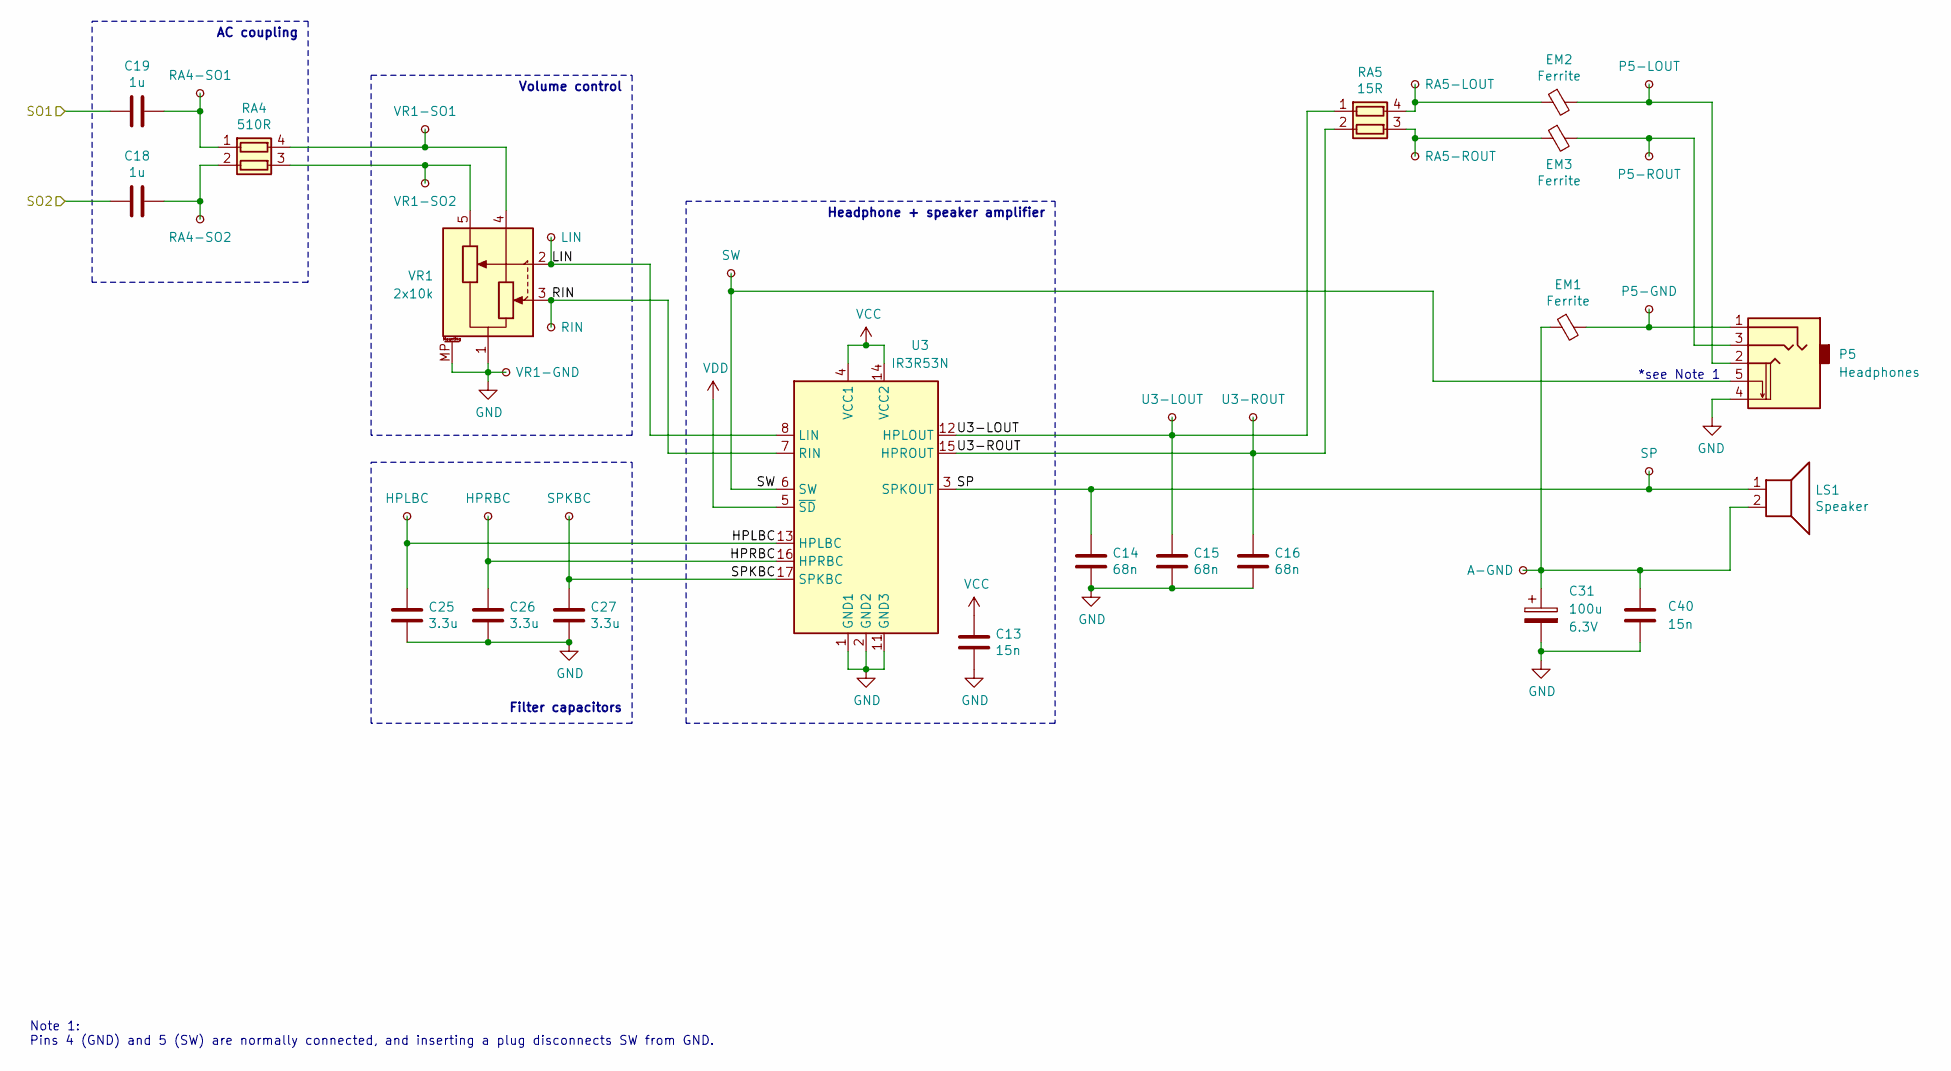
[picture p118: schematic audio.kicad_sch]

Parts:
C13, C40: 15n
C14, C15, C16: 68n
C18, C19: 1u
C25, C26, C27: 3.3u
C31: 100u; Rating 6.3V
EM1, EM2, EM3: Ferrite
LS1: Speaker
P5: Headphones
RA4: 510R
RA5: 15R
TP47: LIN
TP48: VR1-GND
TP49: RA4-SO1
TP50: RA4-SO2
TP51: RIN
TP52: VR1-SO1
TP53: VR1-SO2
TP54: HPLBC
TP85: HPRBC
TP86: SPKBC
TP87: SW
TP88: U3-LOUT
TP89: U3-ROUT
TP90: RA5-LOUT
TP91: RA5-ROUT
TP92: A-GND
TP93: P5-LOUT
TP94: P5-ROUT
TP95: P5-GND
TP96: SP
U3: IR3R53N; Sharp_SSOP-18_6x7.4mm_P0.8mm
VR1: 2x10k

Connections:
GND: C13.2, C14.2, C15.2, C16.2, C25.2, C26.2, C27.2, C31.2, C40.2, P5.4, TP48.1, U3.1 (GND1), U3.2 (GND2), U3.11 (GND3), VR1.1 (4), VR1.MP (MountPin)
HPLBC: C25.1, TP54.1, U3.13 (HPLBC)
HPRBC: C26.1, TP85.1, U3.16 (HPRBC)
LIN: TP47.1, U3.8 (LIN), VR1.2
unnamed: C18.1, RA4.2 (R2.1), TP50.1
unnamed: C19.1, RA4.1 (R1.1), TP49.1
unnamed: C31.1, C40.1, EM1.1, LS1.2, TP92.1
unnamed: EM1.2, P5.1, TP95.1
unnamed: EM2.1, RA5.4 (R1.2), TP90.1
unnamed: EM2.2, P5.2, TP93.1
unnamed: EM3.1, RA5.3 (R2.2), TP91.1
unnamed: EM3.2, P5.3, TP94.1
unnamed: RA4.3 (R2.2), TP53.1, VR1.5
unnamed: RA4.4 (R1.2), TP52.1, VR1.4
RIN: TP51.1, U3.7 (RIN), VR1.3
SO1: C19.2
SO2: C18.2
SP: C14.1, LS1.1, TP96.1, U3.3 (SPKOUT)
SPKBC: C27.1, TP86.1, U3.17 (SPKBC)
SW: P5.5, TP87.1, U3.6 (SW)
U3-LOUT: C15.1, RA5.1 (R1.1), TP88.1, U3.12 (HPLOUT)
U3-ROUT: C16.1, RA5.2 (R2.1), TP89.1, U3.15 (HPROUT)
VCC: C13.1, U3.4 (VCC1), U3.14 (VCC2)
VDD: U3.5 (~SD)

Notes on the sheet:
Note 1: Pins 4 (GND) and 5 (SW) are normally connected, and inserting a plug disconnects SW from GND.
*see Note 1
Headphone + speaker amplifier
AC coupling
Filter capacitors
Volume control
