Gekkio/gb-schematics/MGL-CPU-01/lcd.kicad_sch

## KiCad design MGL-CPU-01/lcd.kicad_sch (2023-08-22)

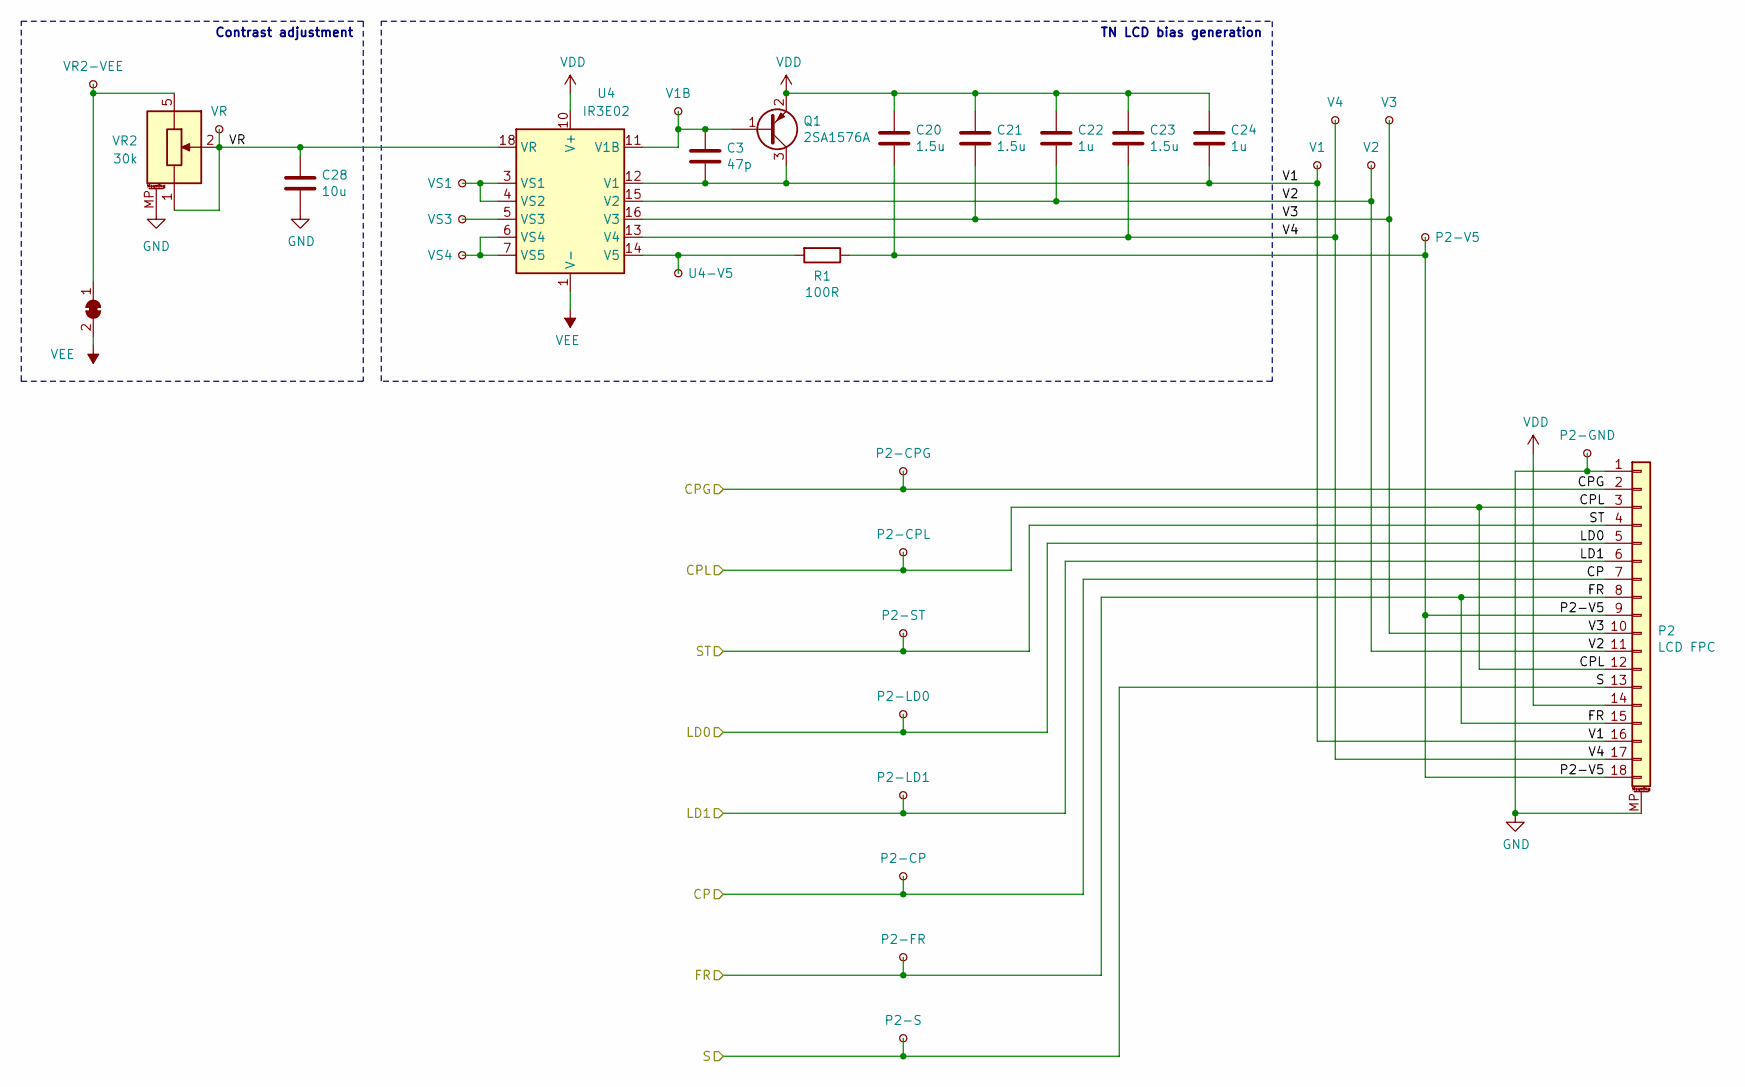
[picture p120: schematic lcd.kicad_sch]

Parts:
C3: 47p
C20, C21, C23: 1.5u
C22, C24: 1u
C28: 10u
JP1: SolderJumper_2_Bridged
P2: LCD FPC
Q1: 2SA1576A
R1: 100R
TP64: VR2-VEE
TP65: VR
TP66: VS1
TP67: VS3
TP68: VS4
TP69: V1B
TP70: U4-V5
TP71: P2-CPG
TP72: P2-CPL
TP73: P2-ST
TP74: P2-LD0
TP75: P2-LD1
TP76: P2-CP
TP77: P2-FR
TP78: P2-S
TP79: V1
TP80: V4
TP81: V2
TP82: V3
TP83: P2-V5
TP84: P2-GND
U4: IR3E02
VR2: 30k

Connections:
CP: P2.7, TP76.1
CPG: P2.2, TP71.1
CPL: P2.3, P2.12, TP72.1
FR: P2.8, P2.15, TP77.1
GND: C28.2, P2.1, P2.MP (MountPin), TP84.1, VR2.MP (MountPin)
LD0: P2.5, TP74.1
LD1: P2.6, TP75.1
unnamed: C3.1, Q1.1 (B), TP69.1, U4.11 (V1B)
unnamed: JP1.1 (A), TP64.1, VR2.5
unnamed: R1.2, TP70.1, U4.14 (V5)
unnamed: TP66.1, U4.3 (VS1), U4.4 (VS2)
unnamed: TP67.1, U4.5 (VS3)
unnamed: TP68.1, U4.6 (VS4), U4.7 (VS5)
P2-V5: C20.2, P2.9, P2.18, R1.1, TP83.1
S: P2.13, TP78.1
ST: P2.4, TP73.1
V1: C3.2, C24.2, P2.16, Q1.3 (C), TP79.1, U4.12 (V1)
V2: C22.2, P2.11, TP81.1, U4.15 (V2)
V3: C21.2, P2.10, TP82.1, U4.16 (V3)
V4: C23.2, P2.17, TP80.1, U4.13 (V4)
VDD: C20.1, C21.1, C22.1, C23.1, C24.1, P2.14, Q1.2 (E), U4.10 (V+)
VEE: JP1.2 (B), U4.1 (V-), U4.9 (V-)
VR: C28.1, TP65.1, U4.18 (VR), VR2.1 (4), VR2.2

Notes on the sheet:
TN LCD bias generation
Contrast adjustment
