Gekkio/gb-schematics/MGL-CPU-01/power.kicad_sch

## KiCad design MGL-CPU-01/power.kicad_sch (2023-08-22)

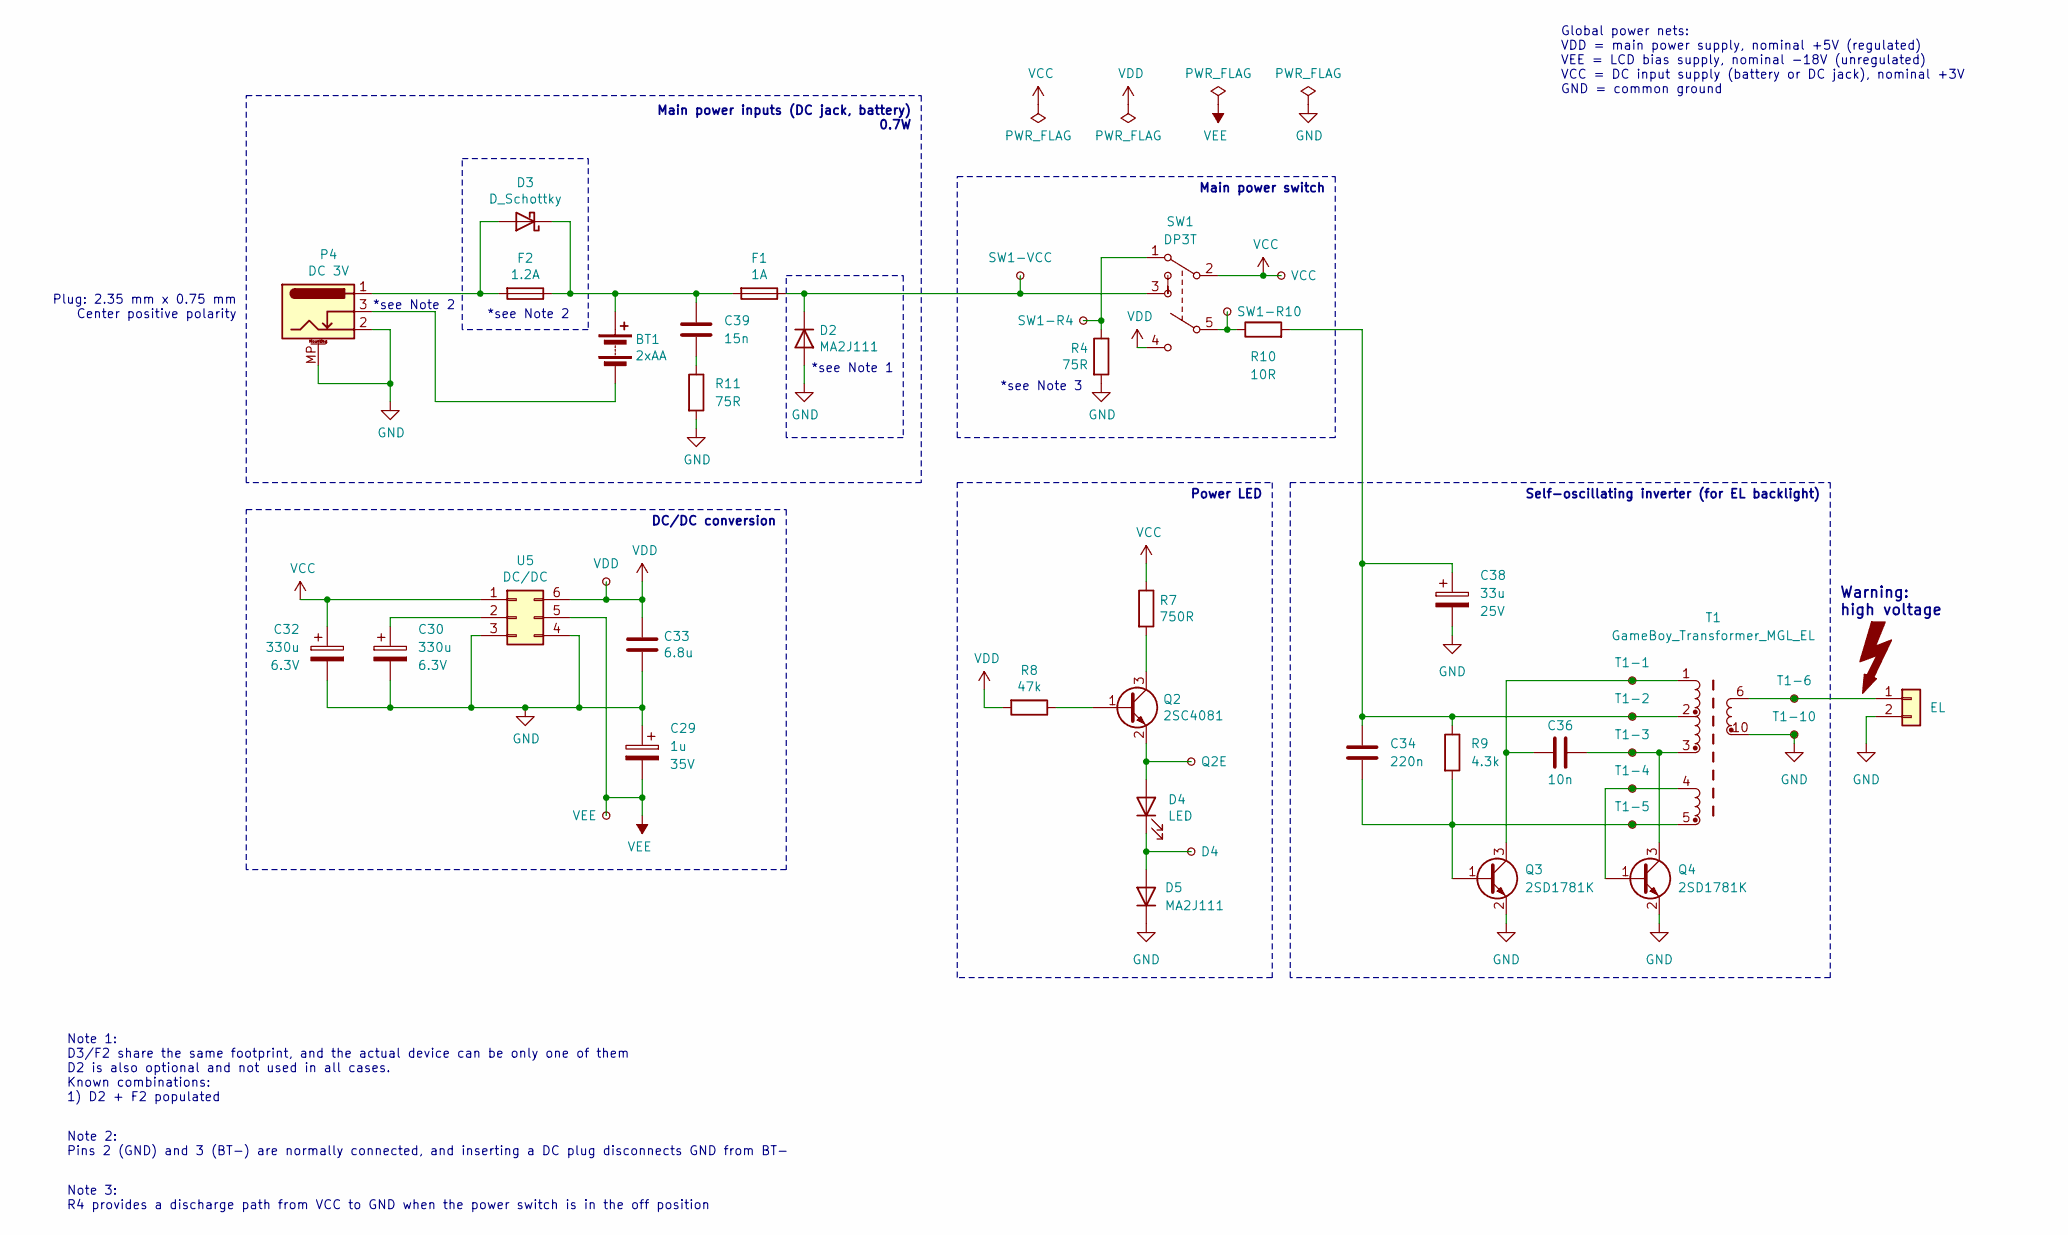
[picture p121: schematic power.kicad_sch]

Parts:
BT1: 2xAA
C29: 1u; Rating 35V
C30, C32: 330u; Rating 6.3V
C33: 6.8u
C34: 220n
C36: 10n
C38: 33u; Rating 25V
C39: 15n
D2, D5: MA2J111
D3: D_Schottky
D4: LED
F1: 1A
F2: 1.2A
J1: EL
P4: DC 3V
Q2: 2SC4081
Q3, Q4: 2SD1781K
R4, R11: 75R
R7: 750R
R8: 47k
R9: 4.3k
R10: 10R
SW1: DP3T
T1: GameBoy_Transformer_MGL_EL
TP55: VDD
TP56: VEE
TP57: SW1-VCC
TP58: SW1-R4
TP59: SW1-R10
TP60: VCC
TP61: T1-1
TP62: Q2E
TP63: D4
TP97: T1-2
TP98: T1-3
TP99: T1-4
TP100: T1-5
TP101: T1-6
TP102: T1-10
U5: DC/DC

Connections:
GND: C29.1, C30.2, C32.2, C33.2, C38.2, D2.2 (A), D5.1 (K), J1.2, P4.2, P4.MP (MountPin), Q3.2 (E), Q4.2 (E), R4.2, R11.2, T1.10, TP102.1, U5.3, U5.4
unnamed: BT1.1 (+), C39.1, D3.1 (K), F1.2, F2.1
unnamed: BT1.2 (-), P4.3
unnamed: C30.1, U5.2
unnamed: C34.1, C38.1, R9.1, R10.2, T1.2, TP97.1
unnamed: C34.2, Q3.1 (B), R9.2, T1.5, TP100.1
unnamed: C36.1, Q3.3 (C), T1.1, TP61.1
unnamed: C36.2, Q4.3 (C), T1.3, TP98.1
unnamed: C39.2, R11.1
unnamed: D2.1 (K), F1.1, SW1.3, TP57.1
unnamed: D3.2 (A), F2.2, P4.1
unnamed: D4.1 (K), D5.2 (A), TP63.1
unnamed: D4.2 (A), Q2.2 (E), TP62.1
unnamed: J1.1, T1.6, TP101.1
unnamed: Q2.1 (B), R8.1
unnamed: Q2.3 (C), R7.2
unnamed: Q4.1 (B), T1.4, TP99.1
unnamed: R4.1, SW1.1, TP58.1
unnamed: R10.1, SW1.5, TP59.1
VCC: C32.1, R7.1, SW1.2, TP60.1, U5.1
VDD: C33.1, R8.2, SW1.4, TP55.1, U5.6
VEE: C29.2, TP56.1, U5.5

Notes on the sheet:
Self-oscillating inverter (for EL backlight)
*see Note 1
Main power switch
Note 1: D3/F2 share the same footprint, and the actual device can be only one of them D2 is also optional and not used in all cases. Known combinations: 1) D2 + F2 populated
Plug: 2.35 mm x 0.75 mm Center positive polarity
*see Note 3
Main power inputs (DC jack, battery) 0.7W
Global power nets: VDD = main power supply, nominal +5V (regulated) VEE = LCD bias supply, nominal -18V (unregulated) VCC = DC input supply (battery or DC jack), nominal +3V GND = common ground
Note 2: Pins 2 (GND) and 3 (BT-) are normally connected, and inserting a DC plug disconnects GND from BT-
Power LED
*see Note 2
DC/DC conversion
Note 3: R4 provides a discharge path from VCC to GND when the power switch is in the off position
Warning: high voltage
