Gekkio/gb-schematics/SGB-R-xx_SGB-N-xx/SGB-R-xx_SGB-N-xx.kicad_sch

## KiCad design SGB-R-xx_SGB-N-xx/SGB-R-xx_SGB-N-xx.kicad_sch (2023-11-20)

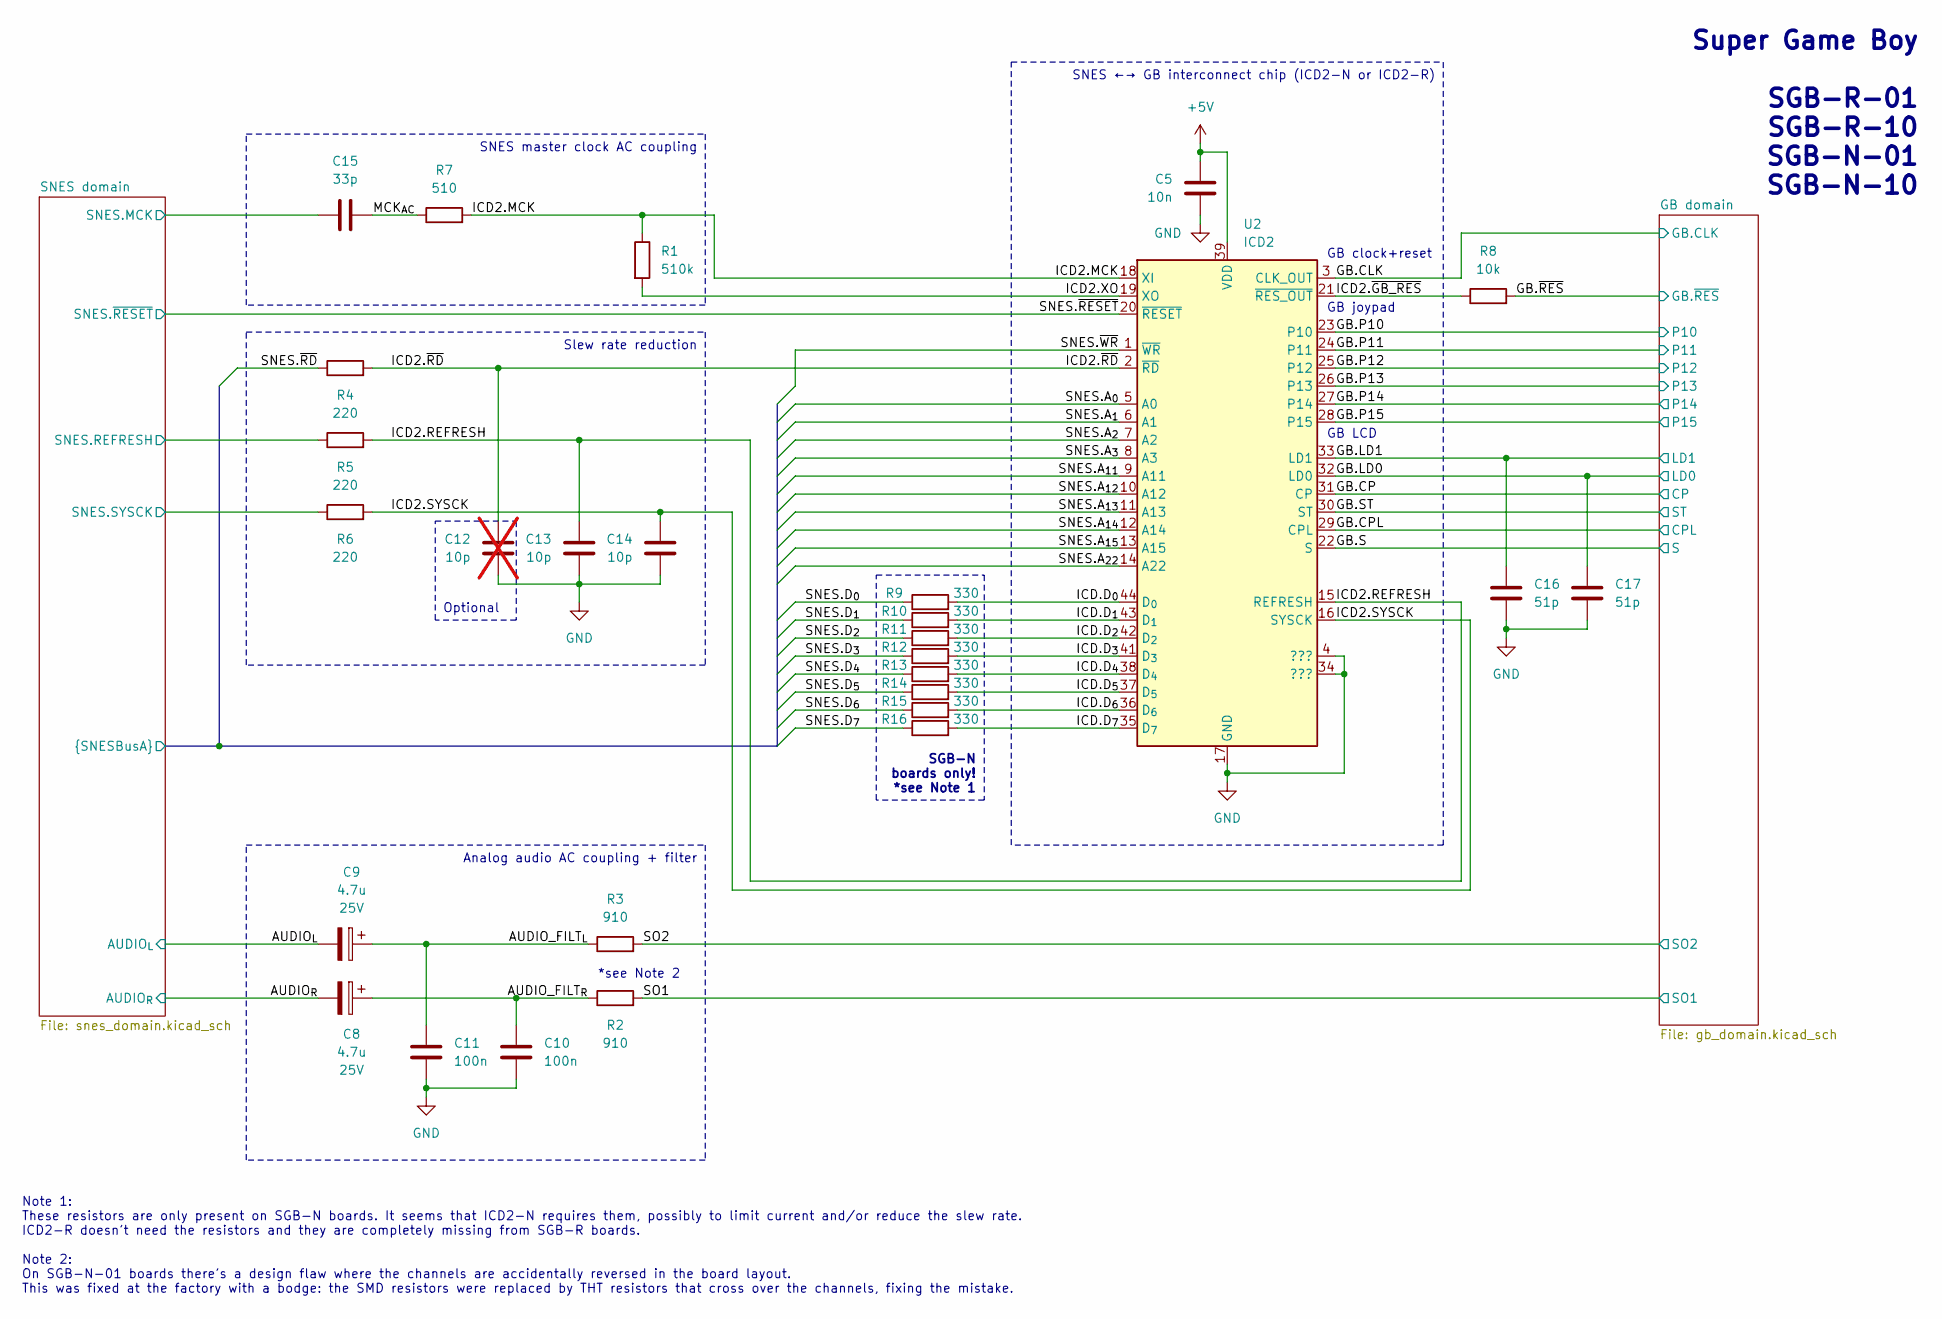
[picture p122: schematic SGB-R-xx_SGB-N-xx.kicad_sch]

Parts:
C5: 10n
C8, C9: 4.7u; Rating 25V
C10, C11: 100n
C12: 10p; not fitted
C13, C14: 10p
C15: 33p
C16, C17: 51p
R1: 510k
R2, R3: 910
R4, R5, R6: 220
R7: 510
R8: 10k
R9, R10, R11, R12, R13, R14, R15, R16: 330
U2: ICD2

Connections:
+5V: C5.1, U2.39 (VDD)
AUDIO_FILT_{L}: C9.1, C11.1, R3.1
AUDIO_FILT_{R}: C8.1, C10.1, R2.1
AUDIO_{L}: C9.2
AUDIO_{R}: C8.2
GB.CLK: U2.3 (CLK_OUT)
GB.CP: U2.31 (CP)
GB.CPL: U2.29 (CPL)
GB.LD0: C17.1, U2.32 (LD0)
GB.LD1: C16.1, U2.33 (LD1)
GB.P10: U2.23 (P10)
GB.P11: U2.24 (P11)
GB.P12: U2.25 (P12)
GB.P13: U2.26 (P13)
GB.P14: U2.27 (P14)
GB.P15: U2.28 (P15)
GB.S: U2.22 (S)
GB.ST: U2.30 (ST)
GB.~RES: R8.2
GND: C5.2, C10.2, C11.2, C12.2, C13.2, C14.2, C16.2, C17.2, U2.4 (???), U2.17 (GND), U2.34 (???), U2.40 (GND)
ICD2.MCK: R1.1, R7.2, U2.18 (XI)
ICD2.REFRESH: C13.1, R5.2, U2.15 (REFRESH)
ICD2.SYSCK: C14.1, R6.2, U2.16 (SYSCK)
ICD2.XO: R1.2, U2.19 (XO)
ICD2.~GB_RES: R8.1, U2.21 (~RES_OUT)
ICD2.~RD: C12.1, R4.2, U2.2 (~RD)
ICD.D_{0}: R9.2, U2.44 (D_{0})
ICD.D_{1}: R10.2, U2.43 (D_{1})
ICD.D_{2}: R11.2, U2.42 (D_{2})
ICD.D_{3}: R12.2, U2.41 (D_{3})
ICD.D_{4}: R13.2, U2.38 (D_{4})
ICD.D_{5}: R14.2, U2.37 (D_{5})
ICD.D_{6}: R15.2, U2.36 (D_{6})
ICD.D_{7}: R16.2, U2.35 (D_{7})
MCK_{AC}: C15.2, R7.1
SNES.A_{0}: U2.5 (A0)
SNES.A_{1}: U2.6 (A1)
SNES.A_{2}: U2.7 (A2)
SNES.A_{3}: U2.8 (A3)
SNES.A_{11}: U2.9 (A11)
SNES.A_{12}: U2.10 (A12)
SNES.A_{13}: U2.11 (A13)
SNES.A_{14}: U2.12 (A14)
SNES.A_{15}: U2.13 (A15)
SNES.A_{22}: U2.14 (A22)
SNES.D_{0}: R9.1
SNES.D_{1}: R10.1
SNES.D_{2}: R11.1
SNES.D_{3}: R12.1
SNES.D_{4}: R13.1
SNES.D_{5}: R14.1
SNES.D_{6}: R15.1
SNES.D_{7}: R16.1
SNES.MCK: C15.1
SNES.REFRESH: R5.1
SNES.SYSCK: R6.1
SNES.~RD: R4.1
SNES.~RESET: U2.20 (~RESET)
SNES.~WR: U2.1 (~WR)
SO1: R2.2
SO2: R3.2

Notes on the sheet:
SGB-N boards only! *see Note 1
SNES master clock AC coupling
Analog audio AC coupling + filter
Slew rate reduction
SNES ←→ GB interconnect chip (ICD2-N or ICD2-R)
Optional
GB joypad
*see Note 2
Note 1: These resistors are only present on SGB-N boards. It seems that ICD2-N requires them, possibly to limit current and/or reduce the slew rate. ICD2-R doesn't need the resistors and they are completely missing from SGB-R boards. Note 2: On SGB-N-01 boards there's a design flaw where the channe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
Super Game Boy SGB-R-01 SGB-R-10 SGB-N-01 SGB-N-10
GB clock+reset
GB LCD
