Gekkio/gb-schematics/SGB-R-xx_SGB-N-xx/gb_domain.kicad_sch

## KiCad design SGB-R-xx_SGB-N-xx/gb_domain.kicad_sch (2023-11-20)

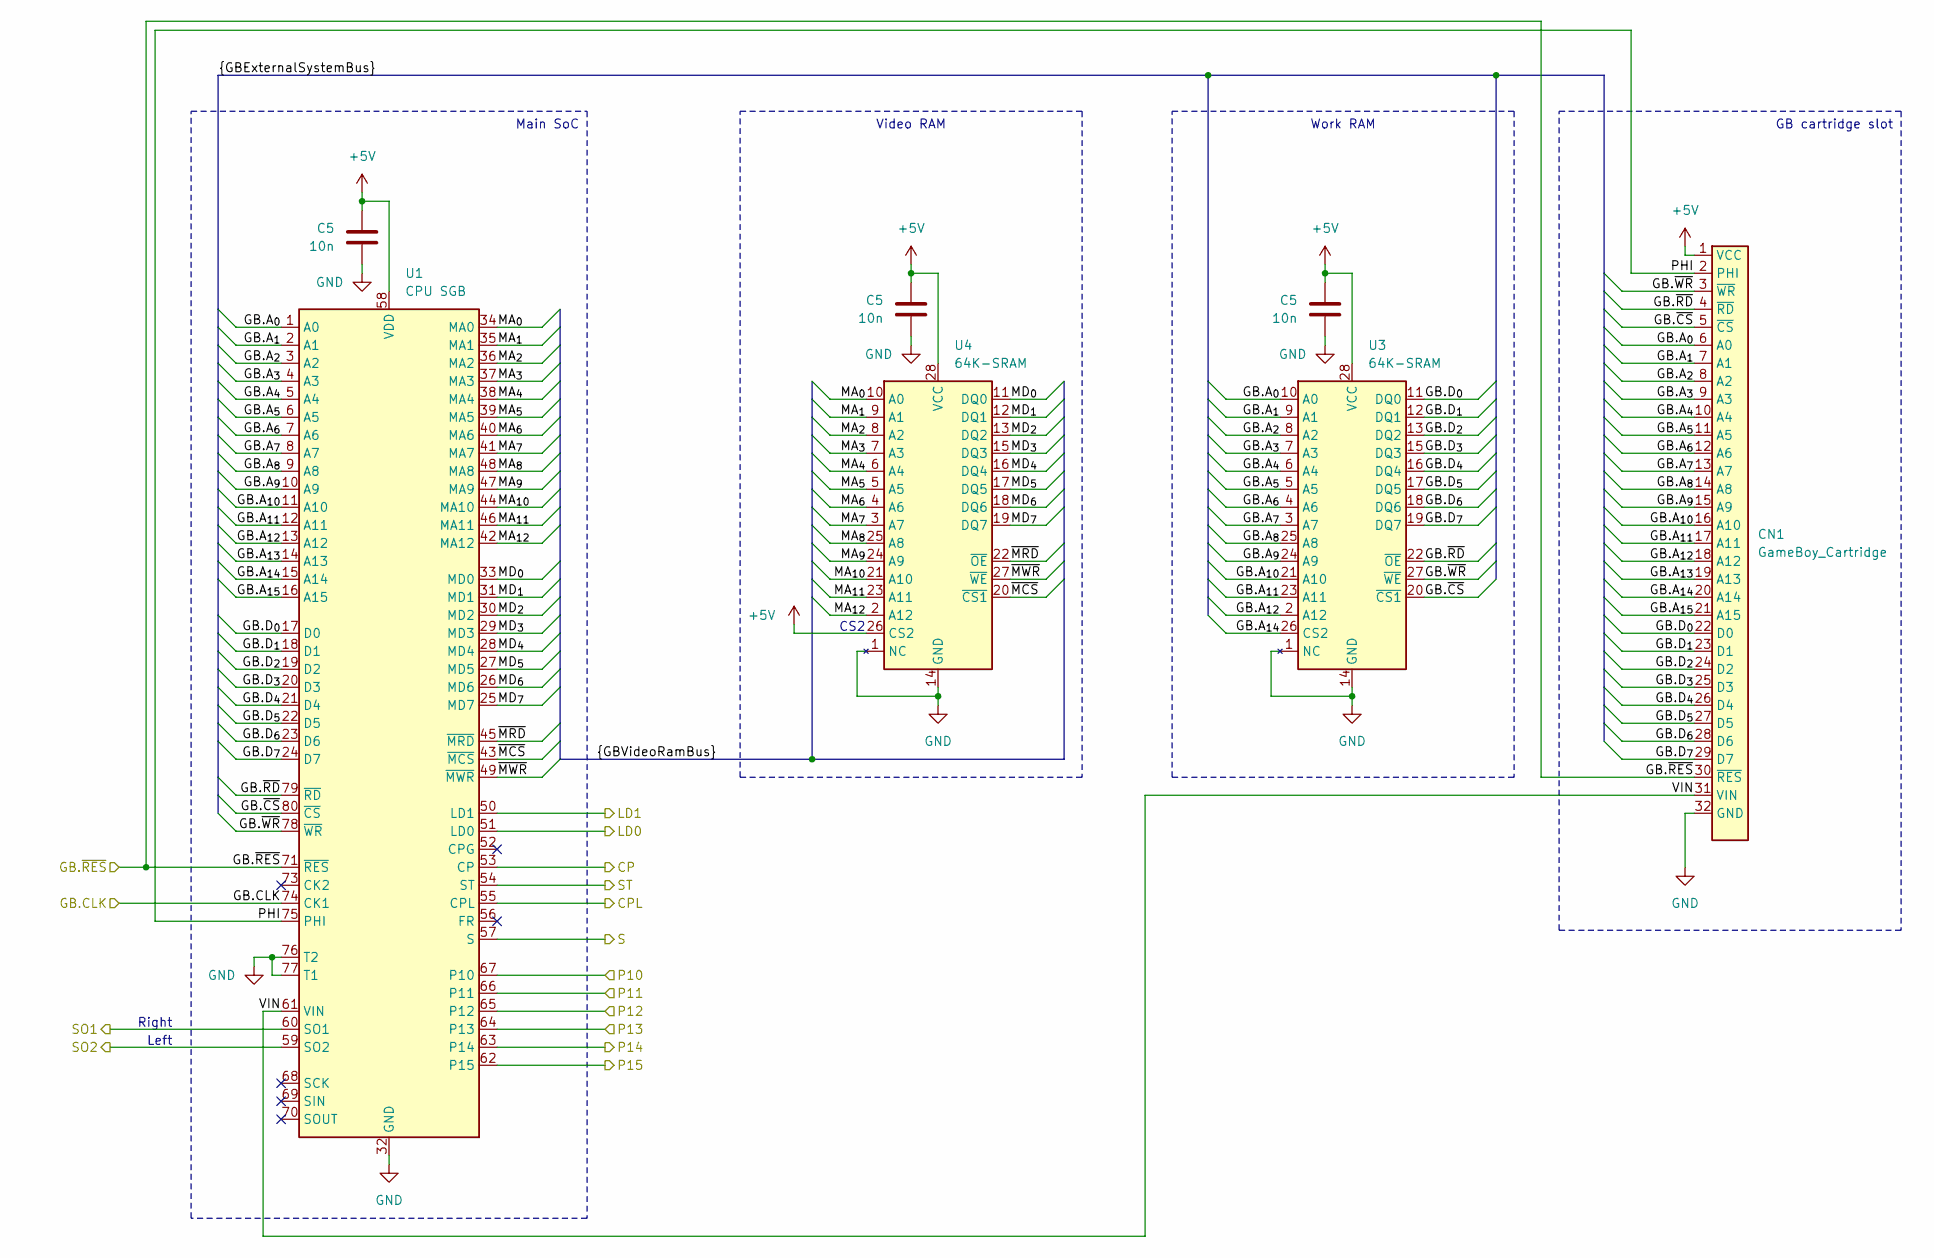
[picture p123: schematic gb_domain.kicad_sch]

Parts:
C5: 10n
CN1: GameBoy_Cartridge
U1: CPU SGB; Sharp_QFP-80_14x20mm_P0.8mm
U3, U4: 64K-SRAM; SOIC-28W_7.5x17.9mm_P1.27mm

Connections:
+5V: C5.1, CN1.1 (VCC), U1.58 (VDD), U3.28 (VCC), U4.26 (CS2), U4.28 (VCC)
CP: U1.53 (CP)
CPL: U1.55 (CPL)
GB.A_{0}: CN1.6 (A0), U1.1 (A0), U3.10 (A0)
GB.A_{1}: CN1.7 (A1), U1.2 (A1), U3.9 (A1)
GB.A_{2}: CN1.8 (A2), U1.3 (A2), U3.8 (A2)
GB.A_{3}: CN1.9 (A3), U1.4 (A3), U3.7 (A3)
GB.A_{4}: CN1.10 (A4), U1.5 (A4), U3.6 (A4)
GB.A_{5}: CN1.11 (A5), U1.6 (A5), U3.5 (A5)
GB.A_{6}: CN1.12 (A6), U1.7 (A6), U3.4 (A6)
GB.A_{7}: CN1.13 (A7), U1.8 (A7), U3.3 (A7)
GB.A_{8}: CN1.14 (A8), U1.9 (A8), U3.25 (A8)
GB.A_{9}: CN1.15 (A9), U1.10 (A9), U3.24 (A9)
GB.A_{10}: CN1.16 (A10), U1.11 (A10), U3.21 (A10)
GB.A_{11}: CN1.17 (A11), U1.12 (A11), U3.23 (A11)
GB.A_{12}: CN1.18 (A12), U1.13 (A12), U3.2 (A12)
GB.A_{13}: CN1.19 (A13), U1.14 (A13)
GB.A_{14}: CN1.20 (A14), U1.15 (A14), U3.26 (CS2)
GB.A_{15}: CN1.21 (A15), U1.16 (A15)
GB.CLK: U1.74 (CK1)
GB.D_{0}: CN1.22 (D0), U1.17 (D0), U3.11 (DQ0)
GB.D_{1}: CN1.23 (D1), U1.18 (D1), U3.12 (DQ1)
GB.D_{2}: CN1.24 (D2), U1.19 (D2), U3.13 (DQ2)
GB.D_{3}: CN1.25 (D3), U1.20 (D3), U3.15 (DQ3)
GB.D_{4}: CN1.26 (D4), U1.21 (D4), U3.16 (DQ4)
GB.D_{5}: CN1.27 (D5), U1.22 (D5), U3.17 (DQ5)
GB.D_{6}: CN1.28 (D6), U1.23 (D6), U3.18 (DQ6)
GB.D_{7}: CN1.29 (D7), U1.24 (D7), U3.19 (DQ7)
GB.~CS: CN1.5 (~CS), U1.80 (~CS), U3.20 (~CS1)
GB.~RD: CN1.4 (~RD), U1.79 (~RD), U3.22 (~OE)
GB.~RES: CN1.30 (~RES), U1.71 (~RES)
GB.~WR: CN1.3 (~WR), U1.78 (~WR), U3.27 (~WE)
GND: C5.2, CN1.32 (GND), U1.32 (GND), U1.72 (GND), U1.76 (T2), U1.77 (T1), U3.1 (NC), U3.14 (GND), U4.1 (NC), U4.14 (GND)
LD0: U1.51 (LD0)
LD1: U1.50 (LD1)
MA_{0}: U1.34 (MA0), U4.10 (A0)
MA_{1}: U1.35 (MA1), U4.9 (A1)
MA_{2}: U1.36 (MA2), U4.8 (A2)
MA_{3}: U1.37 (MA3), U4.7 (A3)
MA_{4}: U1.38 (MA4), U4.6 (A4)
MA_{5}: U1.39 (MA5), U4.5 (A5)
MA_{6}: U1.40 (MA6), U4.4 (A6)
MA_{7}: U1.41 (MA7), U4.3 (A7)
MA_{8}: U1.48 (MA8), U4.25 (A8)
MA_{9}: U1.47 (MA9), U4.24 (A9)
MA_{10}: U1.44 (MA10), U4.21 (A10)
MA_{11}: U1.46 (MA11), U4.23 (A11)
MA_{12}: U1.42 (MA12), U4.2 (A12)
MD_{0}: U1.33 (MD0), U4.11 (DQ0)
MD_{1}: U1.31 (MD1), U4.12 (DQ1)
MD_{2}: U1.30 (MD2), U4.13 (DQ2)
MD_{3}: U1.29 (MD3), U4.15 (DQ3)
MD_{4}: U1.28 (MD4), U4.16 (DQ4)
MD_{5}: U1.27 (MD5), U4.17 (DQ5)
MD_{6}: U1.26 (MD6), U4.18 (DQ6)
MD_{7}: U1.25 (MD7), U4.19 (DQ7)
P10: U1.67 (P10)
P11: U1.66 (P11)
P12: U1.65 (P12)
P13: U1.64 (P13)
P14: U1.63 (P14)
P15: U1.62 (P15)
PHI: CN1.2 (PHI), U1.75 (PHI)
S: U1.57 (S)
SO1: U1.60 (SO1)
SO2: U1.59 (SO2)
ST: U1.54 (ST)
VIN: CN1.31 (VIN), U1.61 (VIN)
~MCS: U1.43 (~MCS), U4.20 (~CS1)
~MRD: U1.45 (~MRD), U4.22 (~OE)
~MWR: U1.49 (~MWR), U4.27 (~WE)

Notes on the sheet:
Main SoC
Video RAM
GB cartridge slot
Work RAM
CS2
Left
Right
