Gekkio/gb-schematics/SGB-R-xx_SGB-N-xx/snes_domain.kicad_sch

## KiCad design SGB-R-xx_SGB-N-xx/snes_domain.kicad_sch (2023-11-20)

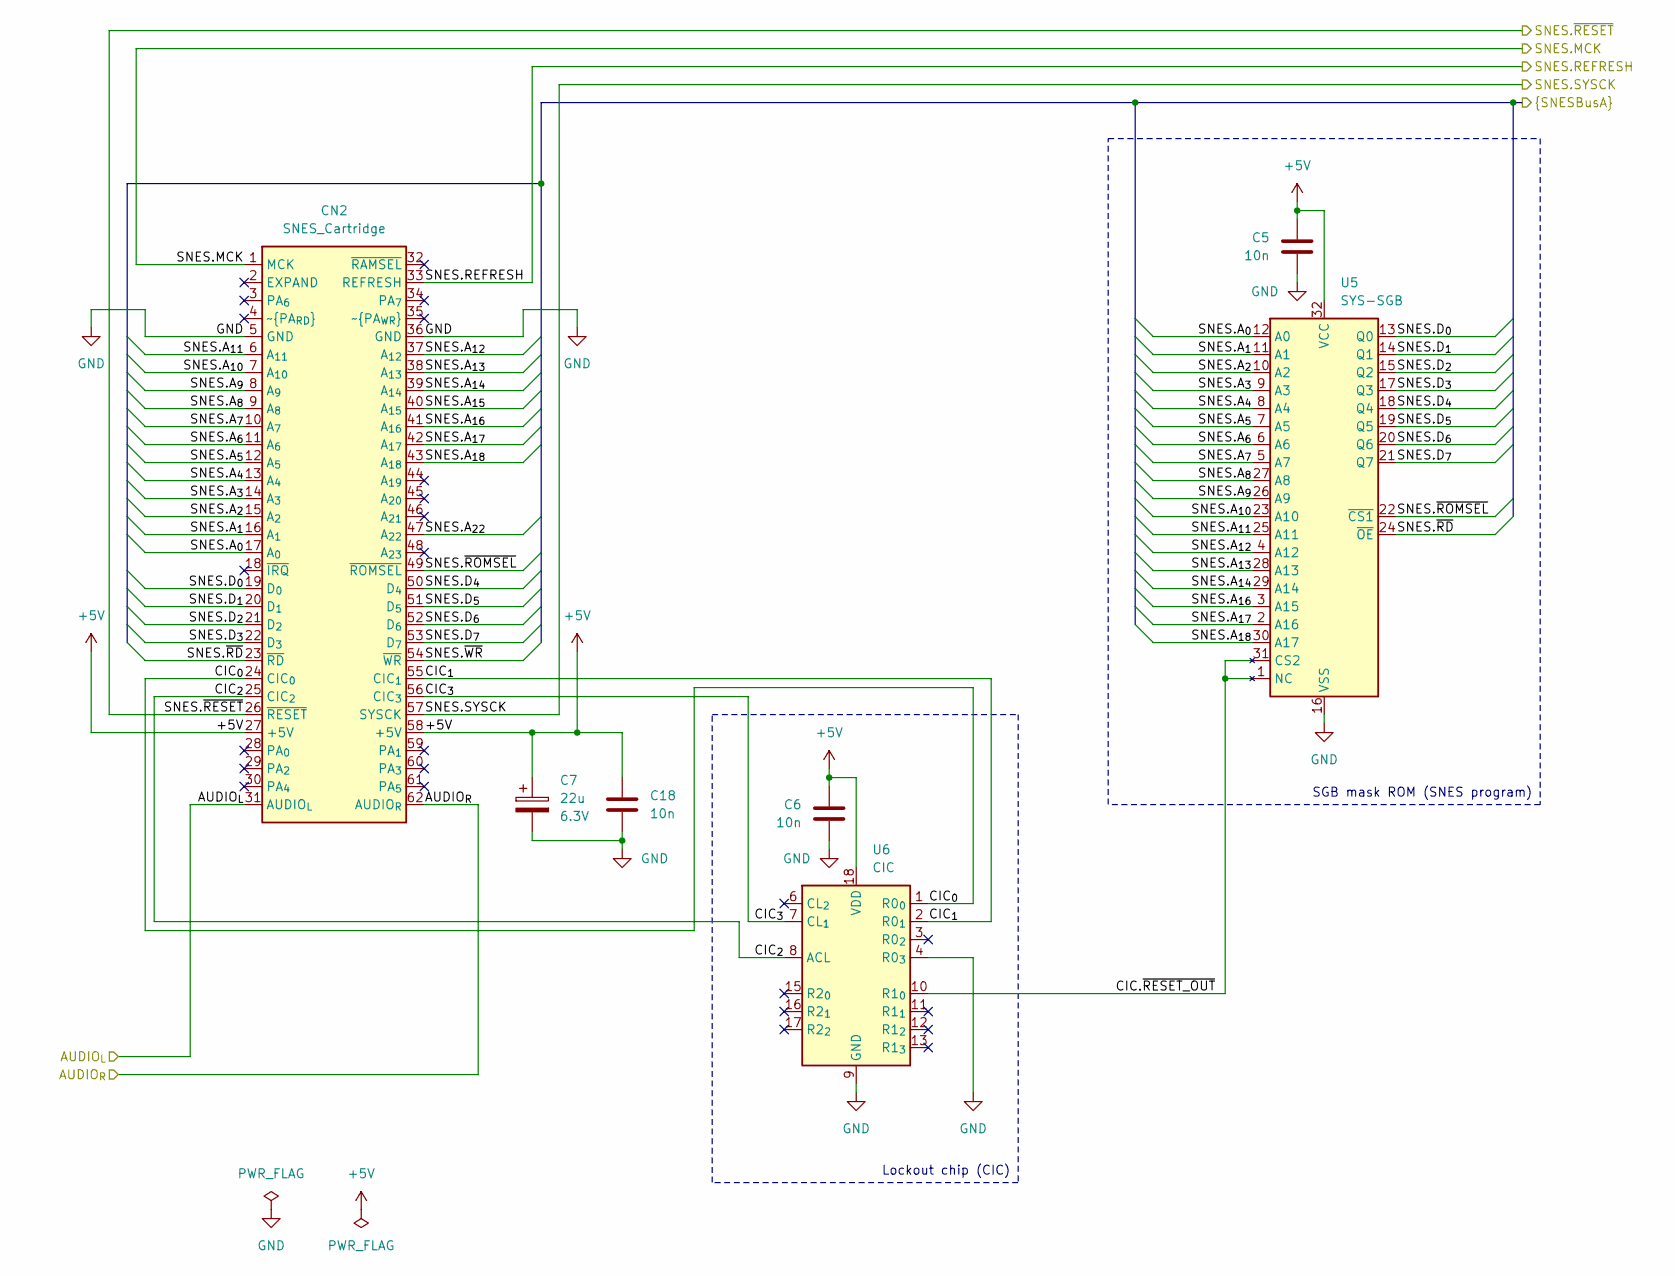
[picture p124: schematic snes_domain.kicad_sch]

Parts:
C5, C6, C18: 10n
C7: 22u; Rating 6.3V
CN2: SNES_Cartridge
U5: SYS-SGB
U6: CIC

Connections:
+5V: C5.1, C6.1, C7.1, C18.1, CN2.27 (+5V), CN2.58 (+5V), U5.32 (VCC), U6.18 (VDD)
AUDIO_{L}: CN2.31 (AUDIO_{L})
AUDIO_{R}: CN2.62 (AUDIO_{R})
CIC.~RESET_OUT: U5.1 (NC), U5.31 (NC), U6.10 (R1_{0})
CIC_{0}: CN2.24 (CIC_{0}), U6.1 (R0_{0})
CIC_{1}: CN2.55 (CIC_{1}), U6.2 (R0_{1})
CIC_{2}: CN2.25 (CIC_{2}), U6.8 (ACL)
CIC_{3}: CN2.56 (CIC_{3}), U6.7 (CL_{1})
GND: C5.2, C6.2, C7.2, C18.2, CN2.5 (GND), CN2.36 (GND), U5.16 (VSS), U6.4 (R0_{3}), U6.9 (GND)
SNES.A_{0}: CN2.17 (A_{0}), U5.12 (A0)
SNES.A_{1}: CN2.16 (A_{1}), U5.11 (A1)
SNES.A_{2}: CN2.15 (A_{2}), U5.10 (A2)
SNES.A_{3}: CN2.14 (A_{3}), U5.9 (A3)
SNES.A_{4}: CN2.13 (A_{4}), U5.8 (A4)
SNES.A_{5}: CN2.12 (A_{5}), U5.7 (A5)
SNES.A_{6}: CN2.11 (A_{6}), U5.6 (A6)
SNES.A_{7}: CN2.10 (A_{7}), U5.5 (A7)
SNES.A_{8}: CN2.9 (A_{8}), U5.27 (A8)
SNES.A_{9}: CN2.8 (A_{9}), U5.26 (A9)
SNES.A_{10}: CN2.7 (A_{10}), U5.23 (A10)
SNES.A_{11}: CN2.6 (A_{11}), U5.25 (A11)
SNES.A_{12}: CN2.37 (A_{12}), U5.4 (A12)
SNES.A_{13}: CN2.38 (A_{13}), U5.28 (A13)
SNES.A_{14}: CN2.39 (A_{14}), U5.29 (A14)
SNES.A_{15}: CN2.40 (A_{15})
SNES.A_{16}: CN2.41 (A_{16}), U5.3 (A15)
SNES.A_{17}: CN2.42 (A_{17}), U5.2 (A16)
SNES.A_{18}: CN2.43 (A_{18}), U5.30 (A17)
SNES.A_{22}: CN2.47 (A_{22})
SNES.D_{0}: CN2.19 (D_{0}), U5.13 (Q0)
SNES.D_{1}: CN2.20 (D_{1}), U5.14 (Q1)
SNES.D_{2}: CN2.21 (D_{2}), U5.15 (Q2)
SNES.D_{3}: CN2.22 (D_{3}), U5.17 (Q3)
SNES.D_{4}: CN2.50 (D_{4}), U5.18 (Q4)
SNES.D_{5}: CN2.51 (D_{5}), U5.19 (Q5)
SNES.D_{6}: CN2.52 (D_{6}), U5.20 (Q6)
SNES.D_{7}: CN2.53 (D_{7}), U5.21 (Q7)
SNES.MCK: CN2.1 (MCK)
SNES.REFRESH: CN2.33 (REFRESH)
SNES.SYSCK: CN2.57 (SYSCK)
SNES.~RD: CN2.23 (~RD), U5.24 (~OE)
SNES.~RESET: CN2.26 (~RESET)
SNES.~ROMSEL: CN2.49 (~ROMSEL), U5.22 (~CE)
SNES.~WR: CN2.54 (~WR)

Notes on the sheet:
SGB mask ROM (SNES program)
Lockout chip (CIC)
