Gekkio/gb-schematics/(commit log)

2020-05-27 Add traced MGB-LCPU-02 SVG
2020-09-18 Minor MGB-xCPU schematics tidying up
    [MGB-xCPU.sch, audio.sch, joypad.sch, lcd.sch, link_port.sch, power.sch]
2020-09-18 Update libraries and regenerate schematics
    [MGB-xCPU.sch, audio.sch, joypad.sch, lcd.sch, link_port.sch, power.sch]
2020-10-07 Squashed 'MGB-xCPU/external/gekkio-kicad-libs/' content from commit 2919aa0
    git-subtree-dir: MGB-xCPU/external/gekkio-kicad-libs
    git-subtree-split: 2919aa0b720b1052a1768f17334fa5c2c270bbf9
    [utils.scad]
2020-10-07 Squashed 'MGB-xCPU/external/kicad-symbols/' content from commit c5e86f1e
    git-subtree-dir: MGB-xCPU/external/kicad-symbols
    git-subtree-split: c5e86f1ea7a8f0ef7a75cacc0d83d27cf8b718e4
2020-10-16 Add initial AGS-CPU-11 schematics
    [AGS-CPU-11.kicad_pcb, AGS-CPU-11.sch, EXT1.sch, EXT2.sch, audio_amp.sch, battery.sch, cartridge.sch, joypad.sch]
2020-10-16 Squashed 'AGS-CPU-11/external/kicad-symbols/' content from commit 4e17d759
    git-subtree-dir: AGS-CPU-11/external/kicad-symbols
    git-subtree-split: 4e17d7595f9691d45d97aea8ad64572652fb5bed
2020-10-16 Squashed 'AGS-CPU-11/external/gekkio-kicad-libs/' content from commit 695d6cdd
    git-subtree-dir: AGS-CPU-11/external/gekkio-kicad-libs
    git-subtree-split: 695d6cddd77142b21f91f1b6a40bb9ecc03f4706
    [utils.scad]
2020-10-16 Add proper release of AGS-CPU-11 schematics
2021-03-02 Fix Q1 pinout mistake
    Now the circuit actually makes sense! It's basically the reference
    circuit from MM1581 datasheet
    [AGS-CPU-11.sch, battery.sch]
2021-03-03 Squashed 'AGS-CPU-11/external/gekkio-kicad-libs/' changes from 695d6cdd..fda14fef
    fda14fef Add AGS transformer
    git-subtree-split: fda14fef528490513b6bd86895768c859f667161
    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
2021-03-03 Use proper symbol for T1
    [power.sch]
2021-03-03 Remove unused footprint lib table entries
2021-03-03 Release: AGS-CPU-11 rev B
    [AGS-CPU-11.sch, EXT1.sch, EXT2.sch, audio_amp.sch, battery.sch, cartridge.sch, joypad.sch, lcd.sch]
2021-07-26 Fix location of pull-up resistor R7
    Fixes #2
    [EXT1.sch]
2021-07-26 Fix C2 value
    [AGS-CPU-11.sch]
2021-07-26 Release: AGS-CPU-11 rev C
    [AGS-CPU-11.sch, EXT1.sch, EXT2.sch, audio_amp.sch, battery.sch, cartridge.sch, joypad.sch, lcd.sch]
2021-08-22 Squashed 'DMG-LCD-06/external/kicad-symbols/' content from commit 4e17d759
    git-subtree-dir: DMG-LCD-06/external/kicad-symbols
    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
2021-08-22 Squashed 'DMG-LCD-06/external/gekkio-kicad-libs/' content from commit 81aabb11
    git-subtree-dir: DMG-LCD-06/external/gekkio-kicad-libs
    git-subtree-split: 81aabb117de587457f609428ad40155c3bb858e0
    [utils.scad]
2021-09-01 Add DMG-LCD-06 schematics
    [DMG-LCD-06.kicad_pcb, DMG-LCD-06.sch]
2022-01-02 Update DMG-LCD-06 files to KiCad 6.0
    [DMG-LCD-06.kicad_pcb, DMG-LCD-06.kicad_sch, DMG-LCD-06.sch]
2022-01-02 Update MGB-xCPU to KiCad 6.0 file formats
    [MGB-xCPU.kicad_sch, MGB-xCPU.sch, audio.kicad_sch, audio.sch, joypad.kicad_sch, joypad.sch, lcd.kicad_sch, lcd.sch]
2022-01-02 Hide test point references
    They're not on the original schematics, so the test point numbering was
    a bit confusing.
    [MGB-xCPU.kicad_sch, audio.kicad_sch, joypad.kicad_sch, lcd.kicad_sch, power.kicad_sch]
2022-01-02 Remove solder jumper references
    [lcd.kicad_sch]
2022-01-02 MGB uses a TN display, not STN
    [lcd.kicad_sch]
2022-01-02 Add electrolytic capacitor ratings
    [audio.kicad_sch, power.kicad_sch]
2022-01-02 Add missing C35 value
    Raw measurements:
    - 0603 imperial
    - 101.4 pF @ 1kHz
    [MGB-xCPU.kicad_sch, power.kicad_sch]
2022-01-02 Release: MGB-xCPU rev C
    [MGB-xCPU.kicad_sch, audio.kicad_sch, joypad.kicad_sch, lcd.kicad_sch, link_port.kicad_sch, power.kicad_sch]
2022-01-02 Update AGS-CPU-11 to KiCad 6.0 file formats
    [AGS-CPU-11.kicad_pcb, AGS-CPU-11.kicad_sch, AGS-CPU-11.sch, EXT1.kicad_sch, EXT1.sch, EXT2.kicad_sch, EXT2.sch, audio_amp.kicad_sch]
2022-01-02 Hide test point references
    [AGS-CPU-11.kicad_sch, EXT2.kicad_sch, audio_amp.kicad_sch, battery.kicad_sch, cartridge.kicad_sch, joypad.kicad_sch, lcd.kicad_sch, leds.kicad_sch]
2022-01-02 Add electrolytic capacitor rating
    [AGS-CPU-11.kicad_sch]
2022-01-02 Add chip label
    [AGS-CPU-11.kicad_sch, power.kicad_sch]
2022-01-02 Release: AGB-CPU-11 rev D
    [AGS-CPU-11.kicad_sch, EXT1.kicad_sch, EXT2.kicad_sch, audio_amp.kicad_sch, battery.kicad_sch, cartridge.kicad_sch, joypad.kicad_sch, lcd.kicad_sch]
2022-01-02 Remove dummy file
    [MGB-xCPU.kicad_pcb]
2022-01-02 Release: DC-CONV-DMG-AB rev A
    [DC-CONV-DMG-AB.kicad_sch]
2022-01-12 Release: DC-CONV-DMG-AB rev B
    [DC-CONV-DMG-AB.kicad_sch]
2022-01-12 Release: DC-CONV-DMG-C rev A
    [DC-CONV-DMG-C.kicad_sch]
2022-01-12 Release: DC-CONV2-DMG-D rev A
    [DC-CONV2-DMG-D.kicad_sch]
2022-01-12 Document known differences of DMG power boards
2022-01-12 Mention other board types
2022-02-20 Release: MGB-xCPU rev D
    [MGB-xCPU.kicad_sch, audio.kicad_sch, joypad.kicad_sch, lcd.kicad_sch, link_port.kicad_sch, power.kicad_sch]
2022-03-19 Release: MGL-CPU-01 rev A
    [MGL-CPU-01.kicad_sch, audio.kicad_sch, joypad.kicad_sch, lcd.kicad_sch, link_port.kicad_sch, power.kicad_sch]
2022-05-30 Release: LSEP01088A1 rev A + MGB-DCDC-B rev A
    [LSEP01088A1.kicad_sch, MGB-DCDC-B.kicad_sch]
2023-07-11 Release: DMG-JACK
    [DMG-JACK.kicad_pcb, DMG-JACK.kicad_sch]
2023-07-11 Release: DMG-CPU-06
    [DMG-CPU-06.kicad_sch, audio.kicad_sch, link_port.kicad_sch, power.kicad_sch]
2023-07-13 Remove pointless layout file
    [DMG-JACK.kicad_pcb]
2023-07-18 Update to latest KiCad
    [AGS-CPU-11.kicad_sch, DC-CONV-DMG-AB.kicad_sch, DC-CONV-DMG-C.kicad_sch, DC-CONV2-DMG-D.kicad_sch, DMG-LCD-06.kicad_sch, EXT1.kicad_sch, EXT2.kicad_sch, LSEP01088A1.kicad_sch]
2023-07-18 Remove Farad/Henry units
    [AGS-CPU-11.kicad_sch, DC-CONV-DMG-AB.kicad_sch, DC-CONV-DMG-C.kicad_sch, DC-CONV2-DMG-D.kicad_sch, DMG-LCD-06.kicad_sch, EXT1.kicad_sch, LSEP01088A1.kicad_sch, MGB-DCDC-B.kicad_sch]
2023-07-18 Add some power-related information
    [joypad.kicad_sch, link_port.kicad_sch, power.kicad_sch]
2023-07-18 Tidy up switch symbols
    [AGS-CPU-11.kicad_sch, DMG-CPU-06.kicad_sch, cartridge.kicad_sch, joypad.kicad_sch, link_port.kicad_sch, power.kicad_sch]
2023-07-18 Tidy up potentiometer symbols, add contrast pot symbols
    [DMG-CPU-06.kicad_sch, DMG-LCD-06.kicad_sch, audio.kicad_sch, joypad.kicad_sch, lcd.kicad_sch, link_port.kicad_sch]
2023-07-18 Release: AGS-CPU-11 rev E
    [AGS-CPU-11.kicad_sch, EXT1.kicad_sch, EXT2.kicad_sch, audio_amp.kicad_sch, battery.kicad_sch, cartridge.kicad_sch, joypad.kicad_sch, lcd.kicad_sch]
2023-07-18 Release: DC-CONV2-DMG-D rev B
    [DC-CONV2-DMG-D.kicad_sch]
2023-07-18 Release: DC-CONV-DMG-AB rev C
    [DC-CONV-DMG-AB.kicad_sch]
2023-07-18 Release: DC-CONV-DMG-C rev B
    [DC-CONV-DMG-C.kicad_sch]
2023-07-18 Release: DMG-CPU-06 rev B
    [DMG-CPU-06.kicad_sch, audio.kicad_sch, link_port.kicad_sch, power.kicad_sch]
2023-07-18 Release: DMG-LCD-06 rev C
    [DMG-LCD-06.kicad_sch]
2023-07-18 Release: LSEP01088A1 rev B
    [LSEP01088A1.kicad_sch]
2023-07-18 Release: MGB-DCDC-B rev B
    [MGB-DCDC-B.kicad_sch]
2023-07-18 Release: MGB-xCPU rev E
    [MGB-xCPU.kicad_sch, audio.kicad_sch, joypad.kicad_sch, lcd.kicad_sch, link_port.kicad_sch, power.kicad_sch]
2023-07-18 Release: MGL-CPU-01 rev B
    [MGL-CPU-01.kicad_sch, audio.kicad_sch, joypad.kicad_sch, lcd.kicad_sch, link_port.kicad_sch, power.kicad_sch]
2023-08-22 Clarify MGL DP3T doesn't break connection
    Connection is maintained between the two possible pin 2-3 connection states.
    [joypad.kicad_sch, link_port.kicad_sch, power.kicad_sch]
2023-08-22 Release: MGL-CPU-01 rev C
    [MGL-CPU-01.kicad_sch, audio.kicad_sch, joypad.kicad_sch, lcd.kicad_sch, link_port.kicad_sch, power.kicad_sch]
2023-11-20 Release: SGB-R-xx_SGB-N-xx rev A
    [SGB-R-xx_SGB-N-xx.kicad_pcb, SGB-R-xx_SGB-N-xx.kicad_sch, gb_domain.kicad_sch, snes_domain.kicad_sch]
2024-05-18 Release: LSEP01120A1 rev A
    [LSEP01120A1.kicad_sch]
2024-05-18 Release: DMG-QLA-01 rev A
    [DMG-QLA-01.kicad_sch]
